itstajiri/main/README.md

# main
any stuff mostly from university

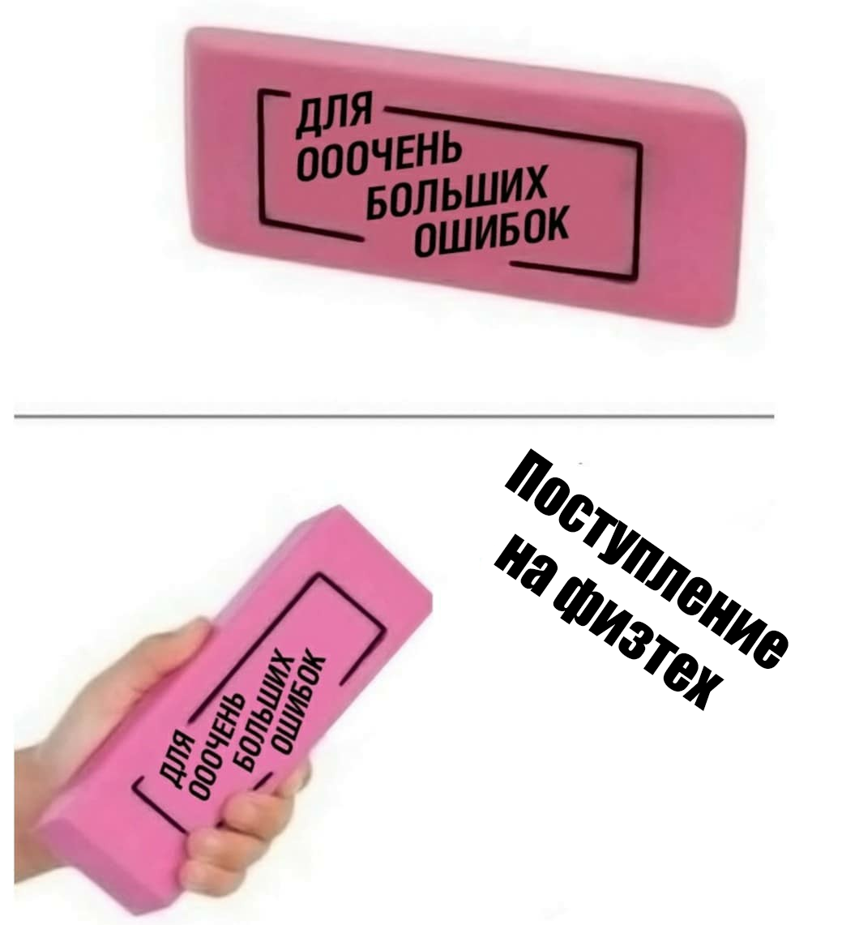
[picture p1: main.png]
