itstajiri/main/3kurs/Nasosi/Задание 3. Рязанов А.В. С17-АЭ. ЦНН-1. Расчет направляющего аппарата — исправление 4.docx

Рязанов Алексей, С17-АЭ


Средняя скорость в горловом сечении:

C_3 =K_3 ∙√(2g∙H)=0,38∙√(2∙9,81∙92)=16,145м/с

где К3 – опытный коэффициент, изменяющийся в зависимости от nS (согласно рис. 5.3 методички).

Из графика К3 = 0,38.

Диаметр начальной окружности:

D3=(1,03…1,05)∙D2=1,038∙289≈300 мм

Принимаем ширину аппарата:

b_3 =1,1∙2∙(20,1+2∙5)=66,2 мм

Площадь горлового сечения на входе определяется следующим образом:

Согласно рекомендациям по соотношению числа лопастей рабочего колеса и НА принимаем Zна = 12.

F_г =Q/(C_3 ∙Z_(на))=(650/3600)/(16,145∙12)=0,000932 м^2

Где: Z_(на) – число лопаток НА.

Ширина горлового сечения составит:

a_г =(F_Г)/(b_3)=(0,000932∙10^6)/(66,2)≈14 мм

Меридианная скорость потока на входе в НА без учета cтеснения:

C_(m_3) =Q/(π∙D_3 ∙b_3)=2,9 м/с

Окружная скорость потока на входе в направляющий аппарат:

C_(u_3) =C_(u_2) ∙((D_2)/(D_3))=23,1∙(289/300)=22,253

Угол потока на входе в направляющий аппарат без учета стеснения

α_3 =180/π∙atan((C_(m_3))/(C_(u_3)))=180/(3,14)∙atan((1,45)/(22,253))=7,4°

Для диффузора с прямоугольным горловым сечением и двумя параллельными боковыми стенками около 10⁰ – 12⁰, принимаем 11⁰.

Длину диффузора между лопатками следует принимать

L = 4 ∙ a_г = 14 ∙ 4 = 28 мм

Рациональное увеличение проходного сечения в канале диффузора 1,6 – 2.

Принимаем a_в =(1,6-2)∙a_г =1,785∙14=25 мм


Рис 1. Эскиз направляющего аппарата

Диаметр наружной окружности НА принимаем D4 = 386 мм.

(D_4)/(D_2)=386/289=1,34

Площадь меридианного сечения кольцевого коллектора должна быть больше площади входа в каналы направляющего аппарата не менее чем в 1,7 раза.

Fколлект = 12 ∙ 2 ∙ F_г = 12 ∙ 2∙0,000932 = 0,022368 м²

Радиус меридионального сечения кольцевого коллектора:

R_(коллект) =√((F_(коллект))/π)=√((0,022368)/π)=0,085 м

За образец напорного коллектора взял как у насоса прототипа.

Наибольший диаметр кольцевого коллектора:

D_(наиб) =D_4 +2⋅R_(коллект) =386+2⋅85=556 мм

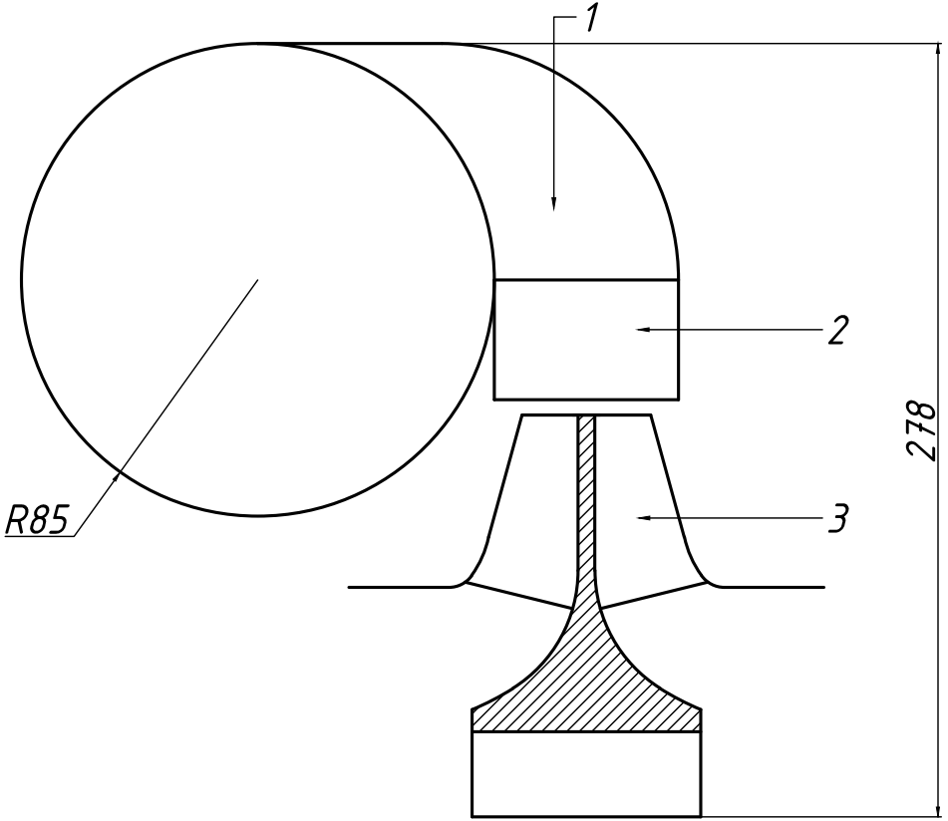
[picture p6: figure]

Рис. 2 Окончательный эскиз меридианного сечения проточной части насоса

1 – напорный коллектор, 2 – НА, 3 – РК
