itstajiri/main/3kurs/Nasosi/Параметр.docx

Наименование | Значение
Подача, м³/ч | Q=650
Напор, м | H=92
Манометрическое давление на всасе, Па | P=0,03∙10^6
Атмосферное давление, Па | P_(атм) =10^5
Давление насыщенных паров натрия, Па | P_(нп) =164,4
Температура натрия на всасе, ⁰С | T=450
Плотность натрия при данной температуре, кг/м³ | ρ=844
Ускорение свободного падения, м/с² | g=9,81

Из исходных данных, а именно – избыточное давление на всасе насоса – Р = 0,03 МПа, следовательно абсолютное давление составляет:

Pабс=P+Pатм=0,03+0,1=0,13 Мпа ,

определим располагаемый кавитационный запас системы:

∆hрас=(Pабс-Pнп)/(ρ*g)+(v^2)/(2*g) , где

Pабс – абсолютное статическое давление системы, Па

Pнп – давление насыщенных паров, Па

v – скорость среды на входе в насос, м/с

Т.к. на начальном этапе значение скоростей неизвестно, то опустим это слагаемое, в конечном итоге это допущение только лишь увеличит располагаемый кавитационный запас. Таким образом:

∆hрас=(0,13*10^6 -Pнп)/(844*9,81)=15,681 м .

Основные параметры, на которые будем смотреть при выборе схемы:

- n_s – коэффициент быстроходности

n_s =(3,65*n*√Q)/(H^0.75)

- Отношение величин (∆hрас)/(hкр)

hкр=10*((n*√Q)/(Скр))^(4/3)

- w_(10D1) - величина скорости на входе в рабочее колесо, м/с

- С_(кр) – кавитационный коэффициент быстроходности

С_(кр) =(5,62∙n∙√Q)/(((∆h_(рас))/(1,2))^(0,75))

- D_2 – диаметр рабочего колеса на выходе, м

Параметр | (n=3000 об)/(мин) | (n=1500 об)/(мин) | (n=1000 об)/(мин)
n_s | 107 | 54 | 36
(∆hрас)/(hкр) | 1,3 | 2,9 | 4,6
w_(10D1) , м/с | 23,29 | 14,7 | 11,25
С_(кр) | 772 | 686 | 657
D_2 , м | 0,270 | 0,502 | 0,732

n_s =(3,65*n*√Q)/(H^0.75)

n_s =(3,65*1500*√(0.181/2))/(92^0.75)=54 - рабочее колесо центробежное тихоходное.

Кавитационный коэффициент для проходного вала

С_(кр) =1,6*n_s +600=686

Давление рабочее на входе - Р = 0,03 МПа

hкр=10*((n*√Q)/(Скр))^(4/3)

hкр=10*((n*√Q)/(Скр))^(4/3) =5,48 м

hдоп=1,2*hкр=6,6

∆hрас=(Pабс-Pнп)/(ρ*g)=15,681 м

Кавитация отсутствует при условии Δhрас > Δhдоп. Это условие выполняется ( 15,681>6,6)

Приведённый диаметр

D_(1пр) =4.25*1000*(Q/n)^(1/3) =168.253

Объемный КПД насоса

η_(об) =1/(1+0,68*n_s^(-0.66))=0.954

Гидравлический КПД насоса

η_г =(0,42)/((1/(ln(10))*ln(D_(1пр) )-0,173)^2)=0,9

КПД дискового трения

η_(дт) =1/(1+820/(n_s ^2))=0,779

Расход через колесо насоса с учетом объемного КПД насоса

Q_т =Q/(η_(об))=(0,181/2)/(0,954)=0.095(м^3)/с

КПД проточной части

η=η_(об) *η_г *η_(дт) =0,669

Мощность насоса

N=(ρ*Q*H)/(102*η)=205.5 кВт

Мощность с учётом перегрузки

N_(max) =1.2*N=246.6 кВт

Момент на валу насоса

M=97500*(N_(max))/n=1.65*10^4 Н∙см

Диаметр вала

D_в =10*(М/(0,2*150))^(1/3) =82 мм

Диаметр втулки под рабочим колесом

D_(вт) =1,25*D_в =102.5 мм

Принимаем Kv_0 =0,06 – коэффициент входной скорости

Скорость на входе

v_0 =Kv_0 *(Q_т *n^2 )^(1/3) =3.51 м/с

Диаметр входа в рабочее колесо

D_0 =1000*√((4*(Q_т)/(π*v_0))+((D_(вт))/1000)^2)=211.7

Принимаем D_100 =0,95

Диаметр расположения входных кромок лопаток

D_1 =D_100 *D_0 =201,1 мм

Принимаем Kvm1=0,85

Меридианная скорость на входе

Vm1p=Kvm1∙v_0 =0,85∙4,7=2,98 м/с

Ширина лопасти на входе

b1=(1000*Q_т)/(πD1Vm1p*0.001)=50.2 мм

Принимаем β1=21º Z=7

S=((1.25-1)/1.25)*π*D_1 *(sin(π*(β1)/180))/Z=6.471 мм

Окружная скорость лопасти на входе

u1=0.001D1πn/60=0.001∙201.1∙3.141455/60=15.32(м/с)

Коэффициент затеснения

K1=1/(1-(Z∙S)/(πD1sin(πβ1)/180))=1/(1-(8∙7.9)/(3.14∙201.1sin(3.14∙21)/180))=1.25

Угол потока на входе

β10=180/πarctg(Vm1p∙K1)/(u1)= 180/3.14arctg(2.98∙1.25)/15.32=13.7°

Угол атаки

δ1=β1-180/πarctg(Vm1p∙K1)/(u1)=21-180/3.14arctg(2.98∙1.25)/15.32=7.32°

Меридианная скорость на входе с учетом затеснения

Vm1=K1∙Vm1p=1.25∙2.98=3.73 м/с

Относительная скорость на входе

W1=(Vm1)/(sin(πβ1)/180)=3.73/(sin(3.14∙21)/180)=10,41 м/с

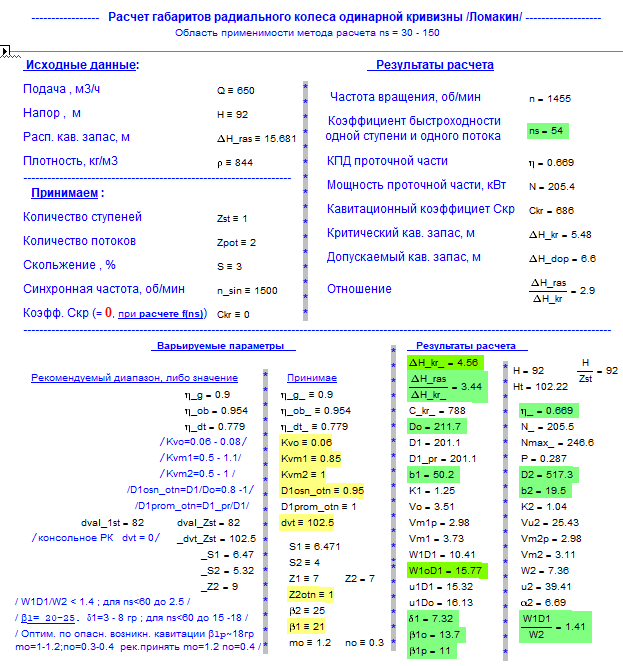
[picture p7: figure]
