itstajiri/main/3kurs/Nasosi/Помойка/Задание 1 + продолжение. Рязанов А.В. С17-АЭ. ЦНН-1. Расчет по курсовому проекту.docx

Рязанов Алексей, С17-АЭ

1. Исходные данные

Исходные данные приведены в таблице 1.

Таблица 1 - Исходные данные

Наименование параметра | Значение
Подача Q, м³/ч | 650
Напор H, м | 92
Давление на входе в насос P , МПа | 0,03
Температура натрия на входе в насос T , ⁰С | 450
Плотность натрия при данной температуре 450 оС ρ , кг/м³ | 844
Давление насыщенных паров натрия P_(нп) , Па | 164,4

2. Определим располагаемый кавитационный запас:

Располагаемый кавитационный запас определяется по формуле

∆hрас=(P_с)/(ρ∙g)+(v^2)/(2∙g)-(P_(нп))/(ρ∙g)

где: Рс = P + Ра – абсолютное статическое давление на входе в насос, Па

Pнп – давление насыщенных паров, Па

v – скорость среды на входе в насос, м/с

(P_с)/(ρ∙g)+(v^2)/(2∙g) - полная удельная энергия потока (Eвх) на входе в насос.

Т.к. на начальном этапе значение скоростей неизвестно, то опустим это слагаемое, в конечном итоге это допущение только лишь увеличит располагаемый кавитационный запас. Таким образом:

∆h_(рас) =(P_с -Pнп)/(ρ∙g)=(0,13∙10^6 -164,4)/(844∙9,81)=15,681 м

Тогда ∆h_(рас) =15,7 м. Расчет уточненного значения располагаемого кавитационного запаса будет проведен после расчета геометрии рабочего колеса насоса.

3. Выбор частоты вращения ротора

Расчет выполняется следующим образом.

3.1 Задаемся частотой вращения ротора.

n=n_(sin) ∙(1-3/100)=3000∙(1-3/100)=2910(об)/(мин), где s=3%-скольжение.

3.2 Определяем коэффициент быстроходности.

n_s =(3,65∙n∙√Q)/(H^(0,75))=(3,65∙2910∙√(0,181/2))/(92^(0,75))=107

Тип рабочего колеса - центробежное тихоходное.

3.3 Определяем кавитационный коэффициент быстроходности.

Кавитационный коэффициент быстроходности определяем по рис. 3.1 [1, стр.35].

С_(кр) =772

  3.4 Определяем критический кавитационный запас.

∆h_(кр) =10∙[(n∙√Q)/(Скр)]^(4/3) =10∙[(3000∙√(0,181/2))/772]^(4/3) =11,8 м

3.5 Определяем критический кавитационный запас.

∆h_(доп) =1,2∙hкр=14,2 м

Результаты расчетов приведены в таблице 2.

Таблица 2 - Результаты расчетов

Наименование параметра | Значение
Частота вращения ротора синхронная n_(sin) , об/мин | 3000 | 1500 | 1000
Частота вращения ротора n, об/мин | 2910 | 1455 | 970
Коэффициент быстроходности n_s | 107 | 54 | 36
Кавитационный коэффициент быстроходности Скр | 772 | 686 | 657
Располагаемый кавитационный запас ∆hрас , м | 15,7 | 15,7 | 15,7
Критический кавитационный запас ∆hкр , м | 11,8 | 5,5 | 3,4
Допускаемый кавитационный запас ∆hдоп =1,2 Δhкр, м | 14,2 | 6,6 | 4,1

Кавитация отсутствует при условии Δhрас > Δhдоп. Это условие выполняется при частоте вращения ротора 3000, 1500, 1000 об/мин. Для дальнейших расчетов принимаем частоту вращения n_(sin) =1500 об/мин.

4. Определение размеров рабочего колеса с помощью диаграмм

Для выбранного варианта определяются размеры рабочего колеса насоса с помощью диаграмм на рис. 3.3 [1, стр.37]. По диаграмме выбираем коэффициенты в зависимости от коэффициента быстроходности. Согласно данным диаграммы все определяемые параметры являются функцией быстроходности насоса и могут быть рассчитаны по формуле:

X=K_X ∙(√H)/n

где: Х – определяемый параметр;

K_X – соответствующий параметру коэффициент на диаграмме;

Н – напор насоса;

n – частота вращения ротора насоса.

Тогда

D_0 =K_(D_0) ∙(√H)/n=28∙(√92)/1500=184,6 мм;

D_1 =K_(D_1) ∙(√H)/n=26,3∙(√92)/1455=173,2 мм;

b_1 =K_(b_1) ∙(√H)/n=6,1∙(√92)/1455=40,2 мм;

D_2 =K_(D_2) ∙(√H)/n=84,7∙(√92)/1455=558,1 мм;

b_2 =K_(b_1) ∙(√H)/n=2,4∙(√92)/1455=15,8 мм;

Полученные результаты приведены в таблице 3

Таблица 3 - Результаты расчетов по диаграммам

Значение коэффициента | KD0 = 28 | KD1 = 26,3 | Kb1 = 6,1 | KD2 = 84,7 | Kb2 = 2,4
Размер колеса, мм | D0 = 184,6 | D1 = 173,2 | b1 = 40,2 | D2 = 558,1 | b2 = 15,8

5. Расчет мощности приточной части насоса

Мощность проточной части насоса определяется по формуле:

N=(ρ∙Q∙H)/(102∙η)=(844∙0,181/2∙92)/(102∙0,669)=205,5 кВт

где η ≈ 0,669 – КПД одноступенчатого насоса при n_s =54 и подаче Q = 181 л/с, значение определено по графику на рис. 3.2 [1, стр.36].

Снимок экрана из программы Mathcad – расчет габаритов колеса

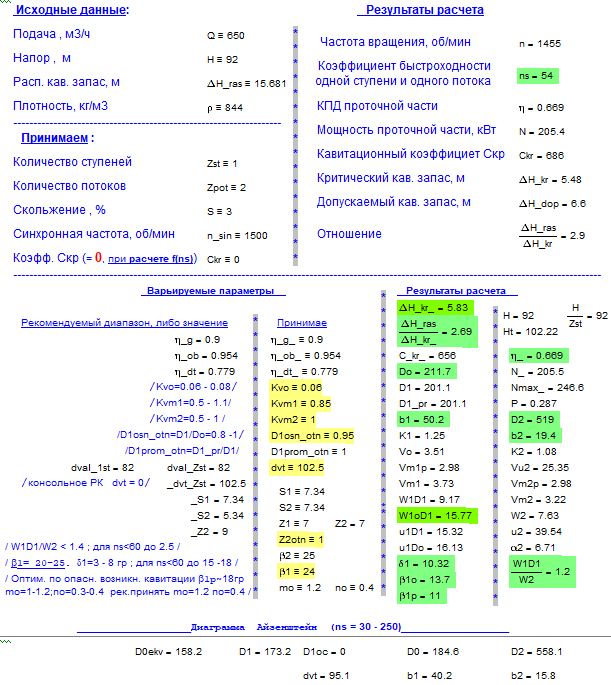
[picture p8: figure]

6. Расчет размеров рабочего колеса на входе

Приведённый диаметр

D_(1пр) =4,25∙1000∙(Q/n)^(1/3) =4,25∙1000∙((0,181/2)/1445)^(1/3) =168,253 мм

Диаметр вала

D_в =10∙(М/(0,2∙150))^(1/3) =10∙((1,65∙10^4)/(0,2∙150))^(1/3) =82 мм

Диаметр втулки под рабочим колесом

D_(вт) =1,25∙D_в =1,25∙82=102,5 мм

Критический кавитационный запас

hкр=10∙((n∙√Q)/(Скр))^(4/3) =10∙((1445∙√(0,181/2))/686)^(4/3) =5,48 м

Допускаемый кавитационный запас

hдоп=1,2∙hкр=1,2∙5,48=6,6 м

Принимаем Kv_0 =0,06 – коэффициент входной скорости

Скорость на входе

v_0 =Kv_0 ∙(Q_т ∙n^2 )^(1/3) =0,06∙(0,095∙1445^2 )^(1/3) =3,51 м/с

Диаметр входа в рабочее колесо

D_0 =1000∙√((4∙(Q_т)/(π∙v_0))+((D_(вт))/1000)^2)=1000∙√((4∙(0,095)/(3,14∙3,51))+((102,5)/1000)^2)=211,7 м

Принимаем D_(1осн) =0,95

Диаметр расположения входных кромок лопаток

D_1 =D_(1осн) ∙D_0 =0,95∙211,7=201,1 мм

Принимаем Kvm1=0,85

Меридианная скорость на входе

Vm1p=Kvm1∙v_0 =0,85∙4,7=2,98 м/с

Ширина лопасти на входе

b1=(1000∙Q_т)/(πD1Vm1p∙0.001)=(1000∙0,095)/(3,14∙201,7∙2,98∙0.001)=50,2 мм

Окружная скорость лопасти на входе

u1=0,001D1πn/60=0,001∙201,1∙3,141455/60=15,32(м/с)

Принимаем β1=24º Z=7

S=((1,25-1)/(1,25))∙π∙D_1 ∙(sin(π∙(β1)/180))/Z=((1,25-1)/(1,25))∙3,14∙201,09∙(sin(π∙24/180))/7=7,34 мм

Коэффициент затеснения

K1=1/(1-(Z∙S)/(πD1sin(πβ1)/180))=1/(1-(7∙7,34)/(3,14∙201,1sin(3,14∙24)/180))=1,25

Угол потока на входе

β10=180/πarctg(Vm1p∙K1)/(u1)= 180/3.14arctg(2,98∙1,25)/(15,32)=13,7°

Угол атаки

δ1=β1-180/πarctg(Vm1p∙K1)/(u1)=24-180/(3,14)arctg(2,98∙1,25)/(15,32)=10,32°

Меридианная скорость на входе с учетом затеснения

Vm1=K1∙Vm1p=1,25∙2,98=3,73 м/с

Подача на ступень с учетом объемных протечек

Q1=(Q_pot)/(n_ob_)=(0,181/2)/(0,954)=0,095 (м^3)/с

Относительная скорость на входе

W1=(Vm1)/(sin(πβ1)/180)=(3,73)/(sin(3,14∙24)/180)=9,17 м/с

∆H_(kr) =mo(v0^2)/(2g)+no(W1^2)/(2g)=5,83 м

C_(kr) =(n√(Q_pot))/((0,1∙∆H_(kr) )^(0,75))=(1445∙√(0,181/2))/((0,1∙5,83)^(0,75))=656

Принимаем Kvm2=1

Меридианная скорость на выходе

Vm2p=Kvm2∙Vm1p=1∙2,98=2,98 м/с

Теоретический напор

Hт=H/(η_г)=92/(0,9)=102,22 м

7. Расчет размеров рабочего колеса на выходе

Окружая скорость на выходном диаметре (начальное приближение)

u2=√(2∙g∙Hт)=√(2∙9,81∙102,22)=44,8 м/с

Диаметр рабочего колеса на выходе (начальное приближение)

D2=(1000∙2∙u2)/((πn)/30)=(1000∙2∙44,8)/((3,14∙1455)/30)=587,728 мм

Принимаем β2=25º

{P1=2/(Z1∙Z2otn)∙(0,6+0,6∙sin(πβ2)/180)/(1-((D1pr)/(D2))^2)K2=1/(1-(Z∙S)/(πD2sin(πβ2)/180))u2=(K2∙Vm2p)/(2tg(πβ2)/180)+√(((K2∙Vm2p)/(2tg(πβ2)/180))^2 +g(1+P1)Hт)D2=1000∙(60u2)/(πn)

Диаметр рабочего колеса на выходе

D2=519 мм

Окружная скорость на наружном диаметре

u2=39,41 м/с

Коэффициент затеснения

K2=1,04

Поправка на конечное число лопастей

P1=0,3

Окружная составляющая абсолютной скорости на выходе

Vu2=g∙(Hт)/(u2)=9,81∙(102,22)/(39,4)=25,43 м/с

Меридианная скорость на выходе с учетом затеснения

Vm2=K2∙Vm2p=1∙2,98=3,11 м/с

Относительная скорость на выходе

W2=(Vm2p)/(sin(πβ2)/180)=(3,11)/(sin(3,14∙25)/180)=7,36 м/с

Коэффициент торможения относительной скорости в колесе

Kw=(W1)/(W2)=(10,41)/(7,36)=1,41

Ширина колеса на выходе

b2=(Qт)/(π∙D2∙Vm2p)=(0,095)/(3,14∙517,3∙2,98)=19,5 мм.

Угол абсолютной скорости на выходе

α2=180/π∙arctg(Vm2p)/(Vu2)=6,7°

Абсолютная скорость на выходе из колеса

V2p=√(Vu2^2 +Vm2p^2)=√(25,4^2 +2,98^2)=25,4 м/с

8. Профилирование лопасти рабочего колеса

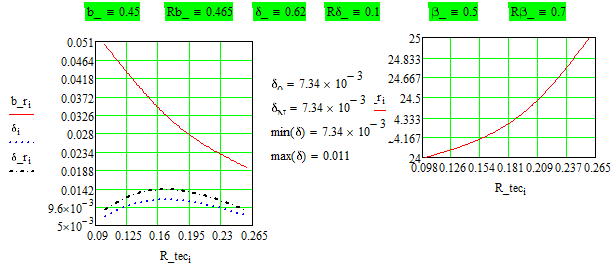
[picture p9: figure]
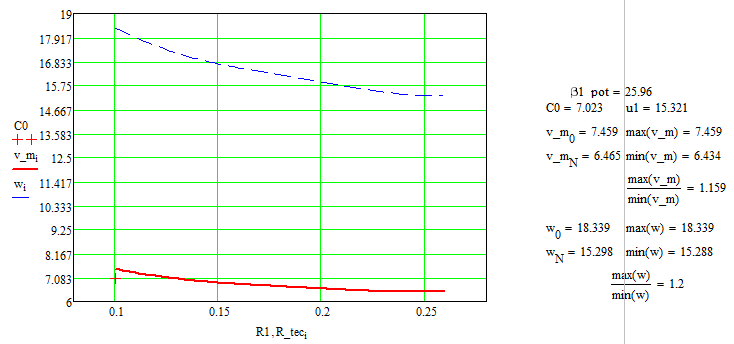
[picture p10: figure]
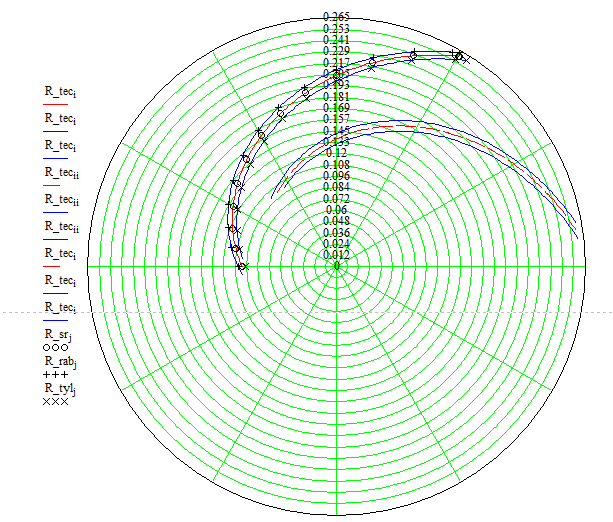
[picture p11: figure]
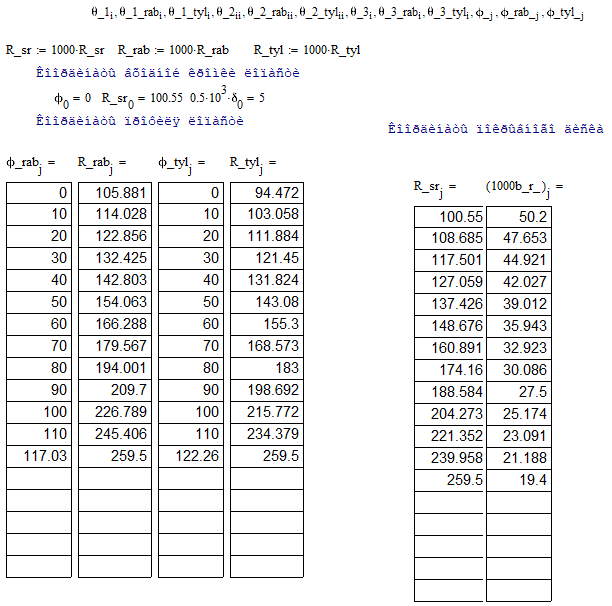
[picture p12: figure]
