itstajiri/main/3kurs/Nasosi/Помойка/Задание 3. Рязанов А.В. С17-АЭ. ЦНН-1. Расчет направляющего аппарата.docx

Рязанов Алексей, С17-АЭ


Средняя скорость в горловом сечении:

C_3 =K_3 ∙√(2g∙H)=0,38∙√(2∙9,81∙92)=16,145м/с

где К3 – опытный коэффициент, изменяющийся в зависимости от nS (согласно рис. 5.3 методички).

Из графика К3 = 0,38.

Диаметр начальной окружности:

D3=(1,03…1,05)∙D2=1,038∙289≈300 мм

Принимаем ширину аппарата:

b_3 =1,1∙(20,1+2∙5)=33 мм

Площадь горлового сечения на входе определяется следующим образом:

Согласно рекомендациям по соотношению числа лопастей рабочего колеса и НА принимаем Zна = 12.

F_г =Q/(C_3 ∙Z_(на))=(0,181)/(16,145∙12)=0,0009343 м^2

Где: Z_(на) – число лопаток НА.

Ширина горлового сечения составит:

a_г =(F_Г)/(b_3)=(0,0009343∙10^6)/33≈28 мм

Меридианная скорость потока на входе в НА без учета cтеснения:

C_(m_3) =Q/(π∙D_3 ∙b_3)=5,8 м/с

Окружная скорость потока на входе в направляющий аппарат:

C_(u_3) =C_(u_2) ∙((D_2)/(D_3))=23,1∙(289/300)=22,253

Угол потока на входе в направляющий аппарат без учета стеснения

α_3 =180/π∙atan((C_(m_3))/(C_(u_3)))=180/(3,14)∙atan((5,8)/(22,253))=14,609≈15°

Для диффузора с прямоугольным горловым сечением и двумя параллельными боковыми стенками около 10⁰ – 12⁰, принимаем 11⁰.

Длину диффузора между лопатками следует принимать

L = 4 ∙ a_г = 54 ∙ 4 = 112 мм

Рациональное увеличение проходного сечения в канале диффузора 1,6 – 2.

Принимаем a_в =(1,6-2)∙a_г =1,65∙28=46,2 мм

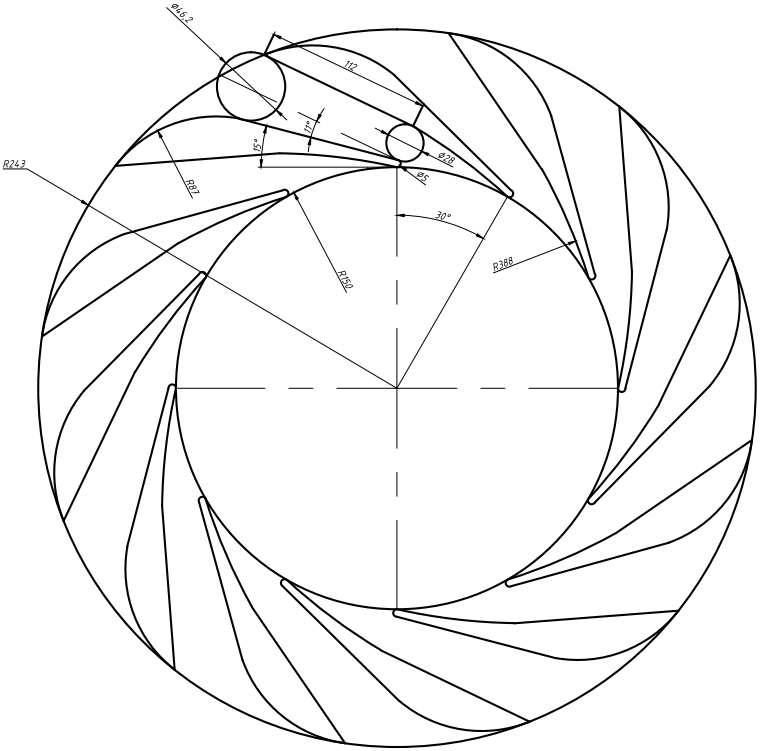
[picture p13: figure]

Диаметр наружной окружности НА принимаем D4 = 486 мм.

(D_4)/(D_2)=486/289=1,68

Площадь меридионального сечения кольцевого коллектора должна быть больше площади входа в каналы направляющего аппарата не менее чем в 1,7 раза:

Fколлект = 4 ∙ F_г = 4 ∙ 0,0009343 = 0,0037372 м²

Радиус меридионального сечения кольцевого коллектора:

R_(коллект) =√((F_(коллект))/π)=√((0,0037372)/π)=0,0345 м

Наибольший диаметр кольцевого коллектора:

D_(наиб) =D_4 +2⋅R_(коллект) =486+2⋅34,5=555 мм
