itstajiri/main/3kurs/Nasosi/Одобрено/Задание 1. Рязанов А.В. С17-АЭ. ЦНН-1. Расчет по курсовому проекту.docx

Рязанов Алексей, С17-АЭ

1. Исходные данные

Исходные данные приведены в таблице 1.

Таблица 1 - Исходные данные

Наименование параметра | Значение
Подача Q, | 650
Напор H, м | 92
Давление на входе в насос P , МПа | 0,03
Температура натрия на входе в насос T , ⁰С | 450
Плотность натрия при данной температуре 450 оС ρ , кг/м³ | 844
Давление насыщенных паров натрия P_(нп) , Па | 164,4

2. Определим располагаемый кавитационный запас:

Располагаемый кавитационный запас определяется по формуле

∆hрас=(P_с)/(ρ∙g)+(v^2)/(2∙g)-(P_(нп))/(ρ∙g)

где: Рс = P + Ра – абсолютное статическое давление на входе в насос, Па

Pнп – давление насыщенных паров, Па

v – скорость среды на входе в насос, м/с

(P_с)/(ρ∙g)+(v^2)/(2∙g) - полная удельная энергия потока (Eвх) на входе в насос.

Т.к. на начальном этапе значение скоростей неизвестно, то опустим это слагаемое, в конечном итоге это допущение только лишь увеличит располагаемый кавитационный запас. Таким образом:

∆h_(рас) =(P_с -Pнп)/(ρ∙g)=(0,13∙10^6 -164,4)/(844∙9,81)=15,7 м

Тогда ∆h_(рас) =15,7 м. Расчет уточненного значения располагаемого кавитационного запаса будет проведен после расчета геометрии рабочего колеса насоса.

3. Выбор частоты вращения ротора

Расчет выполняется следующим образом.

3.1 Задаемся частотой вращения ротора.

n=n_(sin) ∙(1-S/100)=3000∙(1-(3,33)/100)=2900(об)/(мин), где s=3,33%-скольжение.

3.2 Определяем коэффициент быстроходности.

Рассматриваем вариант двухпоточного рабочего колеса.

n_s =(3,65∙n∙√Q)/(H^(0,75))=(3,65∙2900∙√(650/(3600∙2)))/(92^(0,75))=107

Тип рабочего колеса - центробежное нормальное.

3.3 Определяем кавитационный коэффициент быстроходности.

Кавитационный коэффициент быстроходности определяем по рис. 3.1 [1, стр.35].

С_(кр) =771

  3.4 Определяем критический кавитационный запас.

∆h_(кр) =10∙[(n∙√Q)/(Скр)]^(4/3) =10∙[(3000∙√(650/(3600∙2)))/772]^(4/3) =11,77 м

3.5 Определяем критический кавитационный запас.

∆h_(доп) =1,2∙hкр=14,1 м

Результаты расчетов приведены в таблице 2.

Таблица 2 - Результаты расчетов

Наименование параметра | Значение
Частота вращения ротора синхронная n_(sin) , об/мин | 3000 | 1500 | 1000
Частота вращения ротора n, об/мин | 2900 | 1450 | 970
Коэффициент быстроходности n_s | 107 | 54 | 36
Кавитационный коэффициент быстроходности Скр | 772 | 686 | 657
Располагаемый кавитационный запас ∆hрас , м | 15,7 | 15,7 | 15,7
Критический кавитационный запас ∆hкр , м | 11,8 | 5,5 | 3,4
Допускаемый кавитационный запас ∆hдоп =1,2 Δhкр, м | 14,2 | 6,6 | 4,0

Кавитация отсутствует при условии Δhрас > Δhдоп. Для изготовления рабочего колеса с лопастями одинарной кривизны коэффициент быстроходности должен быть < 130. Это условие выполняется при частоте вращения ротора 3000, 1500, 1000 об/мин. Для дальнейшего проектирования принимаем вариант с наибольшей частотой вращения ротора. Этот вариант будет иметь наименьшие габариты.

4. Определение размеров рабочего колеса с помощью диаграмм

Для выбранного варианта определяются размеры рабочего колеса насоса с помощью диаграмм на рис. 3.3 [1, стр.37]. По диаграмме выбираем коэффициенты в зависимости от коэффициента быстроходности. Согласно данным диаграммы все определяемые параметры являются функцией быстроходности насоса и могут быть рассчитаны по формуле:

X=K_X ∙(√H)/n

где: Х – определяемый параметр;

K_X – соответствующий параметру коэффициент на диаграмме;

Н – напор насоса;

n – частота вращения ротора насоса.

Тогда

D_0 =K_(D_0) ∙(√H)/n=44,6∙(√92)/3000=147,7 мм;

b_1 =K_(b_1) ∙(√H)/n=13,8∙(√92)/3000=45,5 мм;

D_2 =K_(D_2) ∙(√H)/n=87,6∙(√92)/3000=289,7 мм;

b_2 =K_(b_1) ∙(√H)/n=6,1∙(√92)/3000=20,1 мм;

Полученные результаты приведены в таблице 3

Таблица 3 - Результаты расчетов по диаграммам

Значение коэффициента | KD0 = 44,6 | Kb1 = 13,8 | KD2 = 87,6 | Kb2 = 6,1
Размер колеса, мм | D0 = 147,7 | b1 = 45,5 | D2 = 289,7 | b2 = 20,1

5. Расчет мощности приточной части насоса

Мощность проточной части насоса определяется по формуле:

N=(ρ∙Q∙H)/(102∙η)=(844∙(650∙1000)/3600∙92)/(102∙0,805)=170,5 кВт

где η ≈ 0,85 – КПД одноступенчатого насоса при n_s =107 и подаче Q = 181 л/с, значение определено по графику на рис. 3.2 [1, стр.36].

Снимок экрана из программы Mathcad – расчет габаритов колеса

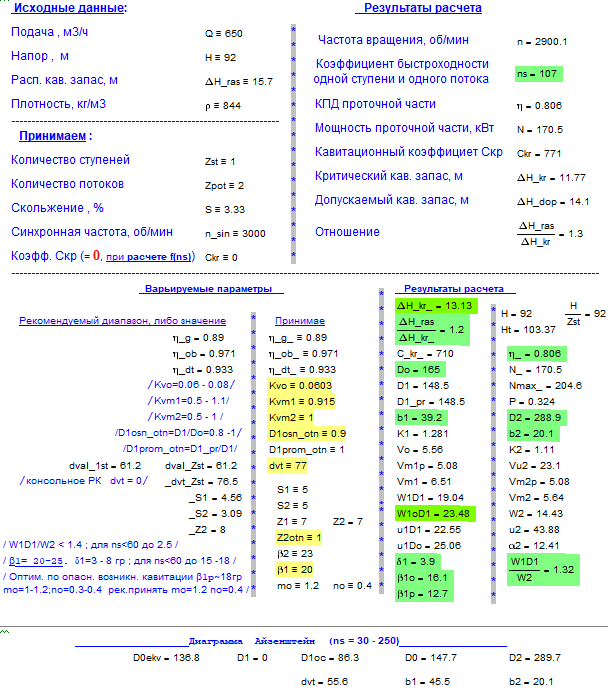
[picture p18: figure]
