itstajiri/main/3kurs/Nasosi/Доки/Основная часть — копия — копия — копия — копия — копия — копия — копия — копия.docx

1. Введение

Быстрый опытный реактор БОР-60 является уникальной многоцелевой установкой, на которой проводятся испытания конструкционных, топливных и поглощающих материалов, используемых и предполагаемых к использованию в различных типах ядерных реакторов, в том числе термоядерных реакторов. Для быстрых реакторов дополнительно проводятся испытания отдельных узлов оборудования первого и второго контуров.

Проводимые испытания реакторных материалов охватывают практически весь спектр существующих и разрабатываемых типов реакторов от быстрых (БН-800, БН-1800, «БРЕСТ», СВБР) и тепловых (АЭС-2006, ВВЭР-1500, ГТ-МГР, ВТГР) до термоядерных (ИТЭР) и реакторов специального назначения.

Основные технические характеристики реактора БОР-60 [14]:

Физические характеристики
Максимальная тепловая мощность | | 60 МВт
Электрическая мощность | | 12 МВт
Топливо: | | UO2 - PuO2
обогащение по 235U | | 45 ÷ 90 %
Теплоноситель: | | натрий
расход через реактор | | 1100 м3/час
давление | | 5,5 МПа
температура на входе в реактор | | до 330 °С
температура на выходе из реактора | | до 530 °С

На рисунке 1.1 представлена схема реакторной установки БОР-60.

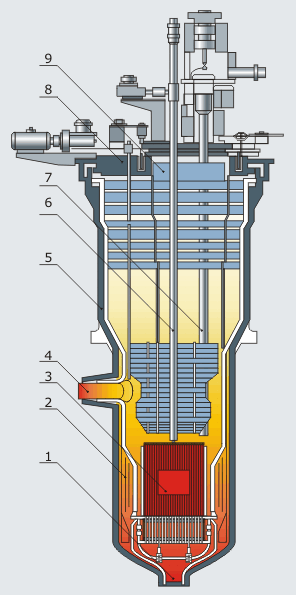
[picture p19: figure]

1– входной патрубок; 2 – тепловая и нейтронная защита корпуса реактора; 3 – активная зона; 4 - выходной патрубок; 5 – корпус; 6 – управляющий стержень; 7 – перегрузочный канал; 8, 9 – большая и малая защитные поворотные пробки.

Рис.1.1. Схема реактора БОР-60 [5]

На рисунке 1.2 представлена принципиальная технологическая схема реактора БОР-60.

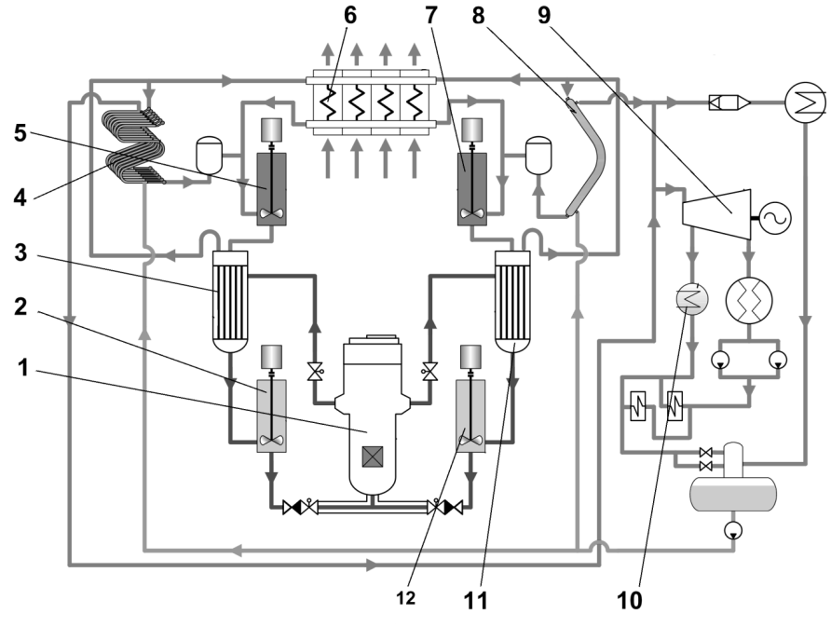
[picture p20: figure]

1– реактор; 2, 5, 7, 12– насосы первого и второго контура; 3, 11 – промежуточный теплообменник; 4,8 – парогенераторы; 6 – воздушный теплообменник; 9 – турбина;

10 – ТФУ.
Рис.1.2. Принципиальная технологическая схема реактора БОР-60.

Независимо от типа используемых реакторов и схемных особенностей ядерных установок одним из обязательных для ЯЭУ видов оборудования являются насосы.

При создании насосов для АЭС руководствуются общей теорией центробежных и осевых насосов, теорией подшипниковых опор, опытом создания и эксплуатации насосов различного типа и назначения.

При создании насосов для АЭС руководствуются общей теорией центробежных и осевых насосов, теорией подшипниковых опор, опытом создания и эксплуатации насосов различного типа и назначения.

Различие в конфигурации первого контура определяет основные конструкционные особенности реакторов на быстрых нейтронах. Для петлевого варианта характерны наличие собственных корпусов у каждого из трех элементов и связь между ними с помощью трубопроводов.

В настоящее время в построенных и проектируемых установках с быстрыми реакторами в основных контурах используются механические центробежные насосы.

Во вспомогательных контурах, а также в стендовых установках применяются также электромагнитные насосы. Они позволяют обеспечить герметизацию циркуляционного тракта без применения каких-либо вращающихся частей.

Механические насосы для перекачки натрия должны иметь надежно герметизированную от окружающей атмосферы внутреннюю полость. Устройства для герметизации должны надежно удерживать нейтральный газ под небольшим давлением.

Поскольку в качестве привода насоса наиболее целесообразно применять электродвигатели нормального исполнения, для герметизации рабочей полости насос должен иметь устройство, позволяющее без нарушения герметичности вывести вал насоса в окружающую атмосферу для соединения с валом привода. В качестве такого устройства применяется торцовое уплотнение. Можно выполнить насос без торцевого уплотнения по схеме с герметичным электродвигателем, но при этом возникают довольно сложные проблемы защиты двигателя от попадания паров натрия, усложняется конструкция электродвигателя, можно использовать только асинхронные двигатели (без коллекторов и щеток). Поэтому схема насоса с торцевым уплотнением является более рациональной.

Механические насосы с торцевым уплотнением вала могут быть выполнены погружными с одним или двумя гидростатическими подшипниками и с протечками через щелевое уплотнение вала.

В погружных насосах противокавитационный подпор на колесе создается за счет суммы гидростатического давления столба натрия над колесом и давления газа в полости насоса.

В насосах со щелевым уплотнением вала подпор на колесе равен перепаду давления на щелевом уплотнении. Рассмотрим в данной работе насос реактора БОР-60 ЦНН-1.

Основные характеристики натриевого насоса первого контура реактора БОР-60 [6]:

Таблица 1- Характеристики первого контура

Параметр | БОР-60 (СССР)
Тип насоса | Механический со свободной поверхностью натрия и подушкой инертного газа
Число агрегатов | 2
Подача, м3/ч | 830
Напор, м | 60
Температура перекачиваемой жидкости, ⁰С | 500
Частота вращения (номинальная), об/мин | 1500
Мощность приводного электродвигателя, КВт | 220
Регулирование частоты вращения | «Система Леонардо»
Диапазон регулирования частоты вращения, % | 20-100
КПД агрегата, % | 71
Давление газовой подушки, МПа | 0,05
Марка стали | 08Х18H9
Тип уплотнения | Механическое по валу
Масса агрегата, т | 31

Зарубежным аналогом насоса ЦНН-1 является насос реактора Rapsodie (Франция) [3, стр 225]. Насосы французского производства, для создания циркуляции в первом контуре, центробежные, одноступенчатые, заглубленного типа. Главное отличие – перевернутое рабочее колесо, которое позволяет всасывать натрий сверху.

Вал насоса 11 вращается в двух подшипниках: нижнем (узел II) — ГСП, верхнем (узел I) — двойном роликовом радиально-осевом. В качестве привода применен асинхронный электродвигатель 15 в герметичном исполнении. Пройдя рабочее колесо 2, натрий попадает в направляющий аппарат 3 и далее в напорный патрубок. В насос первого контура встроен обратный клапан, который представляет собой поплавок с запирающим диском.

В самом ГСП имеются дроссели диаметром 7 мм. Чтобы избежать засорения дросселей, в обтекатель встроен сетчатый фильтр. Поверхность подшипника наплавлена колмоноем. Уплотнение вала двойное торцовое, с масляным гидрозатвором. Охлаждается уплотнение маслом, циркулирующим в замкнутом объеме с помощью лабиринтного насоса, установленного на валу насоса. Масло охлаждается водой в холодильнике, вынесенном из корпуса насоса. Неподвижное кольцо пары трения стальное со стеллитовой наплавкой, подвижное кольцо графитовое. Ремонт верхних узлов осуществляется без разгерметизации контура. Для этой цели служит ремонтное уплотнение (узел I), состоящее из диска, герметично насаженного на вал, и запрессованного в него резинового кольца. Конструкция верхнего подшипникового узла позволяет при ремонте демонтировать подшипник и уплотнение единым блоком.

На рисунке 1.3 представлен зарубежный аналог насоса реактора БОР-60 - Насос реактора Rapsodie (Франция).

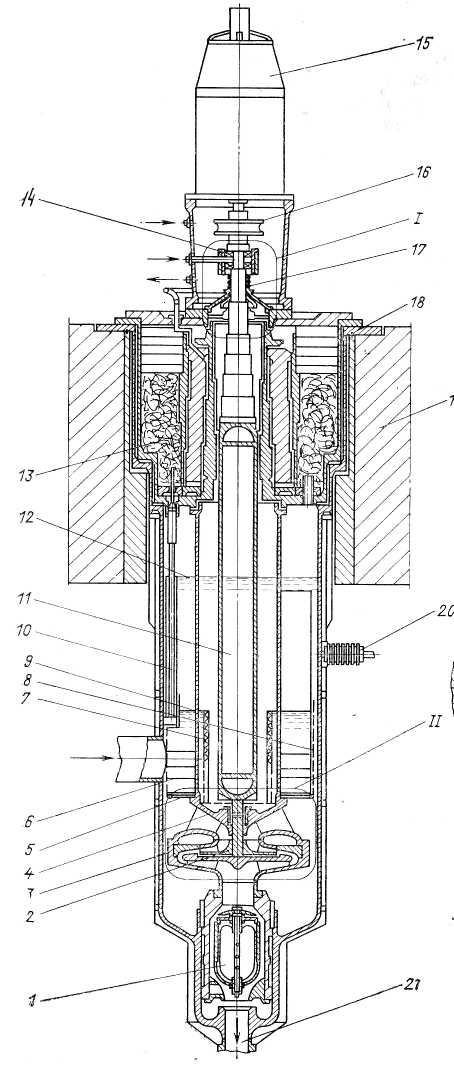
[picture p21: figure]

1-обратный клапан; 2-рабочее колесо; 3-направляющий аппарат; 4-улитка;

5-успокоительное кольцо; 6-горизонтальные успокоители; 7-внутренний антивихривой цилиндр; 8-вертикальный успокоительный цилиндр; 9,12-минимальный и максимальный уровни натрия соответственно; 10-уровнемер; 11-вал; 13,19-биологическая защита;

14-роликовый подшипник; 15-электродвигатель; 16-механическая муфта; 17-уплотнение вала; 18-уплотняющее кольцо; 20-подвод газа для разогрева насоса; 21-напорный патрубок

Рис. 1.3. Схема насоса реактора Rapsodie

2. Описание конструкции насоса

Насос реактора БОР-60 выполнен по схеме погружного заглубленного насоса колодцевого типа с нижним гидростатодинамическим подшипником, работающим на натрии от напора собственного рабочего колеса (рис. 2.1).

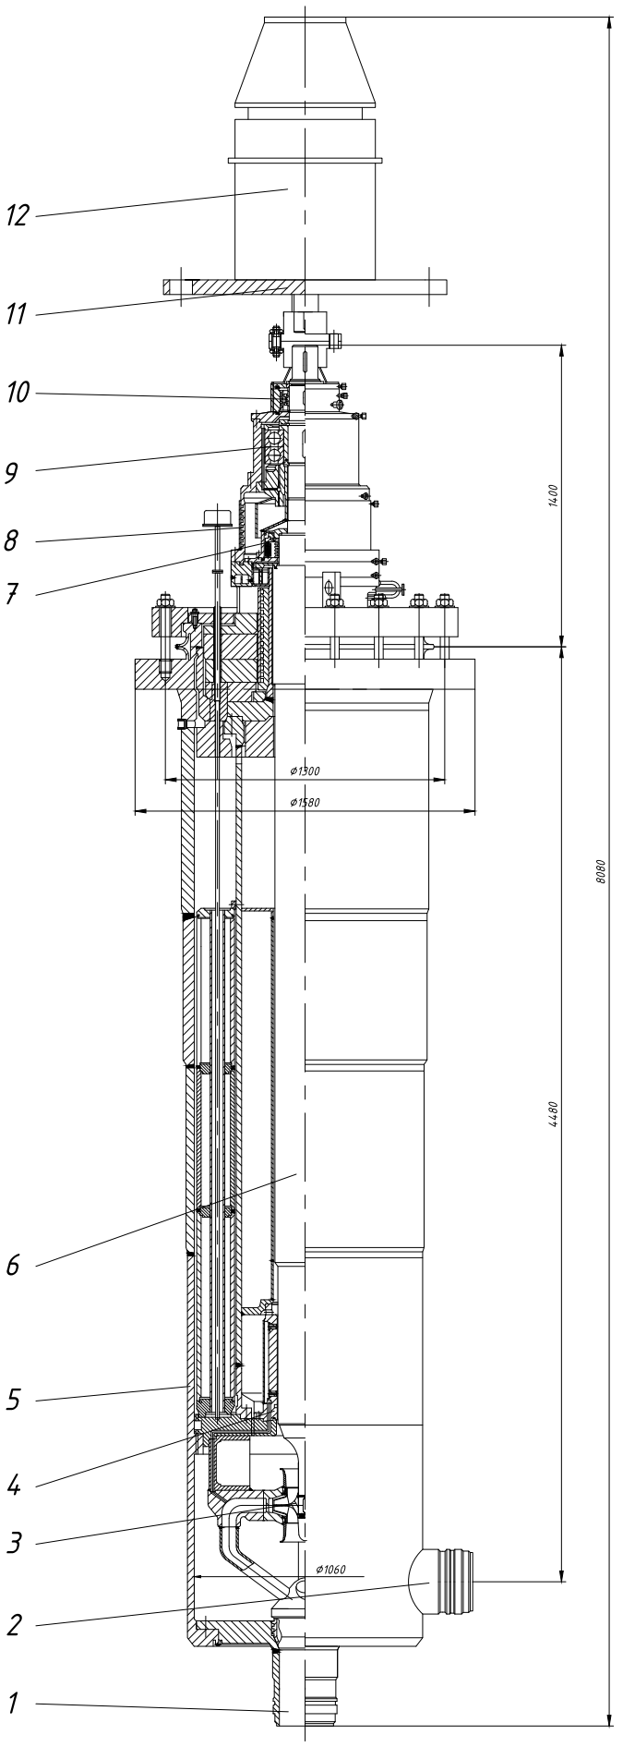
[picture p22: figure]

1 – выходной патрубок; 2 – всасывающий патрубок; 3 – рабочее колесо;

4 – гидростатодинамический подшипник; 5 - бак; 6 - вал; 7 – стояночное уплотнение;

8 – холодильник; 9 – верхний подшипниковый узел; 10 - уплотнение вала по газу;

11 – станина эл/двигателя; 12 – эл/двигатель

Рис. 2.1. Общий вид насосного агрегата

Верхний радиально-осевой подшипниковый узел расположен в газовой полости насоса. Насос состоит из бака, выемной части и приводного электродвигателя. Выемная часть демонтируется из бака без резки основных трубопроводов. Бак представляет собой цилиндрический сосуд с переменной толщиной стенки для обеспечения равномерной жесткости. В нижней части бака имеются два патрубка: радиальный (всасывающий) и осевой (нагнетательный), к которым привариваются соответствующие трубопроводы. Выемная часть устанавливается в бак и крепится к нему с помощью фланца. Герметичность разъема обеспечивается «усиковым» сварным швом.

Выемная часть (рис. 2.2) содержит проточную часть с рабочим колесом, канальным направляющим аппаратом открытого типа со сборно-кольцевым отводом и всасывающим колоколом. Натрий от сборного коллектора отводится четырьмя трубами диаметром 100 мм, объединяющимися в напорный патрубок по оси насоса.

Всасывание осуществляется непосредственно из бака, причем перед самым входом на рабочее колесо установлен профилированный коллектор, дающий равномерное распределение скоростей, несмотря на боковой вход потока в бак. Протечки из подшипника через переливные окна с малым сопротивлением сливаются на всасывание. Поскольку насос заглубленный, то во время работы уровень в нем снижается в соответствии с гидравлическим сопротивлением подводящей трассы.

Допустимое колебание уровня в насосе 2 м. В целях исключения захвата газа на всасывании к выемной части насоса по наружному диаметру сборного коллектора приварена юбка высотой 0,7 м, благодаря чему обеспечивается нормальная работа насоса в различных переходных режимах, когда увеличивается сопротивление всасывающего трубопровода и уровень в насосе падает ниже рабочего колеса. В выемной сборке установлены кольцевые вытеснители, предназначенные для уменьшения объема натрия в контуре. Бак насоса служит одновременно и компенсатором объема.

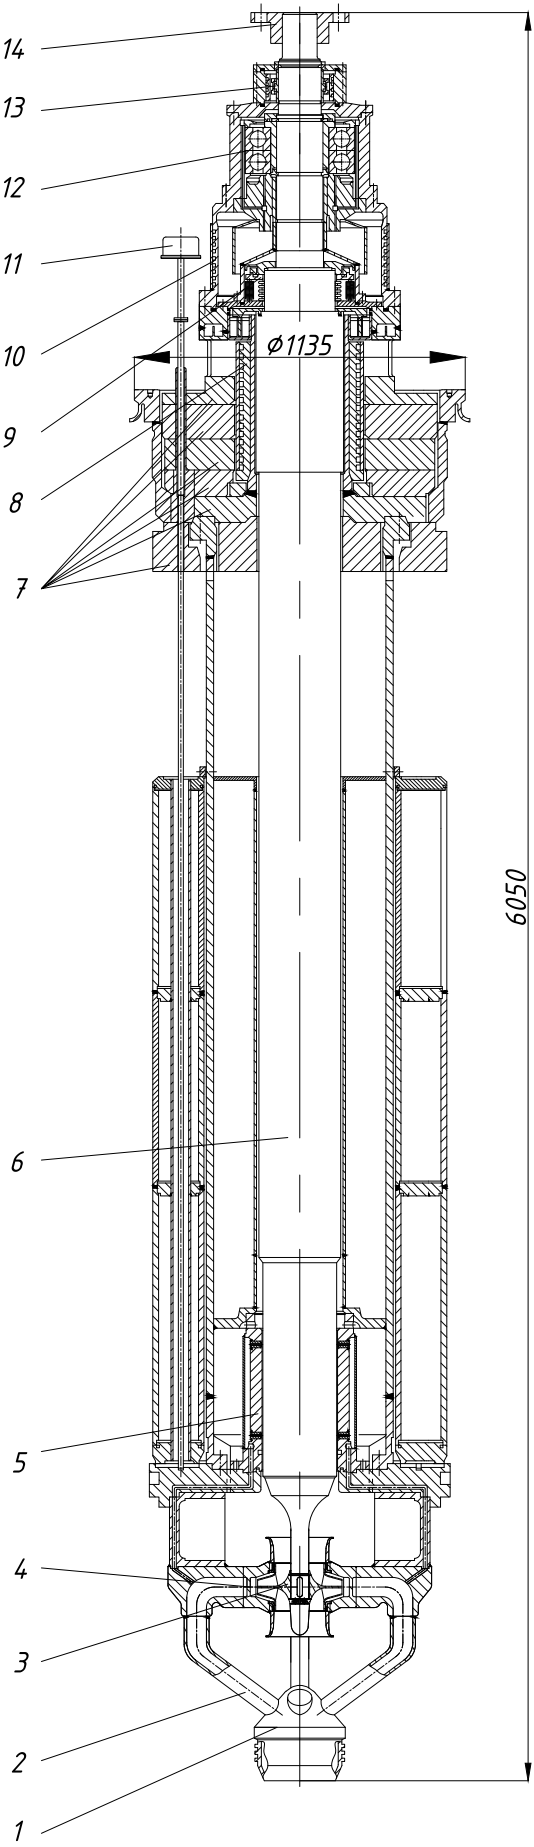
[picture p23: figure]

1 – напорный коллектор; 2 – напорный патрубок; 3 – рабочее колесо;

4 – направляющий аппарат; 5 – гидростатодинамический подшипник; 6 – вал;

7 – биологическая защита; 8 – холодильник вала; 9 – стояночное уплотнение вала;

10 – холодильник; 11 – уровнемер; 12 – верхний подшипниковый узел; 13 – уплотнение вала по газу; 14 - полумуфта

Рис. 2.2. Выемная часть насоса ЦНН-1М

Торцовое уплотнение вала по газу (рис. 2.3) обеспечивает герметичность насоса относительно внешней среды.

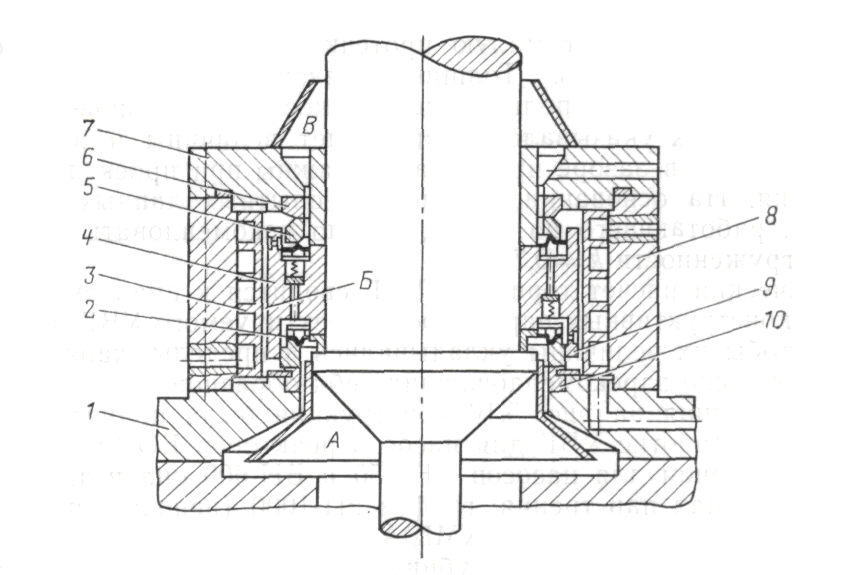
[picture p24: figure]

А - газовая полость; Б - масляная полость; В – атмосфера;

1, 7 - нижний и верхний несущие фланцы; 2 - диафрагма; 3 - холодильник;

4 - вращающийся опорный диск; 5, 9 - верхнее и нижнее подвижные кольца;

6, 10 - верхнее и нижнее неподвижные кольца; 8 - корпус

Рис. 2.3. Уплотнение вала по газу [2]

Поверхность графитовых колец, кроме плоскости контакта, омеднена с последующим лужением в целях исключения утечки масла через поры графита. Удельная нагрузка на пару трения составляет 0,25 МПа. Промежуточная камера между парами трения заполняется маслом, образующим масляный затвор, препятствующий выходу газа из корпуса насоса. Суммарные протечки масла через обе трущиеся поверхности не превышают 30 см3/ч.

Вал насоса — полый, сварен из двух частей: верхней из стали 10X13, нижней из стали Х18Н9. Стояночное уплотнение (рис. 2.4) расположено ниже верхнего подшипникового узла и в случае ремонта последнего, а также ремонта уплотнения герметизирует газовые полости насоса от окружающей среды. Эти уплотнения являются обязательными для жидкометаллических насосов и очень редко встречаются в конструкциях ГЦН для воды.

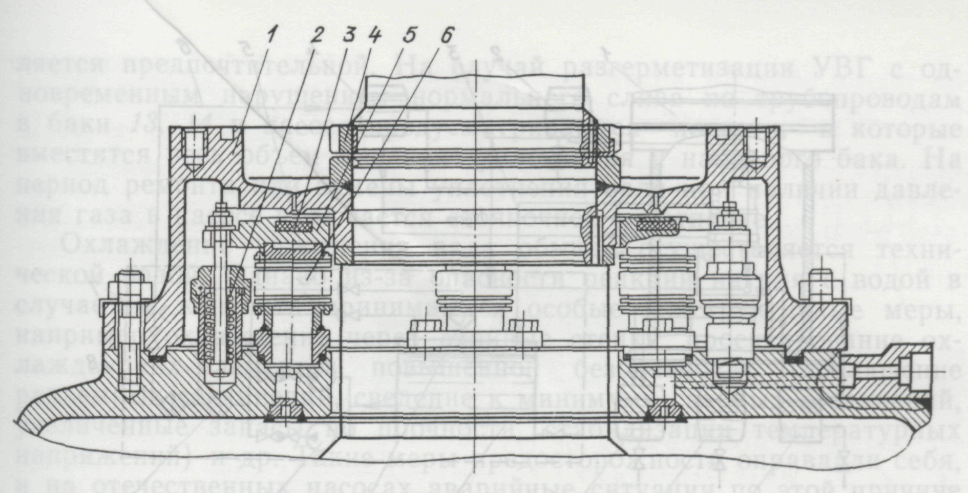
[picture p25: figure]

1 - корпус; 2 - пружина; 3 - фторопластовое кольцо; 4 - гайка; 5 - фланец; 6 - сильфон

Рис. 2.4. Схема стояночного уплотнения натриевого насоса [2,3]

Уплотняющим элементом стояночного уплотнения является фторопластовое кольцо, закрепленное на подвижном фланце, и конусная втулка, герметично посаженная на вал. Осевое перемещение фланца при включении стояночного уплотнения осуществляется подачей газа во внутреннюю полость сильфона давлением от 0,6 до 1 МПа.

Верхний подшипниковый узел состоит из несущего корпуса, системы смазки,
включающей в себя масляный насос и масляную ванну со встроенным в нее
холодильником, и радиально-осевого сдвоенного шарикоподшипника, изображенного на
рисунке 2.5. Система смазки подшипника замкнута внутри масляной ванны. Масло из
ванны подается винтовой втулкой, посаженной на вал

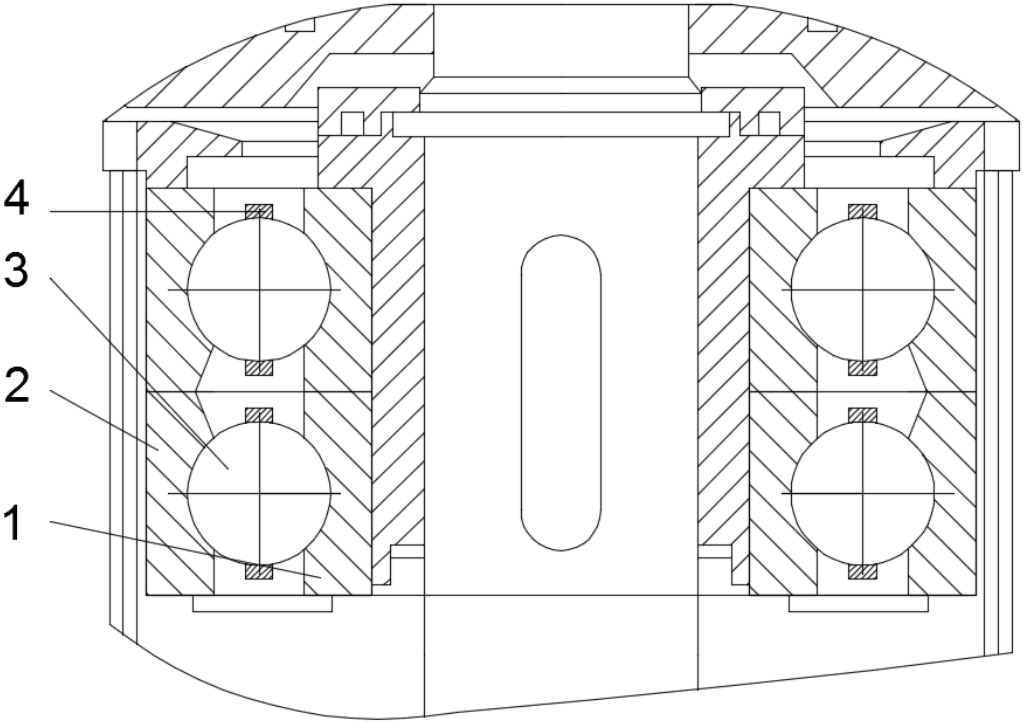
[picture p26: figure]

1 – внутреннее вращающееся кольцо; 2 – внешнее неподвижное кольцо; 3 – тело качения
(шарик); 4 - сепаратор

Рис. 2.5. Сдвоенный шарикоподшипник

Насосы первого контура центробежные, одноступенчатые, заглубленного типа, установлены на «холодной» ветке циркуляционного контура петлевой компоновки. Вал насоса вращается в двух подшипниках: нижнем-ГСП, верхнем - двойном роликовом радиально-осевом. В качестве привода применен асинхронный электродвигатель в герметичном исполнении. Всасывание натрия организовано сверху благодаря перевернутому рабочему колесу. Пройдя рабочее колесо, натрий попадает в направляющий аппарат и далее в напорный патрубок. В насос первого контура встроен обратный клапан, который представляет собой поплавок с запирающим диском. Уплотнение вала - двойное торцовое, с масляным гидрозатвором. Ремонт верхних узлов осуществляется без разгерметизации контура. Для этой цели служит стояночное уплотнение, состоящее из диска. герметично насаженного на вал и запрессованного в него резинового кольца.

Насос второго контура представляет собой аналогичную конструкцию, за исключением того, что по условиям работы в нем отсутствуют биологическая защита и обратный клапан.

По заданию на курсовой проект была поставлена задача произвести замену нижнего радиального гидростатодинамического подшипника вместо обратно-щелевого дросселирования.

Необходимо сделать заключение, что несмотря на то, что гидростатодинамический подшипник был спроектирован и рассчитан для насоса ЦНН-1М, устанавливать его в данный насосный агрегат не следует в следствии того, что перекачиваемой средой является среда жидкого натрия, которая в своем составе имеет взвеси и окислы. Из-за этого возникает вероятность забивания дросселей подшипника. Данная проблема решается путем применения гидростатического подшипника с обратно щелевым дросселированием, конструкция которого на входе обладает щелью. В виду геометрических характеристик дросселя и щели вероятность забивания взвесями первого выше. Взвеси и окислы попадая в щель перетираются в ней и не нарушают работу подшипника. Поэтому в среде жидкого натрия подшипник обратно щелевого дросселирования будет работать надежнее. [3, c.75 - c.79]

Рассмотрим гидростатодинамический подшипник насосов реактора БОР-60 (рис. 2.6)

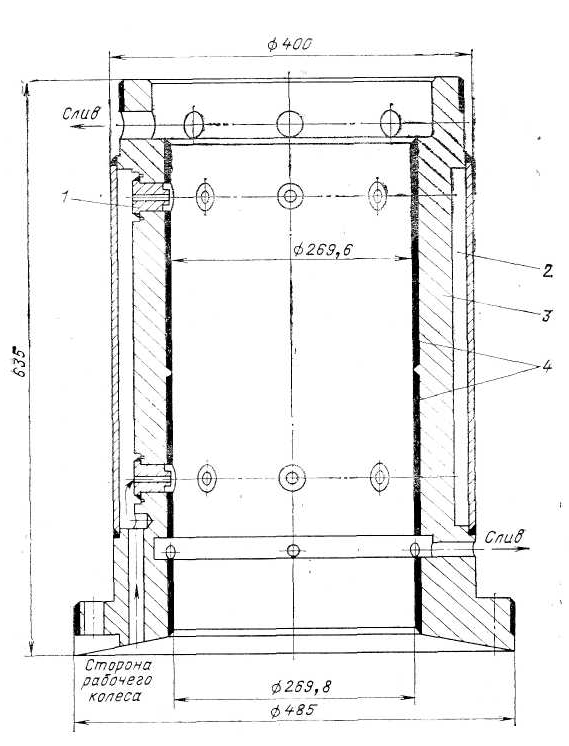
[picture p27: figure]

1 - дроссель; 2 - напорный коллектор; 3 - корпус подшипника; 4 - рабочая поверхность

Рис. 2.6. Гидростатодинамический подшипник насосов реактора БОР-60[2,3]

В этих подшипниках при увеличении частоты вращения вала грузоподъемность возрастает в гораздо большей степени, чем в камерных.

При диаметре отверстия в дросселе 7 мм и частоте вращения вала 1500 об/мин его грузоподъемность равнялась 19,6 кН. Подшипник работал без «сухого» трения и при 250 об/мин. Рабочие поверхности в корпусе были направлены электродом ЦН-6.

В таблице 2 приведены основные данные радиальных подшипников отечественного ГЦН с уплотнением вала.

Таблица 2 - Основные данные радиальных подшипников отечественного ГЦН с уплотнением вала.

Параметр | БОР-60
| Первый контур | Второй контур
Тип нижнего радиального подшипника | ГСП с взаимообратным щелевым дросселированием
Рабочая среда | Натрий
Температура рабочей среды, оС | 450 | 500
Диаметр втулки вала, мм | 270 | 270
Радиальный зазор, мм | 0,3 | 0,3
Число рабочих камер | 16 | 16
Диаметр отверстия в дросселе, мм | - | -
Расход рабочей среды на подшипник, м3/ч | 42 | 40
Перепад давления на подшипнике, МПа | 0,51 | 0,51
Нагрузка на подшипник, кН | 7,6 | 7,6
Рабочий относительный эксцентриситет | 0,8 | 0,8
Материал втулки вала | Сталь X18H9 с наплавкой ВЗК
Материал втулки в корпусе | Сталь X18H9 с наплавкой ВЗК и ЦН-6
Шероховатость рабочих поверхностей | 1.25-0,63

Подводящие устройства

Каналы, подводящие поток к лопастному колесу, оказывают значительное влияние на работу ГЦН. Основная задача при расчете подводов сводится к обеспечению минимальных потерь в проточной части патрубка и к снижению неблагоприятного влияния патрубка на работу колеса, т.е. к получению равномерного поля скоростей на входе в колесо.

Конструкция подвода должна обеспечить:

- минимальное гидравлическое сопротивление подвода;

- осесимметричный поток в выходном сечении подвода;

- минимальную закрутку потока;

-стабильность параметров потока на выходе из подвода.

Подвод для центробежного насоса с коэффициентом быстроходности ns=80 выполнен в виде бака, внутри которого установлены четыре напорных трубопровода (рис. 2.7).

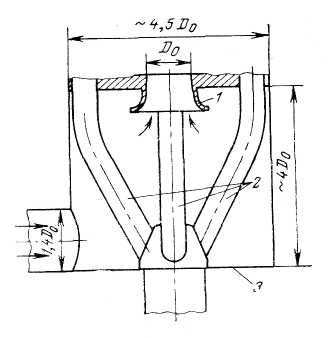
[picture p28: figure]

1-всасывающий патрубок; 2-напорные патрубки; 3-бак

Рис. 2.7. Подводящий патрубок ГЦН реактора БОР-60 (ns=80)

Насосы для перекачивания жидкого металла снабжены системой электроразогрева для обеспечения предварительного разогрева их корпусов перед заполнением, а также для поддержания необходимой температуры металла внутри насоса. Температура внутри бака натриевых насосов должна быть в пределах 150—200 °С. Полезно иметь нагреватели и на крышке насоса. Эти нагреватели позволяют перед пуском насоса расплавить натрий, застывший в щелях между холодильником и валом насоса при его стоянке.

В качестве привода ГЦН в подавляющем большинстве случаев используется электродвигатель. Насос второго контура в силу особенностей теплотехнической схемы установки должны иметь плавное или ступенчатое регулирование частоты вращения.

Известны следующие приводы ГЦН с регулируемой частотой вращения, применяемые в настоящее время в отечественной и зарубежной практике:

- асинхронный электродвигатель с изменением частоты вращения при помощи электромагнитных муфт, гидромуфт и зубчатых редукторов;

- двигатель постоянного тока с регулированием напряжения в цепи якоря;

- асинхронный двигатель с фазным ротором и жидкостным реостатом в цепи ротора;

- двухскоростной асинхронный электродвигатель;

- синхронный короткозамкнутый электродвигатель со статическим преобразователем частоты (вентильный привод);

- асинхронный электродвигатель с фазным ротором, работающим в системе асинхронно-вентильного каскада (АВК).

Наиболее перспективными из перечисленных способов считаются последние три, и именно они применяются в настоящее время на современных установках.

Для смазки шарикоподшипника и для подпитки уплотнения вращающегося вала по газу служит масляная система. Система смазки шарикоподшипника циркуляционная, замкнутая внутри масляной ванны. Масло из ванны подается на подшипник винтовой втулкой и стекает обратно в ванну, где охлаждается встроенным водяным холодильником.

Для подпитки масляного уплотнения вала по газу используется масло из напорного бака. Протечки масла из масляной ванны и уплотнения вала по газу сливаются в герметичный и негерметичный баки протечек.

Система охлаждения насоса водяная, служит для снятия тепла с вала, подшипника и уплотнения вала по газу. Охлаждающая вода из общей системы подается в холодильник вала, в холодильник масляной ванны, в холодильник уплотнения вала и возвращается обратно в систему.

Охлаждение электродвигателя воздушное, осуществляется электровентилятором ЭВР-4 мощностью 2,8 кВт. Вентилятор поставляется комплексно с электродвигателем.

Для создания на всасывании насоса противакавитационного подпора и для предотвращения окисления натрия полость насоса над свободным уровнем натрия в баке заполнена инертным газом-аргоном.

Схема насосного агрегата со вспомогательным оборудованием показана на рис. 2.8.

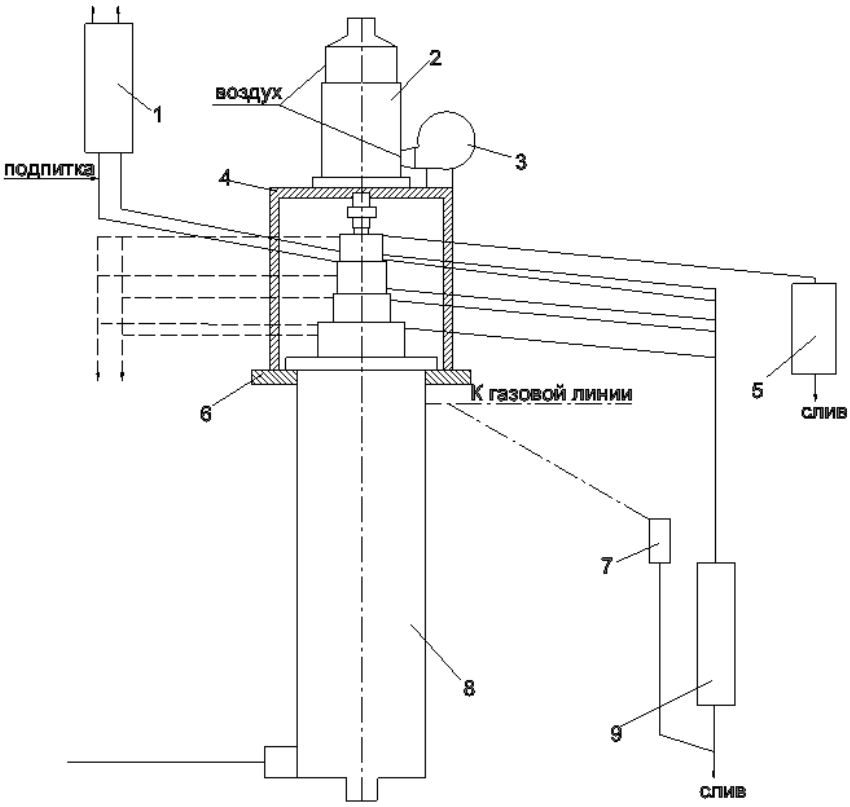
[picture p29: figure]

1 – бак напорный 50 л; 2 – электродвигатель; 3 – вентилятор электродвигателя; 4 – станина электродвигателя; 5 – бак протек 50 л (негерметичный); 6- плита опорная;

7 – маслоотделитель; 8 – насос; 9 – бак протечек 150 л (герметичный).

Рис. 2.8. Схема насосного агрегата со вспомогательным оборудованием

В таблице 3 представлены основные характеристики разработанного насоса, а в
таблице 3.1 материалы основных деталей.

Таблица 3 - Основные характеристики насоса (по расчёту)

Марка насоса | ЦНН-1М
Подача, м^3 /ч | 650
Напор, м | 92
Частота вращения (синхр), об/мин | 3000
Мощность насосного агрегата, кВт | 195
Температура теплоносителя, ˚С | 450
Давление на всасывании, МПа | 0,03
Коэффициент полезного действия, % | 80,6
Масса насосной установки, т | 31

Таблица 3.1 – Материалы основных деталей спроектированного насоса

Рабочее колесо | Вал насоса | Корпус насоса (бак) | Направляющий аппарат | Станина под электродвигатель
10Х18Н12М3Л | Х18Н9 | Х18Н9 | 1Х18Н12М3Л | Сталь 20

3. Расчет рабочего колеса с профилирование лопастей и меридианного сечения

3.1 Исходные данные для расчета

Во время выполнения курсового проекта я произвел замену однопоточного колеса оригинального насоса БОР-60, на двухпоточное.

Исходные данные приведены в таблице 4.

Таблица 4 - Исходные данные

Наименование параметра | Значение
Подача Q, | 650
Напор H, м | 92
Давление на входе в насос P , МПа | 0,03
Температура натрия на входе в насос T , ⁰С | 450
Плотность натрия при данной температуре 450 оС ρ , кг/м³ | 844
Давление насыщенных паров натрия P_(нп) , Па | 164,4

3.2. Определение располагаемого кавитационного запаса

Располагаемый кавитационный запас определяется по формуле

∆hрас=(P_с)/(ρ∙g)+(v^2)/(2∙g)-(P_(нп))/(ρ∙g)

где: Рс = P + Ра – абсолютное статическое давление на входе в насос, Па

Pнп – давление насыщенных паров, Па

v – скорость среды на входе в насос, м/с

(P_с)/(ρ∙g)+(v^2)/(2∙g) - полная удельная энергия потока (Eвх) на входе в насос.

Т.к. на начальном этапе значение скоростей неизвестно, то опустим это слагаемое. Таким образом:

∆h_(рас) =(P_с -Pнп)/(ρ∙g)=(0,13∙10^6 -164,4)/(844∙9,81)=15,7 м

Тогда ∆h_(рас) =15,7 м. Расчет уточненного значения располагаемого кавитационного запаса будет проведен после расчета геометрии рабочего колеса насоса. В конечном итоге уточнение значения располагаемого кавитационного запаса только лишь увеличит располагаемый кавитационный запас.

3.3 Выбор частоты вращения ротора

Расчет выполняется следующим образом.

3.3.1 Задаемся частотой вращения ротора.

n=n_(sin) ∙(1-S/100)=3000∙(1-(3,33)/100)=2900(об)/(мин),

где s=3,33%-скольжение.

3.3.2 Определяем коэффициент быстроходности.

Рассматриваем вариант двухпоточного рабочего колеса.

n_s =(3,65∙n∙√Q)/(H^(0,75))=(3,65∙2900∙√(650/(3600∙2)))/(92^(0,75))=107

Тип рабочего колеса - центробежное нормальное.

3.3.3 Определяем кавитационный коэффициент быстроходности.

Кавитационный коэффициент быстроходности определяем по рис. 3.1 [5, стр. 35].

С_(кр) =771

3.3.4 Определяем критический кавитационный запас.

∆h_(кр) =10∙[(n∙√Q)/(Скр)]^(4/3) =10∙[(3000∙√(650/(3600∙2)))/771]^(4/3) =11,77 м

3.3.5 Определяем допускаемый кавитационный запас.

∆h_(доп) =1,2∙hкр=14,1 м

Результаты расчетов приведены в таблице 5.

Таблица 5 - Результаты расчетов

Наименование параметра | Значение
Частота вращения ротора синхронная n_(sin) , об/мин | 3000 | 1500 | 1000
Частота вращения ротора n, об/мин | 2900 | 1450 | 970
Коэффициент быстроходности n_s | 107 | 54 | 36
Кавитационный коэффициент быстроходности Скр | 772 | 686 | 657
Располагаемый кавитационный запас ∆hрас , м | 15,7 | 15,7 | 15,7
Критический кавитационный запас ∆hкр , м | 11,8 | 5,5 | 3,4
Допускаемый кавитационный запас ∆hдоп =1,2 Δhкр, м | 14,2 | 6,6 | 4,0

Кавитация отсутствует при условии Δhрас > Δhдоп. Для изготовления рабочего колеса с лопастями одинарной кривизны коэффициент быстроходности должен быть <130. Это условие выполняется при частоте вращения ротора 3000, 1500, 1000 об/мин. Для дальнейшего проектирования принимаем вариант с наибольшей частотой вращения ротора. Этот вариант будет иметь наименьшие габариты и высокий КПД насоса - η≈ 81%;

3.4 Определение размеров рабочего колеса с помощью диаграмм

Для выбранного варианта определяются размеры рабочего колеса насоса с помощью диаграмм на рис. 3.3 [5, стр.37]. По диаграмме выбираем коэффициенты в зависимости от коэффициента быстроходности. Согласно данным диаграммы все определяемые параметры являются функцией быстроходности насоса и могут быть рассчитаны по формуле:

X=K_X ∙(√H)/n

где: Х – определяемый параметр;

K_X – соответствующий параметру коэффициент на диаграмме;

Н – напор насоса;

n – частота вращения ротора насоса.

Тогда:

D_0 =K_(D_0) ∙(√H)/n=44,6∙(√92)/3000=147,7 мм;

b_1 =K_(b_1) ∙(√H)/n=13,8∙(√92)/3000=45,5 мм;

D_2 =K_(D_2) ∙(√H)/n=87,6∙(√92)/3000=289,7 мм;

b_2 =K_(b_1) ∙(√H)/n=6,1∙(√92)/3000=20,1 мм;

Полученные результаты приведены в таблице 6

Таблица 6 - Результаты расчетов по диаграммам

Значение коэффициента | KD0 = 44,6 | Kb1 = 13,8 | KD2 = 87,6 | Kb2 = 6,1
Размер колеса, мм | D0 = 147,7 | b1 = 45,5 | D2 = 289,7 | b2 = 20,1

3.5 Расчет геометрии рабочего колеса и параметров потока по программе MathCad

Расчет геометрии рабочего колеса и параметров потока выполнен по программе MathCad. Скриншот экрана с результатами расчета по программе MathCad приведен в приложении А. Результаты расчета геометрии рабочего колеса и параметров потока приведены в таблице 7.

Таблица 7 – Расчет рабочего колеса

Наименование | Формула | Значение
Частота вращения ротора, об/мин | | 2900
Подача ступени, м3/с. | | 0,09
Напор ступени, м | | 92
Коэффициент быстроходности ступени | | 107
Приведенный диаметр, мм | | 133,7
Гидравлический кпд ступени | | 0,89
Объемный КПД ступени | | 0,971
Механический КПД ступени | | 0,933
КПД ступени | | 0,806
Мощность проточной части, кВт | | 170,5
Максимальная мощность проточной части, кВт | | 204,6
Диаметр вала из условия прочности, мм; Ϭкр = 15 ∙ 10⁶ Па | | 61,2
Диаметр втулки, мм | | 76,5
Принимаем диаметр втулки, мм | - | 76
Кавитационный коэффициент быстроходности: Для консольного расположения рабочего колеса, либо для проходного вала | - | 771
Критический кавитационный запас, м | | 11,77
Допускаемый кавитационный запас, м | | 14,1
Скорость на входе в ступень, м/с (Кvо – коэффициент входной скорости) /Kvo = 0,06 – 0,08/ Принимаем Kvo = 0,0603 | | 5,56
Диаметр колеса на входе, мм | | 165
Диаметр лопасти на входе /D1osn_otn = D1/D0 = 0,8 – 1/ Принимаем D1osn_otn = 0,9 | | 148,5
Меридианная скорость на входе, м/с /Kvm1 = 0,5 – 1,1/ Принимаем Kvm1 = 0,915 | | 5,08
Ширина лопасти на входе, мм | | 39,2
Окружная скорость лопасти на входе, м/с | | 22,55
Коэффициент стеснения К1 Принимаем количество лопастей на входе Z1=7, толщину лопасти на входе S1=5мм. Угол установки лопасти на входе β1=20. | | 1,281
Угол потока на входе, град | | 16,1
Угол атаки, град | | 3,9
Меридианная скорость на входе с учетом стеснения, м/с | | 6,51
Подача на ступень с учетом объемных протечек, м3/с | | 0,093
Относительная скорость на входе, м/с | | 19,04
Критический кавитационный запас, м m0 = 1,2 n0 = 0,4 | | 13,13
Кавитационный коэффициент быстроходности | | 710
Меридианная скорость на выходе, м/с /Kvm2 = 0,5 – 1/ Принимаем Kvm2 = 1 | | 5,08
Теоретический напор, м | | 103,37
Окружная скорость на выходном диаметре (начальное приближение), м/с | | 45
Диаметр рабочего колеса на выходе (начальное приближение), мм | | 296,5
Принимаем количество лопастей на выходе, Z1 ∙ Z2otn=7. Толщину лопасти на выходе, S2=5мм. Угол установки лопасти на выходе β2=23. Решение системы 4-х уравнений определяет: - Диаметр рабочего колеса на выходе D2, мм; - Окружная скорость на наружном диаметре u2, м/с; - Коэффициент затеснения К2; - Поправку на конечное число лопастей P. (Формулы системы записаны по правилам программы MathCad). | | P = 0,324 K2 = 1,11 u2= 43,88 D2 = 288,9
Окружная составляющая абсолютной скорости на выходе, м/с | | 23,1
Меридианная скорость на выходе с учетом стеснения, м/с | | 5,64
Относительная скорость на выходе, м/с | | 14,43
Коэффициент торможения относительной скорости в колесе | | 1,32
Ширина колеса на выходе, мм | | 20,1
Угол абсолютной скорости на выходе, град | | 12,41
Абсолютная скорость на выходе из колеса, м/с | | 23,7

∆hрас=(P_с)/(ρ∙g)+(v^2)/(2∙g)-(P_(нп))/(ρ∙g)=(0,13∙10^6)/(844∙9,81)+(5,56^2)/(2∙9,81)-(164,4)/(844∙9,81)=17,26 м

Скорректированное значение располагаемого кавитационного запаса ожидаемо
увеличилось, так как в первом приближении скорость среды на входе в насос V
принималась равной 0. Приращение произошло за счет слагаемого V²/2g, входящего в
состав полной удельной энергии потока на входе в насос.

Треугольник скоростей на входе в колесо показан на рисунке 3.1

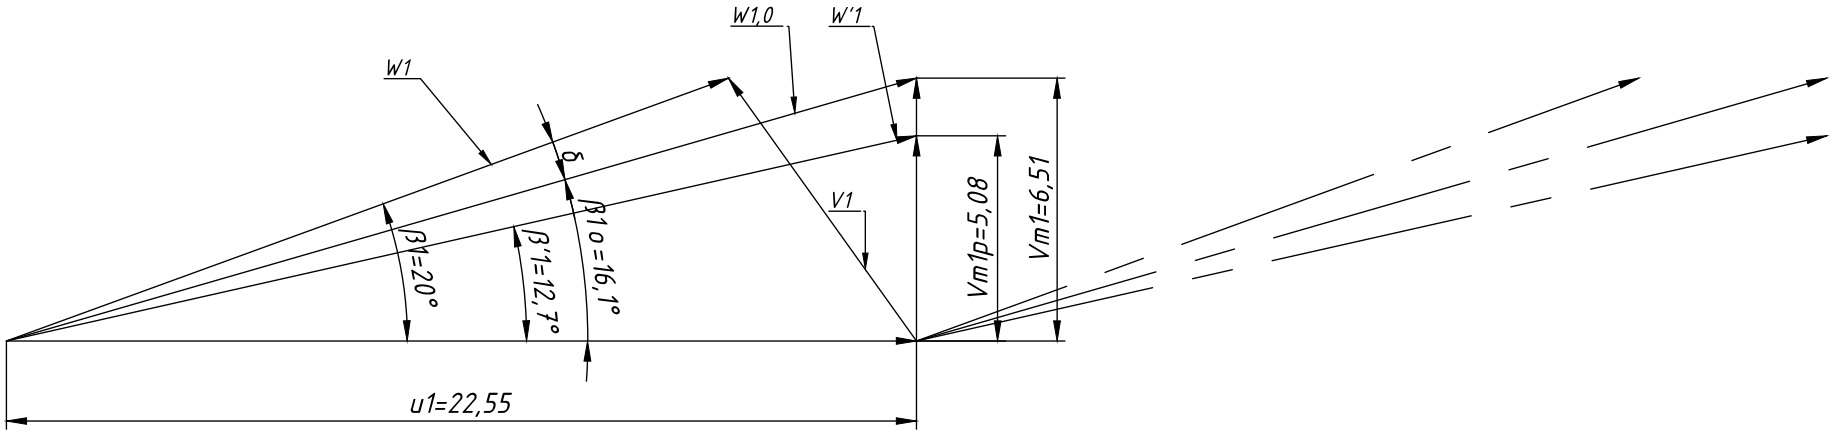
[picture p30: figure]

β1 – угол лопатки на входе; β1о – угол потока на входе; β’1 – угол потока до поступления на лопасти колеса; δ – угол атаки; W1 – относительная скорость на входе; W1,0 – относительная скорость потока без учета стеснениями лопастями; W’1 – относительная скорость потока до поступления на лопасти колеса; u1 – окружная скорость лопасти на входе; Vm1p – меридианная скорость на входе; Vm1 – меридианная скорость на входе с учетом стеснения

Рис. 3.1. Треугольник скоростей на входе в колесо

Треугольники скоростей на выходе из рабочего колеса показан на рисунке 3.2.

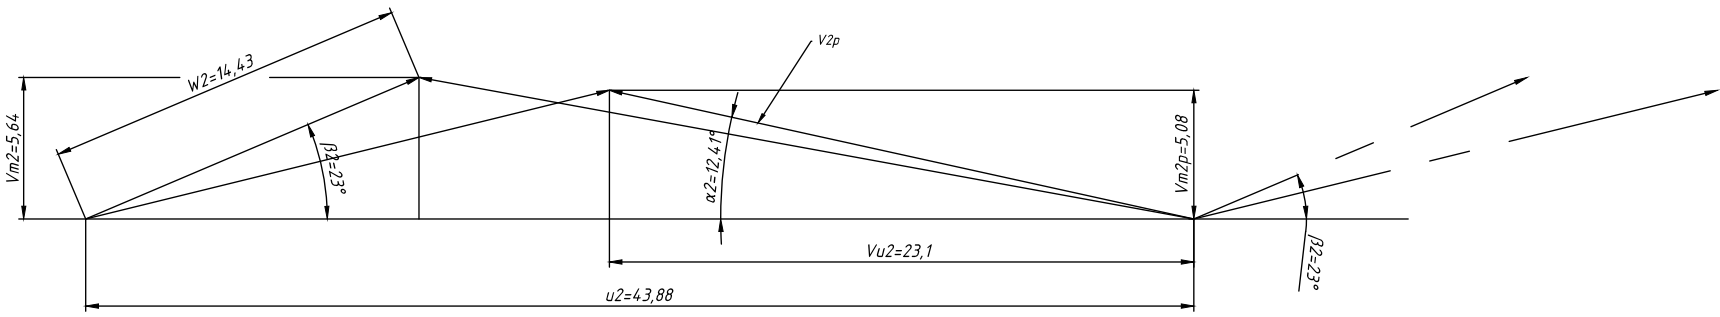
[picture p31: figure]

β2 – угол лопатки на выходе; α2 – угол абсолютной скорости на выходе; W2 – относительная скорость на выходе; u2 – окружная скорость лопасти на выходе; Vu2 – окружная составляющая абсолютной скорости на выходе; V2p – абсолютная скорость на выходе из колеса; Vm2p – меридианная скорость на выходе; Vm2 – меридианная скорость на выходе с учетом стеснения

Рисунок 3.2. Треугольник скоростей на выходе из колеса

3.6 Профилирование меридианного сечения рабочего колеса

Профилирование должно быть осуществлено так, чтобы создать благоприятные условия для безотрывного обтекания контура лопасти потоком, что обеспечивает минимум гидравлических потерь.

Параметры рабочего колеса сведем в таблицу 8.

Таблица 8 – Параметры рабочего колеса

Вход в рабочее колесо D0, мм | 165
Диаметр расположения водных кромок лопаток D1, мм | 148,5
Выход из рабочего колеса D2, мм | 289
Ширина колеса на входе b1, мм | 39,2
Ширина колеса на выходе b2, мм | 20,1
Число лопаток Z | 7
Толщина лопатки на входе S1, мм | 5
Толщина лопатки на выходе S2, мм | 5
Угол лопатки на входе β1, град | 20
Угол лопатки на выходе β2, град | 23

Координаты поверхности покрывного диска определены при профилировании канала в пакете Mathcad 2015 и приведен в приложении Б. На рис. 3.3 показано построение меридианного сечения рабочего колеса, на рис. 3.4 приведен эскиз меридианного сечения рабочего колеса (одной половины).

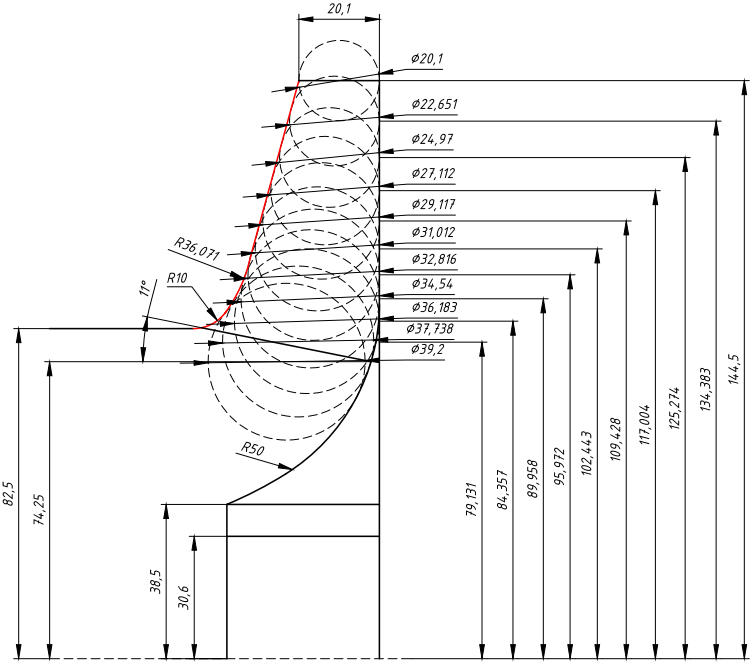
[picture p32: figure]

Рис. 3.3. Построение эскиза меридианного сечения колеса.

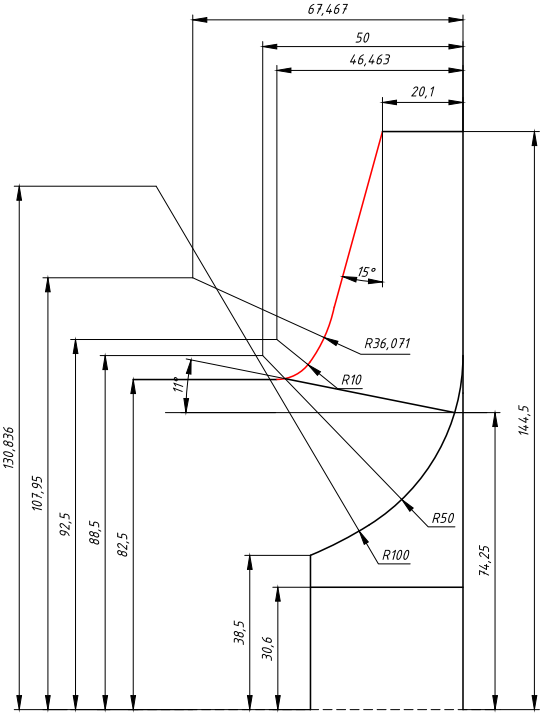
[picture p33: figure]

Рис. 3.4. Эскиз меридианного сечения колеса.

3.7 Профилирование лопастей рабочего колеса по программе в Mathcad

Профилирование рабочих лопаток проведем и использованием пакета Mathcad 2015 по методике изложенной в [5]. В приложении Б представлен полный расчет. На рисунке 3.5 представлен вид рабочих лопаток, полученный в результате расчета.

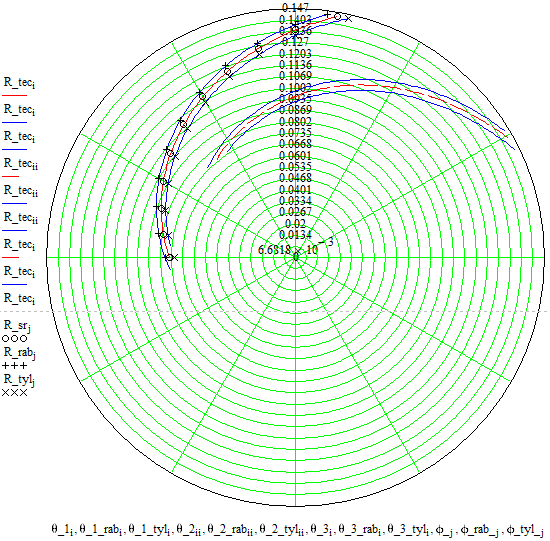
[picture p34: figure]

Рис. 3.5. Профили лопаток рабочего колеса

Дополнительно была разработана 3D модель рабочего колеса в программе Компас-3D.

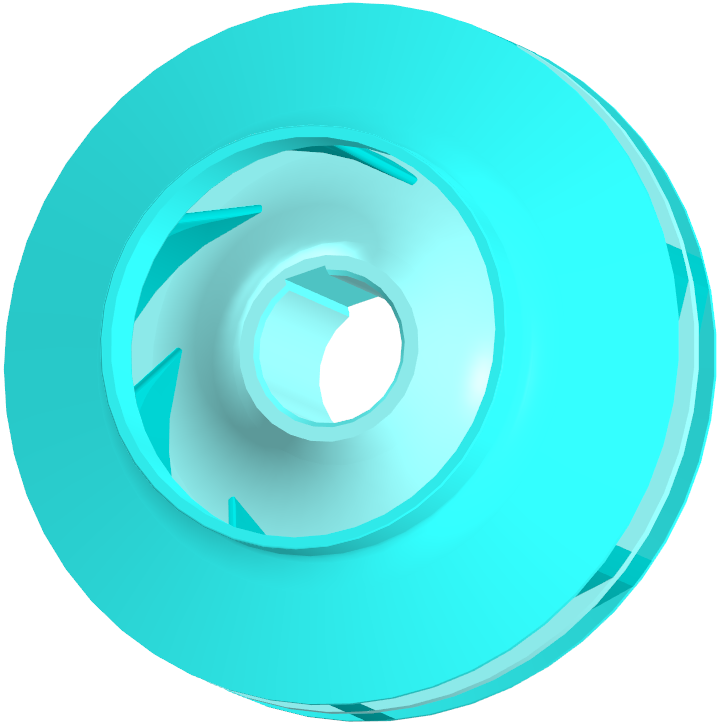
[picture p35: figure]

Рис. 3.6. 3D модель рабочего колеса

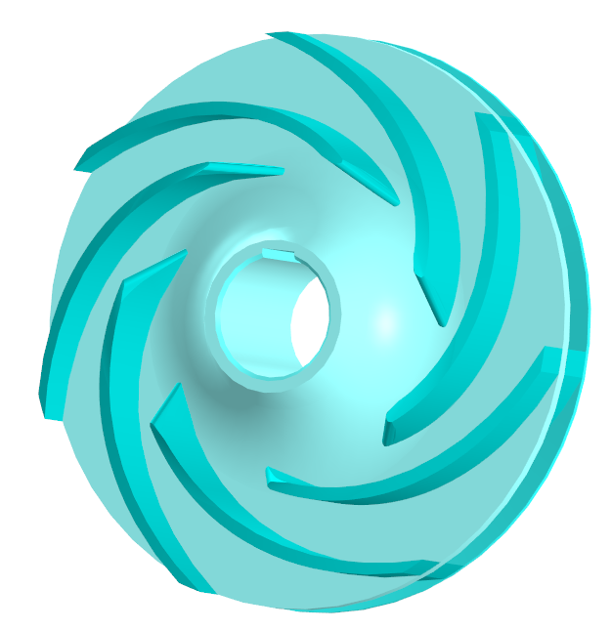
[picture p36: figure]

Рис. 3.7. 3D модель рабочего колеса без покрывного диска

4. Расчёт направляющего аппарата

Вид направляющего аппарата выбираем аналогично прототипу, то есть канальный.

Отличительной чертой лопаточного отвода является наличие нескольких каналов. Каждый канал состоит из спиральной части и диффузора. Спиральная часть канала обычно выполняется постоянной ширины. Для обеспечения оптимальных условий течения в каналах направляющего аппарата должны быть соблюдены следующие условия:

1) при данной площади канала его гидравлический радиус должен быть максимальным. Этому условию лучше всего удовлетворяет квадратное сечение на входе в направляющий аппарат;

2) канал диффузора целесообразно выполнять с прямолинейными стенками;

3) число лопаток следует принимать минимальным;

4) угол раскрытия канала диффузора следует принимать равным углу раскрытия для прямолинейных диффузоров или меньшим;

5) угол лопатки имеет второстепенное значение по сравнению с оптимальным соотношением размеров колеса.

Контур лопатки должен следовать линиям тока потока.

4.1 Расчет геометрии и параметров потока

Средняя скорость в горловом сечении:

C_3 =K_3 ∙√(2g∙H)=0,38∙√(2∙9,81∙92)=16,145м/с

где К3 – опытный коэффициент, изменяющийся в зависимости от nS (согласно рис. 5.3 методички).

Из графика К3 = 0,38.

Диаметр начальной окружности:

D3=(1,03…1,05)∙D2=1,038∙289≈300 мм

Принимаем ширину аппарата:

b_3 =1,1∙2∙(20,1+2∙5)=66,2 мм

Площадь горлового сечения на входе определяется следующим образом:

Согласно рекомендациям по соотношению числа лопастей рабочего колеса и НА принимаем Zна = 12.

F_г =Q/(C_3 ∙Z_(на))=(650/3600)/(16,145∙12)=0,000932 м^2

Где: Z_(на) – число лопаток НА.

Ширина горлового сечения составит:

a_г =(F_Г)/(b_3)=(0,000932∙10^6)/(66,2)≈14 мм

Меридианная скорость потока на входе в НА без учета cтеснения:

C_(m_3) =Q/(π∙D_3 ∙b_3)=2,9 м/с

Окружная скорость потока на входе в направляющий аппарат:

C_(u_3) =C_(u_2) ∙((D_2)/(D_3))=23,1∙(289/300)=22,253

Угол потока на входе в направляющий аппарат без учета стеснения

α_3 =180/π∙atan((C_(m_3))/(C_(u_3)))=180/(3,14)∙atan((1,45)/(22,253))=7,4°

Для диффузора с прямоугольным горловым сечением и двумя параллельными боковыми стенками около 10⁰ – 12⁰, принимаем 11⁰.

Длину диффузора между лопатками следует принимать

L = 4 ∙ a_г = 14 ∙ 4 = 28 мм

Рациональное увеличение проходного сечения в канале диффузора 1,6 – 2.

Принимаем a_в =(1,6-2)∙a_г =1,785∙14=25 мм

Диаметр наружной окружности НА принимаем D4 = 386 мм.

(D_4)/(D_2)=386/289=1,34

4.2 Профилирование лопаток направляющего аппарата


Рис 4.1. Эскиз направляющего аппарата

5. Эскиз проточной части насоса и чертеж рабочего колеса насоса

Эскиз проточной части насоса, был построен, ориентируясь на насос прототип, рисунок 5.1, чертеж рабочего колеса представлен на рисунке 5.2, а также в приложении 2.

5.1 Расчет размеров сборной камеры

Площадь меридианного сечения кольцевого коллектора должна быть больше площади входа в каналы направляющего аппарата не менее чем в 1,7 раза.

Fколлект = 12 ∙ 2 ∙ F_г = 12 ∙ 2∙0,000932 = 0,022368 м²

Радиус меридионального сечения кольцевого коллектора:

R_(коллект) =√((F_(коллект))/π)=√((0,022368)/π)=0,085 м

Наибольший диаметр кольцевого коллектора:

D_(наиб) =D_4 +2⋅R_(коллект) =386+2⋅85=556 мм


Рис. 5.1. Эскиз проточной части насоса. 1 – напорный коллектор, 2 – НА, 3 – РК

На основании проведенных расчетов разработан чертеж рабочего колеса насоса. Чертеж приведен в приложении 1.

6. Расчёт мощности проточной части насоса

При расчете мощности проточной части насоса надо учитывать, что насос работает не на номинальной подаче, а в рабочем диапазоне подач и мощность при увеличении подачи увеличивается примерно в 1,2 раза от номинальной мощности. Так же необходимо учесть то, что главные циркуляционные насосы, устанавливаемы на АЭС должны работать в широком температурном диапазоне при «холодном» и «горячем» теплоносителе. ГЦН работает на «холодном» теплоносителе, при первом пуске РУ.

Электродвигатель подбирается по максимальной мощности проточной части насоса с учетом механических потерь в насосе, причем мощность электродвигателя должна быть больше нее на 5-10%.

Далее значения сведем в таблицу 9. Значения КПД было взято из пункта 3.5.

Таблица 9 – Значения мощностей насосного агрегата

Значение | Величина
Полезная мощность, NП кВт | 137,5
Гидравлический КПД, η_g | 0,89
Механический КПД, η_dt | 0,933
Объемный КПД, η_ob | 0,971
КПД проточной части, η | 0,806
Мощность проточной части, NПЧ кВт - при номинальной плотности (450°С, ρ=844 (кг)/(м^3) ) - при максимальной плотности (100°С, ρ=902 (кг)/(м^3) ) - при максимальной подаче | 170,5 182,2 204,6
Мощность на валу максимальная, NВАЛmax кВт | 195
Мощность электродвигателя, NДВ кВт | 210

7. Расчет осевой силы, действующей на осевой подшипник

Разрабатываемый насос вертикальный. Сила, воспринимаемая осевым подшипником, складывается из веса роторной сборки и гидравлических сил, действующих на элементы роторной сборки.

В данном случае в связи с тем, что в насосе применено рабочее колесо с двухсторонним всасом, будут отсутствовать осевые силы гидродинамического и статического происхождения, действующие на поверхности рабочего колеса, т.к. они будут взаимно уравновешиваться вследствие симметрии. Таким образом осевая сила на рабочем колесе будет определяться силой тяжести вала и рабочего колеса, разностью давления действующих на торцы вала - с одной стороны атмосферой, а с другой стороны давлением всаса, а также силой Архимеда.

Расчет будем вести, принимая что все элементы имеют одну плотность ( ρ=7900 (кг)/(м^3) ) и цилиндрическую форму.

Таким образом масса каждой ступени будет определяться как:

M=(π∙D^2)/4∙H∙ρ

Для полого участка вала:

M=(π∙(D_(внеш)^2 -D_(внутр)^2 ))/4∙H∙ρ

Объем вала: V_(вал) =0,114 м^3

Объем погруженной части вала: V_(пог.вал) =0,05 м^3

Масса вала: M_(вал) =906,93кг

Масса лопасти:

V_(ЛОП) =(b_1 +b_2)/2∙l∙S=(0,0392+0,0201)/2∙0,192∙0,005= 2,156∙10^(-5) м^3

S – средняя толщина лопасти, l – длина лопасти, b1 – высота лопатки на входе, b2 – высота лопатки на выходе.

M_(ЛОП) =ρ∙V_(ЛОП) =7900∙2,156∙10^(-5) =0,170 кг

Масса покрывного диска (рассчитываем приближенно, опираясь на упрощенные фигуры цилиндров и усеченных конусов):

V_(ПД) =π/4(0,289^2 -0,165^2 )∙0,003+π/4(0,171^2 -0,165^2 )·0,012π/4(0,175^2 -0,165^2 )

·0,02=2,001∙10^(-4) м^3

M_(ПД) =2∙ρ∙V_(ПД) =2∙7900 ∙2,001∙10^(-4) =3,16 кг

Масса ведущего диска (рассчитываем приближенно, опираясь на упрощенные фигуры цилиндров и усеченных конусов):

V_(ВД) =π/4(0,289^2 -0,0612^2 )∙0,003+π/12((0,177^2 +0,177∙0,077+0,077^2 )-

-0,0612^2 )·0,038=5,354∙10^(-4) м^3

M_(ВД) =2∙ρ∙V_(ВД) =2∙7900 ∙6,569∙10^(-4) =8,46 кг

Итоговая масса рабочего колеса:

M_(РК) =2∙7∙M_(ЛОП) +M_(ВД) +M_(ПД) =14 кг

При использовании программы Компас-3D для построения 3D геометрии рабочего колеса, получили массу М=13,57 кг.

В итоге получим результат что масса роторной сборки M=920 кг.

Сила тяжести (направлена вниз):

F_(тяж) =g∙M≅9025 H

Сила Архимеда, действующая на часть ротора в натриевом теплоносителе:

F_(арх) =ρ∙g∙V_(ПОГ) ≅844∙9,81∙0,052=433 H=44 кг

Вес ротора в натриевом теплоносителе:

P_(рот) =920-44=876 кг

Выталкивающая сила на роторе:

F_(выт) =(P_(абс) -P_(атм) )((π∙D_(ср)^2)/4)=627 Н

D_(ср) – средний диаметр уплотнительного стыка

Таким образом осевая сила, действующая на осевой подшипник, определяется по формуле:

F_(ОС) =-F_(тяж) +F_(арх) +F_(выт) =-9025+433+627=-7965 Н≅-8000 H

На рисунке 7.1 приведена схема вала для расчета осевой силы.

Рис. 7.1. Упрощенная схема вала

8. Расчет радиальной силы, действующей на радиальные подшипники

Радиальные гидравлические силы на рабочем колесе возникают при нарушении круговой симметрии параметров потока вокруг рабочего колеса. В разрабатываемой конструкции насоса применен лопаточный направляющий аппарат, который не нарушает круговую симметрию потока. Неравномерность потока в сборной камеры возникает из-за применения напорного патрубка. Однако принятые размеры сборной камеры исключают возникновение при этом существенных нарушений потока вокруг рабочего колеса. Поэтому в разрабатываемой проточной части радиальными гидравлическими силами на рабочем колесе пренебрегаем.

Остаточный небаланс роторной сборки принимаем равным 3% веса роторной сборки. (FR=40 кг)

9. Расчет подшипниковых опор

Требования к подшипниковым опорам:

- высокая надежность на всех режимах работы, включая пуски н остановки, а также ресурс не менее 50 тыс. ч;

- работоспособность в среде с высокой температурой, давлением и возможным наличном мелких твердых частиц;

- отсутствие склонности материалов, применяемых для трущихся пар подшипников, к «самосвариванию» и «схватыванию» при аварийном отсутствии питающей жидкости;

- к деформациям и фазовым превращениям при температуре до 400"С, к изменению размеров при проведении дезактивации контура моющими растворами;

- используемые материалы должны быть в максимальной степени технологичными, дешевыми и взаимно совместимыми;

- нежелательно присутствие в материале подшипника элементов, которые под
облучением в реакторе приобретают долгоживущую наведенную радиоактивность;

- недопустимо выделение из материалов подшипника коррозионно-опасных
веществ (например, фтора);

- хорошая ремонтопригодность;

- относительно малая чувствительность к изменению нагрузки, к нарушению
заданной соосности опор в процессе работы, достаточная вибростойкость;

- используемые для подшипников смазочно-охлаждающие жидкости должны быть
огнестойкими и нетоксичными.

9.1 Расчет сдвоенного радиально-упорного подшипника [7]

n=2900 мин^(-1)

d=160 мм

Примем ресурс подшипников [L_(10h) ]=10 лет=87600 ч

Силы на опорах.

Примем радиально-упорный сдвоенный шарикоподшипник, поэтому будем считать, что каждая из его частей принимает половину осевой и радиальной силы.

F_(РАД) =196 Н

F_C =4000 H

Условия эксплуатации подшипника - нормальные. Рабочая температура 50⁰.

Предварительно принимаем подшипник 1046932 ГОСТ 831-75 (серия диаметров 9, серия ширин 1):

d×D×B=160×220×28

Базовая грузоподъемность:

F_r =173000 H

Угол контакта:

α=36^o

По таблице [2, c. 114] определяем коэффициент осевой нагрузки e=0,95

Коэффициент вращения:

V=1

(F_C)/(V⋅F_(РАД))=4000/(1⋅196)=20,4>e

тогда принимаем коэффициенты радиальной и осевой нагрузок:

X=0,6

Y=1,07

Расстояние от нагрузки до точки пересечения нормали к середине площадки контакта ПК и вала:

a=0,5⋅[B+0,5⋅(d+D)⋅tgα]=0,5⋅[28+0,5⋅(160+220)⋅tg36]=60 мм

Коэффициент безопасности:

K_Б =1,4

Температурный коэффициент:

К_Т =1

Эквивалентная радиальная динамическая нагрузка:

R_Е =(X⋅V⋅F_(РАД) +Y⋅F_C )⋅K_Б ⋅К_Т =(0,6⋅1⋅196+1,07⋅4000)⋅1,4⋅1=

=6157 H

Обобщенный коэффициент, учитывающий совместное влияние особых свойств маталла и условий эксплуатации ПК:

а_23 =1

Показатель степени кривой усталости:

р=3

Расчетный скорректированный ресурс ПК 336328Л1

L_(10ah) =(10^6 ⋅a_23 ⋅((Cr)/(R_E))^p)/(60⋅n)=(10^6 ⋅1⋅(173000/6157)^3)/(60⋅2900)=127500 ч

[L_(10h) ]=87600<L_(10ah) =127500 ч

Полученный ресурс меньше , поэтому данный подшипник нельзя применить в насосе.

9.2 Расчет гидростатодинамического подшипника

Диаметр вала d=252 мм

Ширина буртика l=477 мм

Длинна дросселя l_1 =39 мм

Зазор радиальный δ_1 =1 мм

Радиальная нагрузка P_1 =400 Н = 40 кгс

Подшипник питается натрием под давлением, создаваемым рабочим колесом насоса. Напор на выходе из рабочего колеса насоса равен 90 м. ст. Na. Температура натрия при номинальном режиме равна 300 ⁰С, при этом натрий имеет следующие физические свойства [9]:

ρ=845 (кгс)/(м^3)

λ=59,1 (ккал)/(м⋅час⋅°С)

C_p =0,304 (ккал)/(кгс⋅°С)

v=30,68⋅10^(-8) (м^2)/с

Удельная нагрузка:

p_m =(F_R)/(l∙d)=40/(47,7∙25,2)=0,03 (кгс)/(см^2)

Определение потерь напора по трассе питания подшипника от рабочего колеса до дросселя:

1.Вход в канал и выход из канала до дросселя:

ξ_1 =0,5+0,6=1,1

2. 2 плавный поворота на 90⁰ с соотношением d/r≈0,7 [10]:

ξ_2 =0,5

3.Трение:

Длина канала до дросселя:

l=740 мм

Диаметр сверления:

d=30 мм

Коэффициент трения:

λ=0,03

ξ_3 =λ⋅l/d=0,03⋅740/30=1,179

Суммарный коэффициент сопротивления:

ξ=1,1+0,5+1,179=2,679

Принимаем расход натрия на питание подшипника:

Q=42(м^3)/ч=0,012 (м^3)/с

Площадь сверления:

f=0,785⋅d^2 =0,785⋅(30/1000)^2 =0,000706 м^2

Скорость потока в сверлении:

V=Q/f=(0,012)/(0,000706)=16,51 м/с

Потери напора:

ΔH=ξ⋅(V^2)/(2⋅g)=2,679⋅(16,51^2)/(19,6)=31,04 м

Принимаем ΔH = 31 м. Тогда в камере перед дросселем будет напор равный 59 м.

Коэффициент динамической вязкости смазки:

μ_(cp) =0,912⋅10^(-4) Па⋅с

Число камер:

П=12

Для П = 12 по графикам значений [8, с.275] находим, что:

Коэффициент грузоподъемности в направлении на перемычку:

θ_1 =0,15

В направлении на рабочую поверхность:

θ_2 =0,21

Коэффициент, характеризующий отношение сопротивления щели к сопротивлению дросселя:

t_(опт) =0,028

Оптимальный диаметр дросселя определяем из уравнения:

t_(опт) =(1,5+λ⋅l/(2⋅δ_1))/(1,5+(l_1)/(d_1))⋅((π⋅(d_1^2)/4)/((4⋅π⋅ν⋅δ_1)/(n⋅D)))^2 =(1,5+0,03⋅740/(2⋅1))/(1,5+39/(d_1))⋅9⋅10^(-6) ⋅d_1^4 =

=(7,789⋅10^(-5))/(1,5+39/(d_1))⋅d_1^4

Решая его получаем, что d_1 =7 мм

Определяем расход натрия через подшипник:

Q_1 =2⋅π⋅d⋅δ_1 ⋅√((2⋅g⋅H)/((1,5+0,03l/(δ_1))⋅(1+1/(t_(опт)))))=

=2⋅π⋅0,30⋅0,001⋅√((19,6⋅59)/((1,5+0,03⋅(0,740)/(0,001))⋅(1+1/(0,028))))=0,001 м/с^3

Максимальная грузоподъемность подшипника при направлении силы «на перемычку»

G_1 =θ_1 ⋅ρ⋅H⋅d⋅l=0,15⋅844⋅59⋅0,007⋅0,477=898 кг

Рабочий эксцентриситет

При рабочей нагрузке P_1 =400 Н=40 кгс требуемый коэффициент грузоподъемности

θ=(P_1)/(ρ⋅H⋅d⋅l)=40/(881⋅44⋅0,45⋅0,477)=0,15

Таким коэффициентам грузоподъемности при действии силы «на перемычку» соответствуют относительные эксцентриситеты:

χ=0,7

Зазор между валом и втулкой:

h=(1-χ_1 )⋅δ_1 =(1-0,7)⋅1=0,3 мм

Тепловыделение от трения:

Q_f =9,86∙d^3 ∙l∙(μ_(cp))/(2δ)∙(2∙π∙n)/60∙[1+λ_К ∙v_к ((4δ)/(h_к)-1)]≈1,1 кВт

10. Расчет выбранной прокладки главного разъема [8]

Главный разъем уплотняется усиковым швом, который в случае демонтажа срезается.

Предварительный расчёт числа шпилек

Определение усилий, действующих на шпильки

Давление среды в корпусе насоса, кгс/см2:

p=2

Диаметр по сварке, см:

D_с =120

Усилие от давления среды по диаметру сварки в рабочих условиях, кгс:

P_(дс) =p⋅(πD_с^2)/4=22620

Усилие начальной затяжки шпилек, кгс:

P_0 =1,2P_(дс) =27140

Давление, создаваемое действием среды по диаметру сварки при гидроиспытаниях, кгс/см2:

p_(гид) =1,25p=2,5

Усилие от давления среды по диаметру сварки при гидроиспытаниях, кгс:

P_(гид) =p_(гид) ⋅(πD_с^2)/4=27145

Определение усилий, действующих на шпильки. Принимаем тепловое усилие:

P_t =0 .

Коэффициент внешней нагрузки:

x=0,15

Усилие, действующее на шпильки при начальной затяжке, кгс:

P_Б =P_0 =27140

Усилие, действующее на шпильки в рабочих условиях, кгс:

P_Б =P_0 +xP_(дс) =27148

Усилие, действующее на шпильки при гидроиспытаниях, кгс:

P_Б =P_0 +xP_(гид) =31214

Предел текучести материала шпильки (Ст. 20 ГОСТ 1050-88 М42), кгс/см2:

[σ]=2500

Максимальное усилие, действующее на шпильку, кгс:

P_Б^(max) =max(P_Б , P_0 )=31214

Наименьший диаметр шпильки, см:

d=4

Количество шпилек:

z=(4P_Б^(max))/(σπd^2)=9,94

Принимаем z=10 .

Определение температурного усилия P_t , кгс.

Определение податливости соединения.

Податливость шпильки, см/кгс:

λ_δ =4/(πE_ф Z)(((h_1)/3+h_2 +h_3 +(h_5)/3)/(d_(ср1)^2 -d_(ср0)^2)+(h_4)/(d_(ср2)^2 -d_(ср0)^2))=

=4/(π⋅1,82⋅10⋅10^6)(((2,9)/3+0,7+4,3+(10,9)/3)/(4,2^2 -1^2)+(23,9)/(4^2 -1^2))=1,166⋅10^(-7)

Податливость свободного фланца на изгиб, см/кгс:

λ_ф^(из) =0,48((D_б -D_(бн) +(D_(бн) -D_(бв))/3)^2)/(E_ф h^3 ln((D_(нф))/(D_(вф))))=0,48((130-116+(116-109)/3)^2)/(1,98⋅10^6 13,5^3 ln((141,6)/109))=

=6,691⋅10^(-9)

Податливость гайки, см/кгс:

λ_г =(4l_г)/(πE_г Z)(1/((d_3^2 -d_2^2 )))=(4⋅2,9)/(π⋅1,82⋅10⋅10^6)(1/((7,7^2 -4,2^2 )))=4,871⋅10^(-9)

Податливость всех элементов соединения, см/кгс:

λ=1/(1-x)(λ_δ +λ_ф^(из) )=1,963⋅10^(-7)

Принимаем, что ни у одной детали соединения во время работы усилие не уменьшается. Разность температур между рабочей и монтажной для всех элементов, °С:

t_(фi) =50

Коэффициент температурного расширения, 1/К:

α=11,5⋅10^(-6)

P_t =(∑_(i=1)^n ∝_(фi) t_(фi) l_(фi) -∑_(i=1)^n ∝_(bi) t_(bi) l_(bi))/(∑_(i=1)^m λ_t)=11,5⋅10^(-6) ⋅50((13,5+15,68)/(1,18⋅10^(-6)))=85470

Окончательный расчёт числа шпилек

Начальная затяжка, кгс:

P_Б =P_0 =27140

Усилие, действующее на шпильки в рабочих условиях, кгс:

P_Б =P_0 +xP_(дс) +P_t =116025

Усилие, действующее на шпильки при гидроиспытаниях, кгс:

P_Б =P_0 +xP_(гид) =31214

Определение усилий, действующих на уплотнительные поверхности.

Усилие, действующее на шпильки при начальной затяжке, кгс:

P_(пр) =P_0 =27140

Усилие, действующее на уплотнительные поверхности в рабочих условиях, кгс:

P_(пр) =P_0 -(1-x)P_(дс) +P_t =93380

Усилие, действующее на уплотнительные поверхности при гидроиспытаниях, кгс:

P_(пр) =P_0 -(1-x)P_(гид) =7917

Определение числа шпилек.

Максимальное усилие, действующее на шпильку, кгс:

P_(пр)^(max) =max(P_Б , P_0 )=116025

z=(4P_(пр)^(max))/(σπd^2)=13,26

Окончательно принимаем:

z=14

Эскиз разъемного соединения с размерами показан на рисунке 10.1.

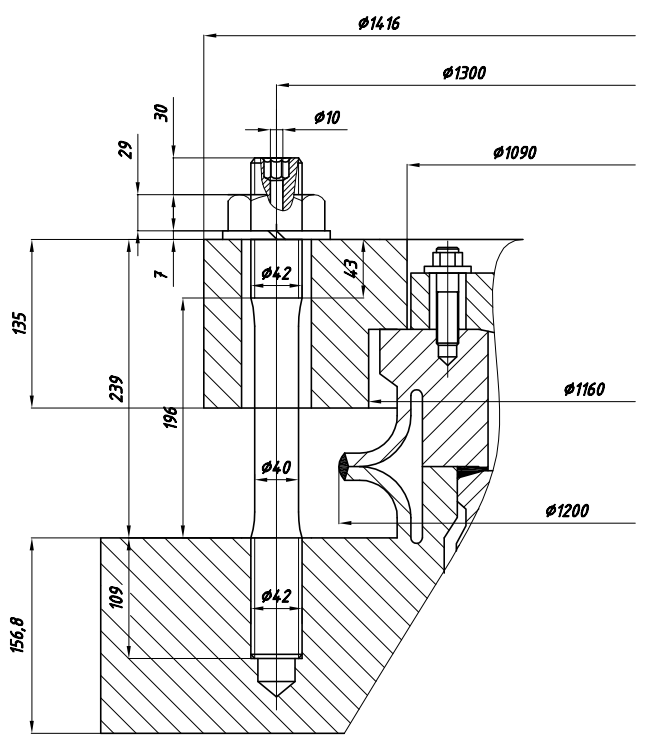
[picture p37: figure]

Рисунок 10.1. Эскиз главного разъёма

11. Расчет шпонки под рабочим колесом

По расчётному диаметру вала D=61,2 мм под втулкой рабочего колеса выбираем шпонку призматическую 45x25x340 ГОСТ 23360-78.

Шпонка под рабочим колесом показана на рисунке 11.1

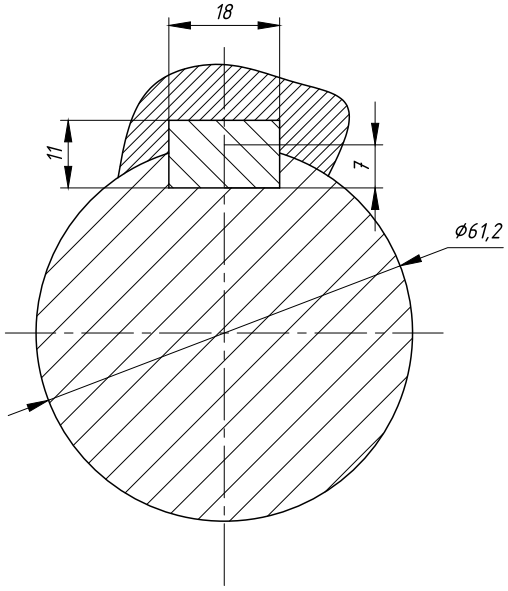
[picture p38: figure]

Рис. 11.1 Шпонки под рабочим колесом

Ширина шпонки b=18 мм

Высота шпонки h=11 мм

Длина шпонки l=68 мм

Глубина паза на валу t_1 =7мм

Глубина паза втулки t_2 =4,4 мм

M_(кр) =680 Н∙м

Рабочая длина шпонки:

l_(раб) =l-b=68-18=50

Площадь смятия:

F_(см) =(h-t_1 )∙l=(11-7)∙68=272 мм^2 =0,272∙10^(-3) м^2

Напряжения смятия:

σ_(см) =(2∙M_(кр))/(D∙F_(см))=(2∙680)/(0,0612∙0,272∙10^(-3))=81,7 МПа

Проверка условия прочности

При втулке, выполненной из стали 45 [σ]_(см) =130÷150 Примем [σ_(см) ]=140 МПа

σ_(см) =81,7 МПа<[σ_(см) ]=140 МПа

Условие прочности выполнено.

12. Список использованной литературы

1. Маргулова Т.Х. «Атомные электрические станции», М.: Высшая школа, 1978г
2. Будов В.М. «Насосы АЭС», Москва, Энергоатомиздат, 1986г
3. Митенков Ф.М., Новинский Э.Г., Будов В.М. «Главные циркуляционные насосы АЭС», Москва, Энергоатомиздат, 1990г
4. Новинский Э. Г. «Насосы и газодувные машины. Курс лекций», НГТУ, 2010г.
5. Алымов А.Г., Новинский Э.Г. «Гидравлический расчёт проточной части центробежных насосов для АЭУ», Нижний Новгород, 2015г
6. Лапшин Р.М. Расчёт проточной части центробежного насоса: Методические указания к курсовому и дипломному проектированию по дисциплине «Насосы и компрессоры ЯЭУ". Г.: ГПИ, 1988г
7. Воскресенский В.А., Дьяков В.И. «Расчёт и проектирование опор скольжения», Москва, Машиностроение, 1980г
8. Справочник по расчёту на прочность элементов конструкций энергетического оборудования. Под научной редакцией д.т.н. Митенкова Ф.М., Горький, 1975г
9. Андреев В.В., Ульянов А.А. «Детали машин и основы конструирования» Курсовое проектирование, Нижний Новгород, 2013г
10. Кириллов П.Л., Юрьев Ю.С., Бобков В.П. «Справочник по теплогидравлическим расчетам», Энергоатомиздат, 1990г.
11. Ломакин А. А. «Центробежные и осевые насосы» М.-Л.: Машиностроение, 1966г
12. Дмитриев С.М., Хробостов А.Е. «Краткий курс теплообмена», НГТУ, Нижний Новгород, 2008г.
13. Андреев, Ульянов «Детали машин и основы конструирования» Курсовое проектирование, Н. Новгород, НГТУ, 2010г.
14. Волошилин С.А. «Реактор на быстрых нейтронах БОР – 60», Государственный научный центр – Научно-исследовательский институт атомных реакторов, Димитровград, http://www.niiar.ru/?q=node/101

Приложение А. Результаты программы MathCad «Расчет геометрии рабочего колеса»

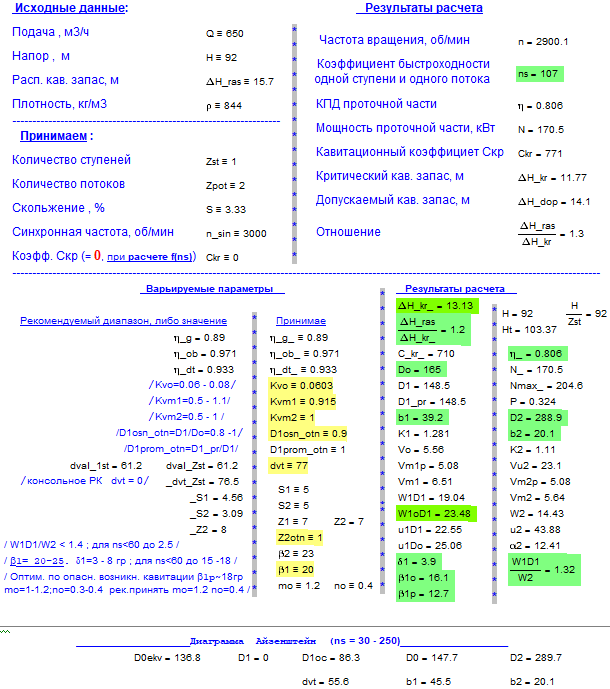
[picture p39: figure]

Приложение Б. Результаты программы MathCad «Профилирование лопастей рабочего колеса»

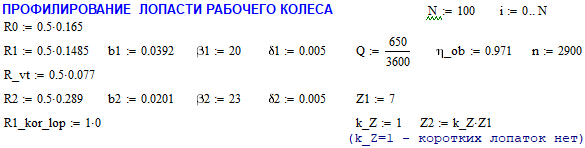
[picture p40: figure]
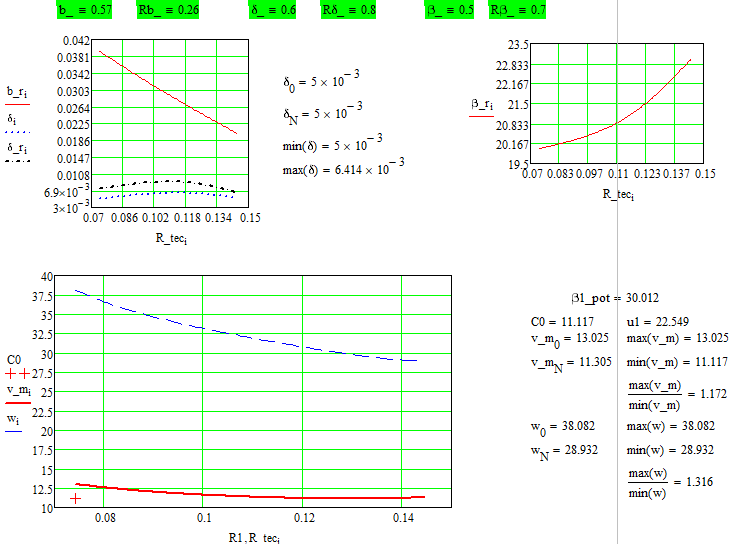
[picture p41: figure]
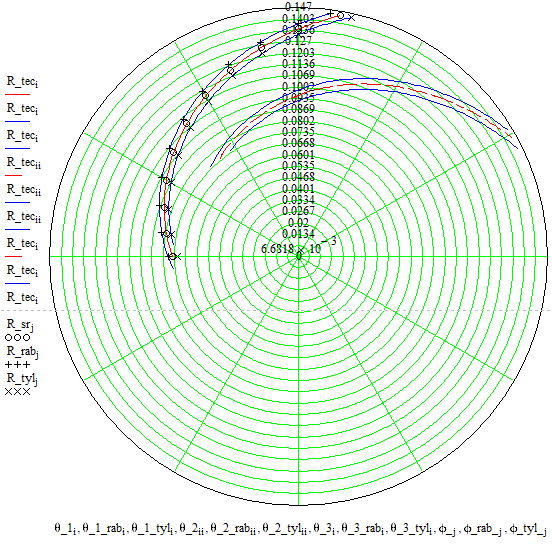
[picture p42: figure]
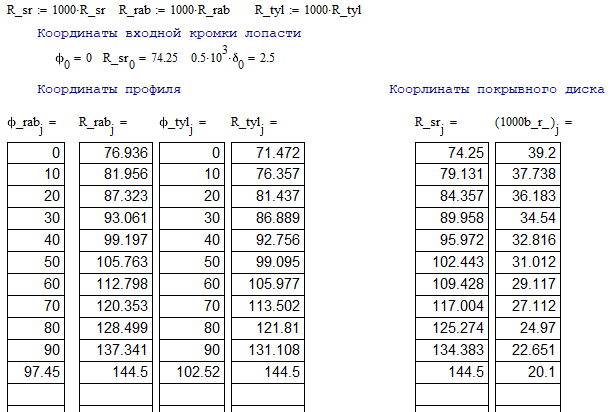
[picture p43: figure]

Изм. Лист № докум. Подпись Дата Лист 24 КП–ИЯЭиТФ–14.05.02-(С17-АЭ)–17–2020-ПЗ
