itstajiri/main/3kurs/Nasosi/Доки/Содержание 2.docx

Чертёжная документация:

1. Чертеж рабочего колеса
2. Спецификация
3. Сборочный чертёж насосного агрегата ЦНН-1

Изм. Лист № докум. Подпись Дата Лист 4 КП-ИЯЭиТФ-С17-АЭ-19-20-ПЗ
