itstajiri/main/3kurs/Nasosi/Доки/Титульник.docx

НИЖЕГОРОДСКИЙ ГОСУДАРСТВЕННЫЙ ТЕХНИЧЕСКИЙ УНИВЕРСИТЕТ им. Р.Е.АЛЕКСЕЕВА

ИНСТИТУТ ЯДЕРНОЙ ЭНЕРГЕТИКИ И ТЕХНИЧЕСКОЙ ФИЗИКИ ИМ.АКАД. Ф.М.МИТЕНКОВА

ПОЯСНИТЕЛЬНАЯ ЗАПИСКА

к курсовому проекту

Рязанова Алексея Владимировича

(фамилия, имя, отчество)

Факультет ИЯЭиТФ

Кафедра АТС

Группа С17-АЭ

Дата защиты "____"______________________2020 г.
| Индекс

Изм. Лист № докум. Подпись Дата Лист КР–АЭС–НГТУ–15АЭ-000-17
