itstajiri/main/3kurs/Nasosi/Одобрено/Задание 2. Рязанов А.В. С17-АЭ. ЦНН-1. Профилирование лопасти рабочего колеса.docx

Рязанов Алексей, С17-АЭ

Снимок экрана из программы Mathcad – профилирование лопасти рабочего колеса

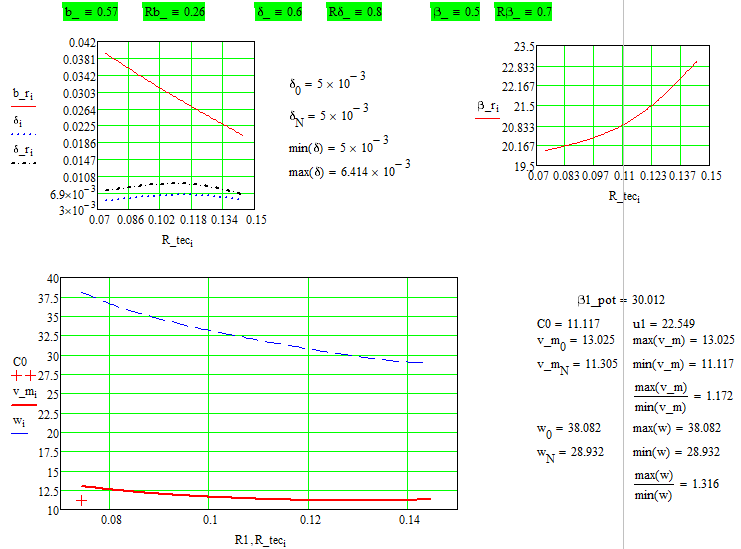
[picture p54: figure]
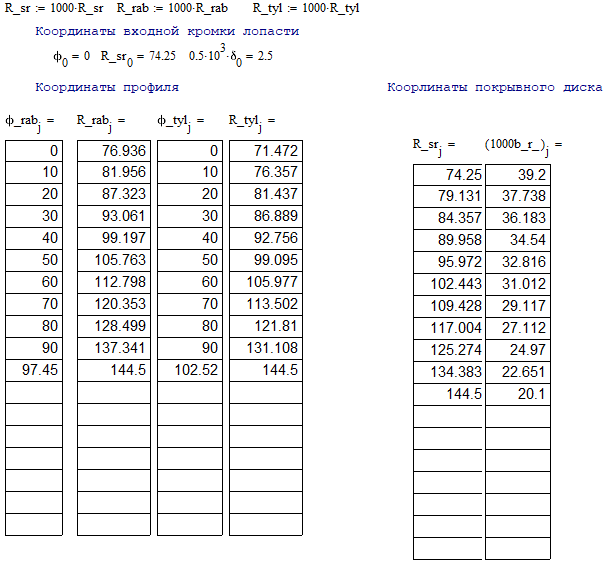
[picture p55: figure]
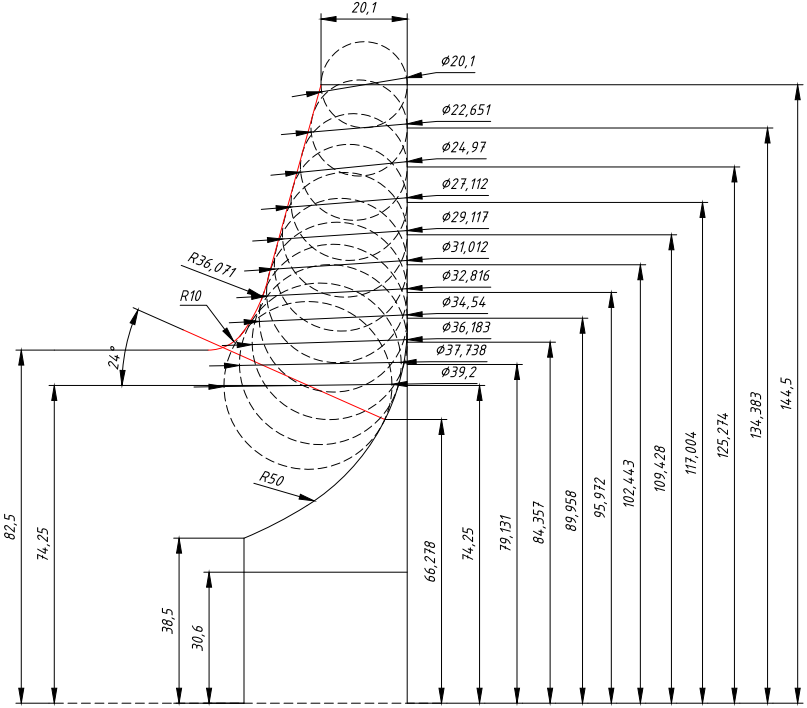
[picture p56: figure]
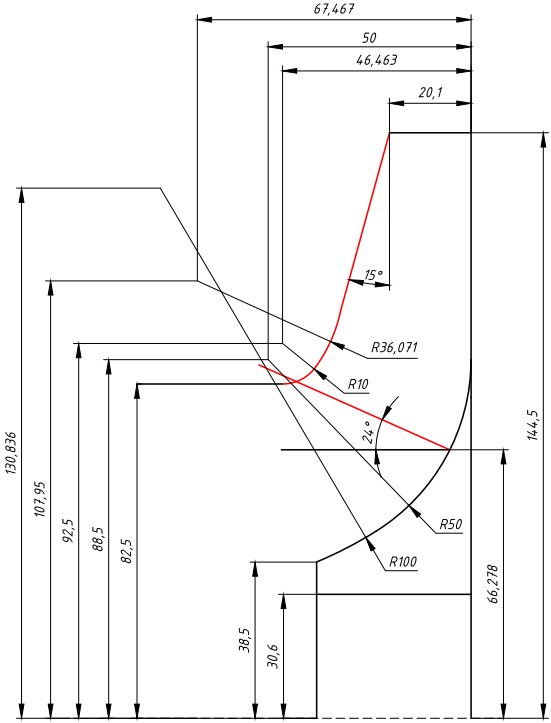
[picture p57: figure]
