itstajiri/main/3kurs/Nasosi/Замечания/Задание 2/Замечание2 Рязанов.docx

Замечание2 Рязанов

1. Осталось одно. Простановка размеров центров окружностей.
- R50 д.б. два размера. Размер 74.25 – Вы ошиблись. Прошу разобраться. Эта линия выполнена одним радиусом?
- Для R10 и R36.071 указать размер для центров окружности.
