itstajiri/main/3kurs/Nasosi/Замечания/Задание 3/Замечания Рязанов.docx

Замечания Рязанов.

Для более точного наведения на резкость приведу несколько Ваших.

- D3 –ошибка.
- Zна – ошибка.
- Нет эскизов отвода.
- Ошибки в построении входной кромки на чертеже.
- Ошибки при назначении шероховатости поверхностей.

Переговорите со старостой. Пусть поможет выбрать варианты без ошибок.

По чертежу смотрите замечания Романюка, Ефремова.
