itstajiri/main/3kurs/Nasosi/Помойка/Задание 1. Рязанов А.В. С17-АЭ. ЦНН-1. Расчет по курсовому проекту.pdf

Рязанов Алексей, С17-АЭ
1. Исходные данные
Исходные данные приведены в таблице 1.

Таблица 1 - Исходные данные
Наименование параметра | Значение
Подача Q, | 650
Напор H, м | 92
Давление на входе в насос P, МПа | 0,03
Температура натрия на входе в насос T, 0С | 450
Плотность натрия при данной температуре 450 оС ρ, кг/м³ | 844
Давление насыщенных паров натрия Pнп, Па | 164,4
2. Определим располагаемый кавитационный запас:
Располагаемый кавитационный запас определяется по формуле

∆ hрас=

Pс
ρ ∙g

+

v

2
2∙ g

−

Pнп
ρ ∙g
где: Рс = P + Ра – абсолютное статическое давление на входе в насос, Па Pнп – давление насыщенных паров, Па
v – скорость среды на входе в насос, м/с
Pс
ρ∙ g

+

v

2
2 ∙ g
- полная удельная энергия потока (Eвх) на входе в насос.

Т.к. на начальном этапе значение скоростей неизвестно, то опустим это слагаемое, в конечном итоге это допущение только лишь увеличит располагаемый кавитационный запас. Таким образом:

∆ hрас=

Pс−Pнп
ρ ∙ g

=

0,13∙ 10⁶−164,4
844 ∙9,81

=15,7 м

Тогда ∆ hрас=15,7 м. Расчет уточненного значения располагаемого кавитационного запаса будет проведен после расчета геометрии рабочего колеса насоса.

3. Выбор частоты вращения ротора
Расчет выполняется следующим образом.
3.1 Задаемся частотой вращения ротора. n=nsin ∙(
1−

S

100 )=3000 ∙(
1−

3,33

100 )=2900 об
мин

,где s=3,33%−скольжение.

3.2 Определяем коэффициент быстроходности.
Прошу обратить Ваше внимание на следующее: 0,181 это величина подачи Q переведенная из м

3

/ч в м³
/с, что требуется для расчета. Деление на 2 в следствии того, что я использую духпоточное рабочее колесо для уменьшения габаритов рабочего колеса и уменьшения ns .

ns=

3,65∙n∙√Q
H

0,75 =

3,65 ∙2900 ∙√
0,181
2
92⁰,75 =107

Тип рабочего колеса - центробежное нормальное.
3.3 Определяем кавитационный коэффициент быстроходности.
Кавитационный коэффициент быстроходности определяем по рис. 3.1 [1, стр.35]. Скр=771
3.4 Определяем критический кавитационный запас.

∆ hкр=10∙[
n∙√Q

Скр ]

4

3=10 ∙[
3000 ∙√
0,181
2

772 ]

4
3
=11,77 м

3.5 Определяем критический кавитационный запас. ∆ hдоп=1,2∙hкр=14,1 м
Результаты расчетов приведены в таблице 2.

Таблица 2 - Результаты расчетов
Наименование параметра | Значение
Частота вращения ротора синхронная nsin, об/мин | 3000 | 1500 | 1000
Частота вращения ротора n, об/мин | 2900 | 1450 | 970
Коэффициент быстроходности ns | 107 | 54 | 36
Кавитационный коэффициент быстроходности Скр | 772 | 686 | 657
Располагаемый кавитационный запас∆ hрас, м | 15,7 | 15,7 | 15,7
Критический кавитационный запас ∆ hкр, м | 11,8 | 5,5 | 3,4
Допускаемый кавитационный запас ∆ hдоп =1,2 Δhкр, м | 14,2 | 6,6 | 4,0

Кавитация отсутствует при условии Δhрас > Δhдоп. Это условие выполняется при частоте вращения ротора 3000, 1500, 1000 об/мин. Для дальнейших расчетов принимаем частоту вращения ns
= 3000 об/мин.
Данный вариант удовлетворяет большинству рекомендаций, соблюдаемых при проектировании насосов: ns=107 гарантирует, что насос будет компактный, что видно по значению размеров колеса на входе и выходе (D2 и D0) (см. снимок экрана из программы Mathcad); высокий КПД насоса - η≈ 81%; хорошие кавитационные свойства. Так же лопатки колеса имеют простую форму и не имеют пространственную кривизну, что удобно отобразить на 2D чертеже.
4. Определение размеров рабочего колеса с помощью диаграмм
Для выбранного варианта определяются размеры рабочего колеса насоса с помощью диаграмм на рис. 3.3 [1, стр.37]. По диаграмме выбираем коэффициенты в зависимости от коэффициента быстроходности. Согласно данным диаграммы все определяемые параметры являются функцией быстроходности насоса и могут быть рассчитаны по формуле:

X=KX

∙

√ H
n
где: Х – определяемый параметр;
KX – соответствующий параметру коэффициент на диаграмме; Н – напор насоса;
n – частота вращения ротора насоса.
Тогда

D0=K D0

∙

√ H
n

=44,6 ∙

√92
3000

=147,4 мм;

b1=Kb1

∙

√H
n

=13,8 ∙

√92
3000

=45,5 мм;

D2=K D2

∙

√ H
n

=87,6 ∙

√92
3000

=289,7 мм ;

b2=Kb1

∙

√H
n

=6,1∙

√92
3000

=20,1 мм ;

Полученные результаты приведены в таблице 3
Таблица 3 - Результаты расчетов по диаграммам
Значение коэффициента | KD0 = 44,6 | Kb1 = 13,8 | KD2 = 87,6 | Kb2 = 6,1
Размер колеса, мм | D0 = 147,4 | b1 = 45,5 | D2 = 289,7 | b2 = 20,1
5. Расчет мощности приточной части насоса
Мощность проточной части насоса определяется по формуле:

N=

ρ ∙Q ∙ H
102 ∙ η

=

844∙0,181 ∙ 92
102 ∙ 0,85

=162,1 кВт

где η ≈ 0,85 – КПД одноступенчатого насоса при ns=107 и подаче Q = 181 л/с, значение определено по графику на рис. 3.2 [1, стр.36].

Прошу обратить Ваше внимание на следующее, что дальнейшее уменьшение b2, через изменение Kvo, Kvm1, Kvm2 приводит к уменьшению b1. Но при данных значения были получены значения b1 и b2 близкие к значениям по диаграмме.
В случае со значением Dvt. Получил данное значение по формуле: Dvt=1,25 ∙ Dv
, где
Dv
– диаметр вала.
Снимок экрана из программы Mathcad – расчет габаритов колеса

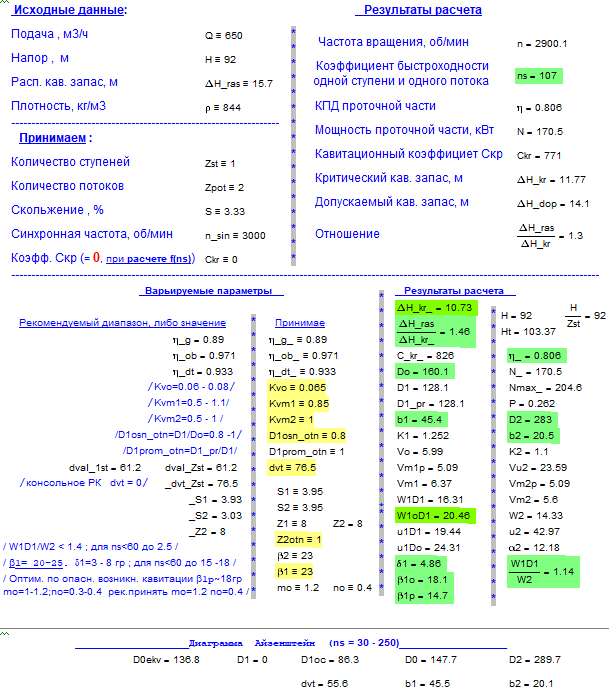
[picture p63: figure]
