itstajiri/main/3kurs/Nasosi/Доки/Пояснительная записка 1.pdf

НИЖЕГОРОДСКИЙ ГОСУДАРСТВЕННЫЙ ТЕХНИЧЕСКИЙ УНИВЕРСИТЕТ
им. Р.Е.АЛЕКСЕЕВА
ПОЯСНИТЕЛЬНАЯ ЗАПИСКА
к курсовому проекту
Рязанов Алексей Владимирович

(фамилия, имя, отчество)

Факультет ИЯЭиТФ
Кафедра | АТС
Группа | С17-АЭ
Дата защиты "____"______________________2020 г.

Индекс

2

МИНОБРНАУКИ РОССИИ
Федеральное государственное бюджетное образовательное учреждение высшего профессионального образования НИЖЕГОРОДСКИЙ ГОСУДАРСТВЕННЫЙ ТЕХНИЧЕСКИЙ УНИВЕРСИТЕТ им. Р.Е.АЛЕКСЕЕВА

Образовательно-научный институт ядерной энергетики и технической физики им. академика Ф.М. Митенкова

Кафедра АТС

## Спроектировать насос по заданию

( наименование проекта )

ПОЯСНИТЕЛЬНАЯ ЗАПИСКА
к курсовому проекту
КОНСУЛЬТАНТЫ: | РУКОВОДИТЕЛЬ
1. По проточной части | Новинский Э.Г.
(подпись) | (фамилия, и., о.)
_____________ | Алымов А.Г | _____________
(подпись) | (фамилия, и., о.) | (дата)
____________
(дата)

СТУДЕНТ

2. По расчёту основных узлов | ________________ | Рязанов А.В.
(подпись) | (фамилия, и., о.)
______________ | _____________
(подпись) | (фамилия, и., о.) | (дата)
_____________
(дата) | Группа С17-АЭ
3. По ____________________________
________________ ____________ | Работа защищена ______________
(подпись) | (фамилия, и., о.) | (дата)
______________
(дата) | Протокол № ________________
РЕЦЕНЗЕНТ | С оценкой | ________
__________________ | ______________
(подпись) | (фамилия, и., о.
______________
(дата)
2020 г.

Подпись и дата Инв.№ дубл. Подпись и дата Взам.инв.№ Инв.№ подл.

Содержание

3. Расчет рабочего колеса с профилирование лопастей и меридианного сечения.. 20

3.5 Расчет геометрии рабочего колеса и параметров потока по программе

MathCad |

22

Чертёжная документация:

1. Сборочный чертёж насосного агрегата ЦНН-1
2. Чертеж рабочего колеса

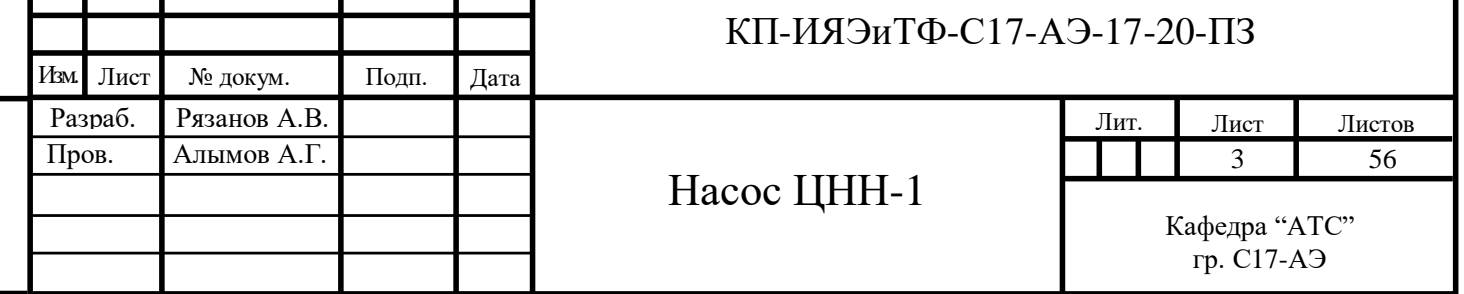
[picture p89: figure]
Изм.; Лист; № докум.; Подп.; Дата; КП-ИЯЭиТФ-С17-АЭ-17-20-ПЗ; Разраб.; Рязанов А.В.; Лит.; Листов; Насос ЦНН-1; Кафедра “АТС” гр. С17-АЭ; Пров.; Алымов А.Г.

Изм. | Лист | № докум. | Подпись | Дата

Лист
4

КП–ИЯЭиТФ–С17-АЭ–17–20

### 1. Введение

Быстрый опытный реактор БОР-60 является уникальной многоцелевой установкой,

на которой проводятся испытания конструкционных, топливных и поглощающих

материалов, используемых и предполагаемых к использованию в различных типах

ядерных реакторов, в том числе термоядерных реакторов. Для быстрых реакторов

дополнительно проводятся испытания отдельных узлов оборудования первого и второго

контуров.

Проведение реакторных испытаний обеспечивается размещением в активной зоне

до 12 облучательных устройств с конструкционными материалами. Количество

размещаемых экспериментальных ТВС с перспективными топливными композициями в

активной зоне и облучательных устройств с конструкционными материалами в боковом

экране практически не регламентируется.

Проводимые испытания реакторных материалов охватывают практически весь

спектр существующих и разрабатываемых типов реакторов от быстрых (БН-800, БН-1800,

«БРЕСТ», СВБР) и тепловых (АЭС-2006, ВВЭР-1500, ГТ-МГР, ВТГР) до термоядерных

(ИТЭР) и реакторов специального назначения.

Основные технические характеристики реактора БОР-60 [14]

Физические характеристики

Максимальная тепловая мощность | 60 МВт
Электрическая мощность | 12 МВт

Активная зона:

высота | 450 мм

Конструкция топливного стержня:

диаметр оболочки | 6х0.3 мм
длина | 1100 мм

высота:

верхнего отражателя | 100 мм

5

КП–ИЯЭиТФ–С17-АЭ–17–20

активной зоны | 450 мм
нижнего отражателя | 150 мм
нижнего газового объема | 300 мм
Топливо: | UO2 - PuO2
обогащение по 235U | 45 ÷ 90 %

Нейтронные характеристики

Максимальная плотность потока быстрых нейтронов | 3,7·1019 м-2с-1
Средняя энергия нейтронов | 380 кэВ
Годовой флюенс нейтронов | до 5·1022 см-2
Скорость накопления повреждающей дозы | до 25 сна /год
Максимальная скорость выгорания топлива | до 6% /год
Мощностной коэффициент реактивности | -(6,4 ± 0,9)·10-5

Температурные характеристики

Максимальная плотность теплового потока | 1,1 МВт/л
Осевая неравномерность тепловыделения | 1,15
Теплоноситель: | натрий
расход через реактор | 1100 м3/час
давление | 5,5 МПа
температура на входе в реактор | до 330 оС
температура на выходе из реактора | до 530 оС

Режим работы реактора

Продолжительность микрокампании | 90 ÷ 120 суток
Время между микрокампаниями | 45 суток

6


КП–ИЯЭиТФ–С17-АЭ–17–20

На рисунке 1 представлена схема реакторной установки БОР-60

1– входной патрубок; 2 – тепловая и нейтронная защита корпуса реактора; 3 –

активная зона; 4 - выходной патрубок; 5 – корпус; 6 – управляющий стержень; 7 –

перегрузочный канал; 8, 9 – большая и малая защитные поворотные пробки.

Рис.1 – Схема реактора БОР-60 [5]

Независимо от типа используемых реакторов и схемных особенностей ядерных

установок одним из обязательных для ЯЭУ видов оборудования являются насосы.

Насосы обеспечивают циркуляцию теплоносителя в реакторе (первый контур),

парогенераторах (второй контур) и вспомогательных контурах. Надежность эксплуатации

реактора, его работоспособность в нормальных, переходных и аварийных режимах,

работоспособность вспомогательного охлаждаемого оборудования непосредственно

зависят от наличия циркуляции теплоносителя и других охлаждающих сред, т.е. от

работоспособности насосов и соответствующих контуров.

При создании насосов для АЭС руководствуются общей теорией центробежных и

осевых насосов, теорией подшипниковых опор, опытом создания и эксплуатации насосов

различного типа и назначения.

7

КП–ИЯЭиТФ–С17-АЭ–17–20

При создании насосов для АЭС руководствуются общей теорией центробежных и

осевых насосов, теорией подшипниковых опор, опытом создания и эксплуатации насосов

различного типа и назначения.

Различие в конфигурации первого контура определяет основные конструкционные

особенности реакторов на быстрых нейтронах. Для петлевого варианта характерны

наличие собственных корпусов у каждого из трех элементов и связь между ними с

помощью трубопроводов.

В настоящее время в построенных и проектируемых установках с быстрыми

реакторами в основных контурах используются механические центробежные насосы.

Во вспомогательных контурах, а также в стендовых установках применяются также

электромагнитные насосы. Они позволяют обеспечить герметизацию циркуляционного

тракта без применения каких-либо вращающихся частей.

Механические | насосы | для | перекачки | натрия | должны | иметь | надежно

герметизированную от окружающей атмосферы внутреннюю полость. Устройства для

герметизации должны надежно удерживать нейтральный газ под небольшим давлением.

Поскольку | в | качестве | привода | насоса | наиболее | целесообразно | применять

электродвигатели нормального исполнения, для герметизации рабочей полости насос

должен иметь устройство, позволяющее без нарушения герметичности вывести вал насоса

в окружающую атмосферу для соединения с валом привода. В качестве такого устройства

применяется торцевое уплотнение. Можно выполнить насос без торцевого уплотнения по

схеме с герметичным электродвигателем, но при этом возникают довольно сложные

проблемы защиты двигателя от попадания паров натрия, усложняется конструкция

электродвигателя, можно использовать только асинхронные двигатели (без коллекторов и

щеток). Поэтому схема насоса с торцевым уплотнением является более рациональной.

Механические насосы с торцевым уплотнением вала могут быть выполнены

погружными с одним или двумя гидростатическими подшипниками и с протечками через

щелевое уплотнение вала.

В погружных насосах противокавитационный подпор на колесе создается за счет

суммы гидростатического давления столба натрия над колесом и давления газа в полости

насоса.

В насосах со щелевым уплотнением вала подпор на колесе равен перепаду

давления на щелевом уплотнении. Рассмотрим в данной работе насос реактора БОР-60

ЦНН-1.

Основные характеристики натриевого насоса первого и второго контуров реактора

БОР-60 [6]:

8

КП–ИЯЭиТФ–С17-АЭ–17–20

Таблица 1- Характеристики первого контура

Параметр | БОР-60 (СССР)
Тип насоса | Механический со свободной поверхностью натрия и подушкой инертного газа
Число агрегатов | 2
Подача, м3/ч | 830
Напор, м | 60
Температура перекачиваемой жидкости, ⁰С | 500
Частота вращения (номинальная), об/мин | 1500
Мощность приводного электродвигателя, КВт | 220
Регулирование частоты вращения | «Система Леонардо»
Диапазон регулирования частоты вращения, % | 20-100
КПД агрегата, % | 71
Давление газовой подушки, МПа | 0,05
Марка стали | 08Х18H9
Тип уплотнения | Механическое по валу
Масса агрегата, т | 31

Таблица 2- Характеристики второго контура

Параметр | БОР-60 (СССР)
Тип насоса | Механический со свободной поверхностью натрия и подушкой инертного газа
Число агрегатов | 2
Подача, м3/ч | 600
Напор, м | 85
Температура перекачиваемой жидкости, 0С | 500
Частота вращения (номинальная), об/мин | 1500
Мощность приводного электродвигателя, КВт | 250
Регулирование | «Система Леонардо»
Диапазон регулирования частоты вращения, % | 20-100

9

КП–ИЯЭиТФ–С17-АЭ–17–20

Параметр | БОР-60 (СССР)
КПД агрегата, % | 71
Давление газовой подушки, МПа | 0,01-0,05
Марка стали | 08Х18H9
Тип уплотнения | Механическое по валу
Масса агрегата, т | 69,5

Таблица 2.2 – Материалы основных деталей спроектированного насоса

Рабочее колесо | Вал насоса | Корпус насоса (бак) | Направляющий аппарат | Рама опорная под корпус и проставка под электродвигателем (при наличии)
10Х18Н 12М3Л | Х18Н9 | Х18Н9 | 1Х18Н12М3Л | 20Х13

10 КП–ИЯЭиТФ–С17-АЭ–17–20

### 2. Описание конструкции насоса

Насос реактора БОР-60 выполнен по схеме погружного заглубленного насоса

колодцевого типа с нижним гидростатическим подшипником, работающим на натрии от

напора собственного рабочего колеса (рис. 2.1).

Верхний радиально-осевой подшипниковый узел расположен в газовой полости

насоса. Насос состоит из бака, выемной части и приводного электродвигателя. Выемная

часть демонтируется из бака без резки основных трубопроводов. Бак представляет собой

цилиндрический сосуд с переменной толщиной стенки для обеспечения равномерной

жесткости. В нижней части бака имеются два патрубка: радиальный (всасывающий) и

осевой (нагнетательный), к которым привариваются соответствующие трубопроводы.

Выемная часть устанавливается в бак и крепится к нему с помощью фланца.

Герметичность разъема обеспечивается «усиковым» сварным швом.

Выемная (рис. 2.2) часть содержит проточную часть с рабочим колесом, канальным

направляющим аппаратом открытого типа со сборно-кольцевым отводом и всасывающим

колоколом. Натрий от сборного коллектора отводится четырьмя трубами диаметром 100

мм, объединяющимися в напорный патрубок по оси насоса.

Всасывание осуществляется | непосредственно | из | бака, причем перед самым
входом на рабочее колесо установлен профилированный | коллектор, дающий
равномерное | распределение скоростей, несмотря | на | боковой | вход потока | в бак.

Протечки из подшипника через переливные окна с малым сопротивлением сливаются на

всасывание. Поскольку насос заглубленный, то во время работы уровень в нем снижается

в соответствии с гидравлическим сопротивлением подводящей трассы.

Допустимое колебание уровня в насосе 2 м. В целях исключения захвата газа на

всасывании к выемной части насоса по наружному диаметру сборного коллектора

приварена юбка высотой 0,7 м, благодаря чему | обеспечивается | нормальная | работа
насоса | в | различных переходных режимах, когда | увеличивается сопротивление вса-

сывающего трубопровода и уровень в насосе падает ниже рабочего колеса. В выемной

сборке установлены кольцевые вытеснители, предназначенные для уменьшения объема

натрия в контуре. Бак насоса служит одновременно и компенсатором объема. Торцевое

уплотнение вала по газу (рис. 2.3) обеспечивает герметичность насоса относительно

внешней среды.

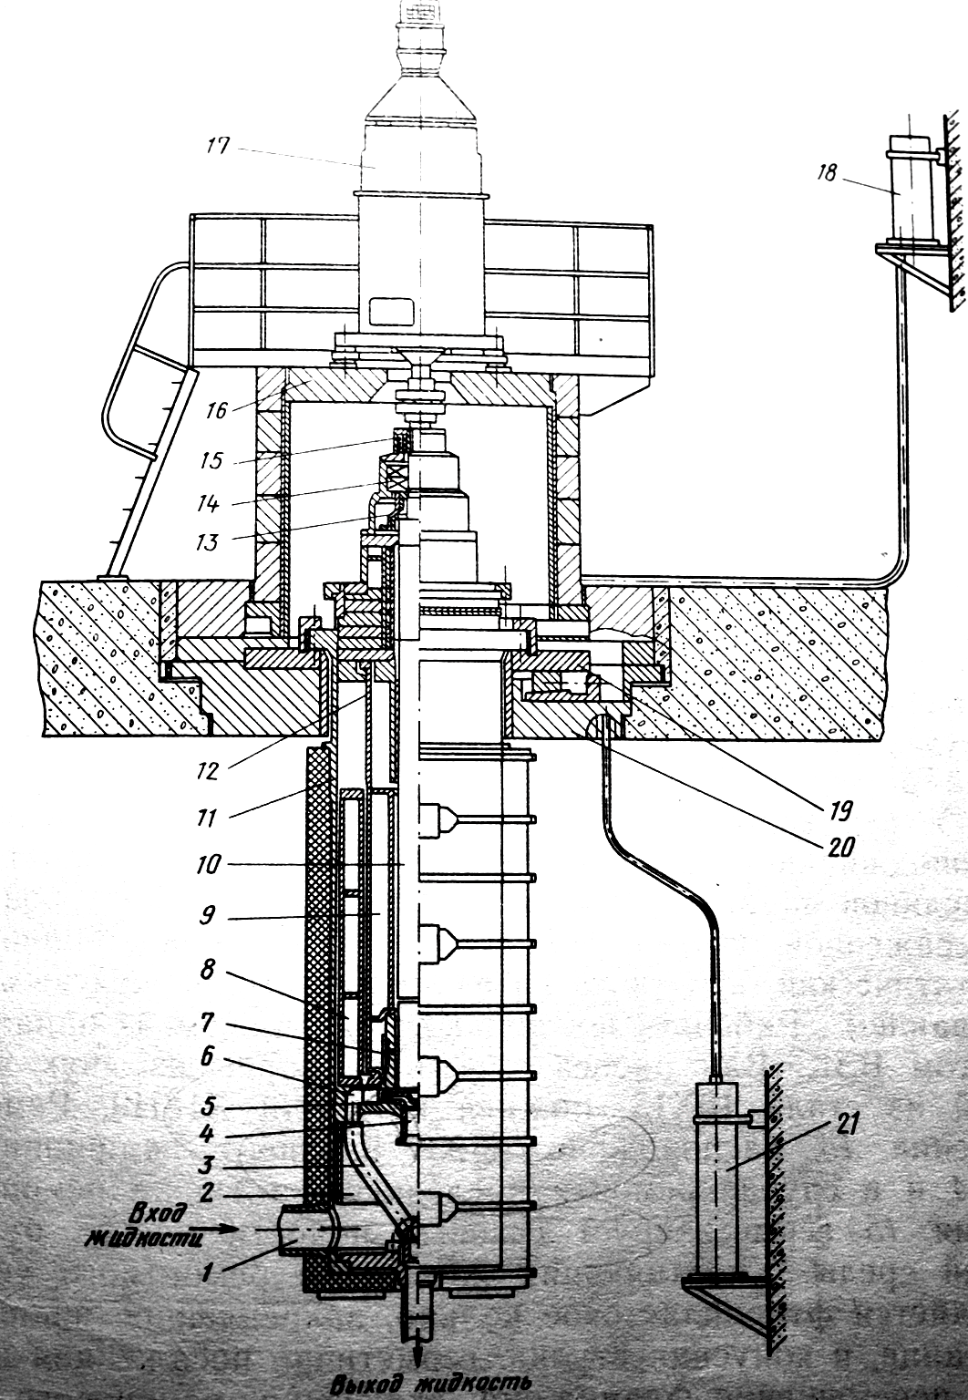
[picture p90: figure]

1-всасывающий патрубок; 2-юбка; 3-отводная труба; 4-всасывающий колокол;

5-рабочее колесо; 6-направляющий аппарат; 7-гидростатический подшипник;

8,9-вытеснители; 10-вал; 11-бак; 12-выемная часть; 13-стояночное уплотнение; 14-

верхний подшипниковый узел; 15-уплотнение вала; 16-плита; 17-электродвигатель; 18-

напорный маслобак; 19-плита; 20-перекрытие; 21-бак слива протечек; 22-

нагнетательный патрубок

Рис. 2.1. - Схема насоса реактора БОР-60

Верхний подшипниковый узел состоит из несущего корпуса, системы смазки,

включающей в себя масляный насос и масляную ванну со встроенным в нее

холодильником, и радиально-осевого сдвоенного шарикоподшипника.

Рис. 2.2. - Выемная часть насоса


А- газовая полость; Б- масляная полость; В –атмосфера;

1,7-нижний и верхний несущие фланцы; 2-диафрагма; 3-холодильник;

4-вращающийся опорный диск; 5,9-верхнее и нижнее подвижные кольца;

6,10-верхнее и нижнее неподвижные кольца; 8-корпус

Рис. 2.3. Уплотнение вала по газу [2]

Система смазки подшипника замкнута внутри масляной ванны. Масло из ванны

подается винтовой втулкой, посаженной на вал. Нижний радиальный подшипник —

гидростатический, камерный с взаимообратным щелевым дросселированием. Рабочие

поверхности подшипника наплавлены стеллитом ВЗК. Материал пар трения: графит

2П-1000 (неподвижное кольцо)— азотированная сталь 38ХМЮА (кольцо, вращающееся с

валом). Сталь азотирована на глубину от 0.4 до 0.6 мм с твердостью верхнего слоя HRC =

56.

Поверхность графитовых колец, кроме плоскости контакта, омеднена с

последующим лужением в целях исключения утечки масла через поры графита. Удельная

нагрузка на пару трения составляет 0,25 МПа. Промежуточная камера между парами

трения заполняется маслом, образующим масляный затвор, препятствующий выходу газа

из корпуса насоса. Суммарные протечки масла через обе трущиеся поверхности не

превышают 30 см3/ч.

Вал насоса — полый, сварен из двух частей: верхней из стали 10X13, нижней

из | стали | Х18Н9. | Стояночное уплотнение (рис. 2.4) расположено | ниже | верхнего

подшипникового узла и в случае ремонта последнего, а также ремонта уплотнения

герметизирует | газовые | полости | насоса | от | окружающей среды. Эти уплотнения

являются обязательными для жидкометаллических насосов и очень редко встречаются в

конструкциях ГЦН для воды.

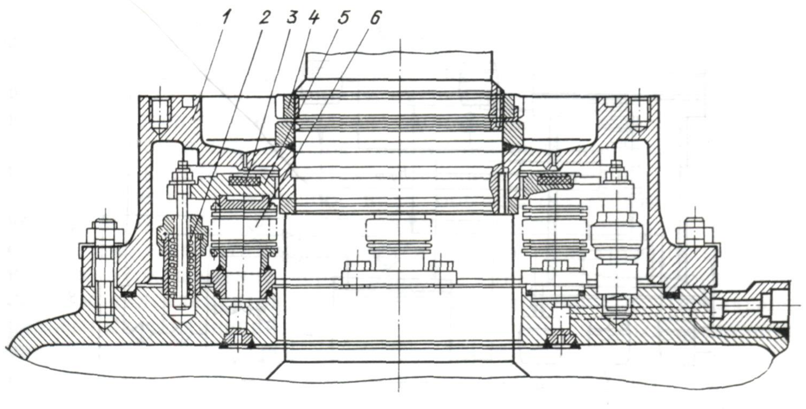
[picture p91: figure]

1-корпус; 2-пружина; 3-фторопластовое кольцо; 4-гайка; 5-фланец; 6-сильфон

Рис. 2.4. Схема стояночного уплотнения натриевого насоса [2,3]

Уплотняющим элементом стояночного уплотнения является фторопластовое

кольцо, закрепленное на подвижном фланце, и конусная втулка, герметично посаженная

на вал. Осевое перемещение фланца при включении стояночного уплотнения

осуществляется подачей газа во внутреннюю полость сильфона давлением от 0,6 до 1

МПа.

Верхний подшипниковый узел состоит из осевого и радиального подшипников.

Осевой подшипник типа Митчела с оптимальным расположением ребра качения,

нереверсивный, | состоит | из | подпятника | и | пяты. | Подпятник | имеет | семь

самоустанавливающихся сегментов, поверхность трения которых залита баббитом, а

опорой служит ребро качения. Нагрузка на подпятник передается через пяту, жестко

сидящую на валу насоса. Поверхность трения направляющего подшипника также залита

баббитом. Система смазки подшипников, циркуляционная с охлаждением и фильтрацией

масла, выполнена в виде маслоблока на общей фундаментной плите с расположенными на

ней циркуляционным баком с фильтром тонкой очистки, маслонасосами, холодильником,

фильтром грубой очистки, арматурой и трубопроводам.

На рисунке 2.5 представлен зарубежный аналог насоса реактора БОР-60-Насос

реактора Rapsodie (Франция).

Насосы первого контура центробежные, одноступенчатые, заглубленного типа,

установлены на «холодной» ветке циркуляционного контура петлевой компоновки. Вал

насоса вращается в двух подшипниках: нижнем-ГСП, верхнем - двойном роликовом

радиально-осевом. В качестве привода применен асинхронный электродвигатель в

герметичном | исполнении. | Всасывание | натрия | организовано | сверху | благодаря

перевернутому рабочему колесу. Пройдя рабочее колесо, натрий попадает в

направляющий аппарат и далее в напорный патрубок. В насос первого контура встроен

обратный клапан, который представляет собой поплавок с запирающим диском.

Уплотнение вала - двойное торцевое, с масляным гидрозатвором. Ремонт верхних узлов

осуществляется без разгерметизации контура. Для этой цели служит стояночное

уплотнение, состоящее из диска. герметично насаженного на вал и запрессованного в него

резинового кольца.

Насос второго контура представляет собой аналогичную конструкцию, за

исключением того, что по условиям работы в нем отсутствуют биологическая защита и

обратный клапан.

Рассмотрим гидростатический подшипник насосов реактора БОР-60 (рис. 2.6)

В этих подшипниках при увеличении частоты вращения вала грузоподъемность

возрастает в гораздо большей степени, чем в камерных.

При диаметре отверстия в дросселе 7 мм и частоте вращения вала 1500 об/мин его

грузоподъемность равнялась 19,6 кН. Подшипник работал без «сухого» трения и при 250

об/мин. Рабочие поверхности в корпусе были направлены электродом ЦН-6.

В | таблице | 3 | приведены | основные | данные | радиальных | подшипников

отечественного ГЦН с уплотнением вала.


1-обратный клапан; 2-рабочее колесо; 3-направляющий аппарат; 4-улитка; 5-

успокоительное кольцо; 6-горизонтальные успокоители; 7-внутренний антивихривой

цилиндр; 8-вертикальный успокоительный цилиндр; 9,12-минимальный и максимальный

уровни натрия соответственно; 10-уровнемер; 11-вал; 13,19-биологическая защита;14-

роликовый подшипник; 15-электродвигатель; 16-механическая муфта; 17-уплотнение

вала; 18-уплотняющее кольцо; 20-подвод газа для разогрева насоса; 21-напорный

патрубок

Рис. 2.5. Схема насоса реактора Rapsodie


1-дроссель; 2-напорный коллектор; 3-корпус подшипника; 4-рабочая поверхность

Рис. 2.6. Гидростатический подшипник насосов реактора БОР-60[2,3]

Таблица 3

Параметр | БОР-60
Первый контур | Второй контур
Тип нижнего радиального подшипника | ГСП с взаимообратным щелевым дросселированием
Рабочая среда | Натрий
Температура рабочей среды, оС | 450 | 500
Диаметр втулки вала, мм | 270 | 270
Радиальный зазор, мм | 0,3 | 0,3
Число рабочих камер | 16 | 16
Диаметр отверстия в дросселе, мм | - | -
Расход рабочей среды на подшипник, м3/ч | 42 | 40
Перепад давления на подшипнике, МПа | 0,51 | 0,51
Нагрузка на подшипник, кН | 7,6 | 7,6
Рабочий относительный эксцентриситет | 0,8 | 0,8

Параметр | БОР-60
Тип нижнего радиального подшипника | Первый контур | Второй контур
ГСП | с | взаимообратным | щелевым

дросселированием

Материал втулки вала | Сталь X18H9 с наплавкой ВЗК
Материал втулки в корпусе | Сталь X18H9 с наплавкой ВЗК и ЦН-6
Шероховатость рабочих поверхностей | 1.25-0,63

Подводящие устройства

Каналы, подводящие поток к лопастному колесу, оказывают значительное влияние

на работу ГЦН. Основная задача при расчете подводов сводится к обеспечению

минимальных потерь в проточной части патрубка и к снижению неблагоприятного

влияния патрубка на работу колеса, т.е. к получению равномерного поля скоростей на

входе в колесо.

Конструкция подвода должна обеспечить:

- минимальное гидравлическое сопротивление подвода;
- осесимметричный поток в выходном сечении подвода;
- минимальную закрутку потока;

-стабильность параметров потока на выходе из подвода.


1-всасывающий патрубок; 2-напорные патрубки; 3-бак

Рис. 2.7. Подводящий патрубок ГЦН реактора БОР-60 (ns =80)

Подвод для центробежного насоса с коэффициентом быстроходности ns=80

выполнен в виде бака, внутри которого установлены четыре напорных трубопровода (рис.

2.7).

Насосы для перекачивания жидкого металла снабжены системой электроразогрева

для обеспечения предварительного разогрева их корпусов перед заполнением, а также для

поддержания необходимой температуры металла внутри насоса. Температура внутри бака натриевых насосов должна быть в пределах 150—200 °С. Полезно иметь нагреватели и на

крышке насоса. Эти нагреватели позволяют перед пуском насоса расплавить натрий,

застывший в щелях между холодильником и валом насоса при его стоянке.

В качестве привода ГЦН в подавляющем большинстве случаев используется

электродвигатель. Насос второго контура в силу особенностей теплотехнической схемы

установки должны иметь плавное или ступенчатое регулирование частоты вращения.

Известны следующие приводы ГЦН с регулируемой частотой вращения,

применяемые в настоящее время в отечественной и зарубежной практике:

- асинхронный электродвигатель с изменением частоты вращения при помощи

электромагнитных муфт, гидромуфт и зубчатых редукторов;

- двигатель постоянного тока с регулированием напряжения в цепи якоря;
- асинхронный двигатель с фазным ротором и жидкостным реостатом в цепи

ротора;

- двухскоростной асинхронный электродвигатель;
- | синхронный | короткозамкнутый | электродвигатель | со | статическим

преобразователем частоты (вентильный привод);

- асинхронный электродвигатель с фазным ротором, работающим в системе

асинхронно-вентильного каскада (АВК).

Наиболее перспективными из перечисленных способов считаются последние три, и

именно они применяются в настоящее время на современных установках.

Насосы первого и второго контуров унифицированы по основным узлам и

различаются только размерами рабочего колеса и направляющего аппарата. Кроме того, в

насосе второго контура по условиям работы отсутствует биологическая защита.

### 3. Расчет рабочего колеса с профилирование лопастей и меридианного сечения

### 3.1 Исходные данные для расчета

Во время выполнения курсового проекта я произвел замену однопоточного колеса

оригинального насоса БОР-60, на двухпоточное.

Исходные данные приведены в таблице 4.

Таблица 4 - Исходные данные

Наименование параметра | Значение
Подача Q, | 650
Напор H, м | 92
Давление на входе в насос P, МПа | 0,03
Температура натрия на входе в насос T, 0С | 450
Плотность натрия при данной температуре 450 оС ρ, кг/м³ | 844
Давление насыщенных паров натрия Pнп, Па | 164,4

### 3.2. Определение располагаемого кавитационного запаса

Располагаемый кавитационный запас определяется по формуле

∆ℎрас =

Pс
ρ ∙ g

+

v

2
2 ∙ g

−

Pнп
ρ ∙ g

где: Рс = P + Ра – абсолютное статическое давление на входе в насос, Па

Pнп – давление насыщенных паров, Па

v – скорость среды на входе в насос, м/с

Pс
ρ∙g

+

v

2

2∙g

- полная удельная энергия потока (Eвх) на входе в насос.

Т.к. на начальном этапе значение скоростей неизвестно, то опустим это слагаемое,

в конечном итоге это допущение только лишь увеличит располагаемый кавитационный

запас. Таким образом:

∆ℎрас =

Pс − Pнп
ρ ∙ g

=

0,13 ∙ 10⁶ − 164,4
844 ∙ 9,81 | = 15,7 м
Тогда | ∆ℎрас = 15,7 м. Расчет уточненного значения располагаемого

кавитационного запаса будет проведен после расчета геометрии рабочего колеса насоса.

### 3.3 Выбор частоты вращения ротора

Расчет выполняется следующим образом.

3.3.1 Задаемся частотой вращения ротора.

n = nsin ∙ (1 −

S
100) = 3000 ∙ (1 −

3,33
100) = 2900

об
мин

,

где s = 3,33% − скольжение.

3.3.2 Определяем коэффициент быстроходности.

Рассматриваем вариант двухпоточного рабочего колеса.

ns =

3,65 ∙ n ∙ √Q
H⁰,75 =

3,65 ∙ 2900 ∙ √
650
3600 ∙ 2
92⁰,75 | = 107

Тип рабочего колеса - центробежное нормальное.

3.3.3 Определяем кавитационный коэффициент быстроходности.

Кавитационный коэффициент быстроходности определяем по рис. 3.1 [5, стр. 35]. Скр = 771

3.3.4 Определяем критический кавитационный запас.

∆ℎкр = 10 ∙ [

n ∙ √Q
Скр ]

4
3
= 10 ∙
[

3000 ∙ √
650
3600 ∙ 2
771
]

4
3

= 11,77 м

3.3.5 Определяем допускаемый кавитационный запас. ∆ℎдоп = 1,2 ∙ ℎкр = 14,1 м

Результаты расчетов приведены в таблице 5.

Таблица 5 - Результаты расчетов

Наименование параметра | Значение
Частота вращения ротора синхронная nsin, об/мин | 3000 | 1500 | 1000
Частота вращения ротора n, об/мин | 2900 | 1450 | 970
Коэффициент быстроходности ns | 107 | 54 | 36
Кавитационный коэффициент быстроходности Скр | 772 | 686 | 657
Располагаемый кавитационный запас∆ℎрас, м | 15,7 | 15,7 | 15,7
Критический кавитационный запас ∆ℎкр, м | 11,8 | 5,5 | 3,4
Допускаемый кавитационный запас ∆ℎдоп =1,2 Δhкр, м | 14,2 | 6,6 | 4,0

Кавитация отсутствует при условии Δhрас > Δhдоп. Для изготовления рабочего

колеса с лопастями одинарной кривизны коэффициент быстроходности должен быть

<130. Это условие выполняется при частоте вращения ротора 3000, 1500, 1000 об/мин. Для

дальнейшего проектирования принимаем вариант с наибольшей частотой вращения

ротора. Этот вариант будет иметь наименьшие габариты и высокий КПД насоса - η≈ 81%;

### 3.4 Определение размеров рабочего колеса с помощью диаграмм

Для выбранного варианта определяются размеры рабочего колеса насоса с

помощью диаграмм на рис. 3.3 [5, стр.37]. По диаграмме выбираем коэффициенты в

зависимости от коэффициента быстроходности. Согласно данным диаграммы все определяемые параметры являются функцией быстроходности насоса и могут быть

рассчитаны по формуле:

X = KX ∙

√H
n
где: Х – определяемый параметр;

KX – соответствующий параметру коэффициент на диаграмме;

Н – напор насоса;

n – частота вращения ротора насоса.

Тогда:

D0 = KD0

∙

√H
n

= 44,6 ∙

√92
3000 = 147,7 мм;

b1 = Kb1

∙

√H
n

= 13,8 ∙

√92
3000 = 45,5 мм;

D2 = KD2

∙

√H
n

= 87,6 ∙

√92
3000 = 289,7 мм;

b2 = Kb1

∙

√H
n

= 6,1 ∙

√92
3000 = 20,1 мм;

Полученные результаты приведены в таблице 6

Таблица 6 - Результаты расчетов по диаграммам

Значение коэффициента | KD0 = 44,6 | Kb1 = 13,8 | KD2 = 87,6 | Kb2 = 6,1
Размер колеса, мм | D0 = 147,7 | b1 = 45,5 | D2 = 289,7 | b2 = 20,1

### 3.5 Расчет геометрии рабочего колеса и параметров потока по программе

MathCad

Частота вращения вала:

n = nсин (1 −

S
100) = 3000 ∙ (1 −

3,33
100) = 2900

Подача ступени:

Qпот =

Q
3600 ∙ Zpot

=

650
3600 ∙ 2

= 0,09

Напор ступени:

Hст =

H
Zст

=

92
1

= 92

Коэффициент быстроходности ступени:

ns =

3,65n√Qпот
Hст

0,75 =

3,65 ∙ 2900 ∙ √0,09
92⁰,75 | = 107

Приведенный диаметр:

D1пр = 4,25 ∙ 10³

- (

Qпот
n

)

1
3
= 4,25 ∙ 10³
- (

0,09
2900)

1
3
= 133,7 мм

Гидравлический КПД ступени:

ηg = 1 −

0,42
(

ln(D1пр)
ln(10)

− 0,173)

2 = 1 −

0,42
(

ln(133,7)
ln(10)

− 0,173)

2 = 0,89

Объемный КПД ступени:

ηоб =

1

1 + 0,68 ∙ ns

−2
3

=

1

1 + 0,68 ∙ 107

−2
3

= 0,971

Механический КПД ступени:

ηдт =

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
107²

= 0,933

Полный КПД ступени:
η = ηобηgηдт = 0,971 ∙ 0,89 ∙ 0,933 = 0,806

Мощность проточной части:

N =

ρQH
102 ∙ 3600 ∙ η

=

844 ∙ 650 ∙ 92
102 ∙ 3600 ∙ 0,806 = 170,5 кВт

Максимальная мощность проточной части:
Nmax = 1,2 ∙ N = 1,2 ∙ 170,5 = 204,6 кВт

Из условия прочности (σкр = 15 ∙ 10⁶ Па) найдем диаметр вала:

Определим максимальный вращающий момент на валу:

M = 97500 ∙

Nmax
n

= 97500 ∙

204,6
2900 = 6878 кН ∙ м

dвал = 10 ∙ (

M
0,2 ∙ 150 ∙ Zст

)

1
3
= 10 ∙ (

6878
0,2 ∙ 150 ∙ 1

)

1
3
= 61,2 мм

Из условий прочности определим диаметр втулки колеса: dвт = 1,25 ∙ dвал = 1,25 ∙ 61,2 = 76,5 мм

Принимаем диаметр втулки: dвт = 77 мм

Кавитационный коэффициент быстроходности: Cкр = 771

Критический кавитационный запас:

∆Hкр = 10 ∙ (

n ∙ √Qпот
Cкр )

4
3
= 10 ∙ (

2900 ∙ √0,09
771 )

4
3
= 11,77 м

Допускаемый кавитационный запас:
∆Hдоп = 1,2 ∙ ∆Hкр = 1,2 ∙ 11,77 = 14,1 м

Принимаем коэффициент входной скорости из рекомендованных значений KV0 =

= 0,06 − 0,08 = 0,0603, тогда скорость на входе в ступень:

V0 = KV0 ∙ (Q1 ∙ n

2)

1
3 = 0,0603 ∙ (0,09 ∙ 2900²)

1
3 = 5,56

м
с
Диаметр колеса на входе:
D0 = 1000 ∙ √(4 ∙
Q1
π ∙ V0

) + (

dвт
1000)

2

= 1000 ∙ √(4 ∙
0,09
π ∙ 5,56) + (

77
1000)

2
= 165 мм

Примем отношение диаметров лопасти на входе (высотной середины лопасти на

входе) к диаметру колеса на входе D1отн = 0,8 − 1 = 0,9, тогда диаметр лопасти на входе:

D1 = D1отн ∙ D0 = 0,9 ∙ 165 = 148,5 мм

Определим меридианную скорость на входе, предварительно приняв коэффициент

меридианной скорости KVm1 = 0,5 − 1,1 = 0,915

Vm1p = KVm1 ∙ V0 = 0,915 ∙ 5,56 = 5,08

м
с
Тогда ширина лопатки на входе определится, как:

b1 = 1000 ∙

Q1
π ∙ 0,01 ∙ D1 ∙ Vm1p

= 1000 ∙

0,09
π ∙ 0,01 ∙ 148,5 ∙ 5,08 = 39,2

Окружная скорость на входе в колесо:

U1D0 = 0,001 ∙ D0 ∙ π ∙

n
60 = 0,001 ∙ 165 ∙ π ∙

2900
60 = 25,06

м
с
Окружная скорость на входе во входную кромку лопатки:

U1D1 = 0,001 ∙ D1 ∙ π ∙

n
60 = 0,001 ∙ 148,5 ∙ π ∙

2900
60 = 22,55

м
с
Принимаем количество лопастей на входе Z1=7 и их толщину S1=5 мм. Угол

установки лопасти на входе принимаем β1 = 20°

Коэффициент cтеснения потока:

K1 =

1
(1 − (
Z1 ∙ S1
π ∙ D1 ∙ sin(

π ∙ β1
180 )

))

=

1
(1 − (
7 ∙ 5
π ∙ 148,5 ∙ sin(

π ∙ 20
180 )

))

= 1,281

Угол потока на входе:

β1o = (

180
π

) ∙ arctg (

K1 ∙ Vm1p
U1D1

) = (

180
π

) ∙ arctg (

1,281 ∙ 5,08
22,55 ) = 16,1°

Угол атаки должен входить в рекомендованные δ1 = 3° − 9° при ns = 60 − 120,

таким образом:
δ1 = β1 − β1o = 20 − 16,1 = 3,9°

Мередианная скорость потока на входе с учетом стеснения:

Vm1 = K1 ∙ Vm1p = 1,281 ∙ 5,08 = 6,51

м
с
Подача на ступень с учетом объемных протечек:

Q1 =

Qпот

ηоб

=

0,09
0,971 = 0,093

м

3
с

Реальная относительная скорость на входе:

W1D1 =

Vm1

sin(

π ∙ β1
180 )

=

6,51

sin(

π ∙ 20
180 )

= 19,04

м
с

Относительная скорость при плавном (безударном) входе:

W10D1 =

Vm1

sin(

π ∙ β10
180 )

=

6,51

sin(

π ∙ 16,1
180 )

= 23,48

м
с

Таким образом окончательно критический кавитационный запас определится, как

сумма энергий среды ее относительного и переносного движения при входе в колесо

помноженные на коэффициенты m0 и n0, рекомендованные принять равными m0=1.2,

n0=0.3-0.4.

∆Hкр = m0 ∙

V0

2
2g

+ n0 ∙

W1

2
2g

= 1,2 ∙

5,56²
2 ∙ 9,8

+ 0,4 ∙

19,04²
2 ∙ 9,8

= 13,13 м

Окончательный кавитационный коэффициент быстроходности:

Скр =

n ∙ Qпот

(0,1 ∙ ∆Hкр)

3
4

=

2900 ∙ 0,09

(0,1 ∙ 13,13)

3
4

= 710

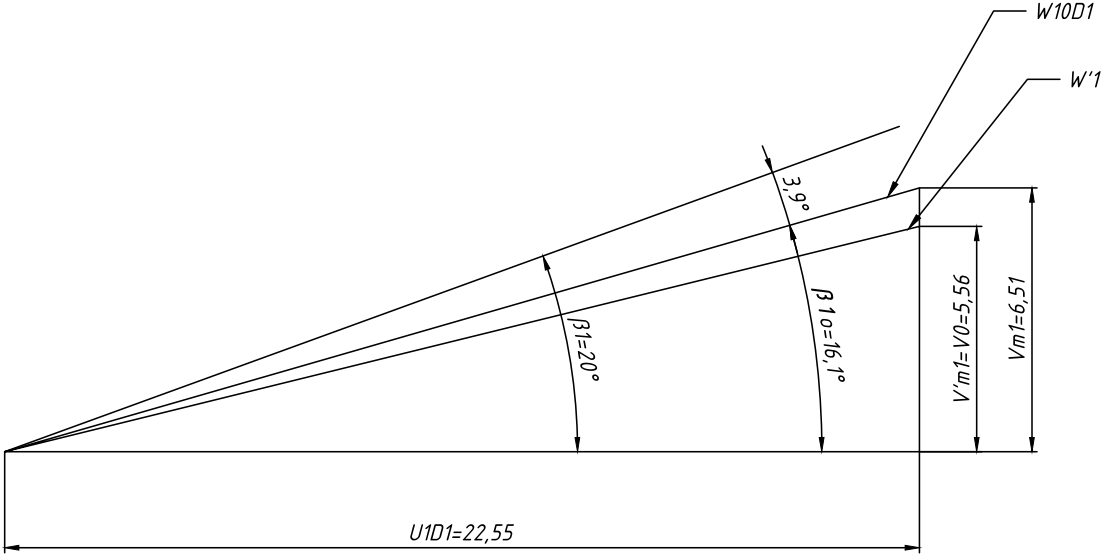
[picture p92: figure]

Рис.3.1 - Треугольник скоростей на входе в колесо, (величины с ' показывают скорости

без учета затеснения меж лопаток)

Принимаем коэффициент меридианной скорости KVm2 = 0,5 − 1 = 1, тогда

меридианная скорость на выходе:

Vm2p = KVm2 ∙ Vm1p = 1 ∙ 5,08 = 5,08

м
с
Теоретический напор ступени:

Ht =

Hст

ηg

=

92
0,89 = 103,37 м

Окружная скорость на выходном диаметре в начальном приближении:

U2 = √2 ∙ g ∙ Ht = √2 ∙ 9,8 ∙ 103,37 = 45

м
с
Диаметр рабочего колеса на выходе в начальном приближении:

D2 =

1000 ∙ 2 ∙ U2
π ∙

n
30

=

1000 ∙ 2 ∙ 44,5

π ∙

2900
30

= 296,5 мм

Для дальнейшего уточнения диаметра D2, окружной скорости U2, коэффициента

стеснения на выходе K2 необходимо совместно, то есть в системе, решить следующие

уравнения. Предварительно принимаем количество лопастей на выходе Z2отн =

1, следовательно Z1 ∙ Z2отн = 7, толщину лопасти на выходе S2=5мм, угол установки

лопасти на выходе β2=23°

{

Pпр =

2
Z1 ∙ Z2отн

∙

(0,6 + 0,6 ∙ sin (

π ∙ β2
180 ))

1 − (

D1
D2

)

2

P =

Pпр + (Z2отн − 1) ∙ Pпр
Z2отн

K2 =

1

1 −

Z1 ∙ Z2отн ∙ S2
π ∙ D2 ∙ sin (

π ∙ β2
180 )

U2 = (

K2 ∙ Vm2p
a

) − √(
K2 ∙ Vm2p
a

)

2
+ g ∙ (1 + P) ∙ Ht

D2 = 1000 ∙

60 ∙ U2
π ∙ n
P - коэффициент, учитывающий конечное число лопастей.

Решение системы:
K2=1,11, U2=43,88 м
с

, D2=288,9 мм.

Таким образом окружная составляющая абсолютной скорости на выходе:

VU2 = g ∙

Ht
U2

= 9,8 ∙

103,37
43,88 = 23,1

м
с

Меридианная скорость на выходе с учетом стеснения:

Vm2 = K2 ∙ Vm2p = 1,1 ∙ 5,08 = 5,64

м
с
Относительная скорость на выходе:

W2 =

Vm2
sin (

π ∙ β2
180 )

=

5,64
sin (

π ∙ 23
180 )

= 14,43

м
с

Коэффициент торможения относительной скорости в колесе:

Kw =

W1D1
W2

=

19,04
14,43 = 1,32

Ширина колеса на выходе:

b2 = 1000 ∙

Q1
π ∙ 0,01 ∙ D2 ∙ Vm2p

= 1000 ∙

0,093
π ∙ 0,01 ∙ 288,9 ∙ 5,08 = 20,1 мм

Угол абсолютной скорости на выходе:

α2 = (

180
π

) ∙ arctg (

Vm2p

VU2

) = (

180
π

) ∙ arctg (

5,08
23,1

) = 12,41°

Абсолютная скорость на выходе из колеса: V2p = √VU2
2 + Vm2p
2 = √23,1
2 + 5,08² = 23,7

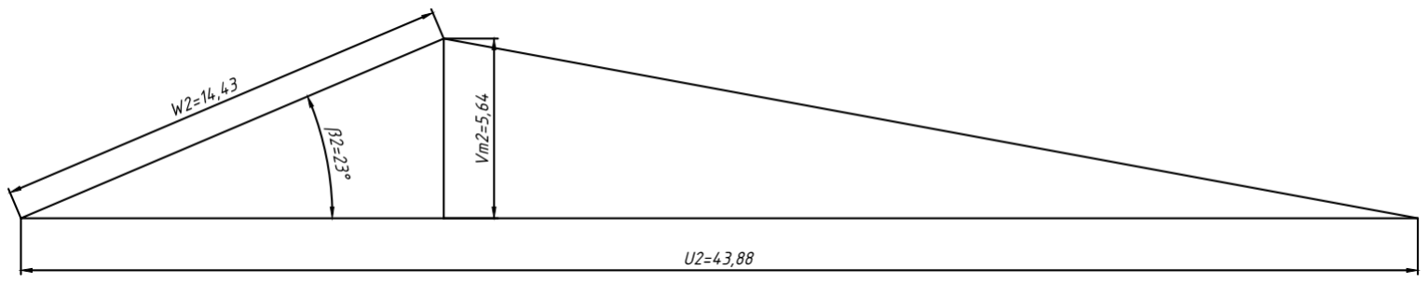
[picture p93: figure]

Рисунок 3.2 - Треугольник скоростей на выходе из колеса

### 3.6 Профилирование меридианного сечения рабочего колеса

Профилирование должно быть осуществлено так, чтобы создать благоприятные

условия для безотрывного обтекания контура лопасти потоком, что обеспечивает

минимум гидравлических потерь. При профилировании меридианного сечения колеса и

лопасти задаются шириной колеса b, толщиной лопасти δ и углом наклона лопасти β в

функции средней линии (S) и определяют W и Vm от S.

В колесах с почти радиальным (в пределах расположения лопасти от r1 до r2)

направлением средней линии меридианного сечения канала пренебрегают отличием

длины элемента средней линии ds от приращения радиуса dr. В этом случае лопасть может

быть запроектирована с цилиндрической поверхностью, образующая которой

параллельна оси РК.

Параметры рабочего колеса сведем в таблицу 7.

Таблица 7 – Параметры рабочего колеса

Вход в рабочее колесо D0, мм | 165
Диаметр расположения водных кромок лопаток D1, мм | 148,5
Выход из рабочего колеса D2, мм | 289
Ширина колеса на входе b1, мм | 39,2
Ширина колеса на выходе b2, мм | 20,1
Число лопаток Z | 7
Толщина лопатки на входе S1, мм | 5
Толщина лопатки на выходе S2, мм | 5
Угол лопатки на входе β1, град | 20
Угол лопатки на выходе β2, град | 23

Расчет по данной методике выполнен в пакете Mathcad 2015 и приведен в

приложении В. Ниже приведен эскиз меридианного сечения.


Рис. 3.3 - Профиль меридионального сечения колеса.

### 3.7 Профилирование лопастей рабочего колеса по программе в Mathcad

Профилирование рабочих лопаток проведем и использованием пакета Mathcad

2015 по методике изложенной в [5]. В приложении В представлен полный расчет. На

рисунке 4.3 представлен вид рабочих лопаток, полученный в результате расчета.


Рис. 3.4 - Профили лопаток рабочего колеса

### 4. Расчёт направляющего аппарата

Вид направляющего аппарата выбираем аналогично прототипу, то есть канальный.

Отличительной чертой лопаточного отвода является наличие нескольких каналов.

Каждый канал состоит из спиральной части и диффузора. Спиральная часть канала

обычно выполняется постоянной ширины. Для обеспечения оптимальных условий

течения в каналах направляющего аппарата должны быть соблюдены следующие условия:

1) при данной площади канала его гидравлический радиус должен быть

максимальным. Этому условию лучше всего удовлетворяет квадратное сечение на входе в

направляющий аппарат;

2) канал диффузора целесообразно выполнять с прямолинейными стенками;
3) число лопаток следует принимать минимальным;
4) угол раскрытия канала диффузора следует принимать равным углу раскрытия

для прямолинейных диффузоров или меньшим;

5) угол лопатки имеет второстепенное значение по сравнению с оптимальным

соотношением размеров колеса.

Контур лопатки должен следовать линиям тока потока.

Принципиальная схема лопаточного отвода показана на рисунке 4.1

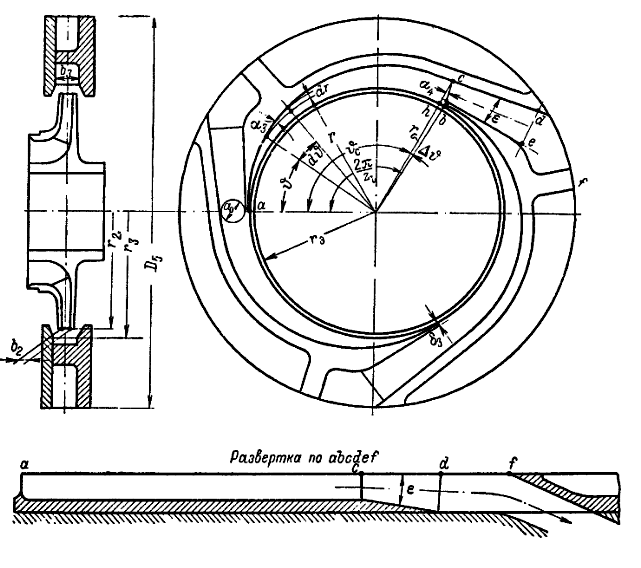
[picture p94: figure]

Рисунок 4.1 - Схема лопаточного отвода [11, c.124]

### 4.1 Расчет геометрии и параметров потока

Средняя скорость в горловом сечении:

C3 = K3 ∙ √2g ∙ H = 0,38 ∙ √2 ∙ 9,81 ∙ 92 = 16,145

м
с
где К3 – опытный коэффициент, изменяющийся в зависимости от nS (согласно рис.

5.3 методички).

Из графика К3 = 0,38.

Диаметр начальной окружности:
D3 = (1,03 …1,05) ∙ D2 = 1,038 ∙ 289 ≈ 300 мм

Принимаем ширину аппарата:
b3 = 1,1 ∙ 2 ∙ (20,1 + 2 ∙ 5) = 66,2 мм

Площадь горлового сечения на входе определяется следующим образом:

Согласно рекомендациям по соотношению числа лопастей рабочего колеса и НА

принимаем Zна = 12.

Fг =

Q
C3 ∙ Zна

=

650
3600
16,145 ∙ 12 = 0,000932 м

2

Где: Zна – число лопаток НА.

Ширина горлового сечения составит:

aг =

FГ
b3

=

0,000932 ∙ 10⁶
66,2

≈ 14 мм

Меридианная скорость потока на входе в НА без учета cтеснения:

Cm3 =

Q
π ∙ D3 ∙ b3

= 2,9 м/с

Окружная скорость потока на входе в направляющий аппарат:

Cu3 = Cu2

- (

D2
D3

) = 23,1 ∙ (

289
300) = 22,253

Угол потока на входе в направляющий аппарат без учета стеснения

α3 =

180
π
- atan (
Cm3
Cu3

) =
180
3,14 ∙ atan (

1,45
22,253) = 7,4°

Для диффузора с прямоугольным горловым сечением и двумя параллельными боковыми стенками около 10⁰

– 12⁰
, принимаем 11

0

Длину диффузора между лопатками следует принимать

L = 4 ∙ aг = 14 ∙ 4 = 28 мм

Рациональное увеличение проходного сечения в канале диффузора 1,6 – 2. Принимаем aв = (1,6 − 2) ∙ aг = 1,785 ∙ 14 = 25 мм

Диаметр наружной окружности НА принимаем D4 = 386 мм.

D4
D2

=

386
289 = 1,34

Площадь меридианного сечения кольцевого коллектора должна быть больше

площади входа в каналы направляющего аппарата не менее чем в 1,7 раза.

Fколлект = 12 ∙ 2 ∙ Fг = 12 ∙ 2 ∙ 0,000932 = 0,022368 м

2

Радиус меридионального сечения кольцевого коллектора:

Rколлект = √
Fколлект
π

= √
0,022368
π

= 0,085 м

Наибольший диаметр кольцевого коллектора:
Dнаиб = D4 + 2 ⋅ Rколлект = 386 + 2 ⋅ 85 = 556 мм

### 4.2 Профилирование лопаток направляющего аппарата


Рис 4.2 - Эскиз направляющего аппарата


Рис. 4.3 - Окончательный эскиз меридианного сечения проточной части насоса 1 – напорный коллектор, 2 – НА, 3 – РК

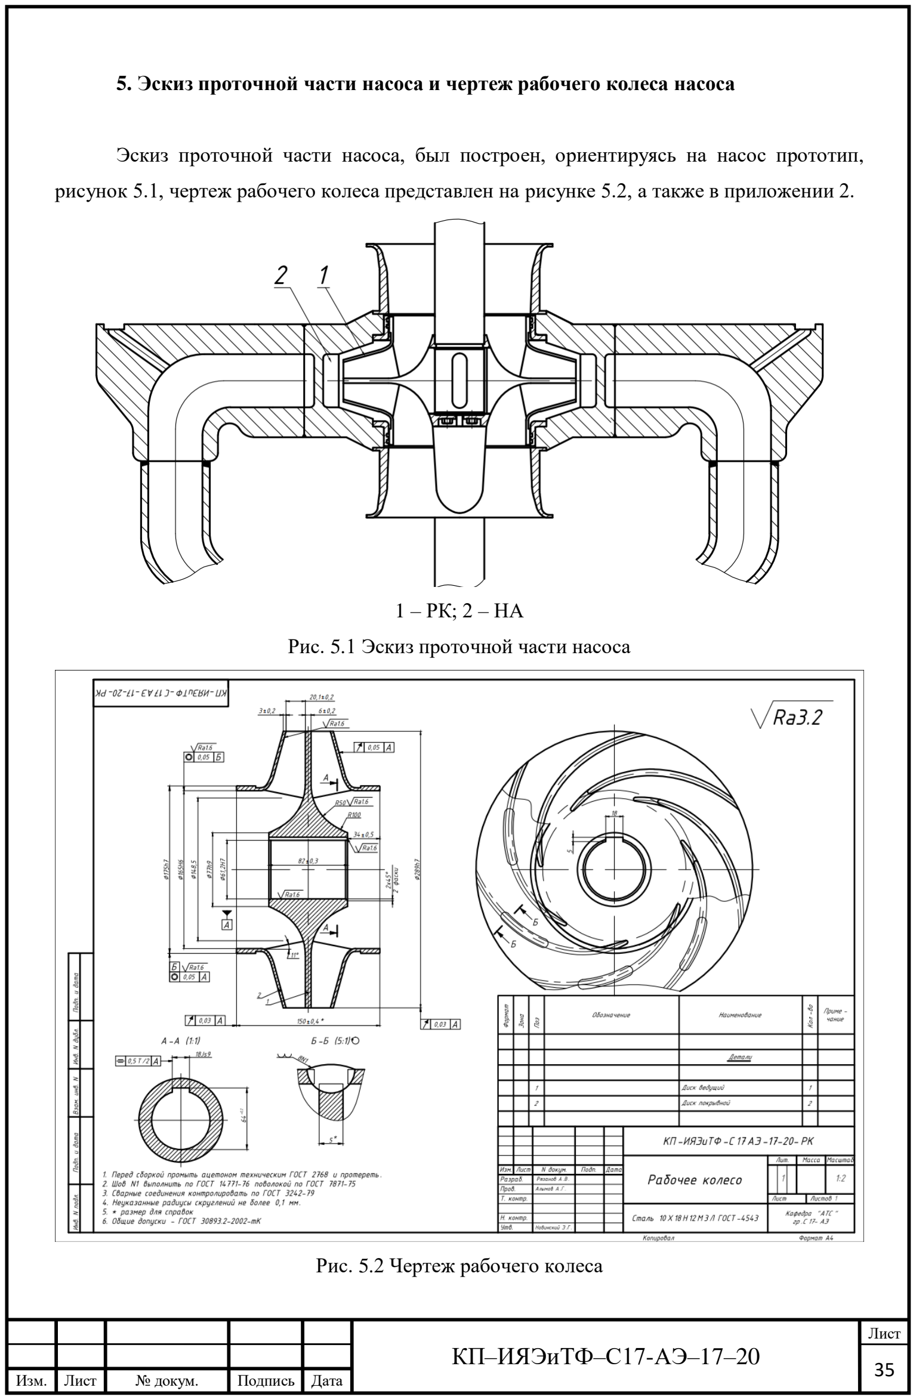
[picture p95: page 35]

### 5. Эскиз проточной части насоса и чертеж рабочего колеса насоса

Эскиз проточной части насоса, был построен, ориентируясь на насос прототип,

рисунок 5.1, чертеж рабочего колеса представлен на рисунке 5.2, а также в приложении 2.

1 – РК; 2 – НА

Рис. 5.1 Эскиз проточной части насоса

Рис. 5.2 Чертеж рабочего колеса

### 6. Расчёт мощности проточной части насоса

При расчете мощности проточной части насоса надо учитывать, что главные

циркуляционные насосы, устанавливаемы на АЭС должны работать в широком

температурном диапазоне при «холодном» и «горячем» теплоносителе. ГЦН работает на

«холодном» теплоносителе, к примеру, при гидроиспытаниях, которые проводятся при

первом пуске РУ, после проверки работоспособности всех систем и устройств,

обеспечивающих надежную и безопасную работу энергоблока. Сначала ГИ проводятся в

холодном состоянии, затем оборудование первого контура разогревается со скоростью не

более 30 °С/ч и проводятся гидроиспытания в горячем состоянии.

Мощность проточной части насоса определяется по формуле:

N =

ρ ∙ Q ∙ H
102 ∙ η

=

844 ∙

650 ∙ 1000
3600 | ∙ 92
102 ∙ 0,806 | = 170,5 кВт

где η ≈ 0,85 – КПД одноступенчатого насоса при ns = 107 и подаче Q = 181 л/с,

значение определено по графику на рис. 3.2 [5, стр.36].

Однако двигатель подбирается по максимальной мощности, которая учитывает

потери (механические, электрические на электродвигателе и потери в насосе). В моем

случае максимальная мощность Nmax=204,6 кВт

### 7. Расчет осевой силы, действующей на осевой подшипник

В работающем насосе лопастные колеса подвержены действию различных сил,

достигающих иногда значительной величины. Кроме того, ротор насоса находится в

состоянии | установившегося | вращательного | движения. | Тогда, | согласно | началу

Д’Аламбера, все силы, действующие на него, должны быть уравновешены, что требует

специальных мероприятий, существенно влияющих на конструкцию насоса. В данном

случае в связи с тем, что в насосе применено рабочее колесо с двухсторонним всасом,

будут отсутствовать осевые силы гидродинамического и статического происхождения,

действующие на поверхности рабочего колеса, т.к. они будут взаимно уравновешиваться

вследствие симметрии. Таким образом осевая сила на рабочем колесе будет определяться

силой тяжести вала и рабочего колеса и разностью давления действующих на торцы вала -

с одной стороны атмосферой, а с другой стороны давлением всаса.

F = Fтяж + Fатм − Fвсас где, Fтяж - сила тяжести элементов вала, вала и рабочего

колеса. Расчет будем вести, принимая что все элементы имеют одну плотность (ρ = 7900 кг
м³

) и цилиндрическую форму.

Таким образом масса каждой ступени будет определяться как:
M = | π ∙ D
| 2
| 4 ∙ H ∙ ρ

Для полого участка вала:
M = | π ∙ (Dвнеш
2 | − Dвнутр
| 2
)
| 4 | ∙ H ∙ ρ

В итоге получим результат что масса всех элементов M=1302 кг, следовательно: Fтяж = g ∗ M = 9,81 ∙ 1302 = 12772 H.

Сила же разности давлений приблизительно определиться, как:

Fатм − Fвсас =

π ∙ Dв.тор

2
4
- Pатм −

π ∙ Dн.тор

2
4
- Pвсас = 1618 Н

Тогда суммарная осевая сила направленная вниз будет равна: F = Fтяж + Fатм − Fвсас = 14397 Н ≅ 15000 H

На рисунке 7.1 приведена схема вала для расчета осевой силы.

Рисунок 7.1 - Упрощенная схема вала

### 8. Расчет радиальной силы, действующей на радиальные подшипники

Одной из основных проблем, возникающих при создании ГЦН, является

необходимость достаточно точно определять радиальную силу. Без достоверного знания

этой силы невозможно правильно выбрать радиальные подшипники и обеспечить их

нормальную работу. Как показывает практика эксплуатации ГЦН, в ряде случаев несущая

способность радиальных подшипников является недостаточной для восприятия

значительных радиальных сил, возникающих в ГЦН. Это приводит к усиленному износу

опорных элементов, сокращению срока службы ГЦН. В других случаях радиальные

подшипники могут иметь необоснованно большие запасы несущей способности,

следствием чего являются значительное утяжеление, усложнение и удорожание

конструкции в целом. [3, стр.240]

Основная причина возникновения радиальных сил – асимметрия потока на выходе

из рабочего колес, обусловленная в основном влиянием отвода. При изменении скорости в

отводе (спиральный отвод) по закону сохранения энергии происходит соответственно

изменение давление по длине отвода. Эти изменяющиеся давления в сумме и дают

радиальную силу, действующую на ротор насоса.

Радиальные | силы | также | вызываются | статической | и | динамической

неуравновешенностью ротора вследствие неточности технологии и монтажа насоса.

Необходимо также учитывать радиальные силы, возникающие на лабиринтах,

однако они устраняются точностью изготовления

Насос работает в номинальном режиме, поэтому радиальные силы равны нулю.

Для устойчивой работы радиальных подшипников зададимся произвольной радиальной

силой.

F=18000 Н.

Тогда сила, приходящаяся на один радиальный подшипник:

Fр =

F
2

=

18000
2

= 9000 Н

### 9. Расчет подшипниковых опор

Требования к подшипниковым опорам:

- высокая надежность на всех режимах работы, включая пуски н остановки, а также

ресурс не менее 50 тыс. ч;

- работоспособность в среде с высокой температурой, давлением и возможным

наличном мелких твердых частиц;

- отсутствие склонности материалов, применяемых для трущихся пар подши

пников, к «самосвариванию» и «схватыванию» при аварийном отсутствии питающей

жидкости,

- к деформациям и фазовым превращениям при температуре до 400"С, к изменению

размеров при проведении дезактивации контура моющими растворами;

- используемые материалы должны быть в максимальной степени технологи

чными, дешевыми и взаимно совместимыми;

- нежелательно присутствие в материале подшипника элементов, которые под

облучением в реакторе приобретают долгоживущую наведенную радиоактивность;

- недопустимо выделение из материалов подшипника коррозионно-опасных

веществ (например, фтора);

- хорошая ремонтопригодность;
- относительно малая чувствительность к изменению нагрузки, к нарушению

заданной соосности опор в процессе работы, достаточная вибростойкость;

- используемые для подшипников смазочно-охлаждающие жидкости должны быть

огнестойкими и нетоксичными.

### 9.1 Расчет осевого подшипника

9.1.1 Обоснование замены сдвоенного шарикоподшипника

В связи с принятой частотой вращения и радиальными и осевыми нагрузками

сдвоенный упорно-радиальный шарикоподшипник не пригоден для работы в насосе на

срок до планового технического осмотра насоса длительностью 5 лет, что подтверждается

приведенным ниже расчетом, выполненным по методике изложенной [13].

Поэтому в данном проекте в качестве элемента, воспринимающего осевую

нагрузку выбран подшипник типа Митчеля, а в качестве верхнего радиального

подшипника - подшипник с цилиндрической расточкой.

9.1.2 Расчет сдвоенного радиально-упорного подшипника.
n = 2800мин

−1

d=160 мм

Примем ресурс подшипников [L10ℎ

] = 5лет = 43800 ч

Силы на опорах:

Примем радиально-упорный сдвоенный шарикоподшипник, поэтому будем

считать, что каждая из его частей принимает половину осевой и радиальной силы.
FРАД = 9000Н

FC = 15000H

Условия эксплуатации подшипника - нормальные. Рабочая температура 50⁰

Предварительно принимаем подшипник 1046932 ГОСТ 831-75(серия диаметров 9,

серия ширин 1):
d × D × B = 160 × 220 × 28

Базовая грузоподъемность
Fr = 95000H

Угол контакта
α = 36

o

По таблице [2, c. 114] определяем коэффициент осевой нагрузки e = 0,95

Коэффициент вращения
V = 1
FC
V ⋅ FРАД

=

15000
1 ⋅ 9000 = 1,66 > e,

тогда принимаем коэффициенты радиальной и осевой нагрузок: X = 0,6

Y = 1,07

Расстояние от нагрузки до точки пересечения нормали к середине площадки

контакта ПК и вала:
a = 0,5 ⋅ [B + 0,5 ⋅ (d + D) ⋅ tgα] = 0,5 ⋅ [28 + 0,5 ⋅ (160 + 220) ⋅ tg36] = 60мм

Коэффициент безопасности:
KБ = 1,4

Температурный коэффициент:
КТ = 1

Эквивалентная радиальная динамическая нагрузка
RЕ = (X ⋅ V ⋅ FРАД + Y ⋅ FC) ⋅ KБ ⋅ КТ = (0,6 ⋅ 1 ⋅ 9000 + 1,07 ⋅ 15000) ⋅ 1,4 ⋅ 1 = 30030H

Обобщенный коэффициент, учитывающий совместное влияние особых свойств

металла и условий эксплуатации ПК

а23 = 1

Показатель степени кривой усталости

р = 3

Расчетный скорректированный ресурс ПК 336328Л1

L10aℎ =

10

6

⋅ a23 ⋅ (

Cr
RE

)

p

60 ⋅ n

=

10

6

⋅ 1 ⋅ (

205000
30030 )

3

60 ⋅ 2900 = 1828ч

[L10ℎ

] = 43800 < L10aℎ = 1828

Полученный ресурс меньше [L10ℎ

], поэтому данный подшипник нельзя применить

в насосе.

9.1.3 Расчет осевого подшипника [7]

Осевой подшипник представляет собой пяту Митчеля с самоустанавливающимися

сегментами.

Осевая нагрузка.
P = 15000 Н (вниз)

Частота вращения

n = 2900

об
мин
Внутренний диаметр подшипника d1 = 280 мм

Наружный диаметр подшипника d2 = 400 мм

Число колодок
S = 8

Система смазки принудительная. Масло турбинное Т-22. Принимаем температуру

смазки на входе по все подшипники tвх = 50℃. При этом масло имеет следующие

физические характеристики:

λ = 0.1265 ⋅ 10⁻³

кДж
м ∙ с ∙ К

cp = 1,96

кДж
кг ∙ К

ρ = 876

кг
м³
μ = 1.87 ⋅ 10⁻² Па ∙ с

ν =

µ
ρ

=

1,87 ∙ 10⁻²
876 = 2 ∙ 10⁻³

м

2
c

Ширина колодки в радиальном направлении

B =

d2 − d1
2

=

40 − 28
2

= 6 cм

Фактическая длина колодки по окружности середины поверхности скольжения

L = ξ ⋅

π ⋅ dcp
8

= 0,91 ⋅

π ⋅ 34
8

= 12,15 см

где ξ = 0,91 - коэффициент использования упорной поверхности

Нагрузка на одну колодку

Ps =

P
S

=

15000
8

= 1875 H

Подъемная сила на единицу ширины сектора

P1 =

Ps
B

=

1875
6

= 312,5

Н
cм

Определяющий размер колодки L
B

=

12,15
6

= 2,025 ≅ 2

Диаметр приложения равнодействующей сил трения df = d1 + 0,7 ⋅ B = 0,28 + 0,7 ⋅ 0,06 = 0,284 м

Окружная скорость на диаметре df:

vm =

π ⋅ df ⋅ n
60 =

π ⋅ 0,284 ⋅ 2900
60 | = 42,8

м
с
По рекомендациям для определяющего размера колодки [7] определяем следующие

безразмерные параметры:

Коэффициент подъемной силы: D=0,005

Коэффициент касательной силы: H=4,1

Коэффициент расхода смазки: Vi = 0,155

Коэффициент трения

μf = H ⋅ (

μ ⋅ vm
100 ⋅ P1

)

1/2= 3 ⋅ (

1.87 ⋅ 10⁻²
⋅ 42,8 ⋅ 10
100 ⋅ 312,5

)

1
2
= 0,021

Сила трения на все колодки
T = μf ⋅ P = 0,021 ⋅ 15000 = 311,44 H

Мощность трения на всю пяту
N = T ⋅ vm = 311,44 ⋅ 42,8 = 13 кВт

Количество смазки, подсасываемое по входной кромке на все 8 колодок, без учета

центробежного эффекта
Q = 100 ⋅ S ⋅ v ⋅ L ⋅ B ⋅ Vi

⋅ μf = 100 ⋅ 8 ⋅ 42,8 ⋅ 10,3 ⋅ 12,15 ⋅ 40 ⋅ 0,155 ⋅ 10⁻⁶ =

= 0,0084

м

3
с

≅ 30,24

м

3
ч
С учетом дополнительных протечек берется полуторный запас:

Q = 45,46

м

3
ч
Минимальная толщина несущего смазочного слоя

ℎ1 = L ⋅ √6 ⋅ D ⋅ √
μ ⋅ v
P1

= 12,15 ⋅ √6 ⋅ 0,005 ⋅ √
1,87 ⋅ 10⁻² ⋅ 2 ∙ 10⁻³ ⋅ 10 312,5

= 0,01мм

### 9.2 Расчет радиального подшипника с цилиндрической расточкой

Радиальный подшипник представляет собой 2 втулки: закрепленную герметично на

валу и закрепленную соосно с ней на корпусе осевого подшипника ответную втулку.

Расчет данного подшипника будем вести по методике изложенной в [7, c.72 - c.83].

Поэтому по рекомендации выбираем следующие размеры.


Рисунок 9.1 - Рекомендации к выбору основных размеров подшипника

Исходные данные для расчёта:

Диаметр втулки вала d = 200 мм

Длина подшипника l = 128 мм

Частота вращения вала ω = 2900 об
мин

= 300 рад
с
P = 4000Н = 400 кгс

Угол охвата вкладыша αK = 360

0
;

Сорт смазки: масло турбинное Т -22;

Температура смазки tС = 40

0C;

Теплоёмкость смазки с = 1930 Дж
кг⋅

0С

;

Плотность смазки ρ = 880 кг
м3

;

Относительный зазор

ψ = 0,8 ⋅ 10⁻³

⋅ √8,35 ⁴ = 3 ⋅ 10⁻³

Радиальный зазор

∆= ψ

d
2

= 1,36 ⋅ 10⁻³
⋅

160
2 ⋅ 1000 = 2,4 ⋅ 10⁻⁴ м

Размеры питающего кармана
a = 28 мм

b = 56 мм

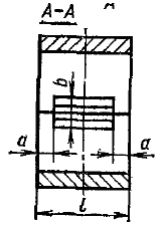
[picture p96: figure]

Рисунок 9.2 - Схема размеров питающего кармана

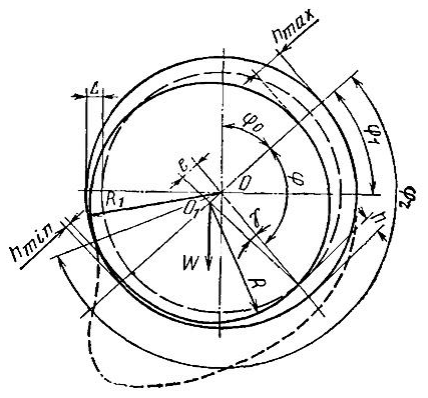
[picture p97: figure]

Рисунок 9.3 - Схема подшипника с цилиндрической расточкой

Дальнейшие расчёты приведены в таблице 8.

Таблица 8 - Расчёт радиального подшипника

Определяемый параметр | Расчётная зависимость | Результаты вычислений при различных значениях μср для итераций
1 | 2 | 3
Вязкость смазки при средней температуре в смазочном слое μср, Па с | Задаётся произвольно | 0.005 | 0.010 | 0.015
Коэффициент нагруженности ζ | Fрад ⋅ ψ 2 ζ = l ⋅ d ⋅ ω ⋅ μ | 2.109 | 1.055 | 0.703

Определяемый параметр | Расчётная зависимость | Результаты вычислений при различных значениях μср для итераций
1 | 2 | 3
Относительный эксцентриситет χ | [7, стр. 74] | 0.84 | 0.75 | 0.62
Коэффициент торцевого расхода смазки q1 | [7, стр. 79] | 0.317 | 0.302 | 0.242
Окружной расход смазки q0 | [7, стр. 83] | 0.045 | 0.068 | 0.09
Окружной расход, определяемый количеством налипшей смазки q0 | ⋅ √ 0.375 μ q0 = Δ ρ ⋅ ω | 0.172 | 0.243 | 0.298
Коэффициент сопротивления шипа вращению ξ | [7, стр. 85] | 6.3 | 5.02 | 4.07
Приращение температуры в смазочном слое, Δt, °С | ξ ⋅ ω ⋅ μ Δt = ρ ⋅ c ⋅ ψ² ⋅ q1 | 1.95 | 3.262 | 4.951
Температура смазки на входе в смазочный слой, t, °С | Δt ⋅ q0 tвх = t0 + q1 | 40.277 | 40.702 | 41.841
Средняя температура смазки в зазоре, tср, °С | Δt tср = t0 + 2 | 40.975 | 41.631 | 42.476
Максимальная температура, tmax, °С | t0max | 41.95 | 43.262 | 44.951
Минимальная толщина смазочного слоя, hmin, мкм | ℎ(1 − χ)min | 480 | 750 | 1140
Коэффициент β | [7, стр. 89] | 0.5 | 0.46 | 0.4
Коэффициент q2 | 2 β ⋅ ς ⋅ d q2 = l 2 | 2.575 | 1.184 | 0.687
Коэффициент v1 | [7, стр. 90] | 0.128 | 0.132 | 0.126
Коэффициент q3 | 2 d b q3 = v1 ⋅ ς ⋅ ( ) ⋅ l d l ⋅ ( − 1) a | 0.659 | 0.34 | 0.216
Расход смазки, необходимый для обеспечения работоспособности опоры, Q, 3 м /с | Q = 0.5 ⋅ ω ⋅ ψ ⋅ l ⋅ d ⋅ (q 1 + | + q 2 + q 3) | 0.0041 | 0.0021 | 0.0013
Потери мощности на трение в подшипнике, N, кВт | ξ ⋅ ω² 3 ⋅ d ⋅ l ⋅ μ N = 2 ⋅ ψ ⋅ 10 −3 | 0.484 | 0.771 | 0.938

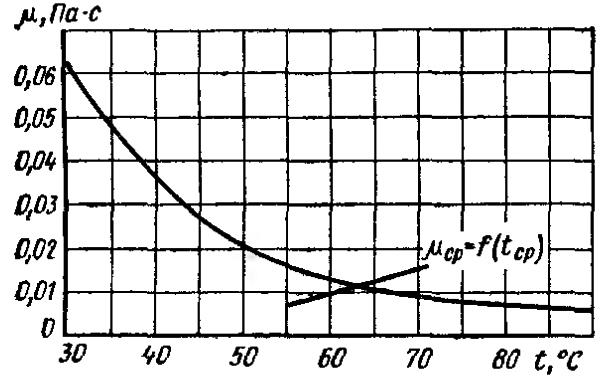
[picture p98: figure]

Рис. 9.4 - График определения средней динамической вязкости смазки

Проверим работоспособность подшипника, для этого вберем значения параметров,

вычисленных для μ = 0,005 Па ⋅ с.

Проверка толщины смазочного слоя

ℎKPmin - необходимое условие устойчивой работы подшипника;

ℎКР = 1,595 ⋅ d ⋅ ((
l
d

)

2
+ 1,81) ⋅ (
l
d

)

2
⋅ pm ⋅ 10

−3
, где pm =

Fрад
l⋅d

-удельная нагрузка на

опору, Па.
ℎкр = 1,595 ⋅ 0,16 ⋅ 2,45 ⋅ 0,8

2

⋅ 439556 ⋅ 10⁻³ = 175 мкм

Т.к. ℎmin = 480 ≥ ℎкр = 175 и tmax = 44.951℃ ≤ tдоп = 130℃ значит, что

подшипник будет работать нормально.

### 9.3 Расчет гидростатического подшипника

Диаметр вала d = 252мм

Ширина буртика l = 477мм

Длинна дросселя l1 = 39мм

Зазор радиальныйδ1 = 1мм

Радиальная нагрузкаP1 = 2500Н = 250 кгс

Подшипник питается натрием под давлением, создаваемым рабочим колесом

насоса. Напор на выходе из рабочего колеса насоса равен 90 м. ст. Na. Температура натрия

при номинальном режиме равна 300 0С, при этом натрий имеет следующие физические

свойства [9]:

ρ = 845

кгс
м³

λ = 59,1

ккал
м ⋅ час ⋅ °С

Cp = 0,304

ккал
кгс ⋅ °С

v = 30,68 ⋅ 10⁻⁸

м

2

с

Определение потерь напора по трассе питания подшипника от рабочего колеса до

дросселя:

1.Вход в канал и выход из канала до дросселя:
ξ1 = 0,5 + 0,6 = 1,1
2. 2 плавный поворота на 90⁰
с соотношением

d
r

≈ 0,7 [10]:

ξ2 = 0,5

3.Трение:

Длина канала до дросселя:
l = 740мм

Диаметр сверления:
d = 30мм

Коэффициент трения:
λ = 0,03

ξ3 = λ ⋅

l
d

= 0,03 ⋅

740
14 = 1,179

Суммарный коэффициент сопротивления: ξ = 1,1 + 0,5 + 1,179 = 2,679

Принимаем расход натрия на питание подшипника:

Q = 42

м

3

ч

= 0,012

м

3

с
Площадь сверления

f = 0,785 ⋅ d

2 = 0,785 ⋅ (

30
1000)

2
= 0,000706м

2

Скорость потока в сверлении

V =

Q
f

=

0,012
0,000706 = 16,51

м
с

Потери напора

ΔH = ξ ⋅

V

2
2 ⋅ g

= 2,679 ⋅

16,51

2
19,6

= 31,04м

Принимаем ΔH = 31 м. Тогда в камере перед дросселем будет напор равный 59 м.

Число камер:
П = 12

Для П = 16 по графикам значений [8, с.275] находим, что:

Коэффициент грузоподъемности в направлении на перемычку: θ1 = 0,15

В направлении на рабочую поверхность:
θ2 = 0,21

Коэффициент, характеризующий отношение сопротивления щели к сопротивлению

дросселя:
tопт = 0,028

Оптимальный диаметр дросселя определяем из уравнения:

tопт =

1,5 + λ ⋅

l
2 ⋅ δ1

1,5 +

l1
d1

⋅ (
π ⋅

d1

2
4
4 ⋅ π ⋅ ν ⋅ δ1
n ⋅ D

)

2

=

1,5 + 0,03 ⋅

740
2 ⋅ 1
1,5 +

39
d1

⋅ 9 ⋅ 10

−6
⋅ d1

4 =

=

7.789 ⋅ 10

−5

1,5 +

39
d1

⋅ d1

4

Решая его получаем, что d1 = 7мм

Определяем расход натрия через подшипник: Q1 = 2 ⋅ π ⋅ d ⋅ δ1 ⋅ √
2 ⋅ g ⋅ H
(1,5 + 0,03 l
δ1

) ⋅ (1 +

1
tопт

)

=

= 2 ⋅ π ⋅ 0,30 ⋅ 0,001 ⋅ √ 19,6 ⋅ 59
(1,5 + 0,03 ⋅

0,740
0,001) ⋅ (1 +

1
0,028)

= 0,001

м
с

3

Максимальная грузоподъемность подшипника при направлении силы «на

перемычку»
G1 = θ1 ⋅ ρ ⋅ H ⋅ d ⋅ l = 0.15 ⋅ 845 ⋅ 59 ⋅ 0.007 ⋅ 0.477 = 898кг

Рабочий эксцентриситет

При | рабочей | нагрузке | P1 = 9000Н = 900кгс | требуемый | коэффициент

грузоподъемности
θ = | P1 ρ ⋅ H ⋅ d ⋅ l = | 900
881 ⋅ 44 ⋅ 0,45 ⋅ 0,477 = 0,15

Таким коэффициентам грузоподъемности при действии силы «на перемычку»

соответствуют относительные эксцентриситеты:
χ = 0,7

Зазор между валом и втулкой:
ℎ = (1 − χ1) ⋅ δ1 = (1 − 0,7) ⋅ 1 = 0,3мм

### 10. Расчет выбранной прокладки главного разъема

Главный разъем уплотняется усиковым швом, который в случае демонтажа

срезается.

Предварительный расчёт числа шпилек

Определение усилий, действующих на шпильки

Давление среды в корпусе насоса, кгс/см2:
p = 2

Диаметр по сварке, см:
Dс = 120

Усилие от давления среды по диаметру сварки в рабочих условиях, кгс:

Pдс = p ⋅

πDс

2
4

= 22620

Усилие начальной затяжки шпилек, кгс:
P0 = 1,2Pдс = 27140

Давление, создаваемое действием среды по диаметру сварки при гидроиспытаниях,

кгс/см2:
pгид = 1,25p = 2,4

Усилие от давления среды по диаметру сварки при гидроиспытаниях, кгс:

Pгид = pгид ⋅

πDс

2
4

= 27145

Определение усилий, действующих на шпильки. Принимаем тепловое усилие: Pt = 0.

Коэффициент внешней нагрузки:
x = 0,15

Усилие, действующее на шпильки при начальной затяжке, кгс: PБ = P0 = 27140

Усилие, действующее на шпильки в рабочих условиях, кгс: PБ = P0 + xPдс = 27148

Усилие, действующее на шпильки при гидроиспытаниях, кгс:
PБ = P0 + xPгид = 31214

Предел текучести материала шпильки (Ст. 20 ГОСТ 1050-88 М42), кгс/см2: [σ] = 2500

Максимальное усилие, действующее на шпильку, кгс:
PБ

max = max(PБ, P0
) = 31214

Наименьший диаметр шпильки, см: d = 4

Количество шпилек:

z =

4PБ

max
σπd

2 = 9,94

Принимаем z = 10.

Определение температурного усилия Pt , кгс.

Определение податливости соединения.

Податливость шпильки, см/кгс:

λδ =

4
πEфZ

(

ℎ1
3

+ ℎ2 + ℎ3 +

ℎ5
3
dср1
2 | − dср0
2 | +

ℎ4

dср2

2 − dср0

2 ) =

=

4
π ⋅ 1,82 ⋅ 10 ⋅ 10⁶

(

2,9
3

+ 0,7 + 4,3 +

10,9
3
4,2

2 − 1

2 | +

23,9
4

2 − 1

2

) = 1,166 ⋅ 10⁻⁷

Податливость свободного фланца на изгиб, см/кгс:

λф

из = 0,48

(Dб − Dбн +

Dбн − Dбв
3

)

2

Eфℎ

3 ln (

Dнф
Dвф)

= 0,48

(130 − 116 +

116 − 109
3

)

2

1,98 ⋅ 10⁶13,5

3 ln (

141,6
109 )

=

= 6,691 ⋅ 10⁻⁹

Податливость гайки, см/кгс:

λг =

4lг
πEгZ

(
1
(d3

2 − d2

2
)

) =
4 ⋅ 2,9
π ⋅ 1,82 ⋅ 10 ⋅ 10⁶

(

1
(7,7

2 − 4,2

2)

) = 4,871 ⋅ 10⁻⁹

Податливость всех элементов соединения, см/кгс:

λ =

1
1 − x

(λδ + λф

из) = 1,963 ⋅ 10⁻⁷

Принимаем, что ни у одной детали соединения во время работы усилие не

уменьшается. Разность температур между рабочей и монтажной для всех элементов, °С: tфi = 50

Коэффициент температурного расширения, 1/К:
α = 11,5 ⋅ 10⁻⁶

Pt =

∑ ∝фi
tфi

lфi

n
i=1 | − ∑ | ∝bi
tbilbi

n
i=1
∑ λt

m
i=1

= 11,5 ⋅ 10⁻⁶

⋅ 50 (

13,5 + 15,68
1,18 ⋅ 10⁻⁶

) = 85470

Окончательный расчёт числа шпилек

Начальная затяжка, кгс:
PБ = P0 = 27140

Усилие, действующее на шпильки в рабочих условиях, кгс: PБ = P0 + xPдс + Pt = 116025

Усилие, действующее на шпильки при гидроиспытаниях, кгс:
PБ = P0 + xPгид = 31214

Определение усилий, действующих на уплотнительные поверхности.

Усилие, действующее на шпильки при начальной затяжке, кгс:
Pпр = P0 = 27140

Усилие, действующее на уплотнительные поверхности в рабочих условиях, кгс: Pпр = P0 − (1 − x)Pдс + Pt = 93380

Усилие, действующее на уплотнительные поверхности при гидроиспытаниях, кгс: Pпр = P0 − (1 − x)Pгид = 7917

Определение числа шпилек.

Максимальное усилие, действующее на шпильку, кгс: Pпр

max = max(PБ, P0
) = 116025

z =

4Pпр

max
σπd

2 = 13,26

Окончательно принимаем:
z = 14

Эскиз разъемного соединения с размерами показан на рисунке 10.1.


Рисунок 10.1 - Эскиз главного разъёма

### 11. Расчет шпонки под рабочим колесом

По расчётному диаметру вала D = 174 мм под втулкой рабочего колеса выбираем

шпонку призматическую 45x25x340 ГОСТ 23360-78.

Ширина шпонки b = 18 мм

Высота шпонки ℎ = 11 мм

Длина шпонки l = 68 мм

Глубина паза на валу t1 = 7мм

Глубина паза втулки t2 = 4.4 мм

Mкр = 6963 Н ∙ м

Рабочая длина шпонки:
lраб = l − b = 68 − 18 = 50

Площадь смятия:
Fсм = (ℎ − t1

) ∙ l = (11 − 7) ∙ 68 = 272 мм² = 0,272 ∙ 10⁻³ м

2

Напряжения смятия:

σсм =

2 ∙ Mкр
D ∙ Fсм

=

2 ∙ 6963
0,0614 ∙ 0,272 ∙ 10⁻³ = 83,3 МПа

Проверка условия прочности

При втулке, выполненной из стали 45 [σ]см = 130 ÷ 150 Примем [σсм] = 140 МПа

σсм = 83,3 МПа < [σсм] = 140 МПа

Условие прочности выполнено.

### 12. Список использованной литературы

1. Маргулова Т.Х. «Атомные электрические станции», М.: Высшая школа, 1978г
2. Будов В.М. «Насосы АЭС», Москва, Энергоатомиздат, 1986г
3. Митенков Ф.М., Новинский Э.Г., Будов В.М. «Главные циркуляционные насосы

АЭС», Москва, Энергоатомиздат, 1990г

4. Новинский Э. Г. «Насосы и газодувные машины. Курс лекций», НГТУ, 2010г.
5. Алымов А.Г., Новинский Э.Г. «Гидравлический расчёт проточной части

центробежных насосов для АЭУ», Нижний Новгород, 2015г

6. Лапшин Р.М. Расчёт проточной части центробежного насоса: Методические

указания к курсовому и дипломному проектированию по дисциплине

«Насосы и компрессоры ЯЭУ". Г.: ГПИ, 1988г

7. Воскресенский В.А., Дьяков В.И. «Расчёт и проектирование опор скольжения»,

Москва, Машиностроение, 1980г

8. Справочник по расчёту на прочность элементов конструкций энергетического

оборудования. Под научной редакцией д.т.н. Митенкова Ф.М., Горький,

1975г

9. Андреев В.В., Ульянов А.А. «Детали машин и основы конструирования»

Курсовое проектирование, Нижний Новгород, 2013г

10. Кириллов П.Л., Юрьев Ю.С., Бобков В.П. «Справочник по теплогидравлическим

расчетам», Энергоатомиздат, 1990г.

11. Ломакин А. А. «Центробежные и осевые насосы» М.-Л.: Машиностроение, 1966г
12. Дмитриев С.М., Хробостов А.Е. «Краткий курс теплообмена», НГТУ, Нижний

Новгород, 2008г.

13. Андреев, Ульянов «Детали машин и основы конструирования» Курсовое

проектирование, Н. Новгород, НГТУ, 2010г.

14. Волошилин С.А. «Реактор на быстрых нейтронах БОР – 60», Государственный

научный центр – Научно-исследовательский институт атомных реакторов,

Димитровград, http://www.niiar.ru/?q=node/101

Приложение А. Результаты программы MathCad «Расчет геометрии рабочего

колеса»

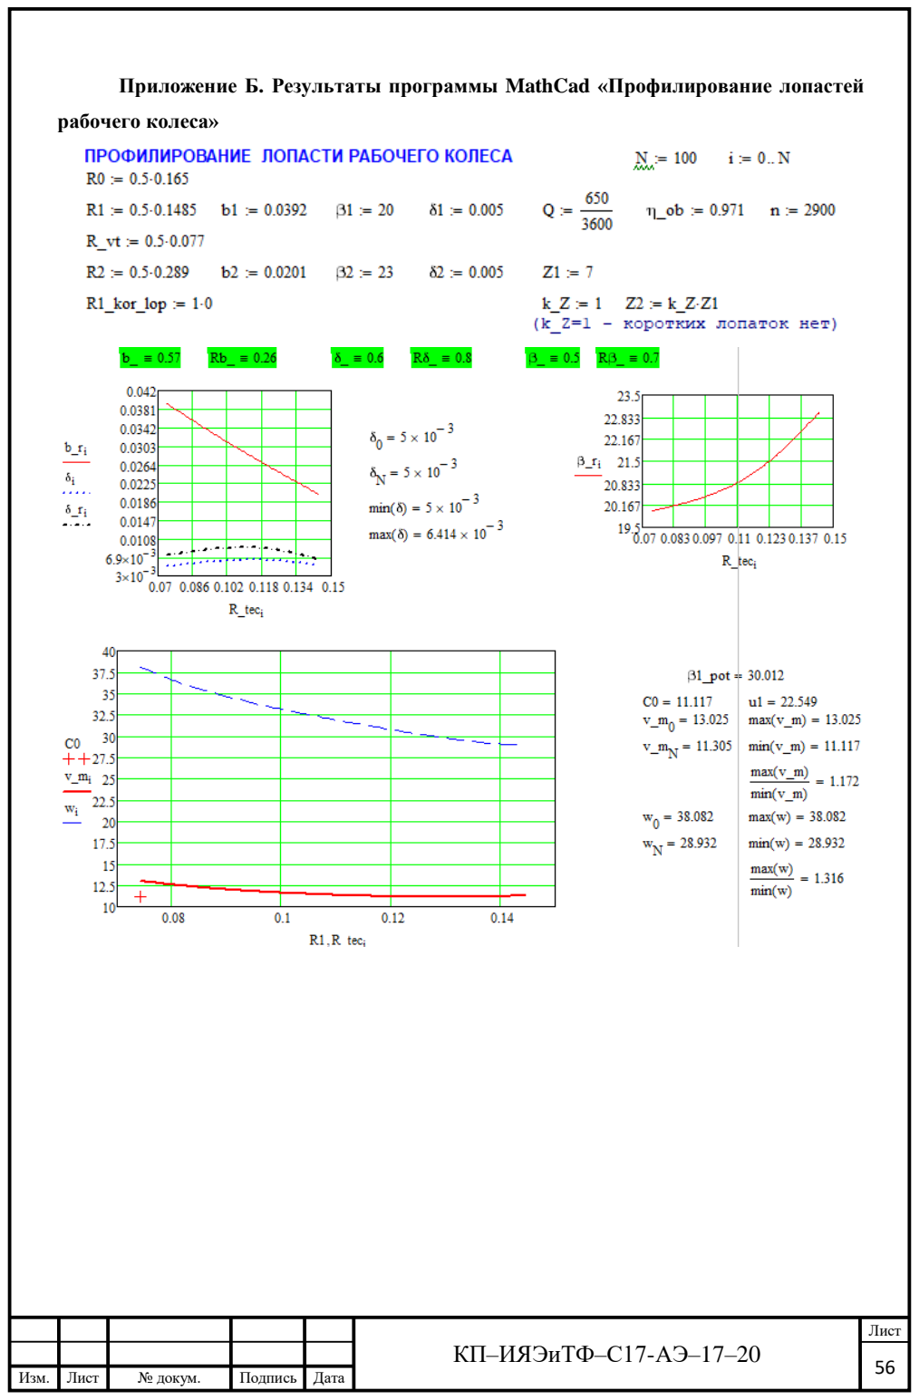
[picture p99: page 56]

Приложение Б. Результаты программы MathCad «Профилирование лопастей

рабочего колеса»
