itstajiri/main/3kurs/Nasosi/Доки/Untitled-1.png

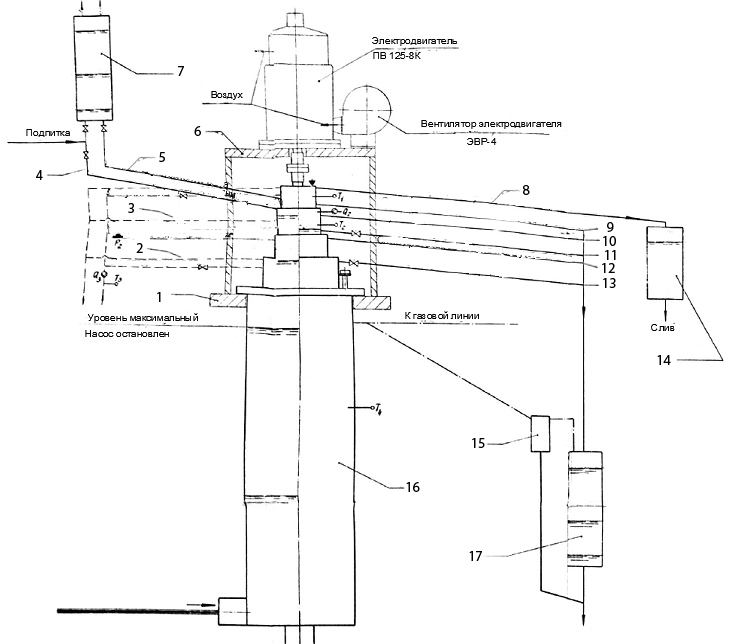
3kurs/Nasosi/Доки/Untitled-1.png
