itstajiri/main/3kurs/Nasosi/Помойка/Screenshot_1.png

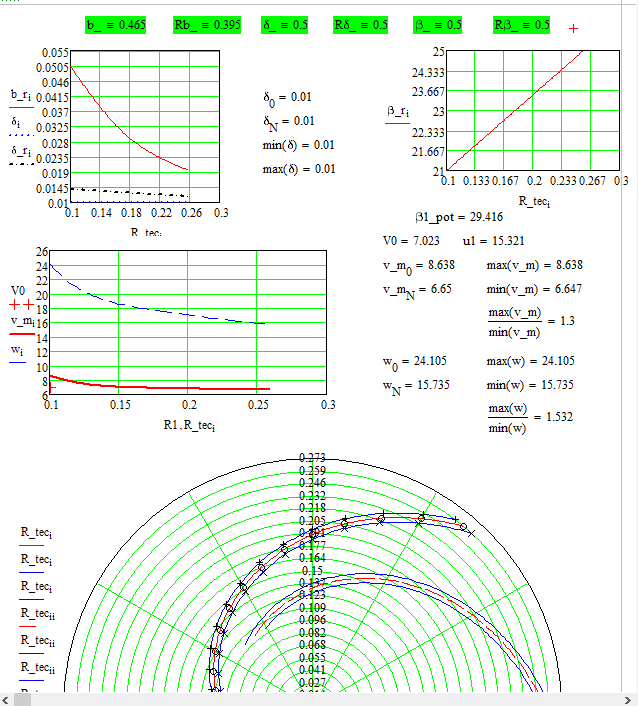
3kurs/Nasosi/Помойка/Screenshot_1.png
