itstajiri/main/3kurs/Nasosi/Помойка/Screenshot_2.png

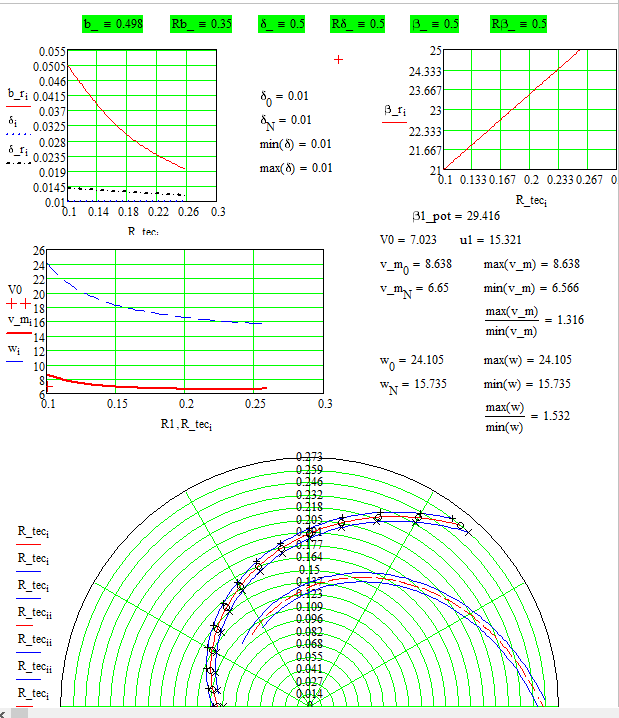
3kurs/Nasosi/Помойка/Screenshot_2.png
