itstajiri/main/3kurs/Nasosi/Помойка/Screenshot_4.png

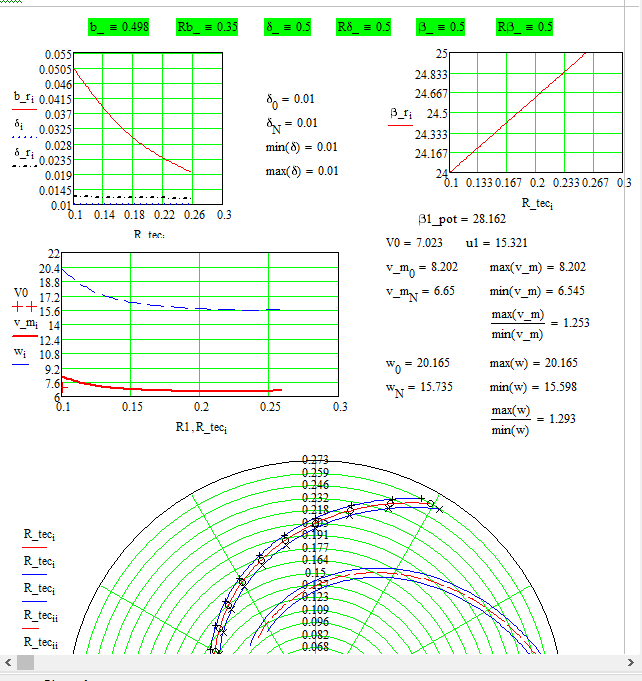
3kurs/Nasosi/Помойка/Screenshot_4.png
