itstajiri/main/(list of files, cad)

Other CAD files:
3kurs/Nasosi/NSS_FULL.dwg
3kurs/Nasosi/NSS_FULL — копия — копия.dwg
3kurs/Nasosi/NSS_FULL — копия.dwg
3kurs/Nasosi/NSS_specops.dwg
3kurs/Nasosi/Одобрено/Чертежи/Схема НА — копия — копия.dwg
3kurs/Nasosi/sborochnik.dwg
3kurs/Nasosi/Одобрено/Чертежи/MERID_F1_колесо.dwg
3kurs/Nasosi/NSS_VMN — копия — копия.dwg
3kurs/Nasosi/Одобрено/Чертежи/MERID_F_сечение.dwg
3kurs/Nasosi/NSS_VMN — копия.dwg
3kurs/Nasosi/Мередианное.dwg
3kurs/Nasosi/MERID_F1 — копия.dwg
3kurs/Nasosi/НА.dwg
3kurs/Nasosi/Шпонка.dwg
3kurs/Nasosi/Треугольники скоростей.dwg
3kurs/Nasosi/MERID1.dwg
3kurs/Nasosi/Проточная часть.dwg
3kurs/Nasosi/НА — копия.dwg
3kurs/Nasosi/MERID_F1.dwg
3kurs/Nasosi/MERID.dwg
3kurs/Nasosi/NSS_FULL — копия (2).dwg
3kurs/Nasosi/NSS_FULL — копия (3).dwg
