itstajiri/main/3kurs/Nasosi/Доки/Сборочный чертёж.pdf

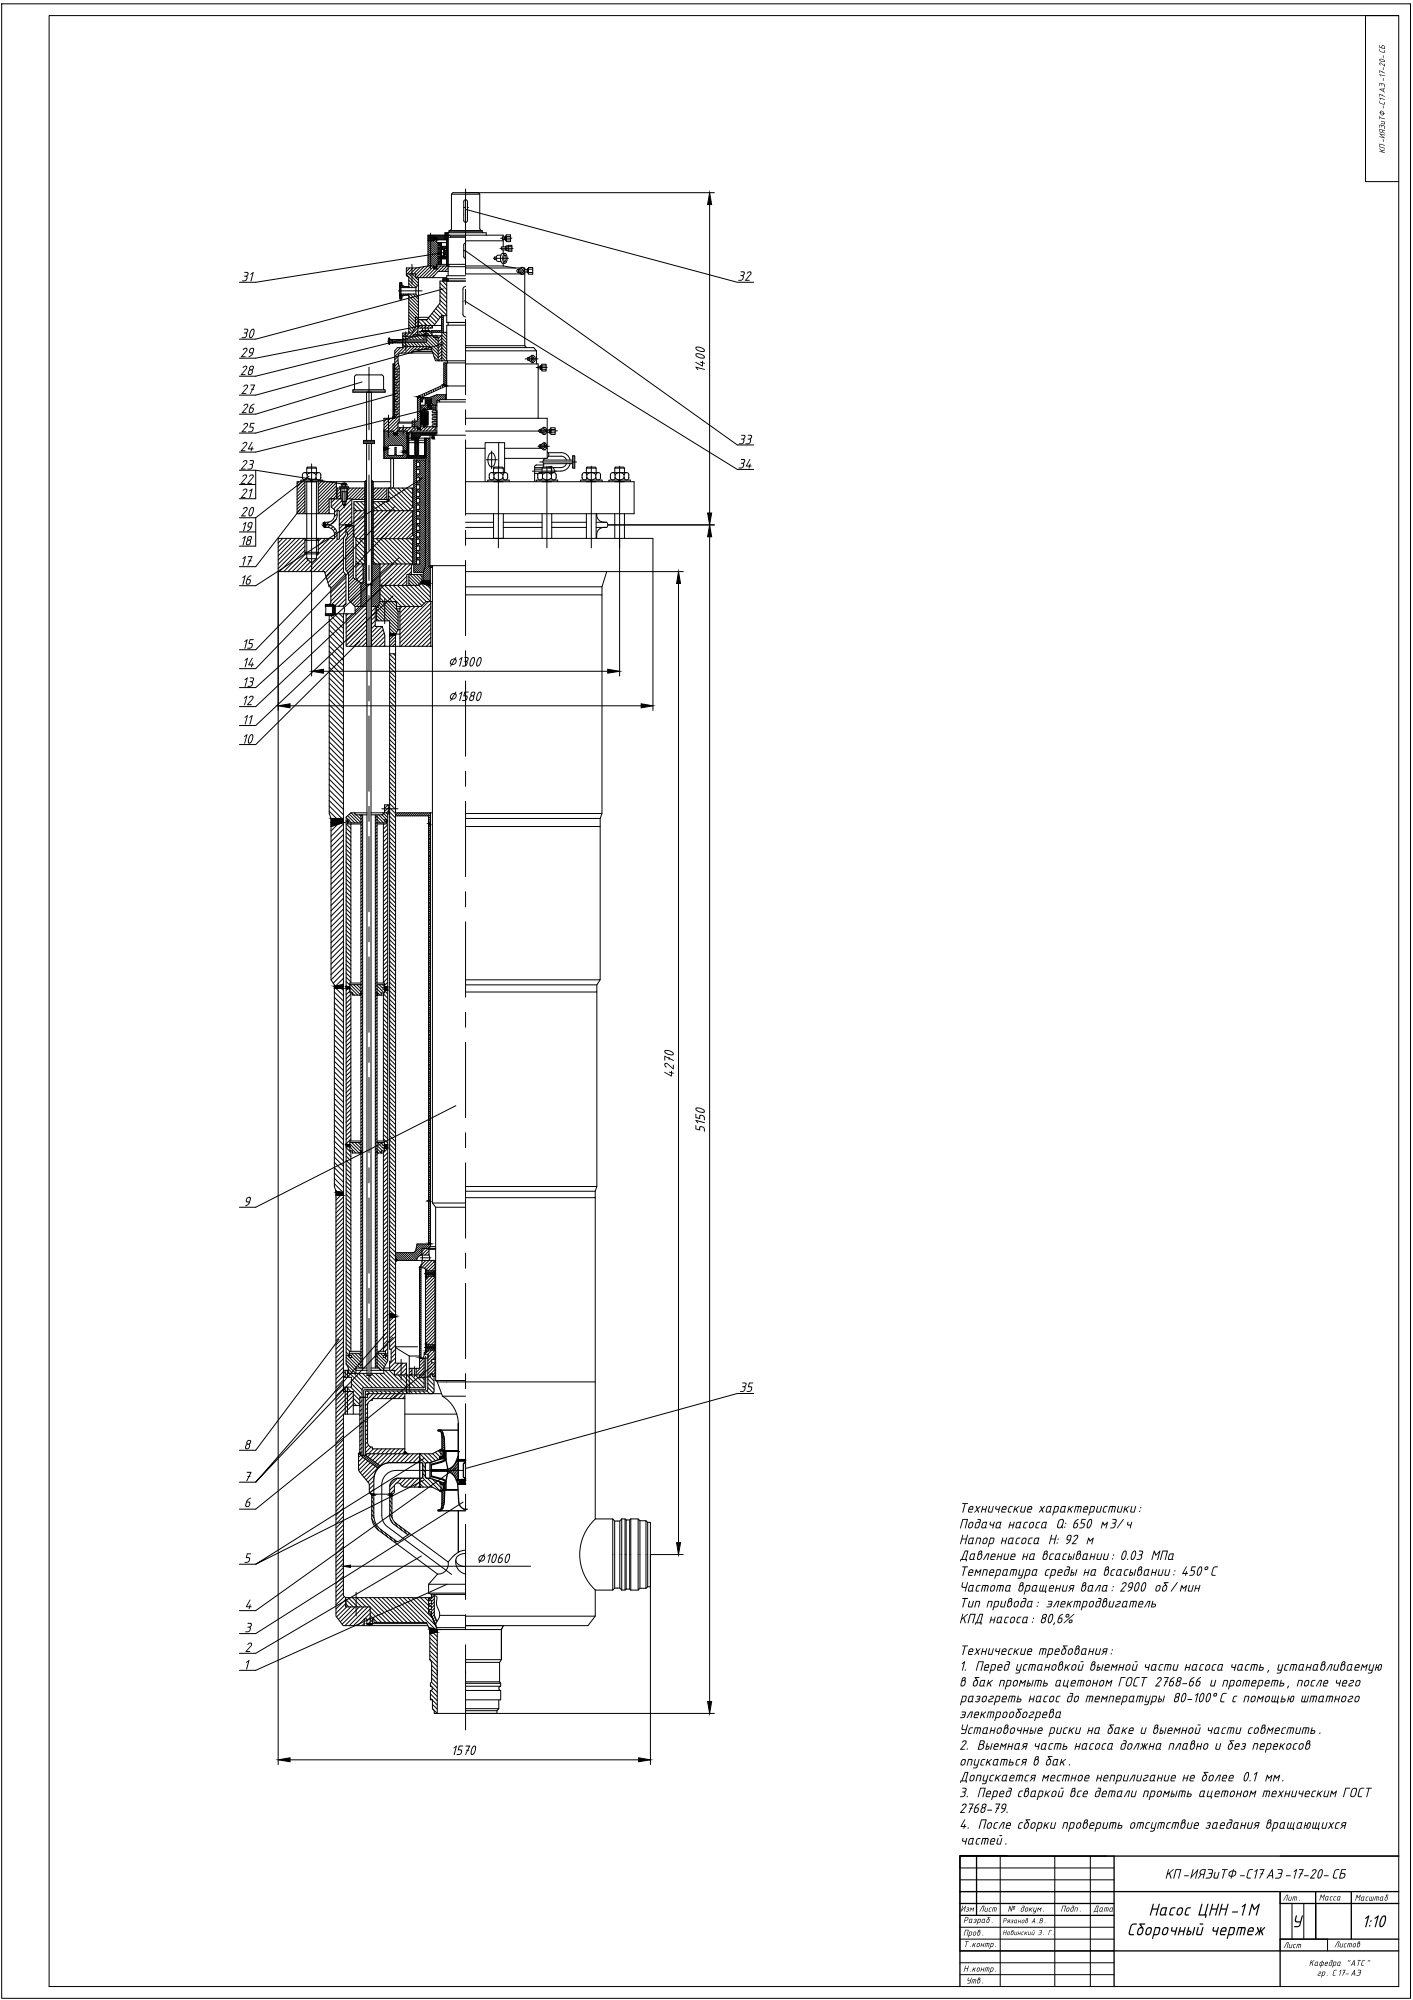
[picture p136: page 1]
