itstajiri/main/3kurs/Nasosi/Доки/Итог/Приложение 2. Общий вид насосного агрегата.pdf

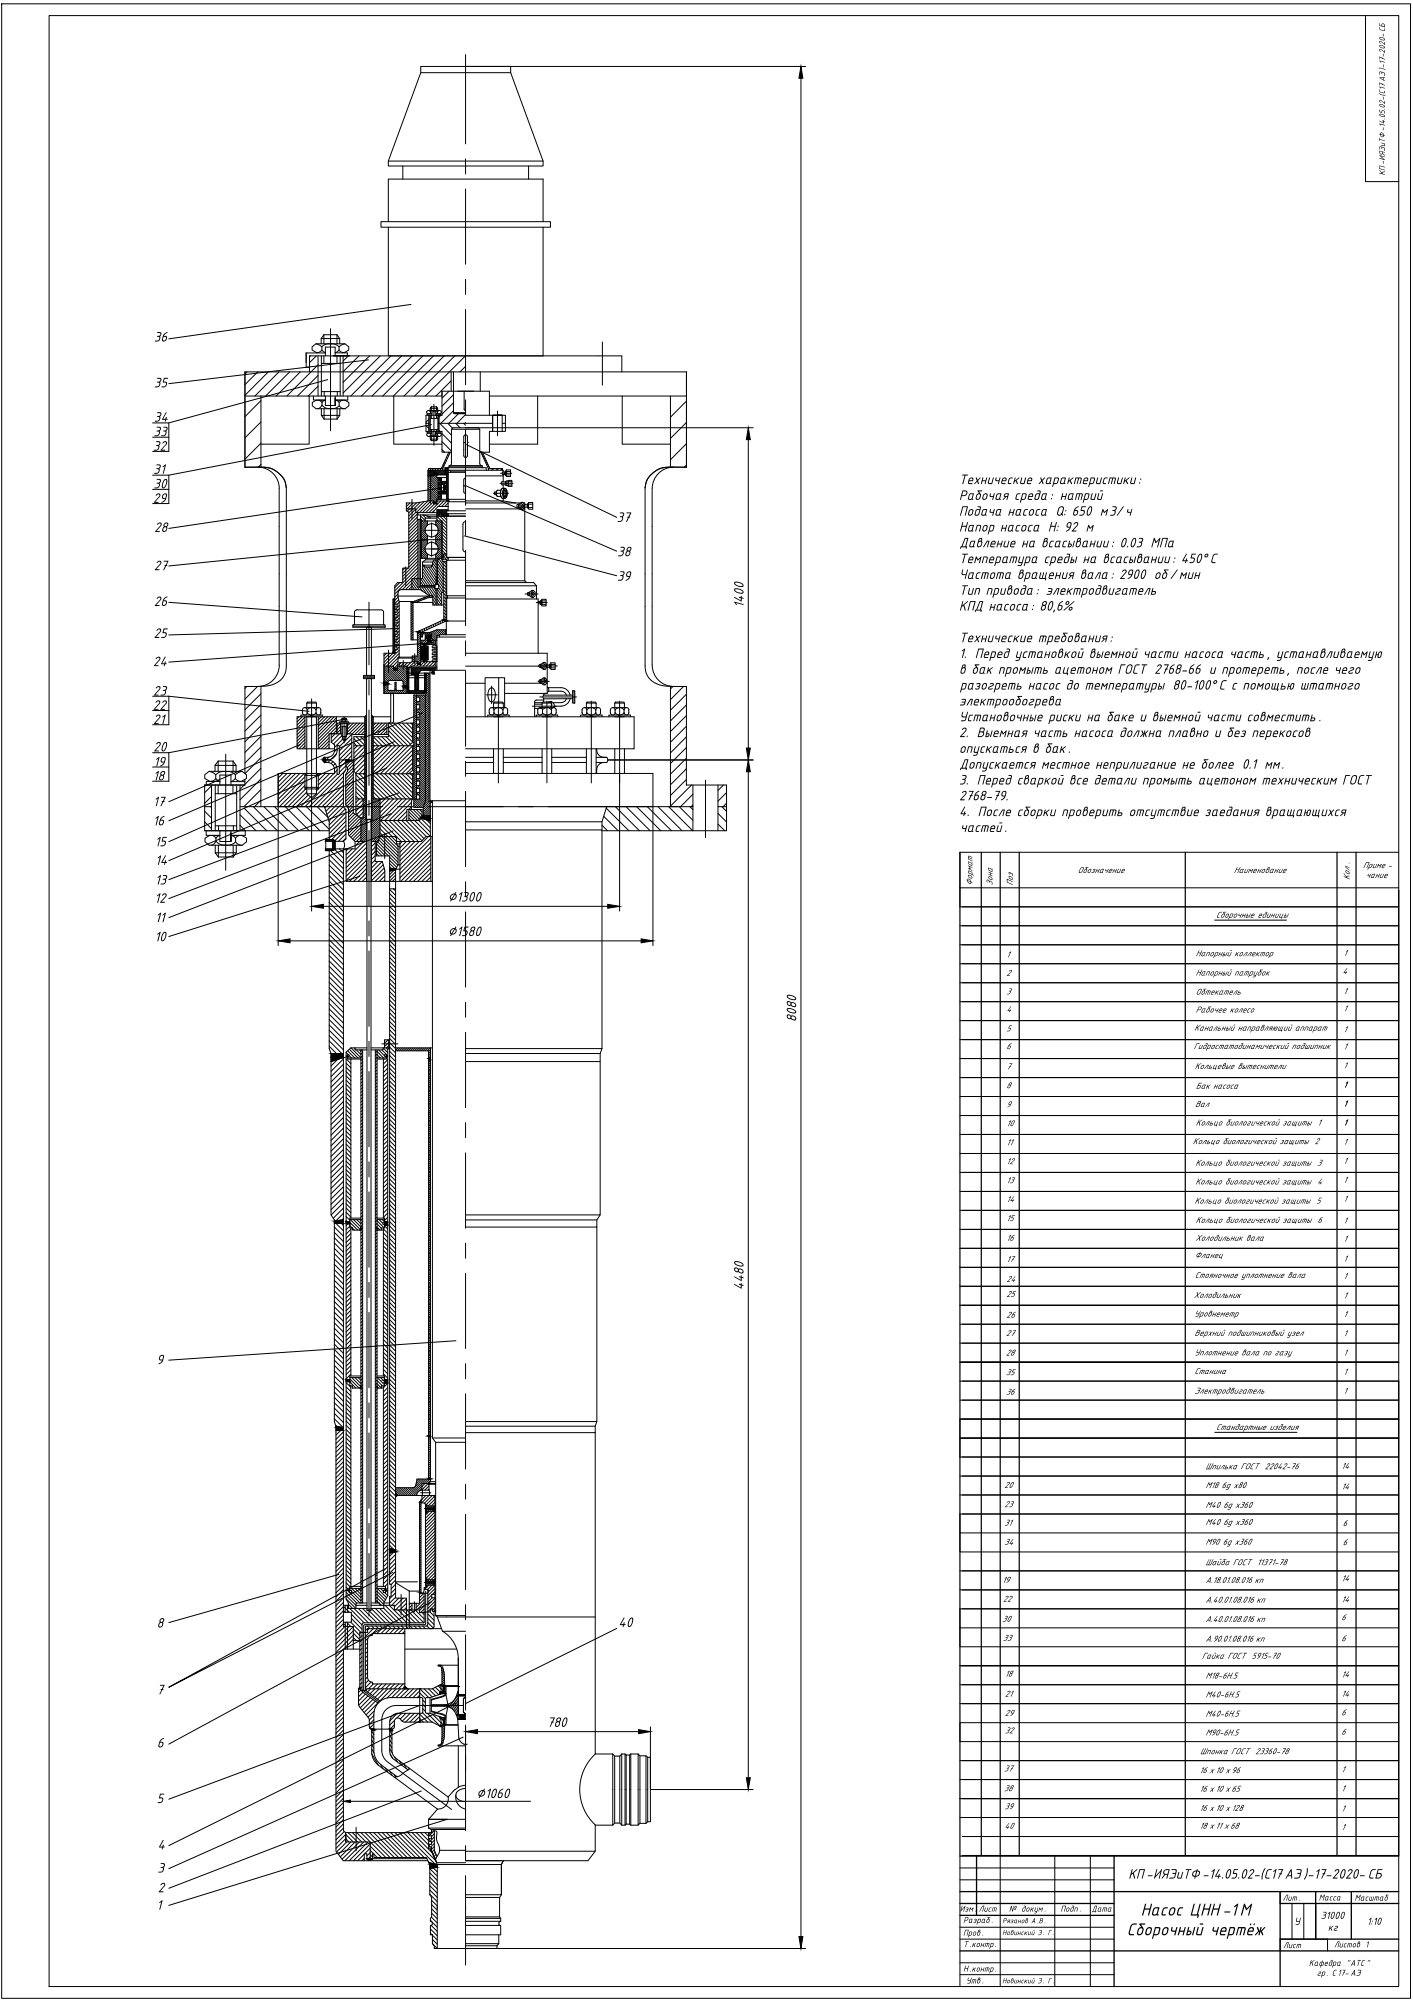
[picture p137: page 1]
