itstajiri/main/3kurs/Nasosi/Доки/NSS_specops.pdf

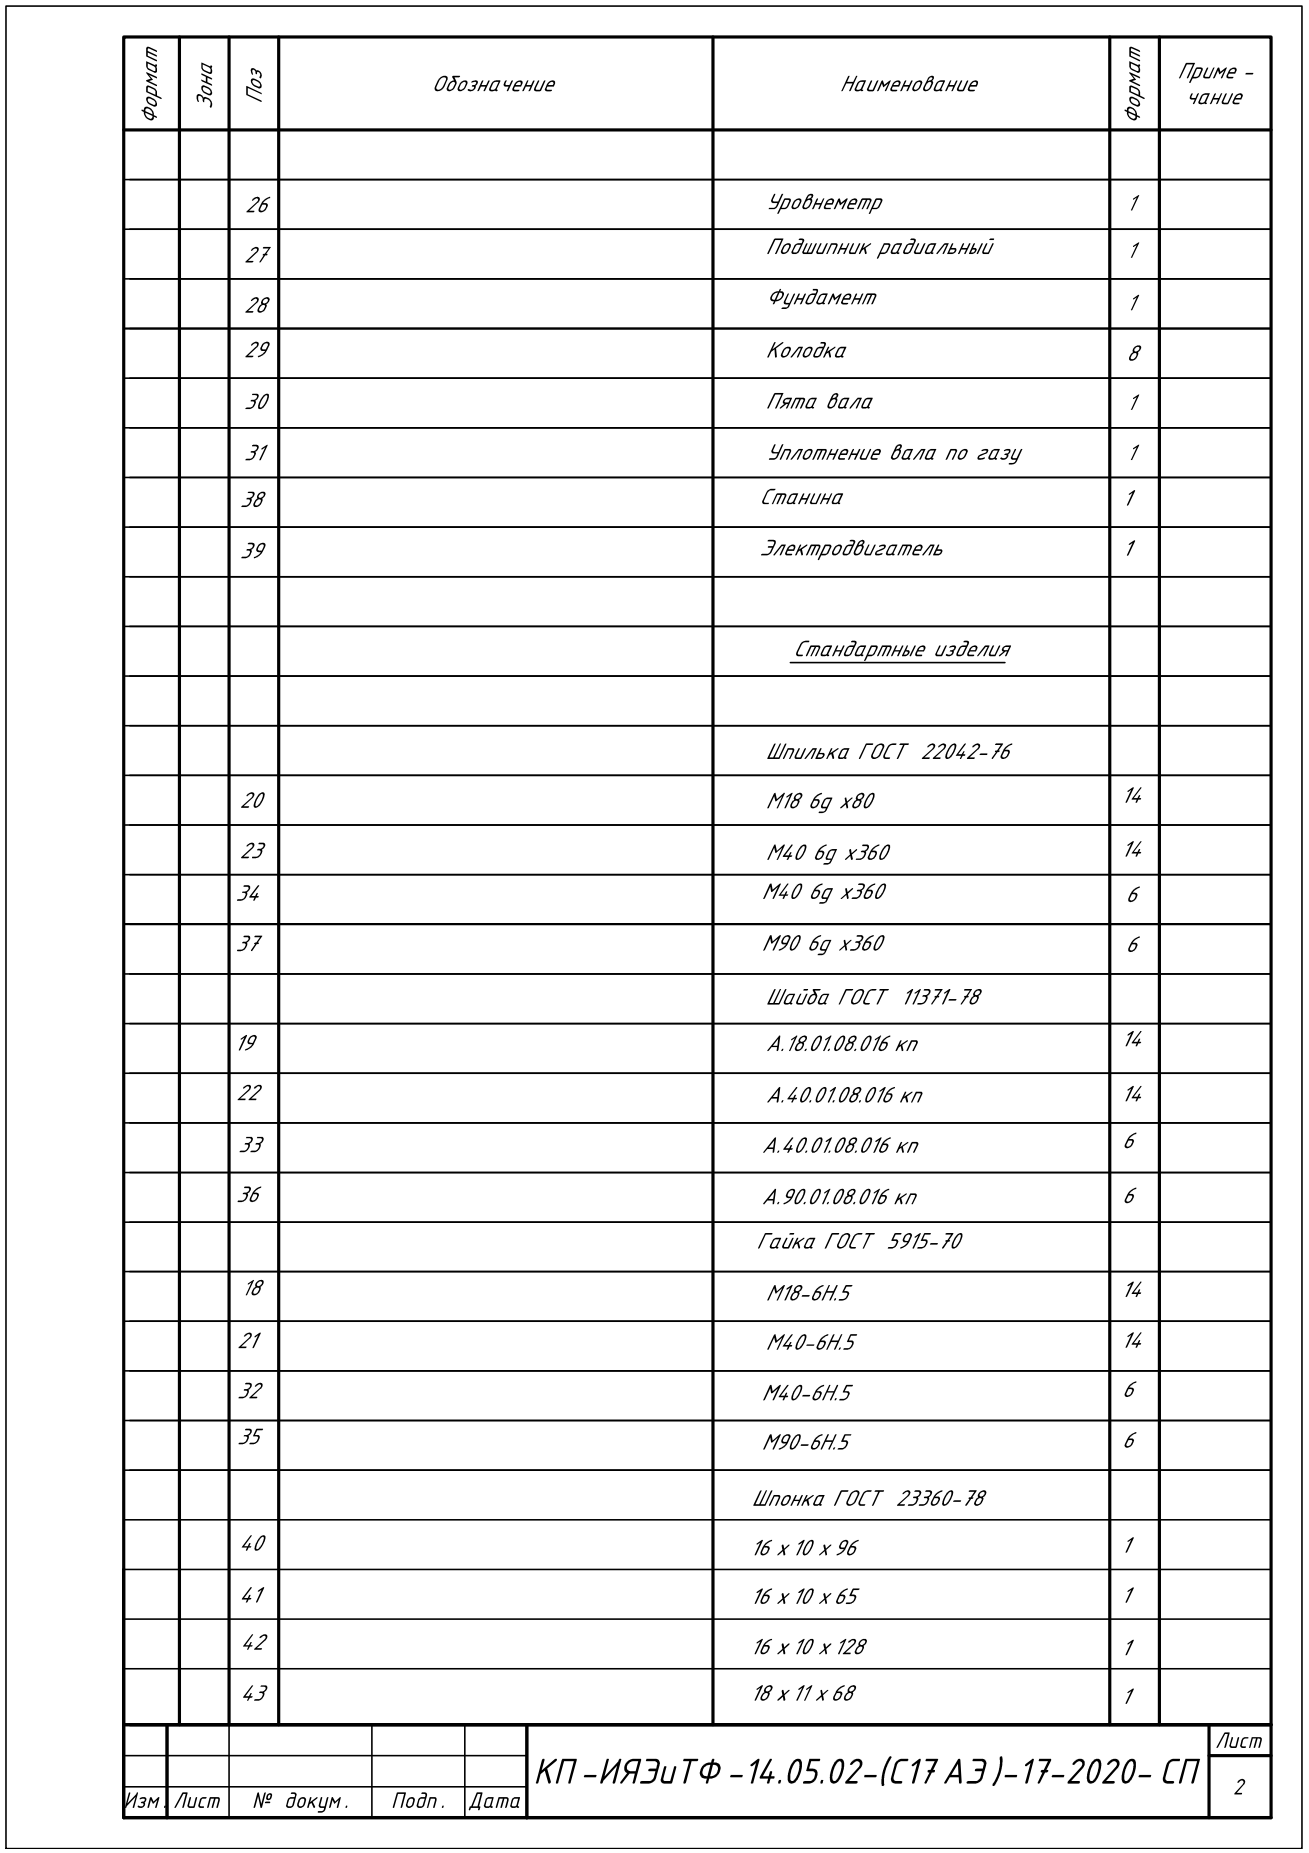
[picture p109: page 1]
