itstajiri/main/3kurs/Nasosi/MERID_F1 — копия.pdf

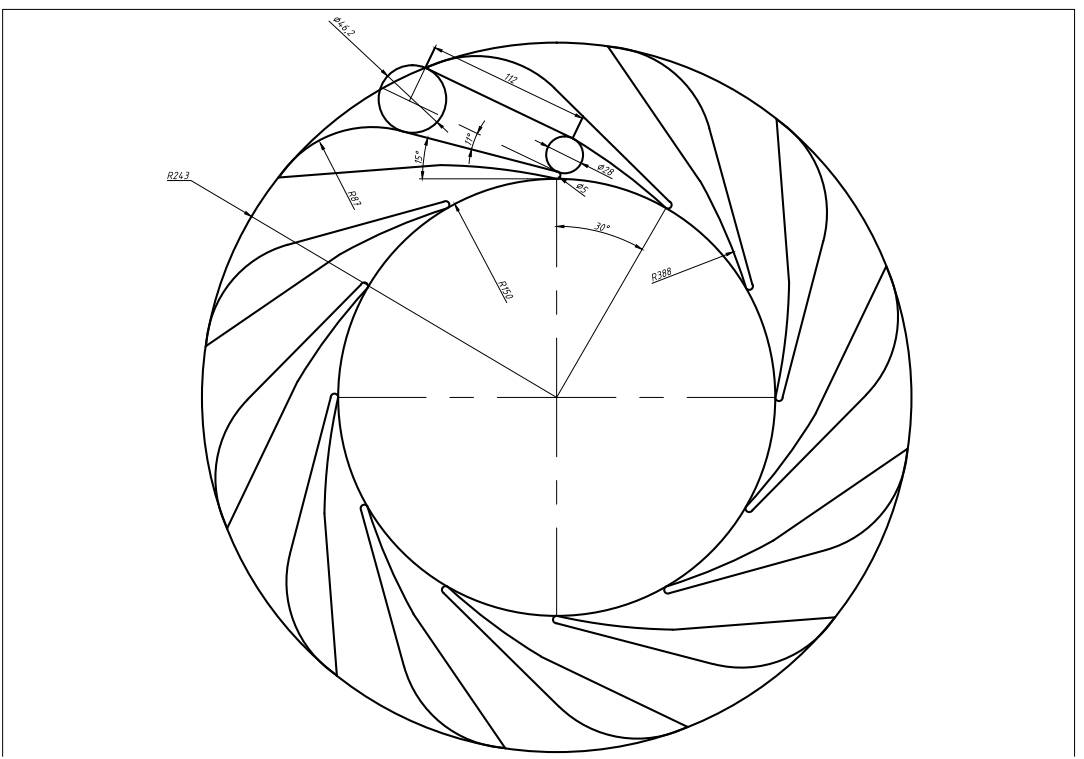
[picture p110: page 1]
