itstajiri/main/3kurs/Nasosi/NSS_FULL — копия.pdf

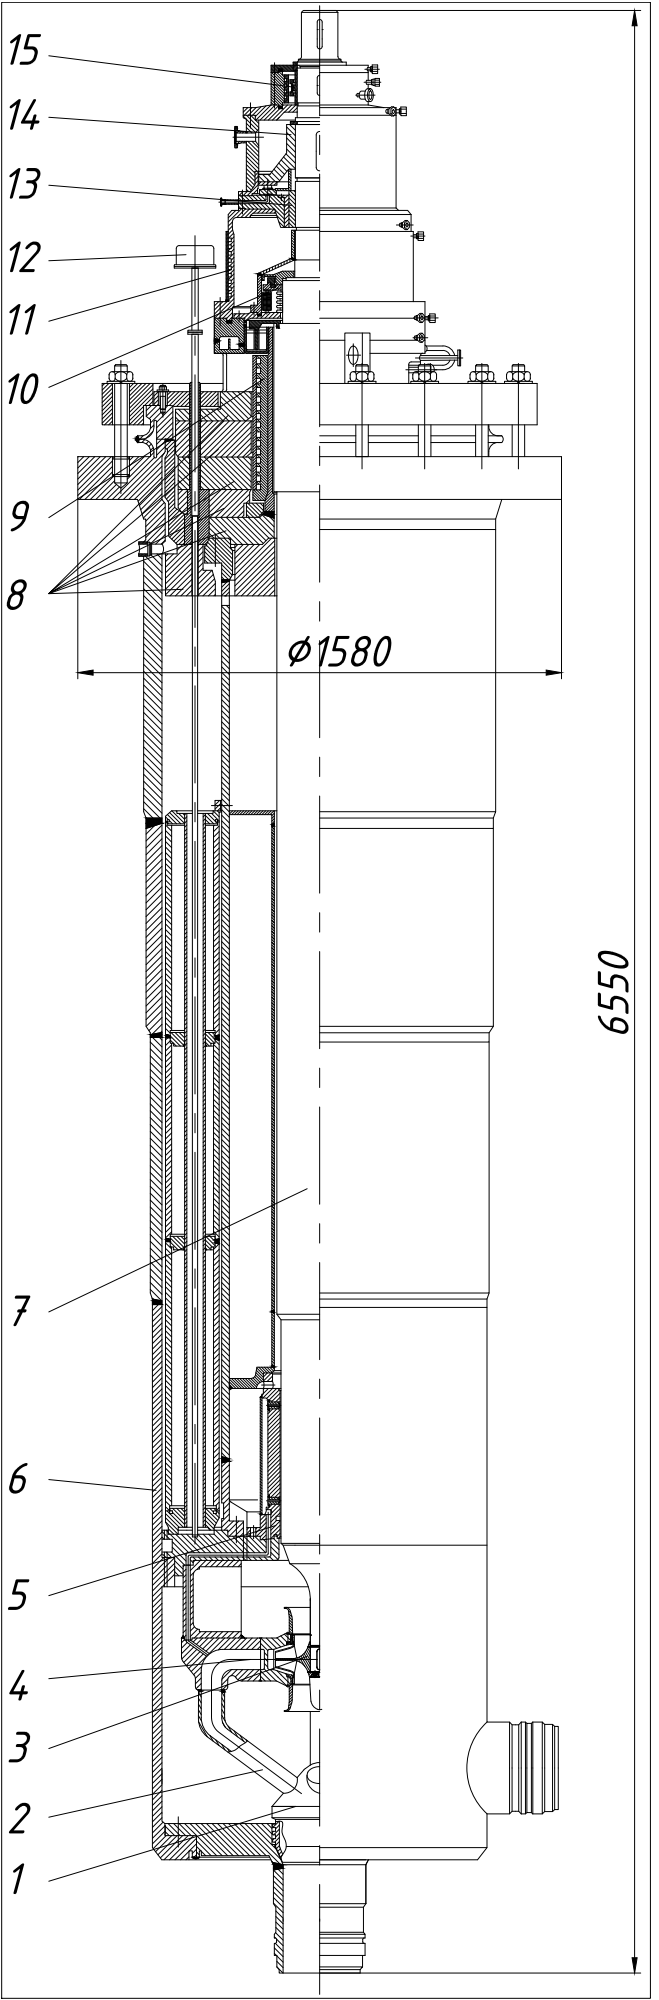
[picture p111: page 1]
