itstajiri/main/3kurs/Nasosi/Мередианное.pdf

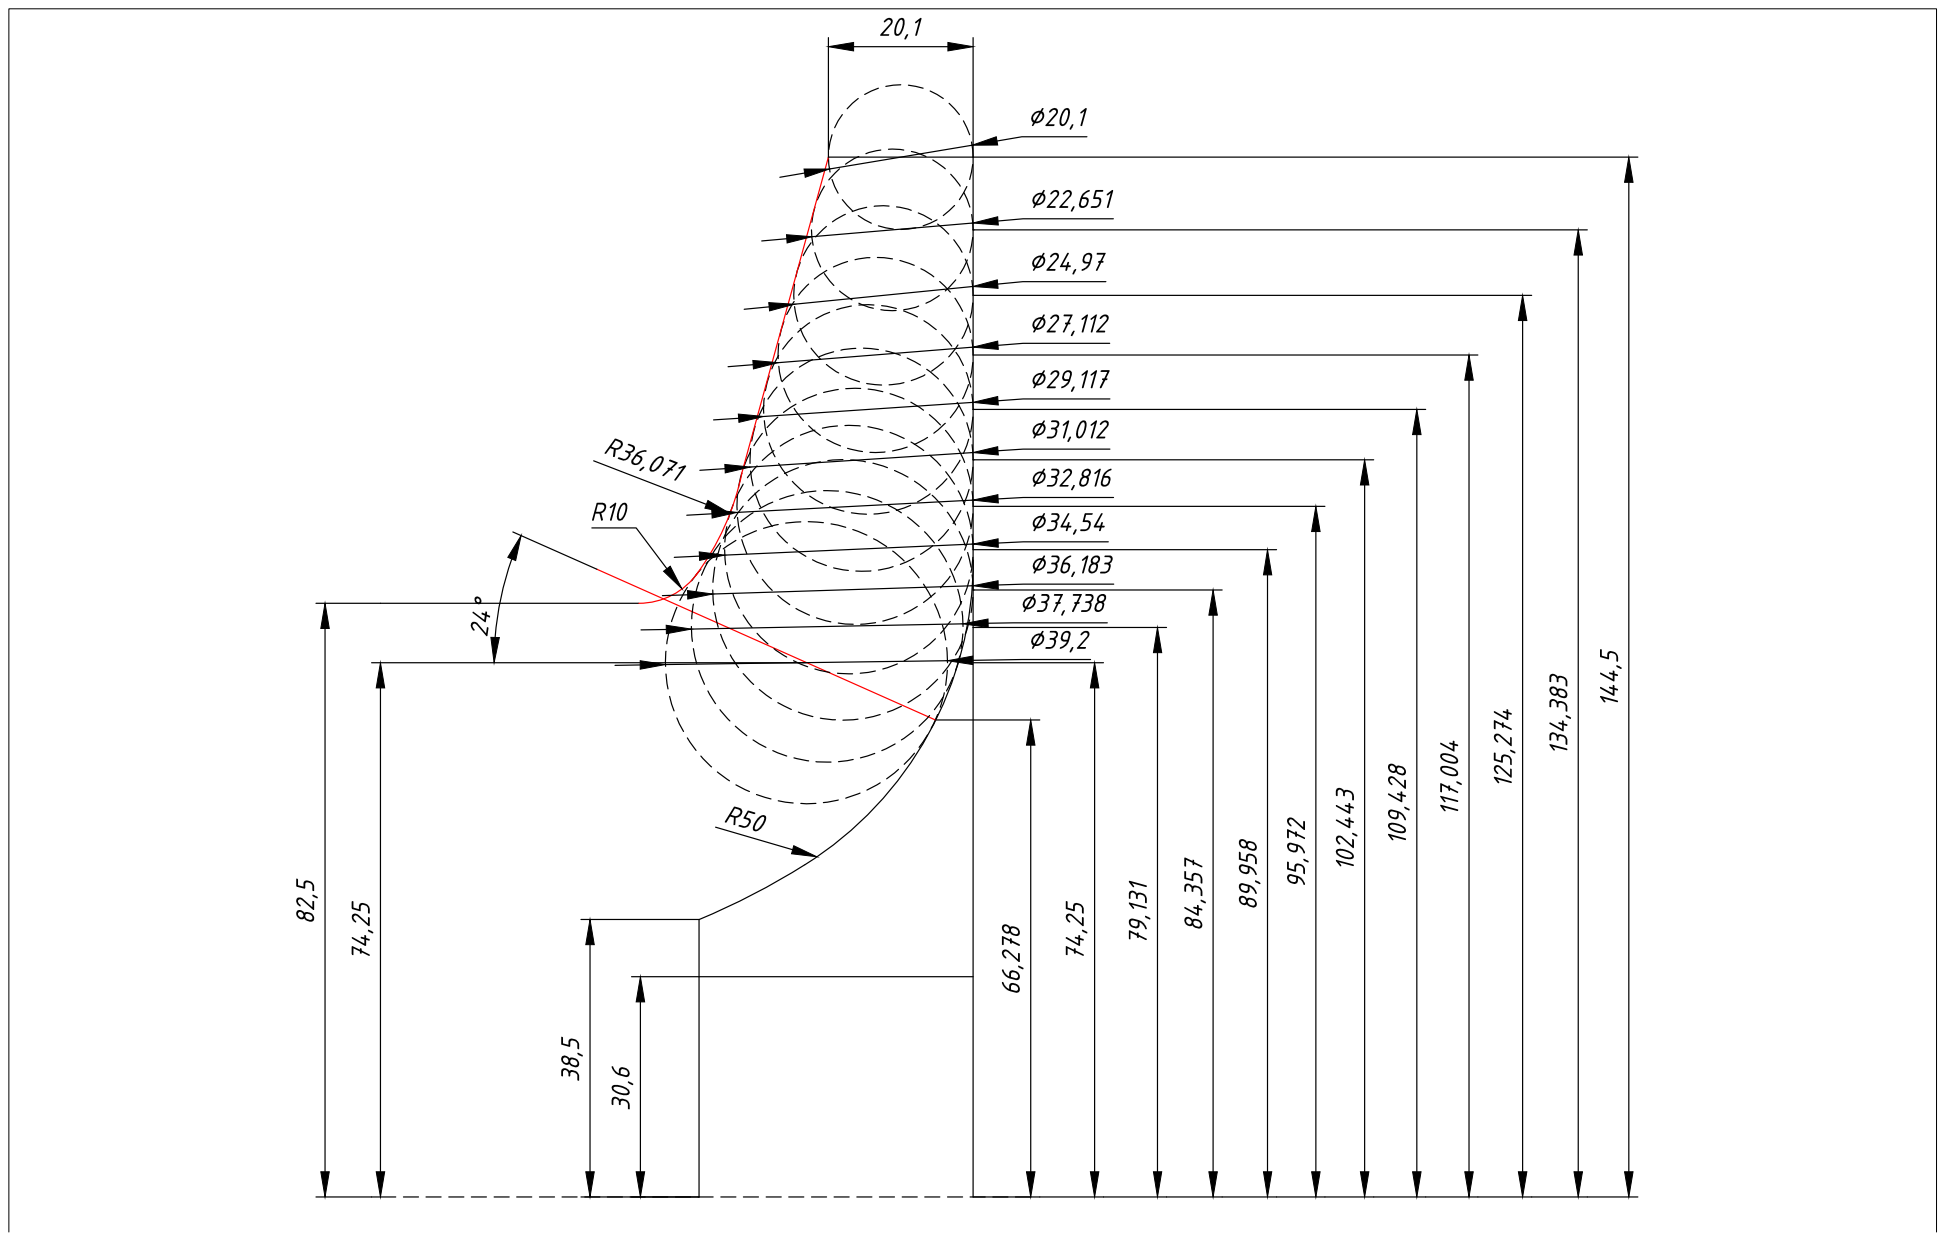
[picture p112: page 1]
