itstajiri/main/3kurs/Nasosi/Мередианное3.pdf

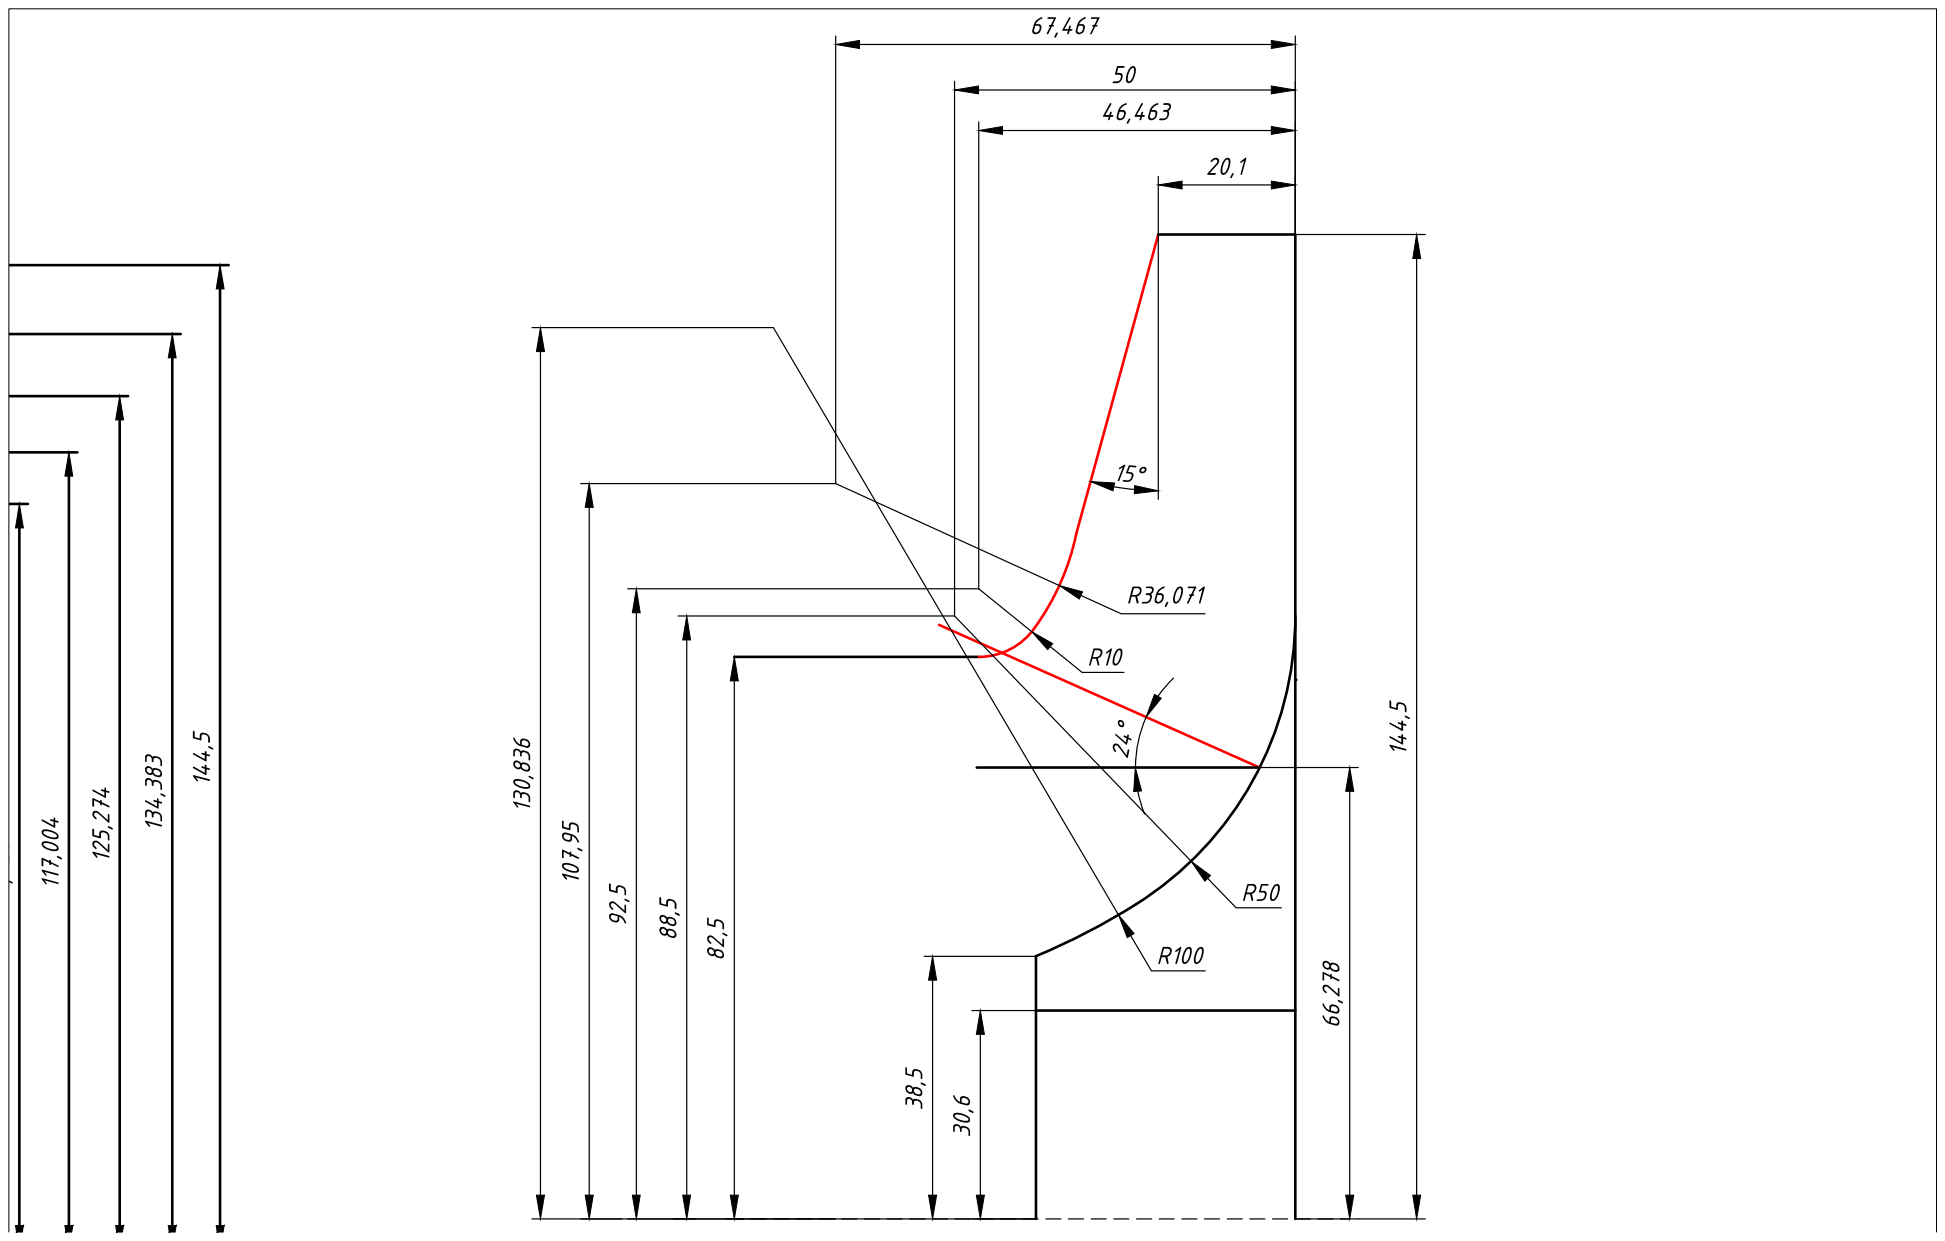
[picture p113: page 1]
