itstajiri/main/3kurs/Nasosi/Проточная часть.pdf

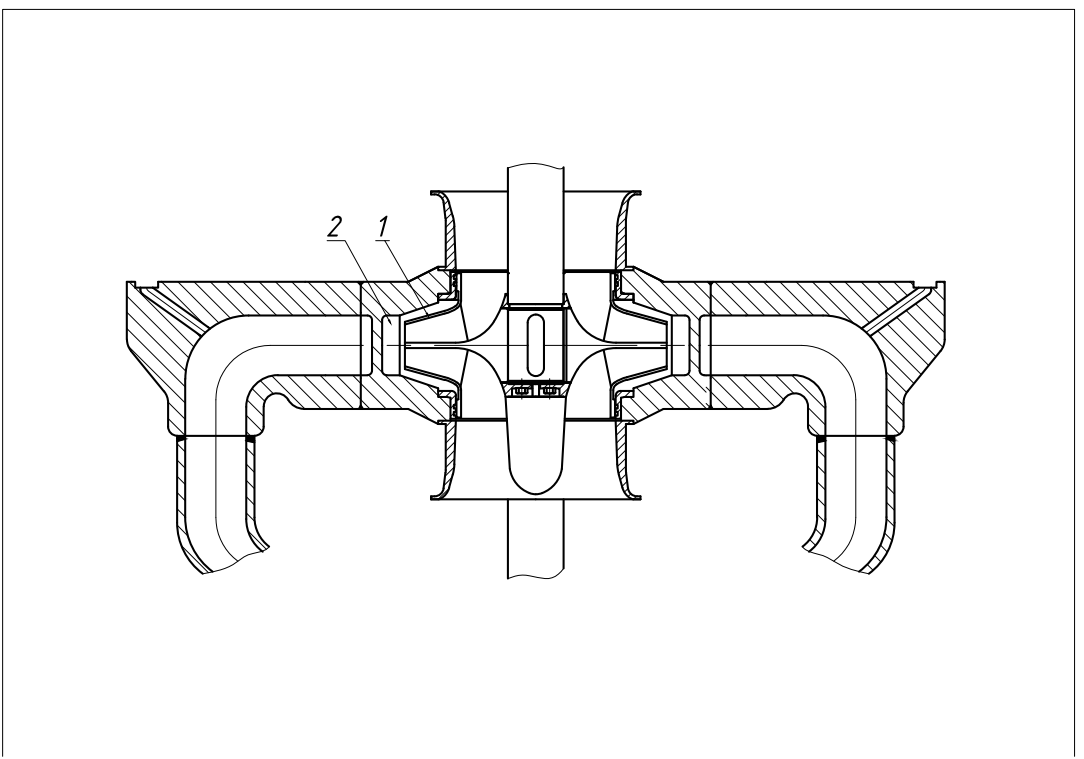
[picture p114: page 1]
