itstajiri/main/3kurs/Nasosi/Рабочее колесо.pdf

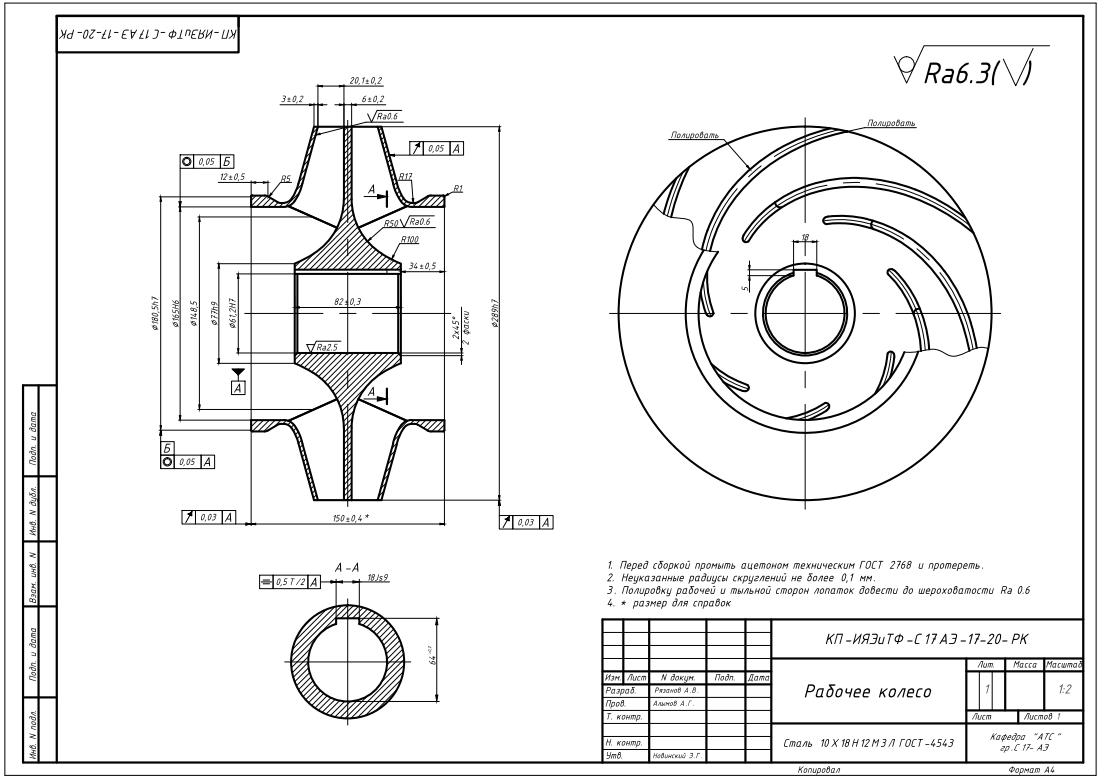
[picture p115: page 1]
