itstajiri/main/3kurs/Nasosi/Треугольник скоростей на входе.pdf

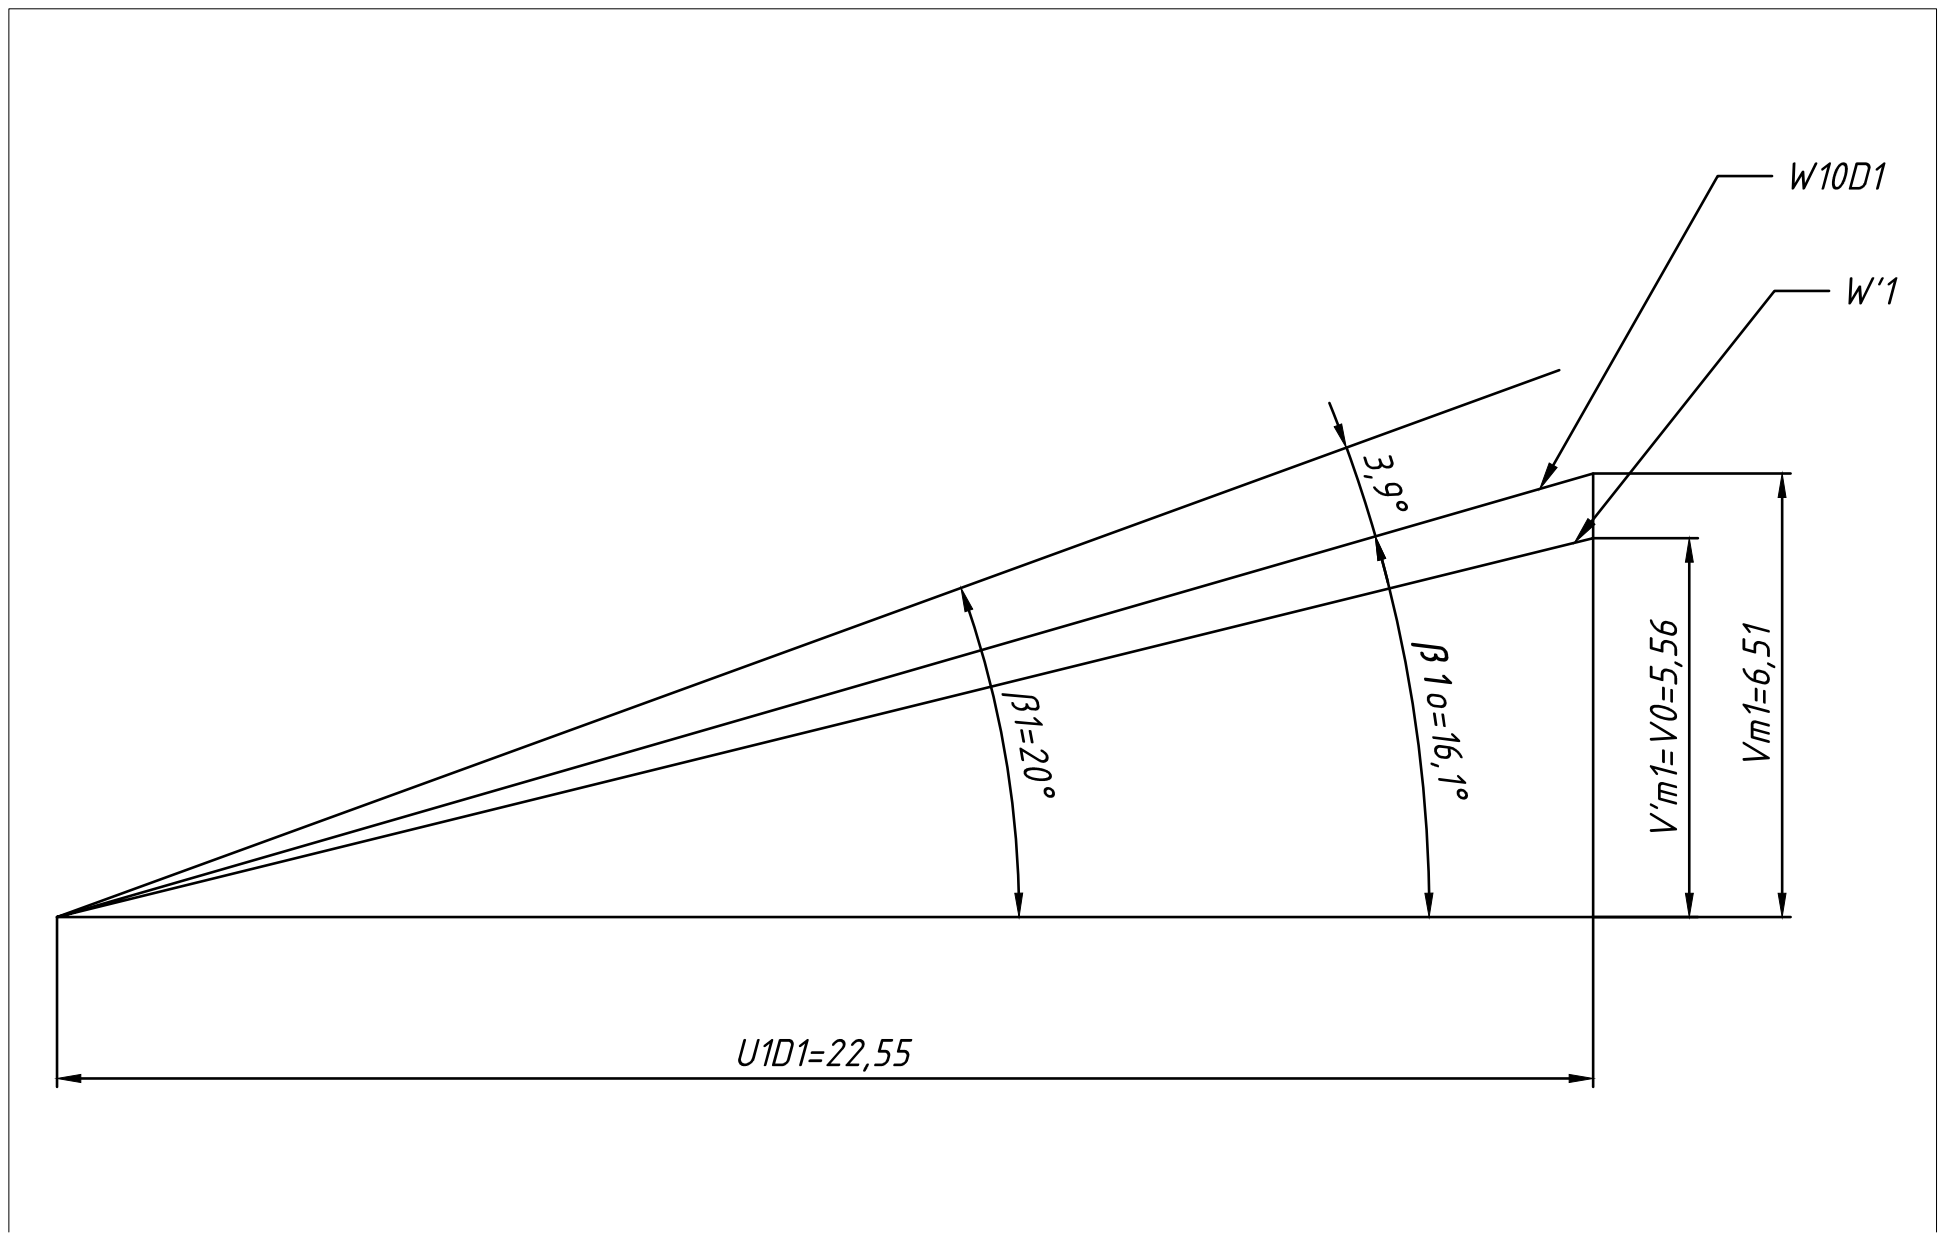
[picture p116: page 1]
