itstajiri/main/3kurs/Nasosi/Треугольник скоростей на выходе.pdf

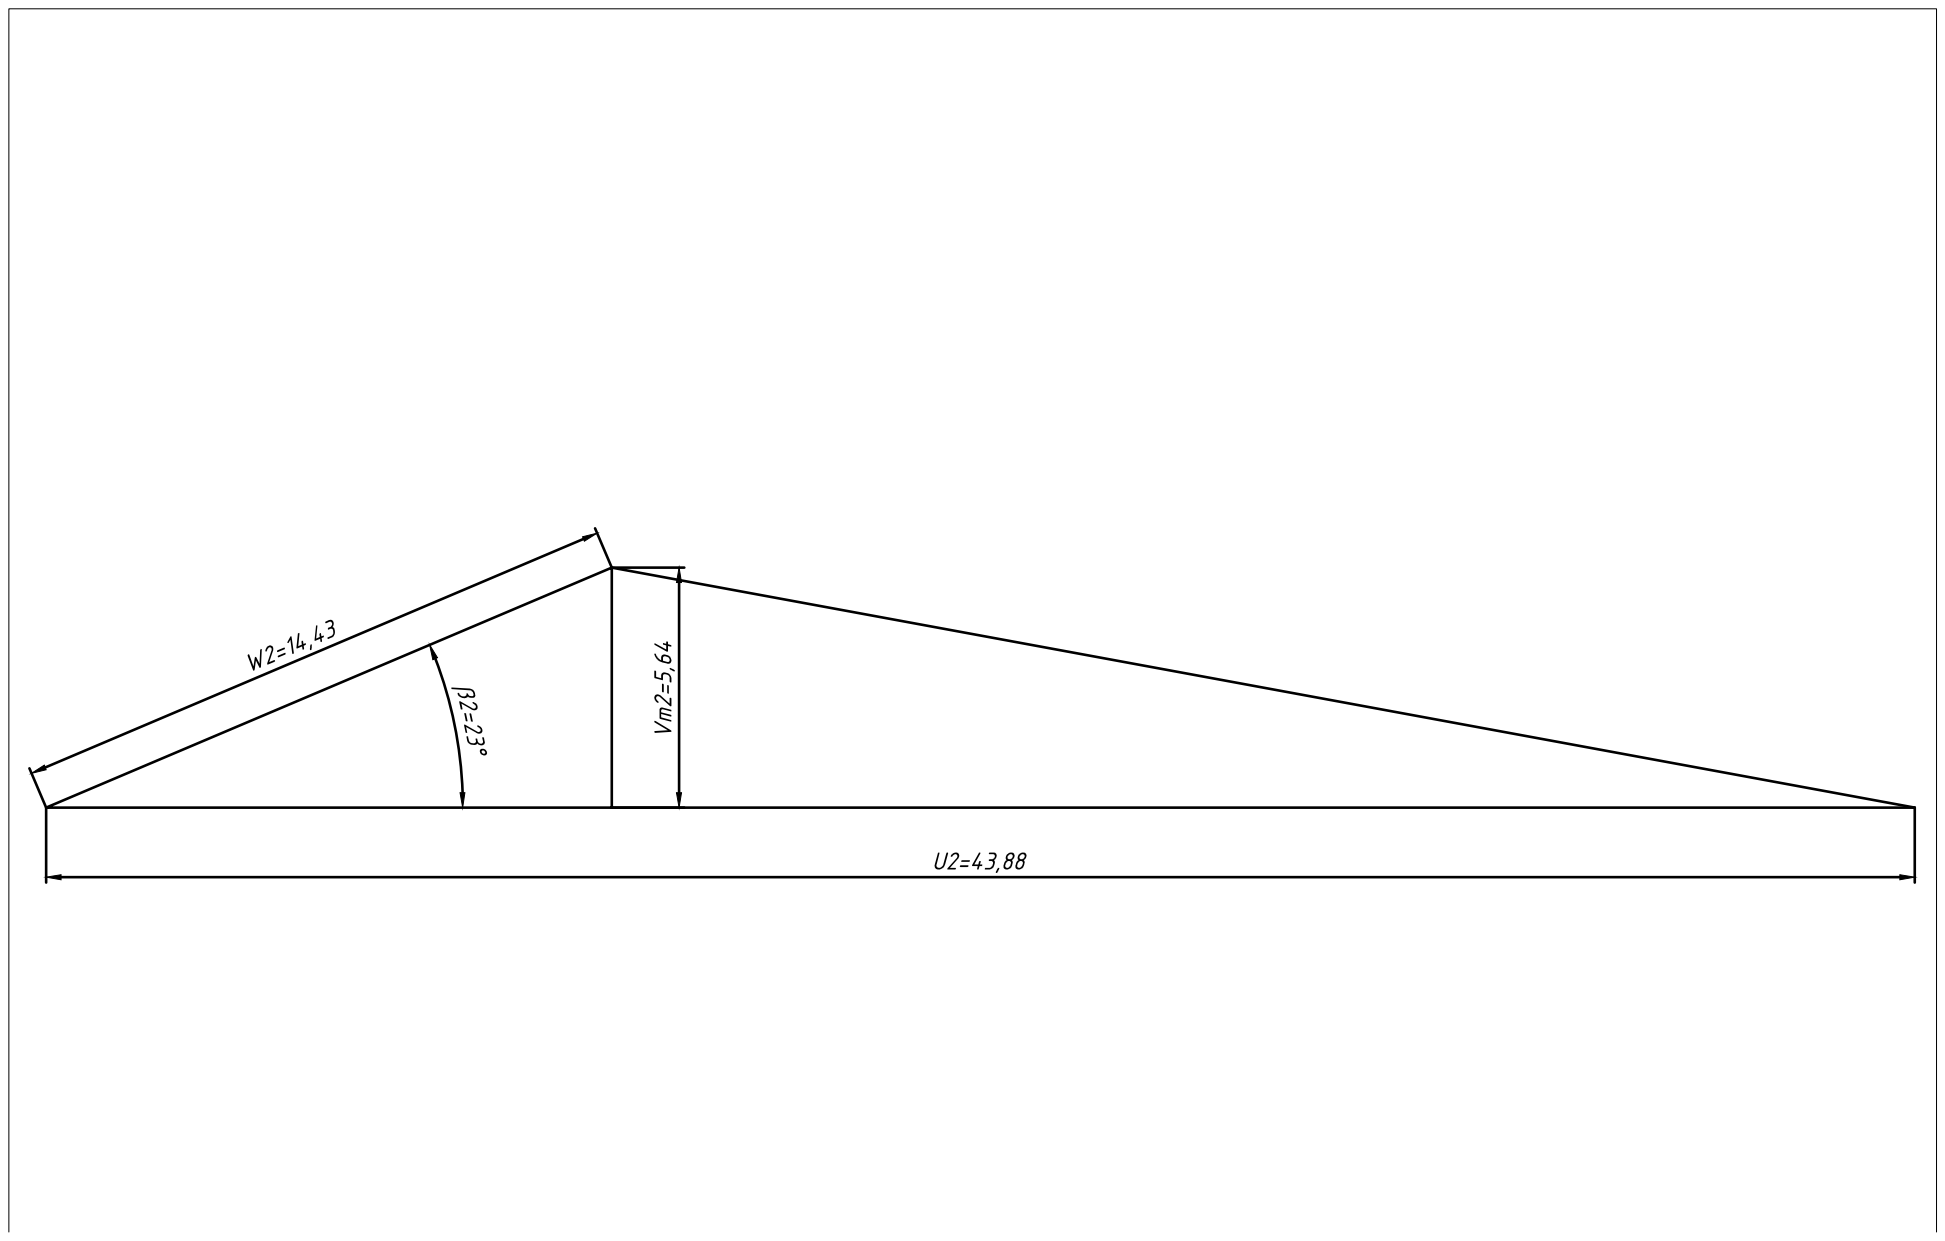
[picture p117: page 1]
