itstajiri/main/3kurs/Nasosi/Чертеж1.pdf

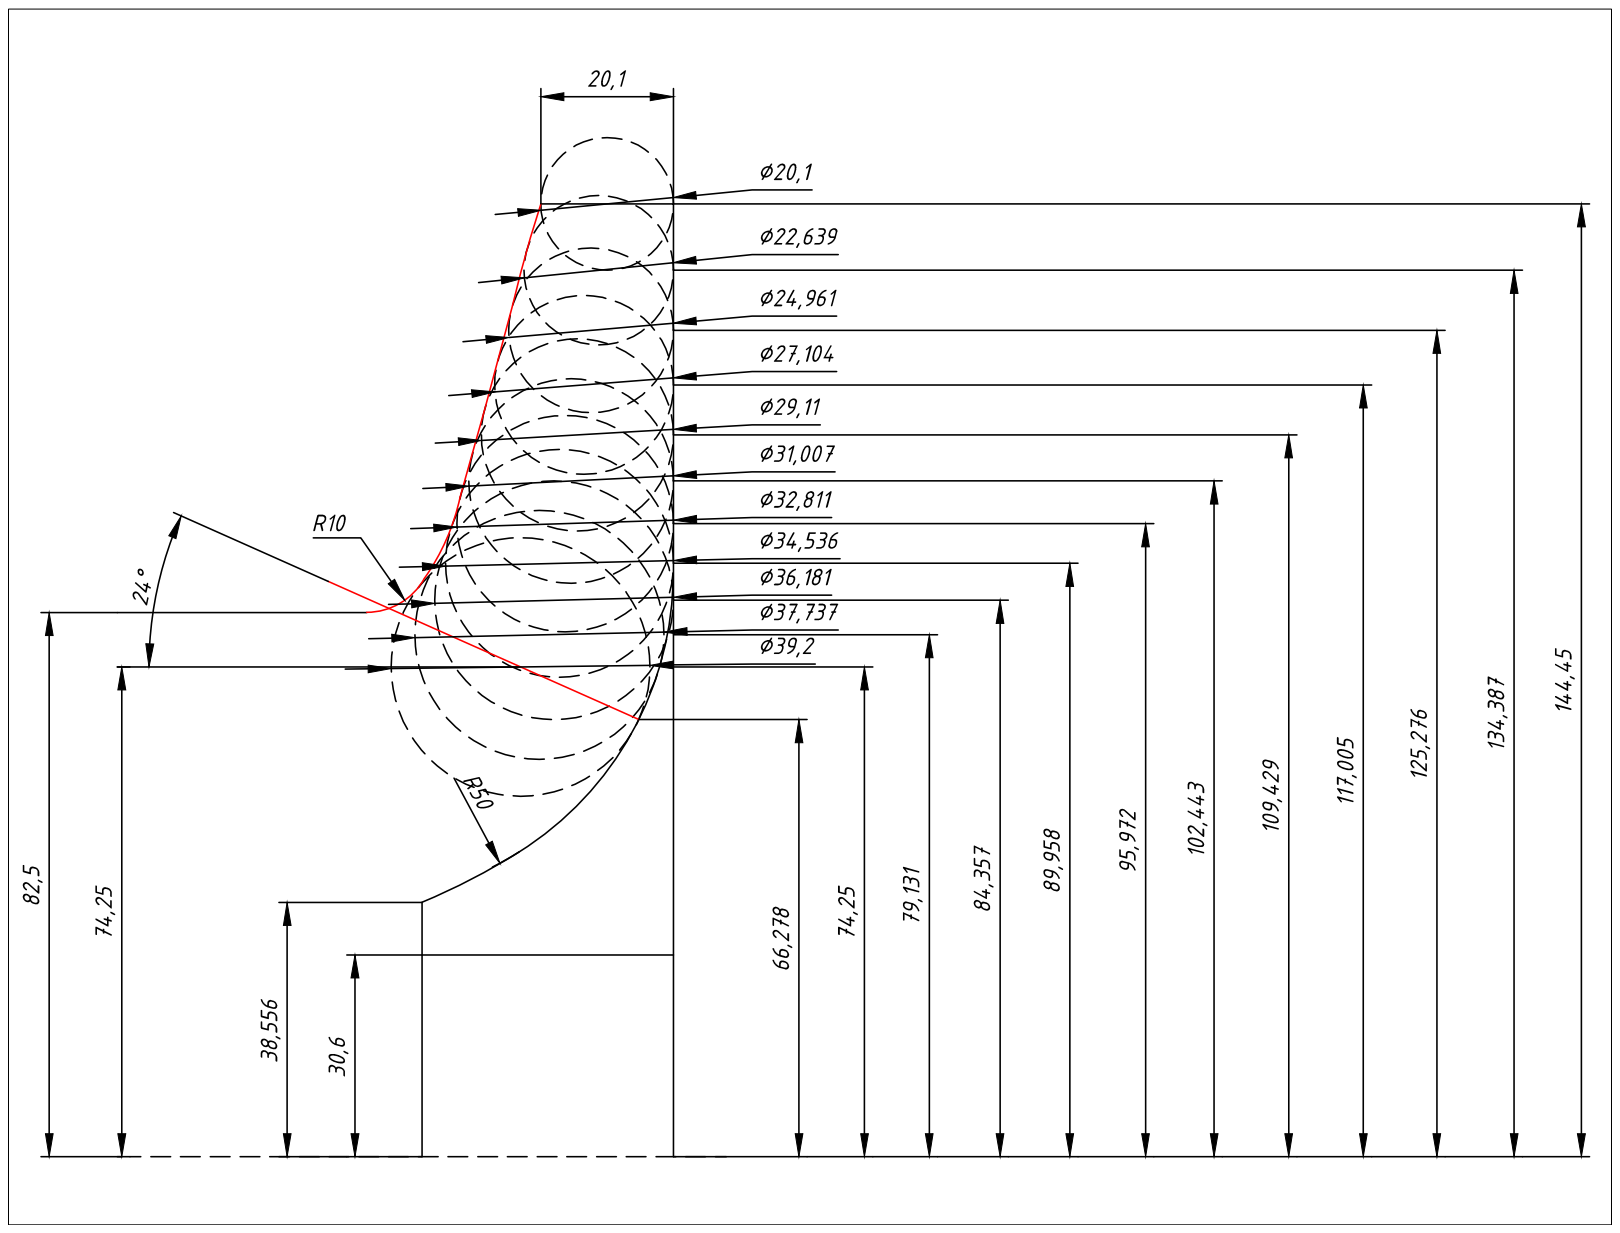
[picture p118: page 1]
