itstajiri/main/3kurs/Nasosi/Помойка/Приложение 2. Общий вид насосного агрегата.pdf

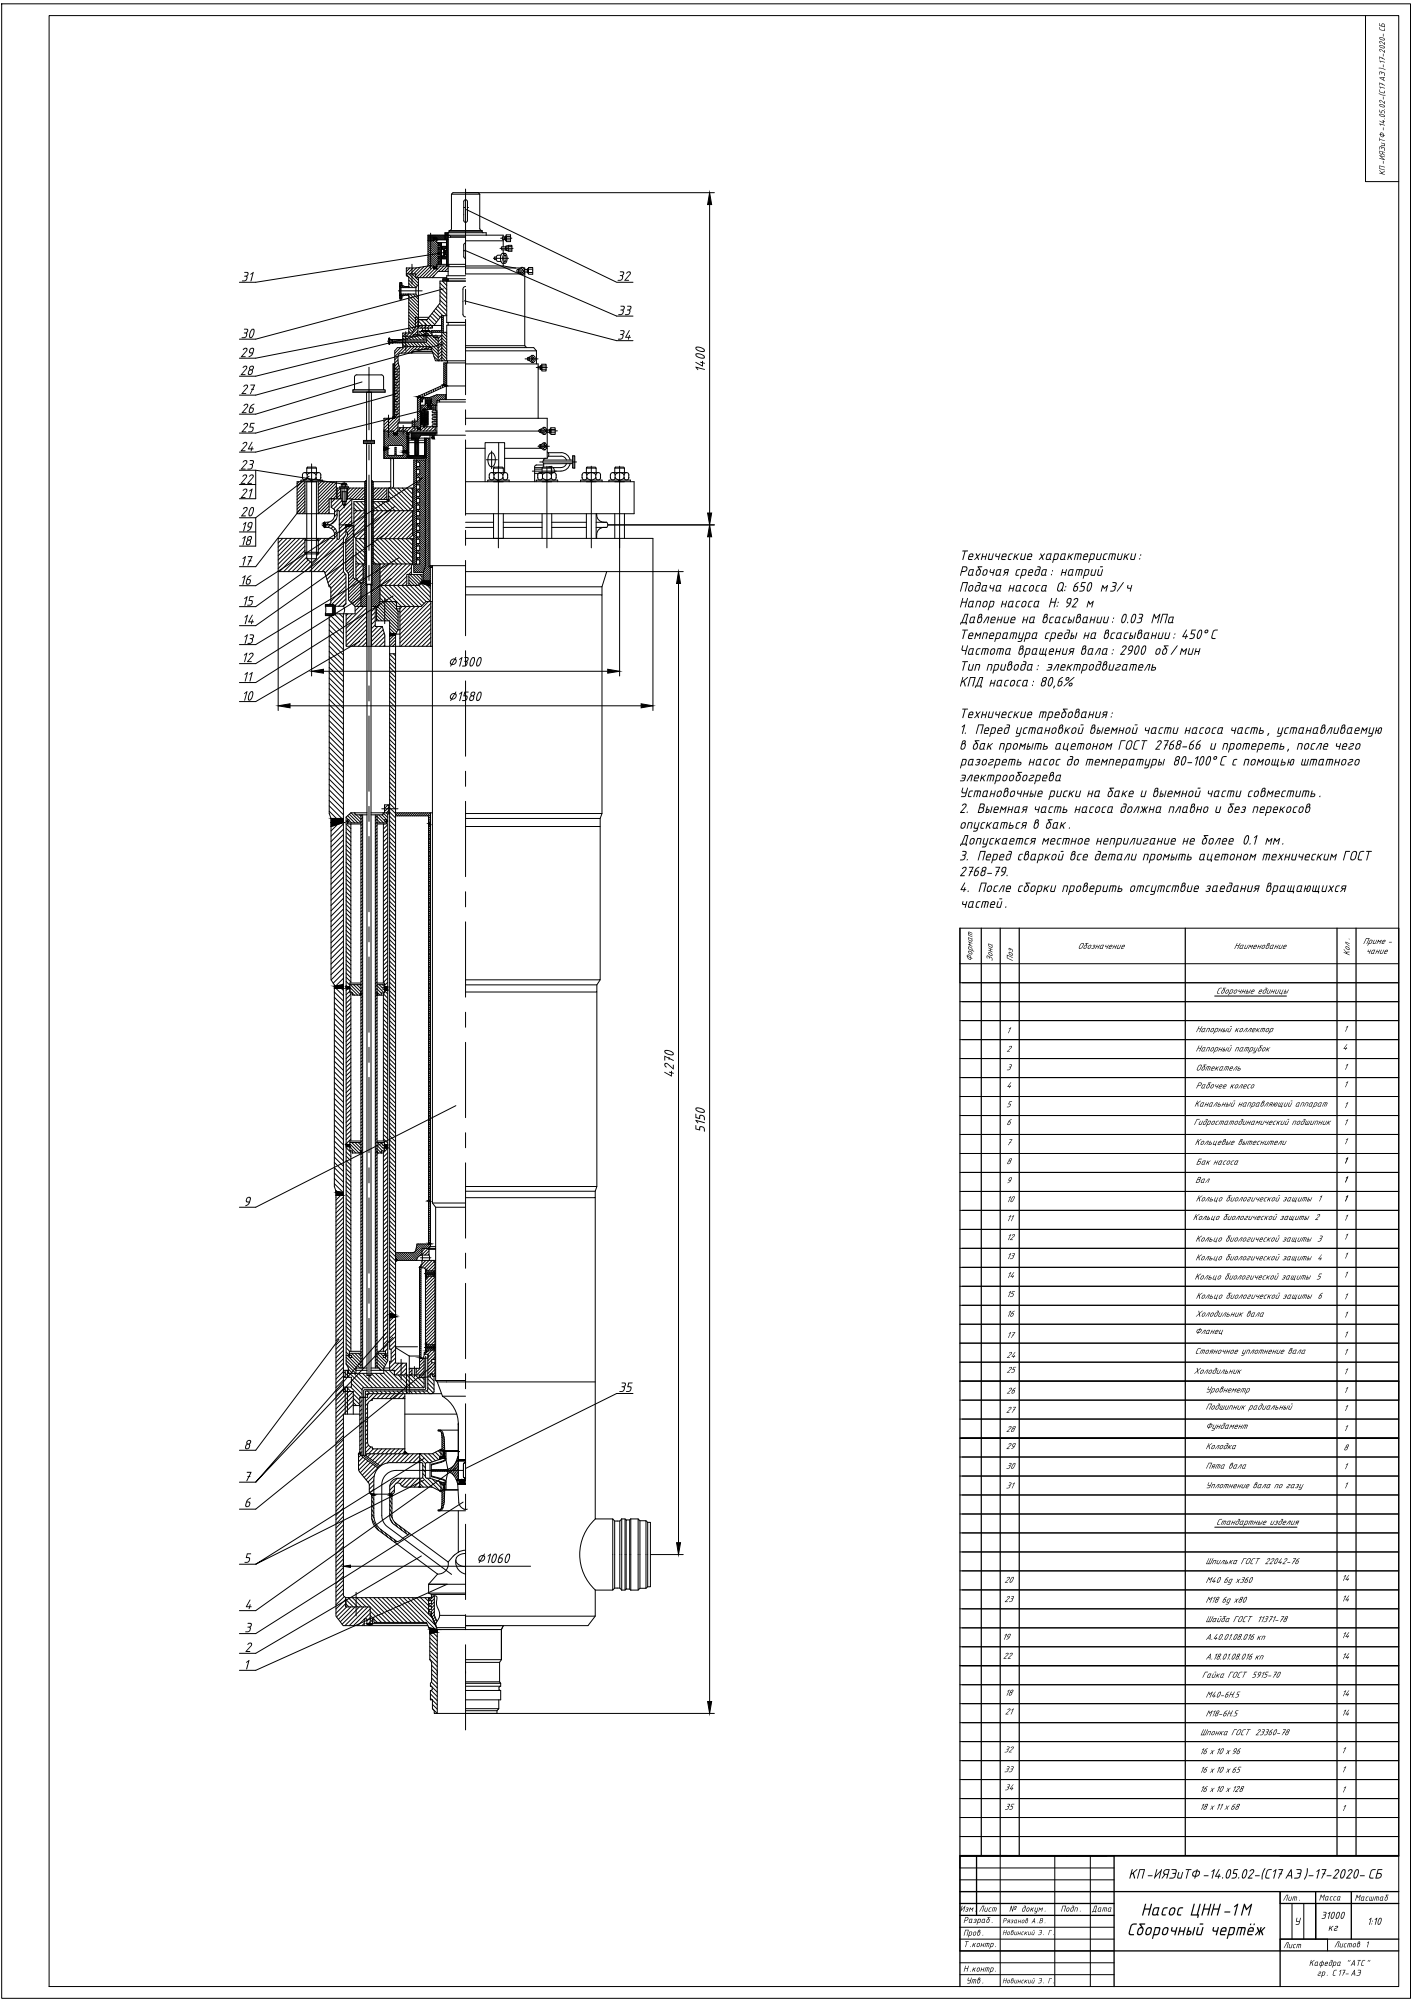
[picture p119: page 1]
