itstajiri/main/3kurs/Nasosi/Одобрено/НА.pdf

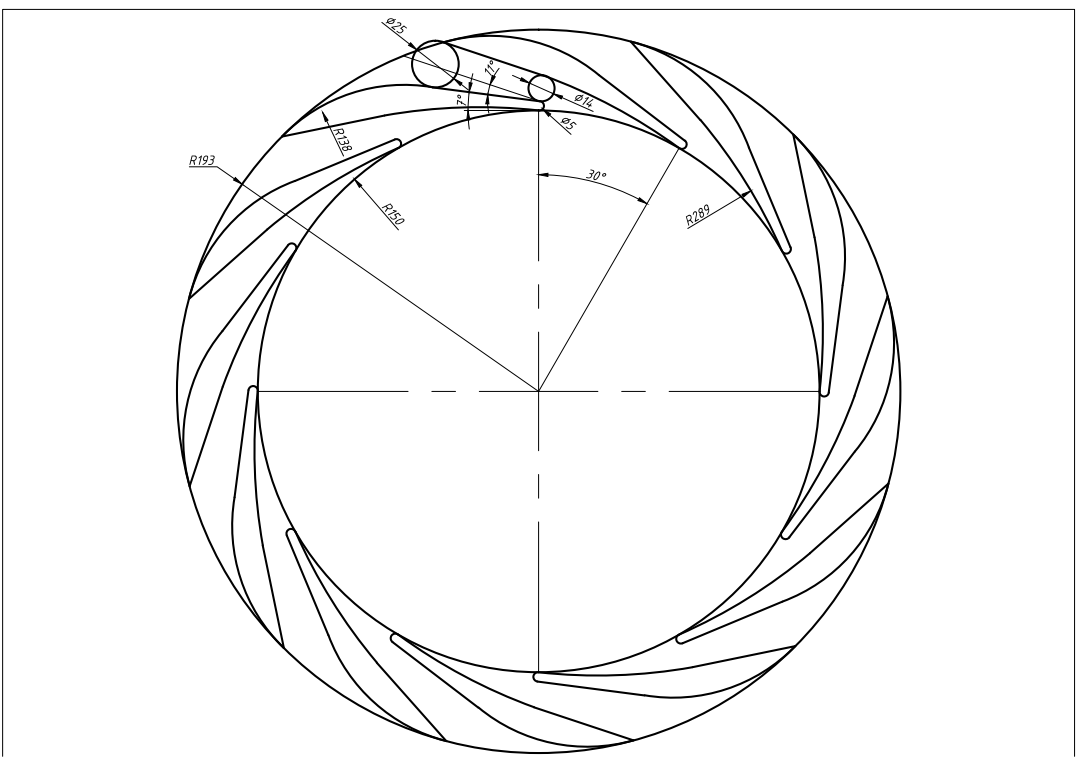
[picture p120: page 1]
