itstajiri/main/3kurs/Nasosi/Одобрено/Схема НА.pdf

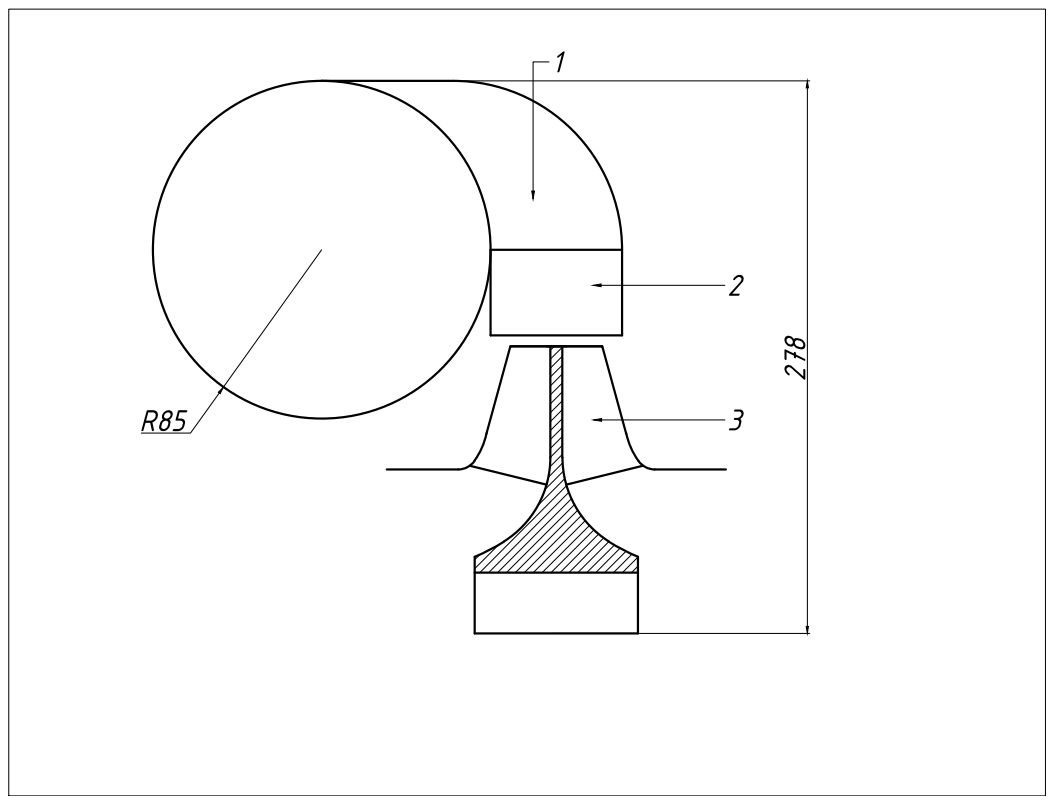
[picture p121: page 1]
