itstajiri/main/3kurs/Nasosi/Доки/NSS_FULL — копия (2).pdf

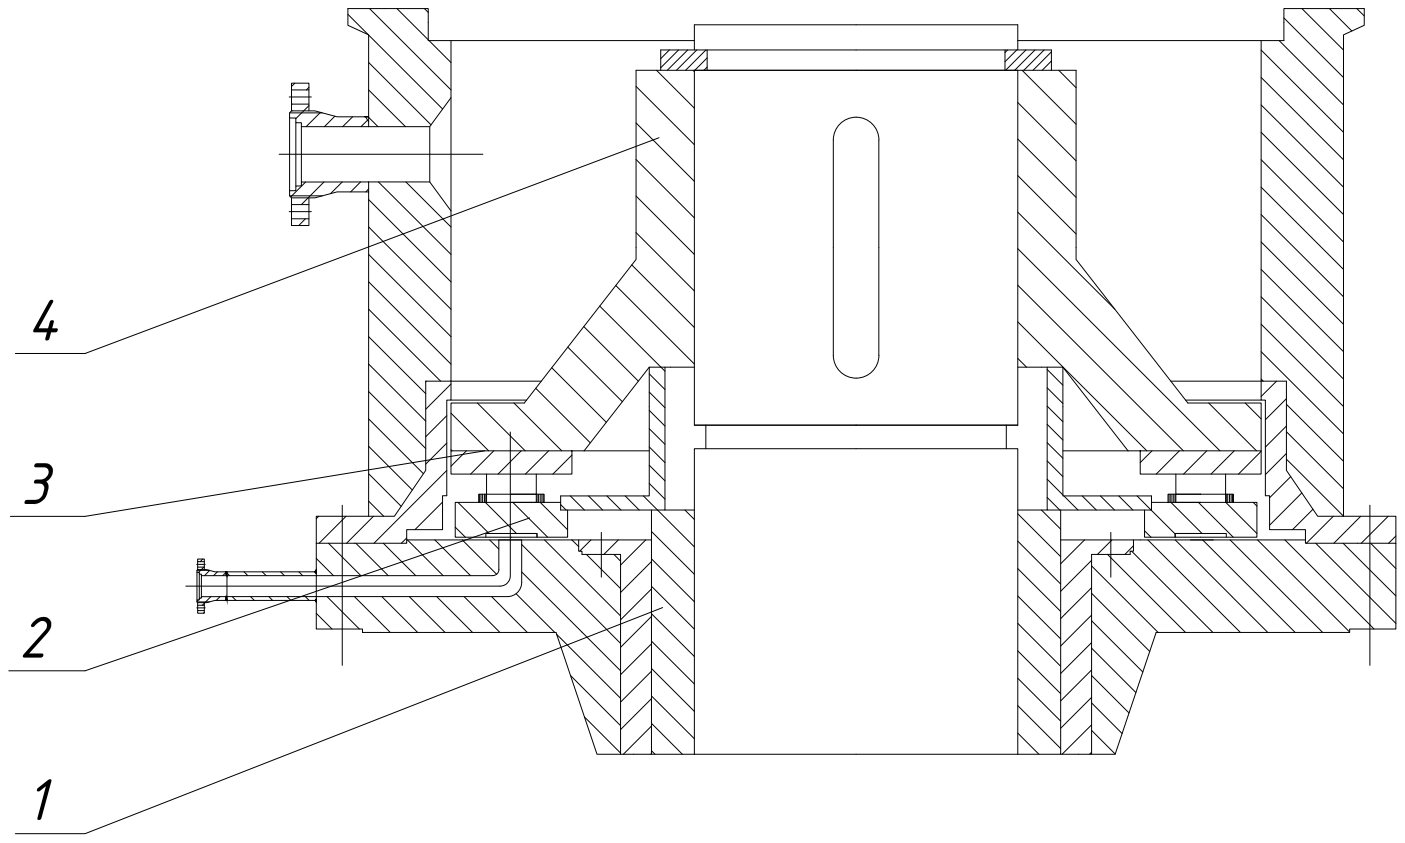
[picture p122: page 1]
