itstajiri/main/3kurs/Nasosi/Доки/NSS_FULL — копия (3).pdf

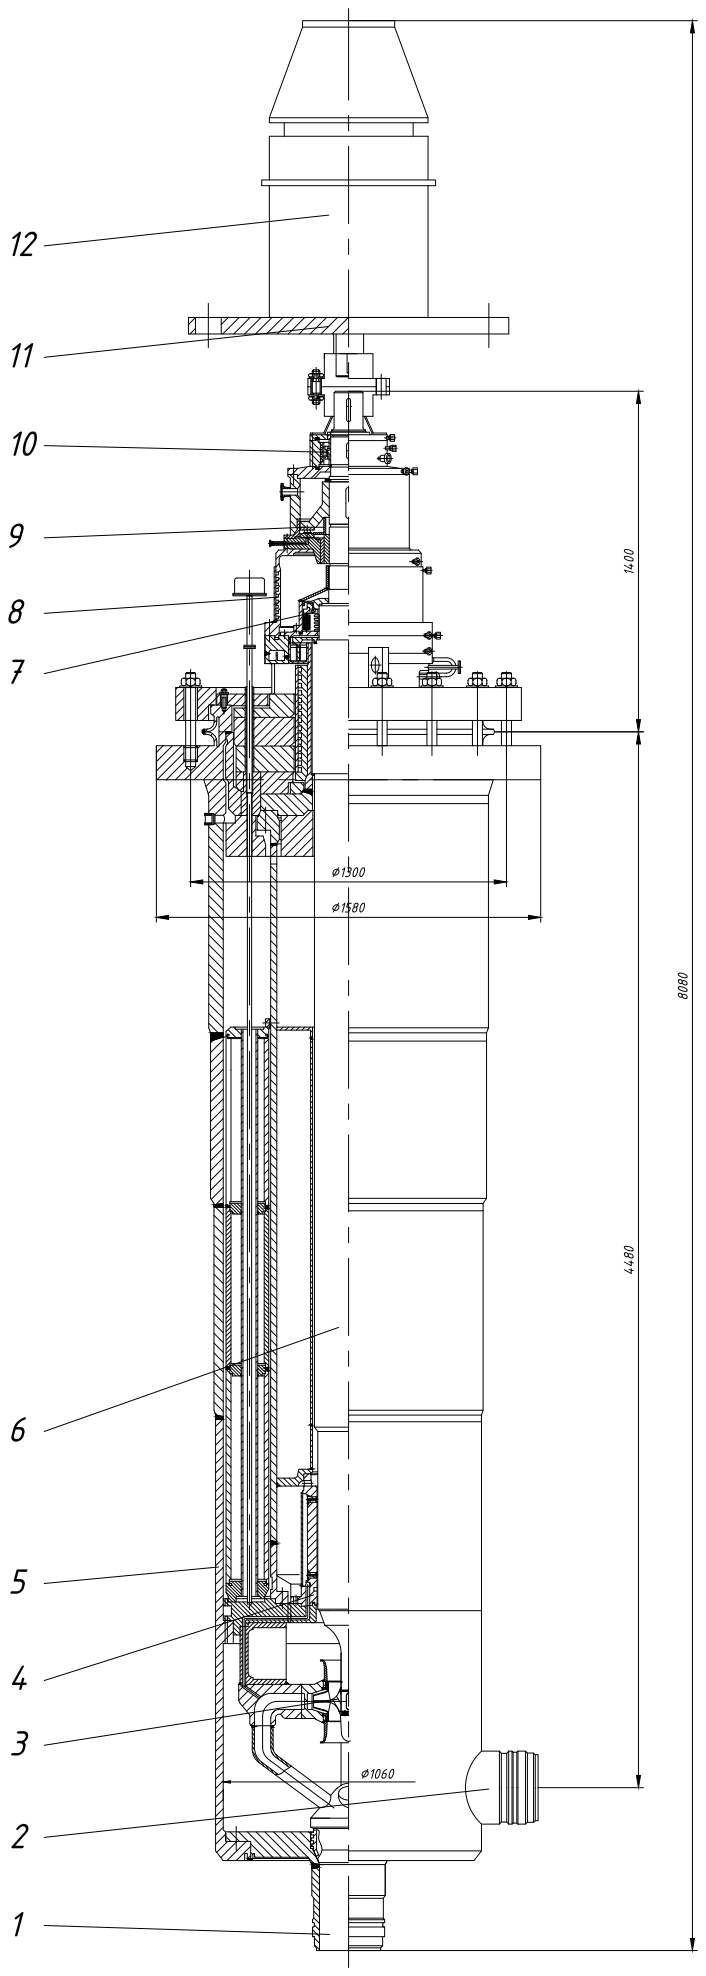
[picture p123: page 1]
