itstajiri/main/3kurs/Nasosi/Доки/NSS_FULL1.pdf

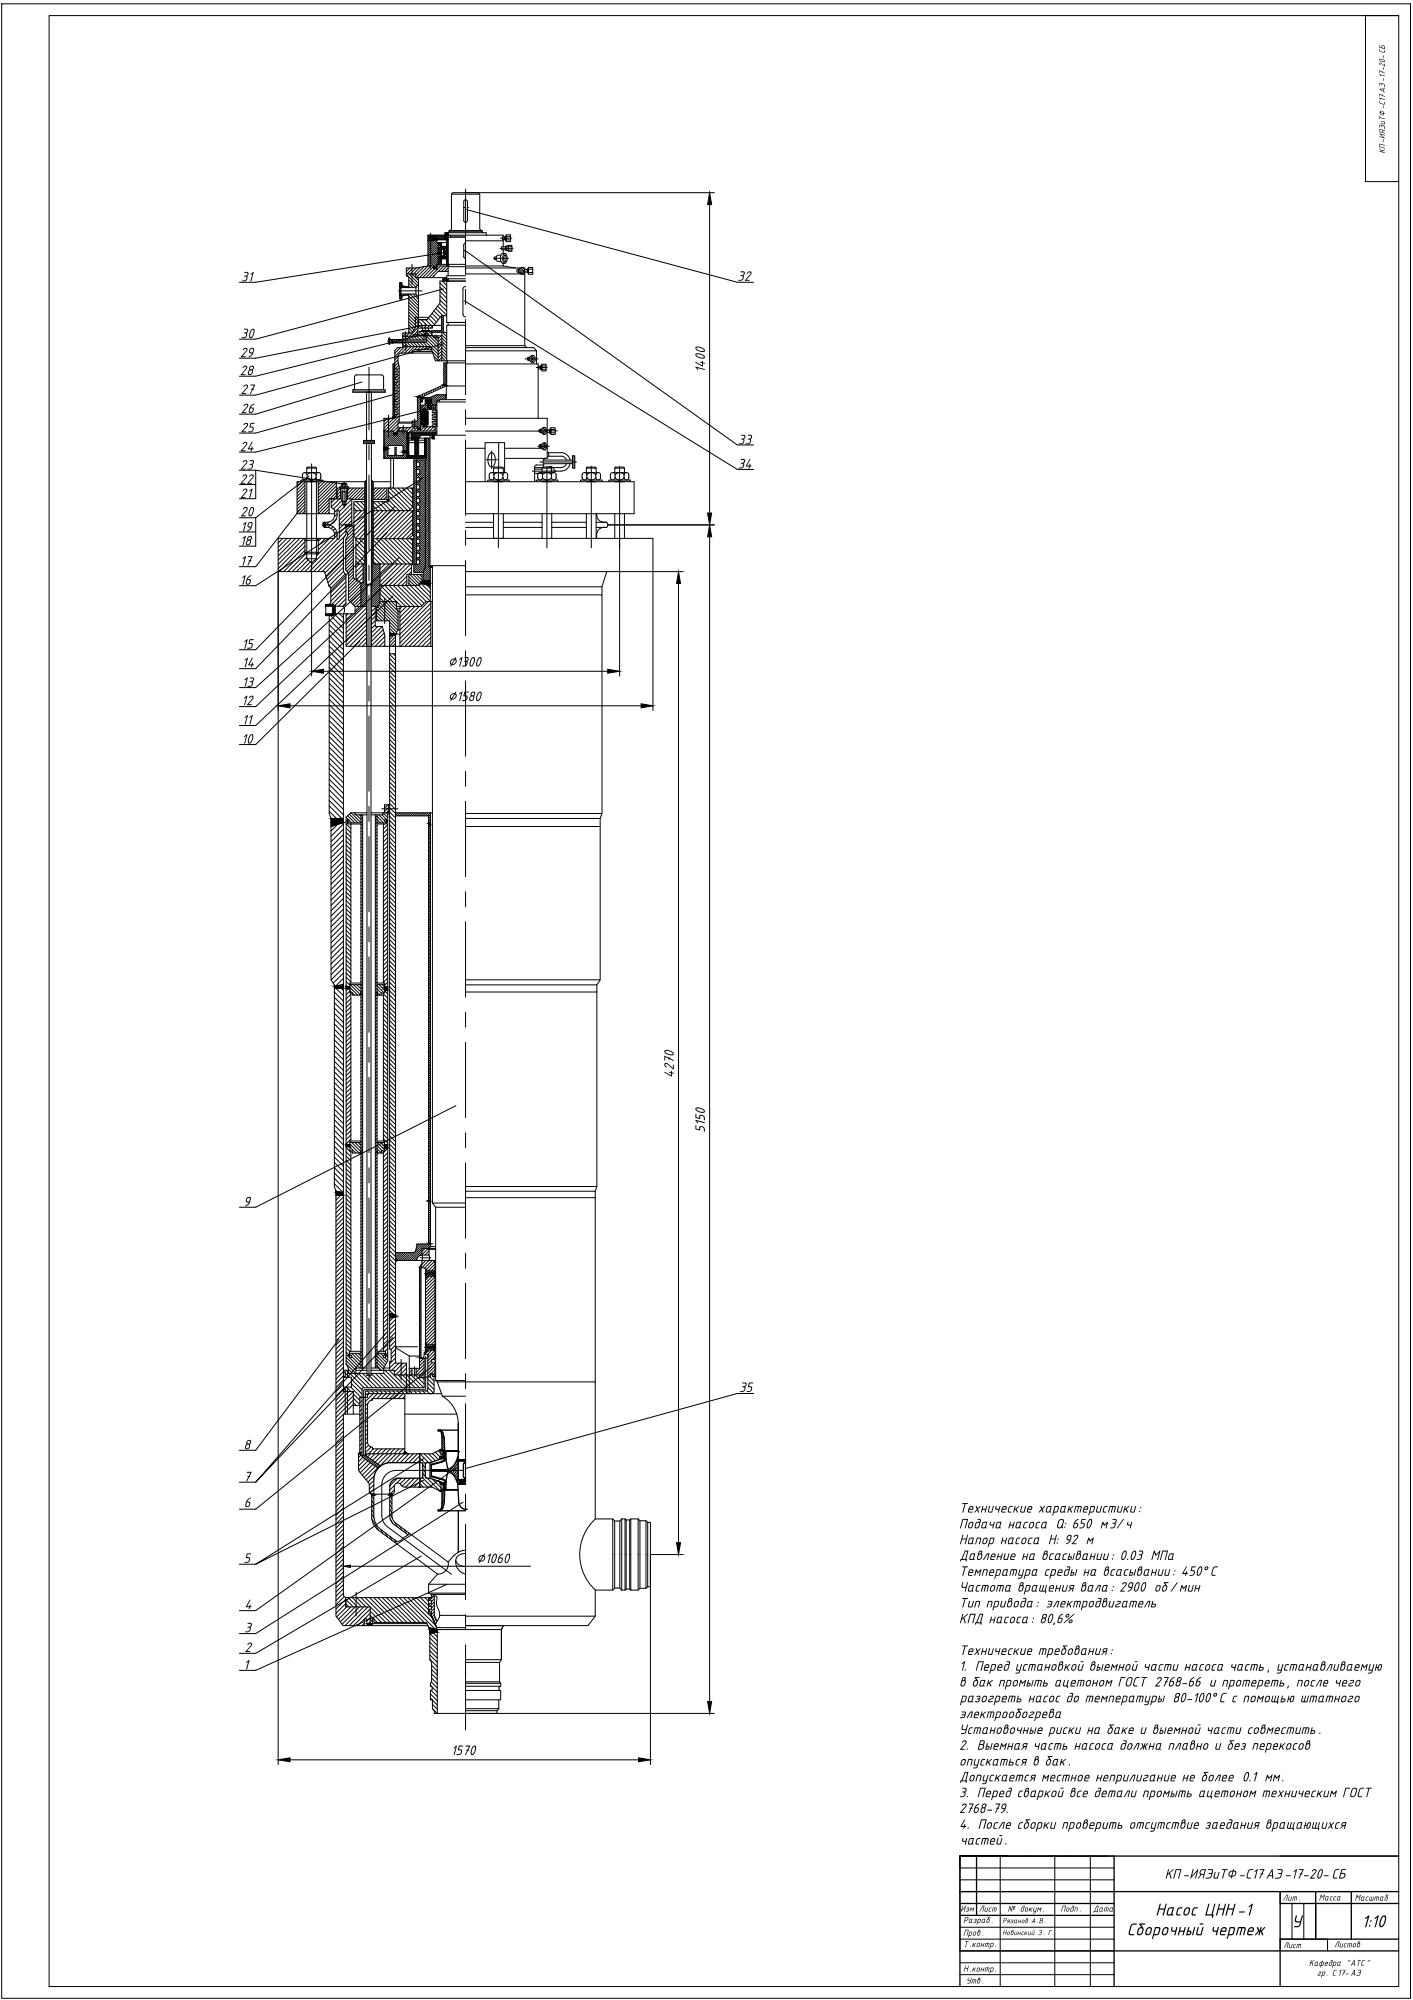
[picture p124: page 1]
