itstajiri/main/3kurs/Nasosi/Доки/NSS_VMN — копия.pdf

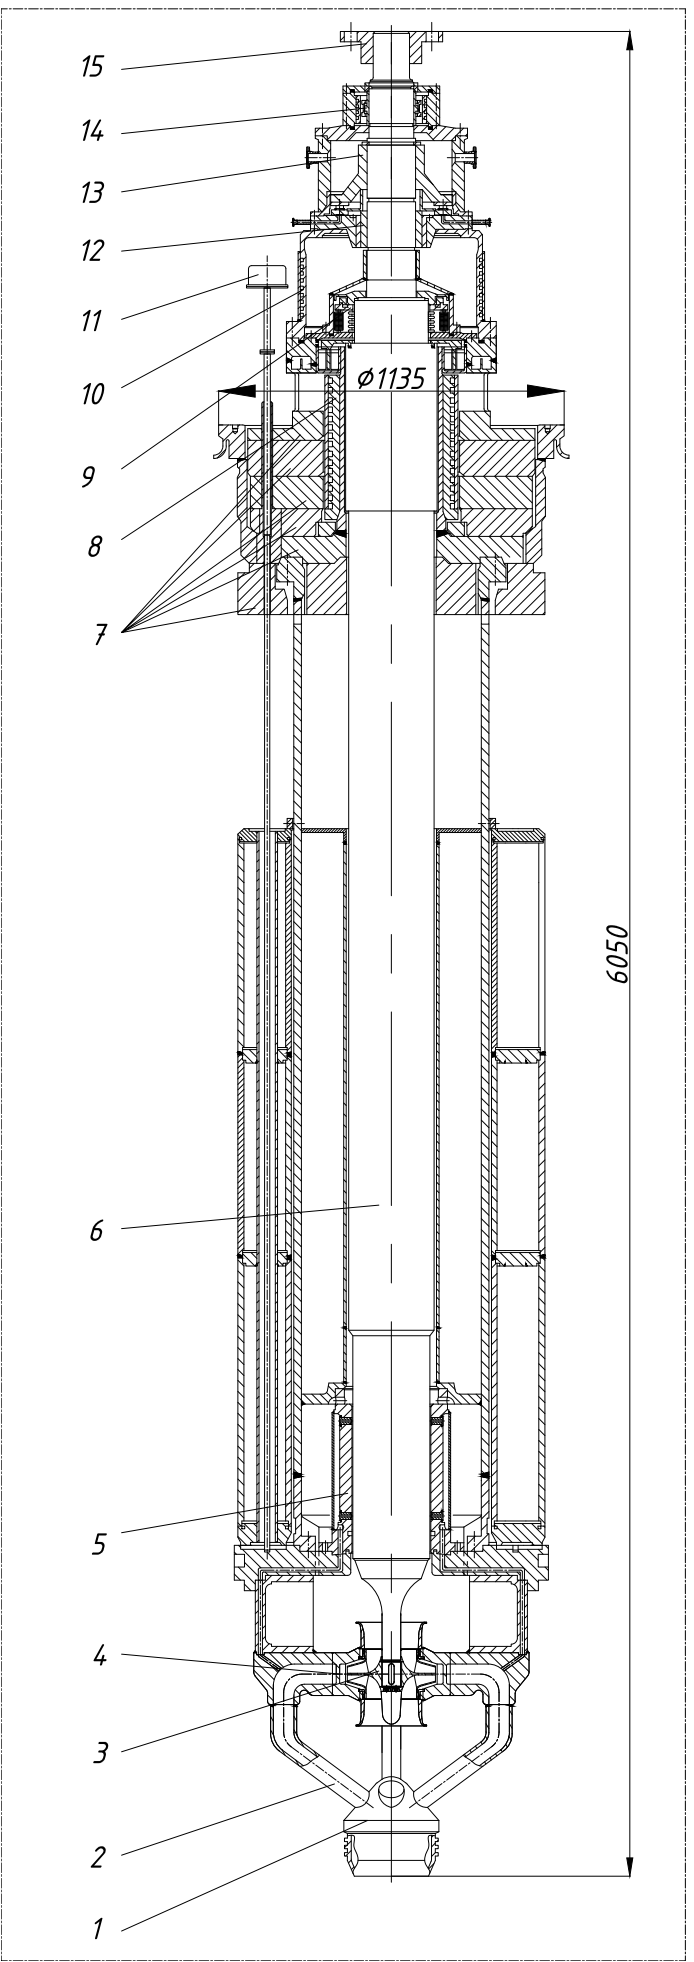
[picture p125: page 1]
