itstajiri/main/3kurs/Nasosi/Доки/Мередианное — копия — копия — копия — копия — копия — копия.pdf

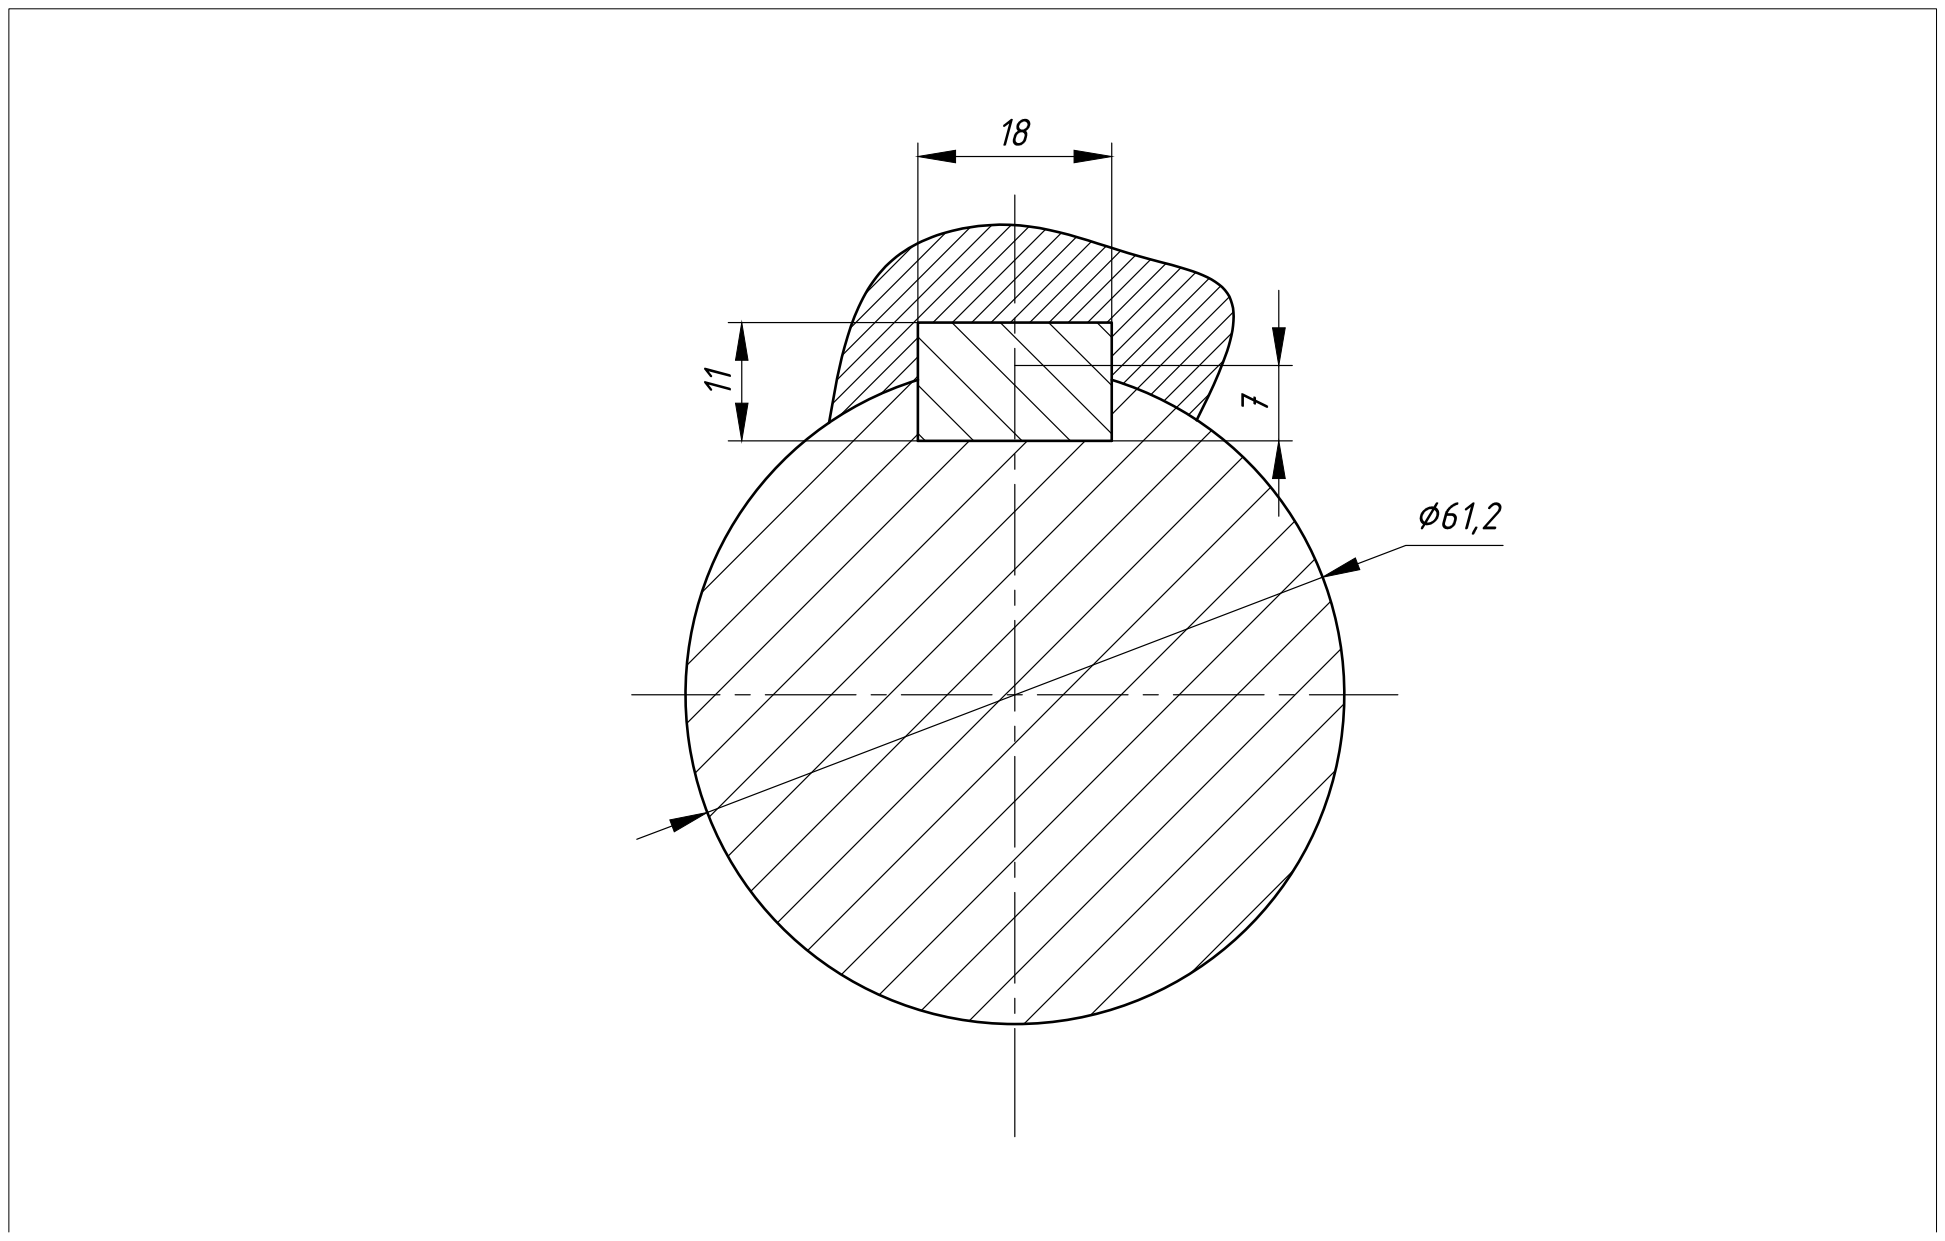
[picture p126: page 1]
