itstajiri/main/3kurs/Nasosi/Доки/Приложение 1. Чертёж рабочего колеса.pdf

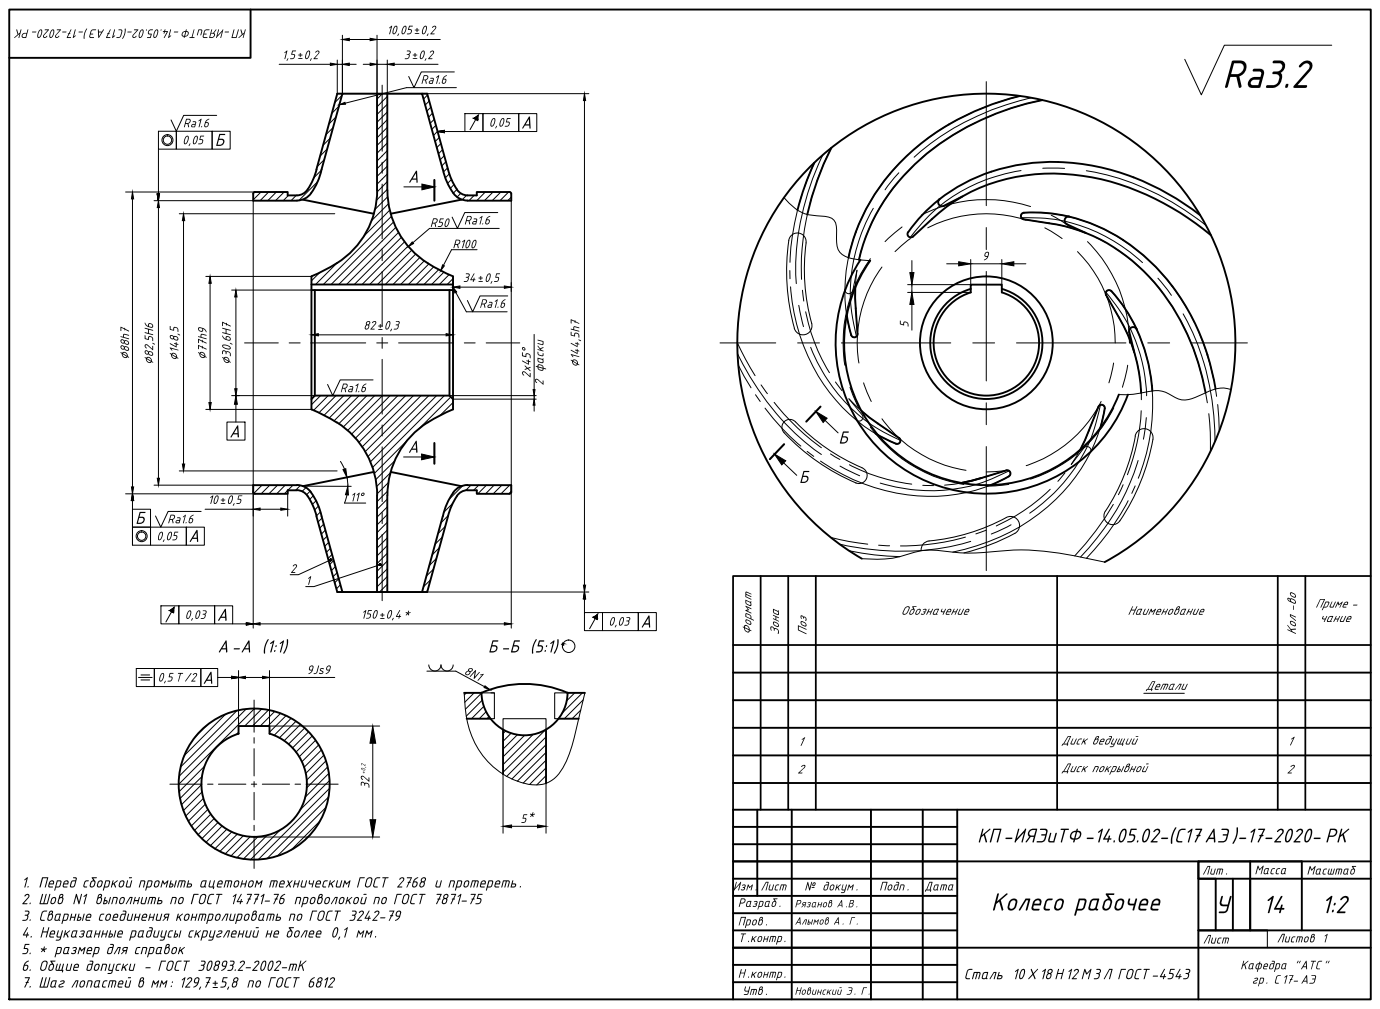
[picture p127: page 1]
