itstajiri/main/3kurs/Nasosi/Доки/Приложение 2. Общий вид насосного агрегата.pdf

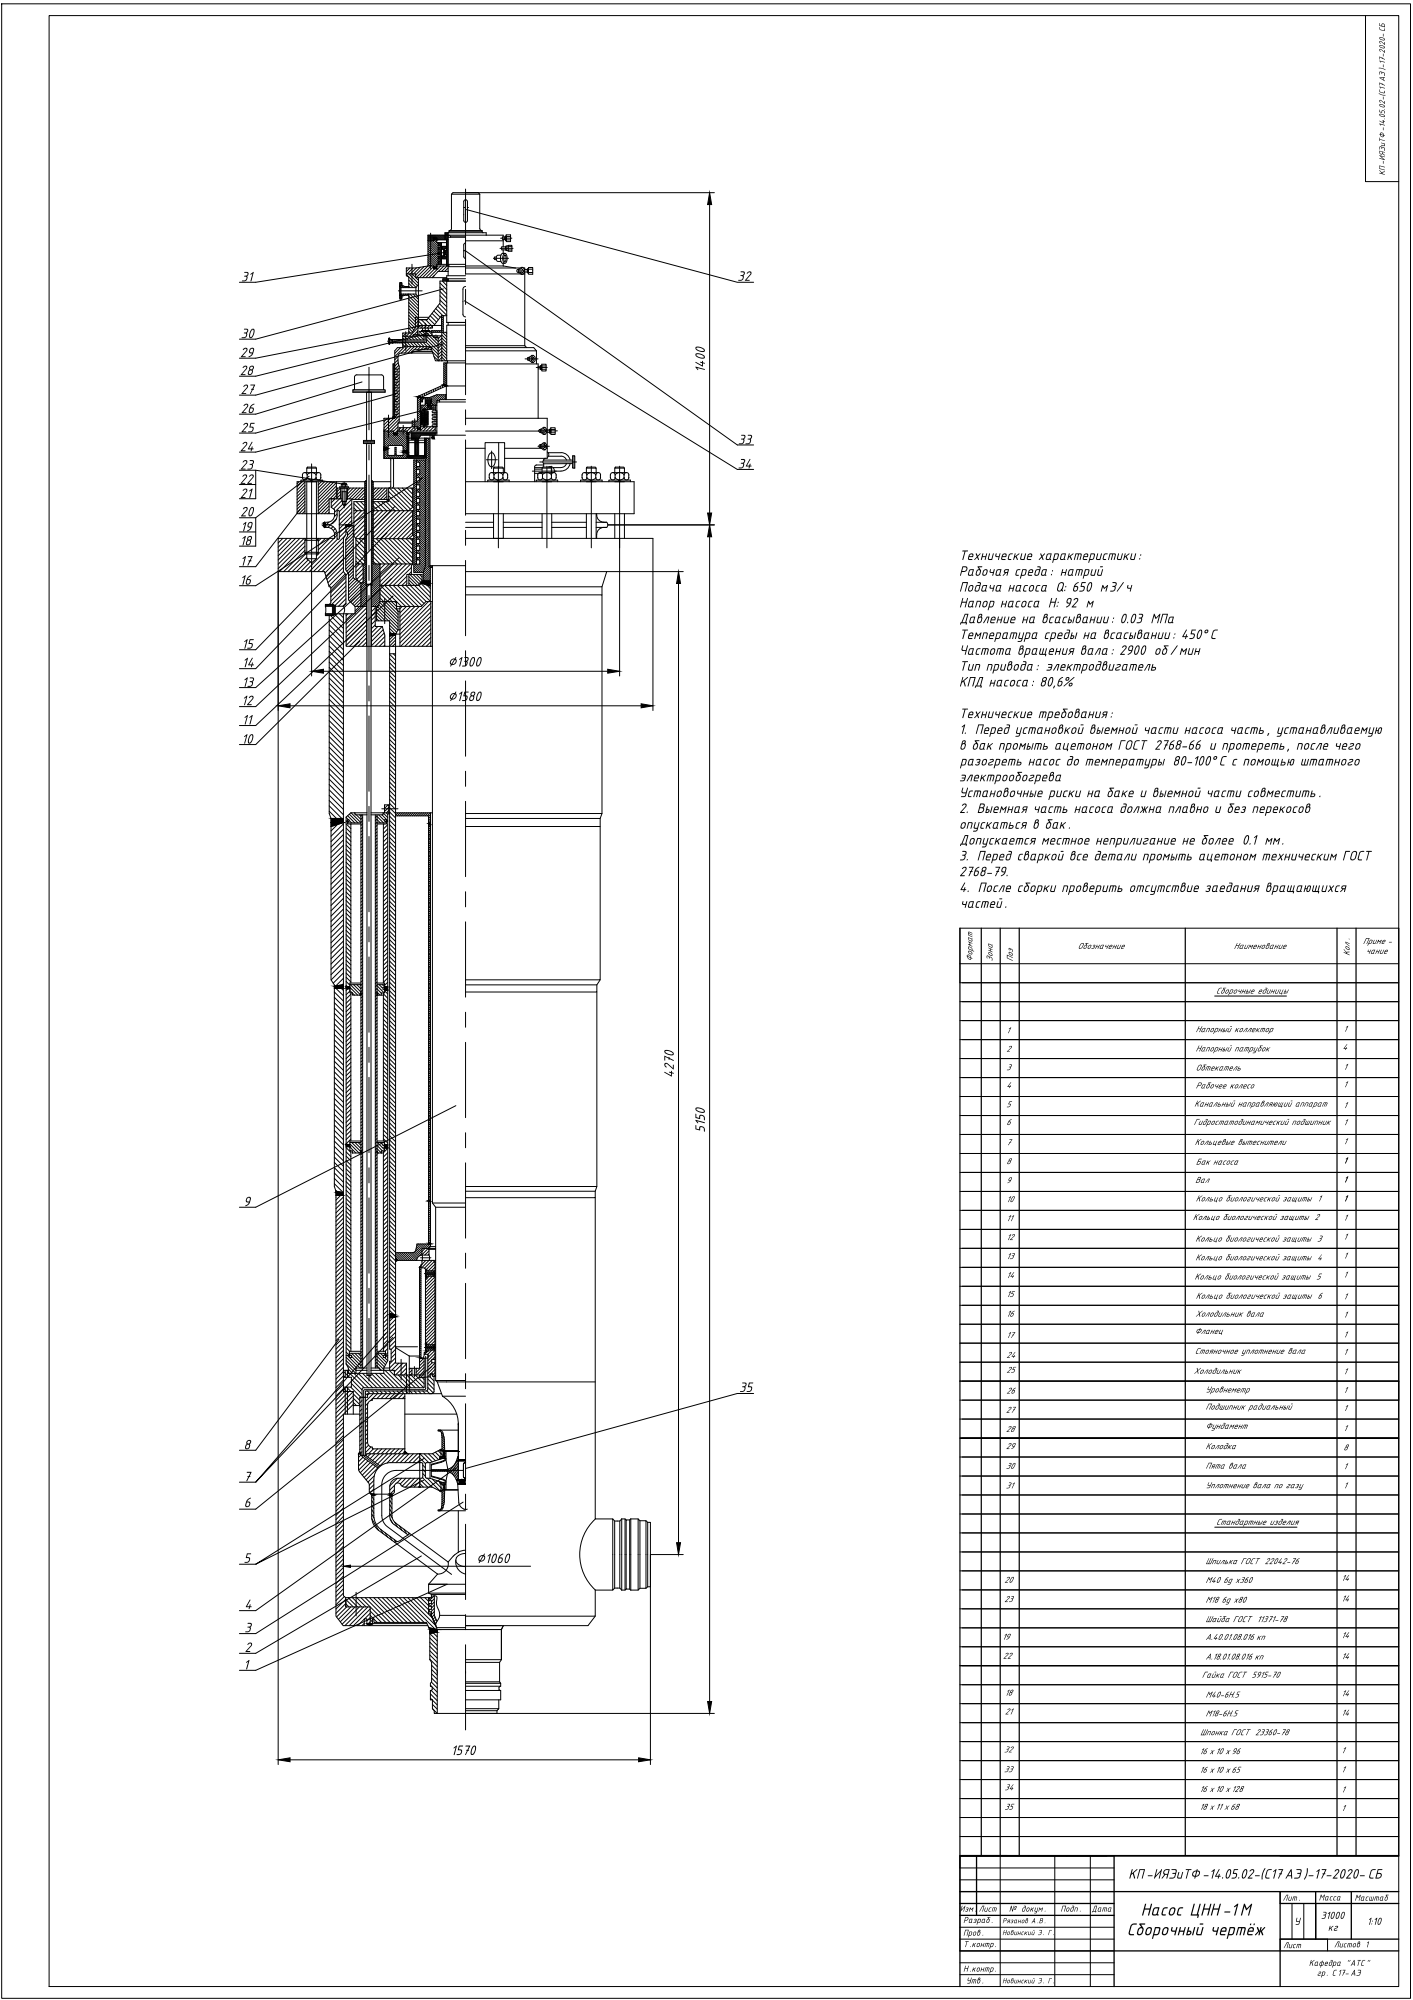
[picture p128: page 1]
