itstajiri/main/3kurs/Nasosi/Доки/Рабочее колесо 2.pdf

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

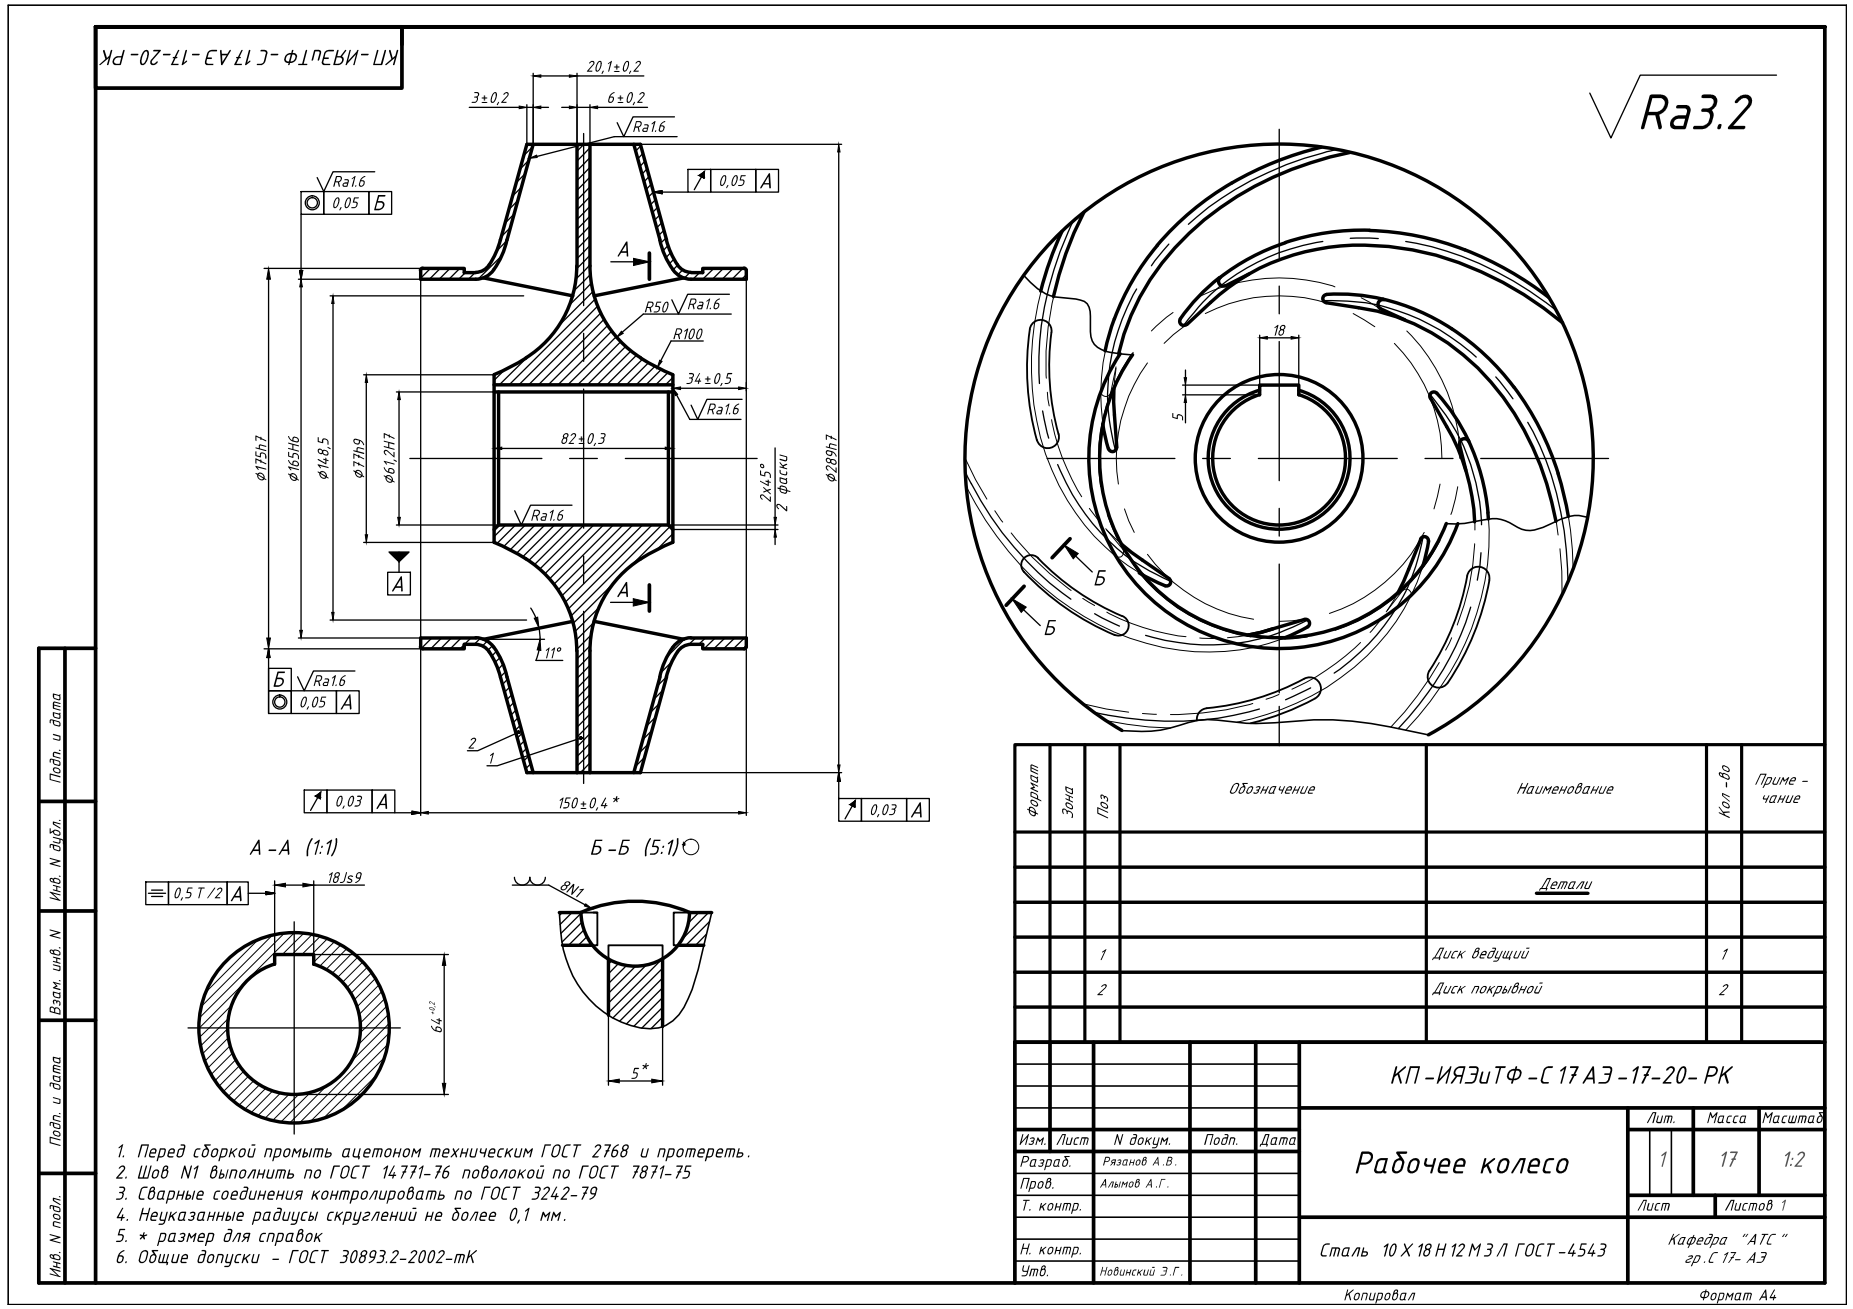
[picture p129: page 1]
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
