itstajiri/main/3kurs/Nasosi/Доки/Рабочее колесо 3.pdf

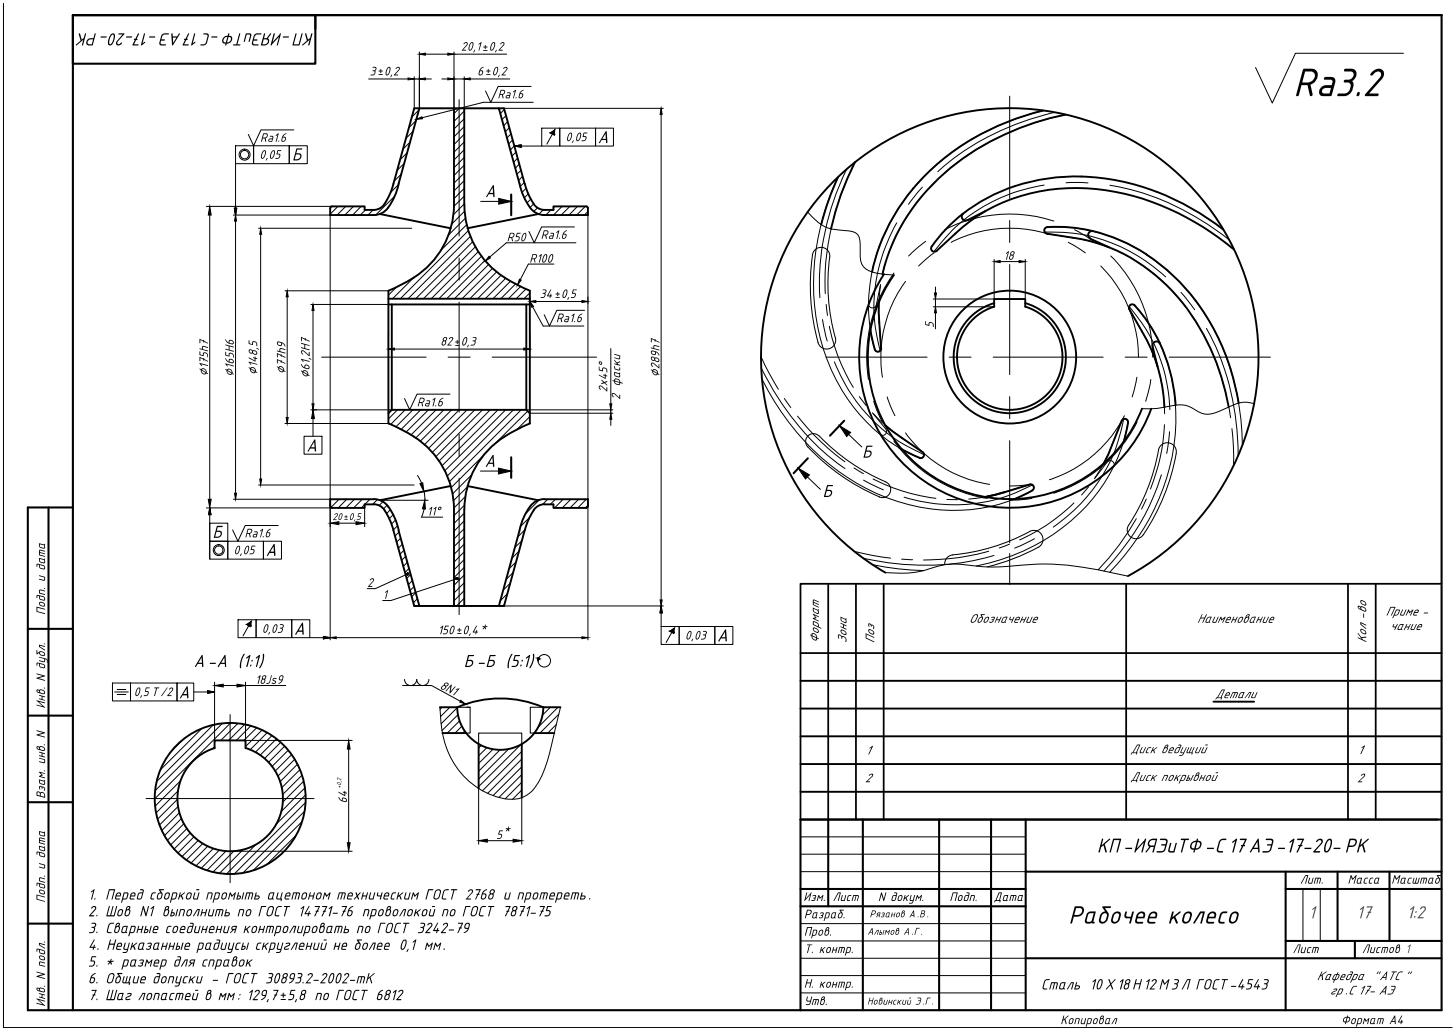
[picture p130: page 1]
