itstajiri/main/3kurs/Nasosi/Доки/Сборочный.pdf

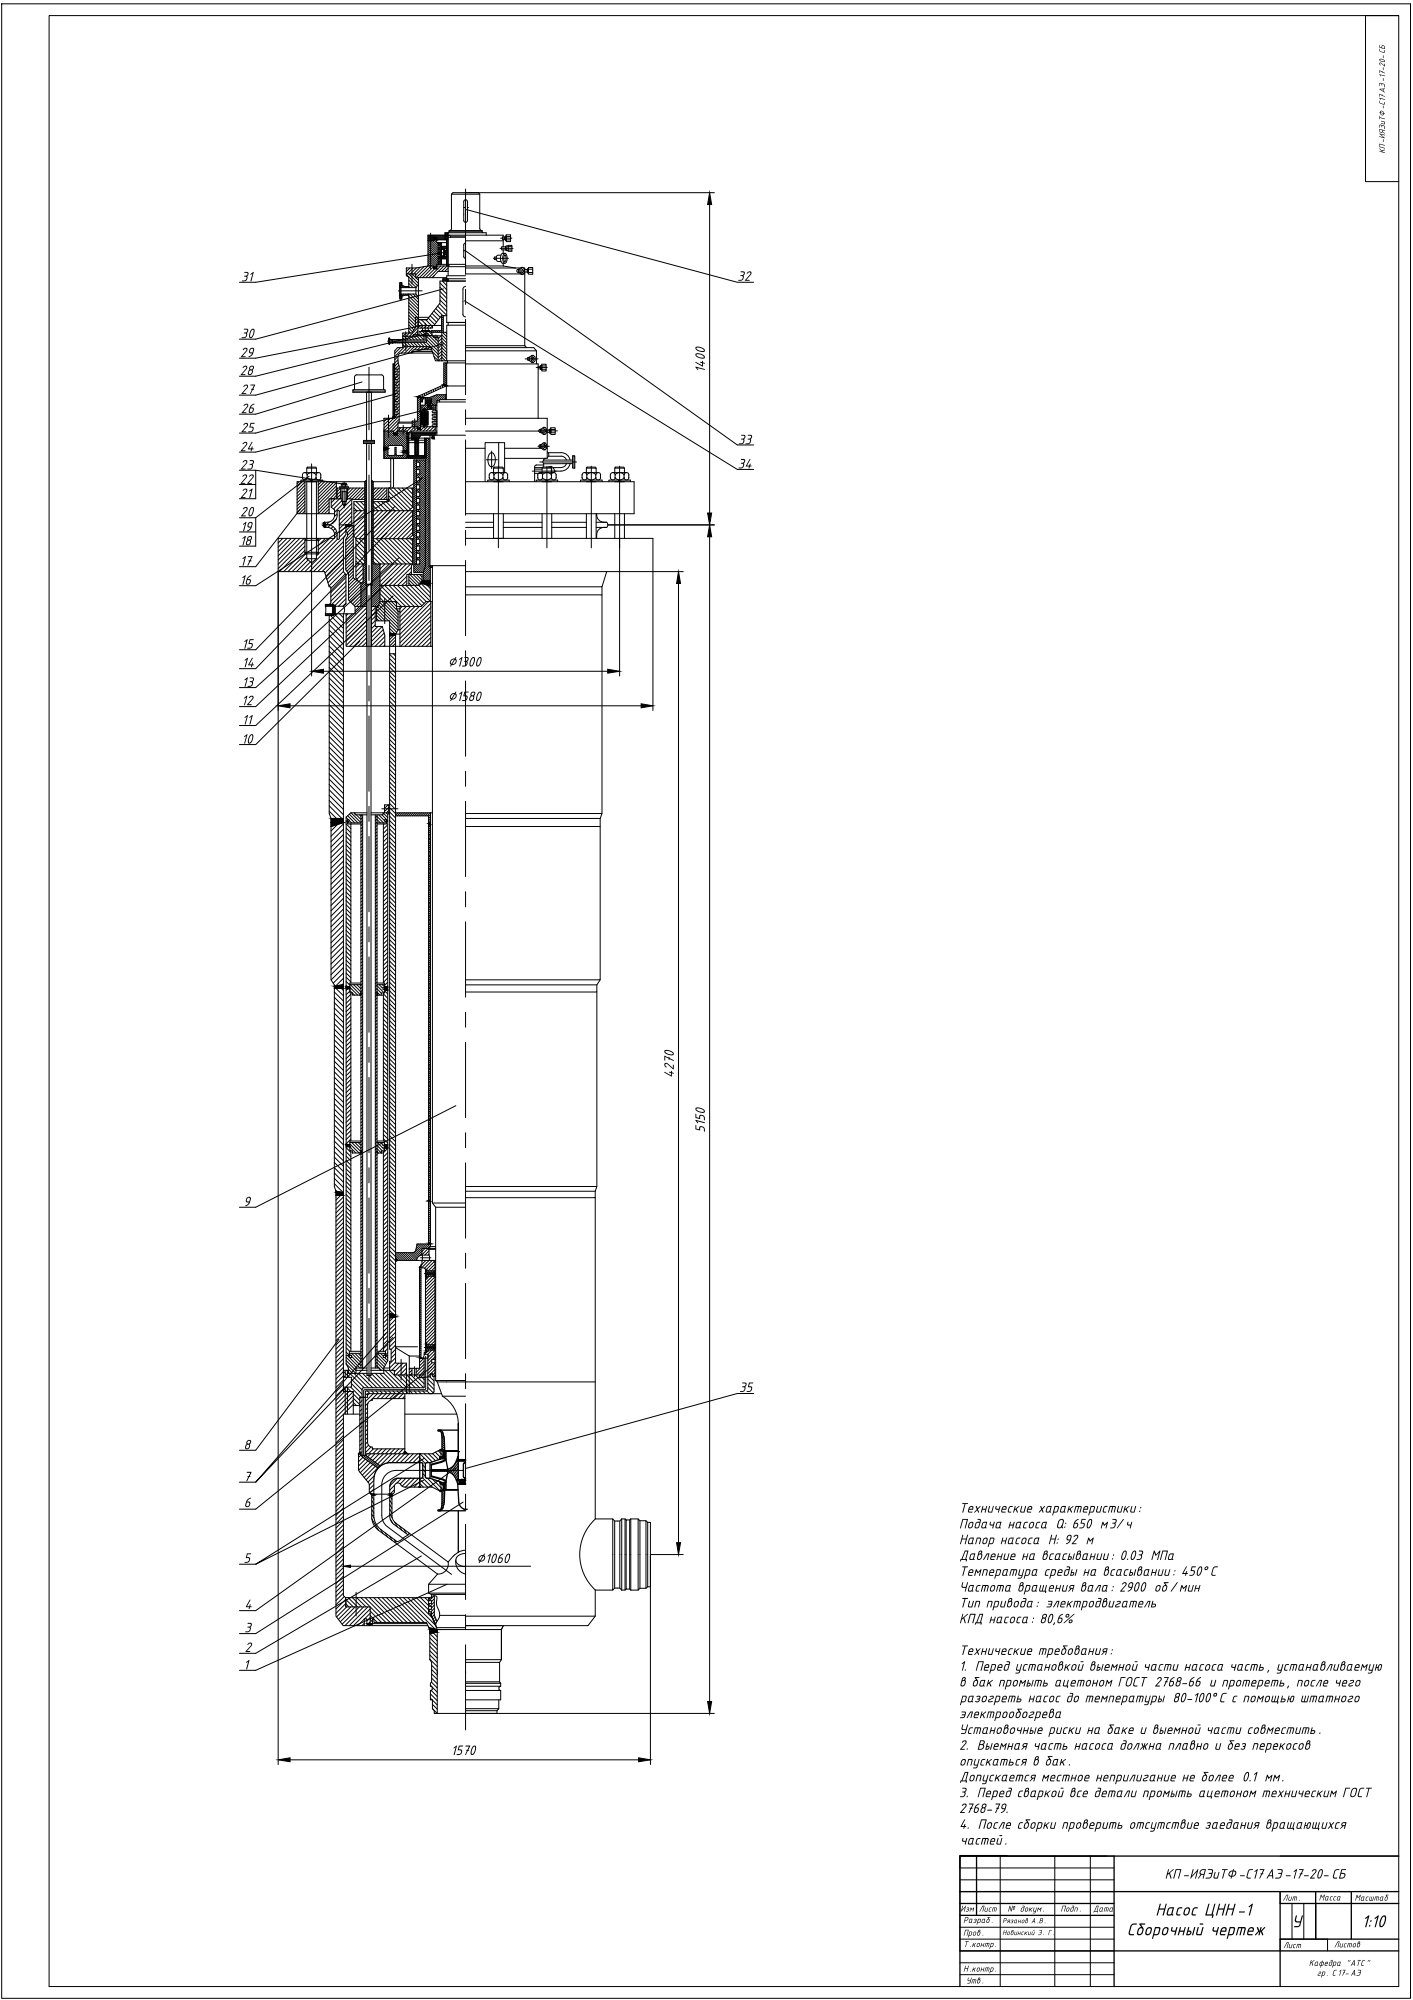
[picture p131: page 1]
