itstajiri/main/3kurs/Nasosi/Доки/Спецификация.pdf

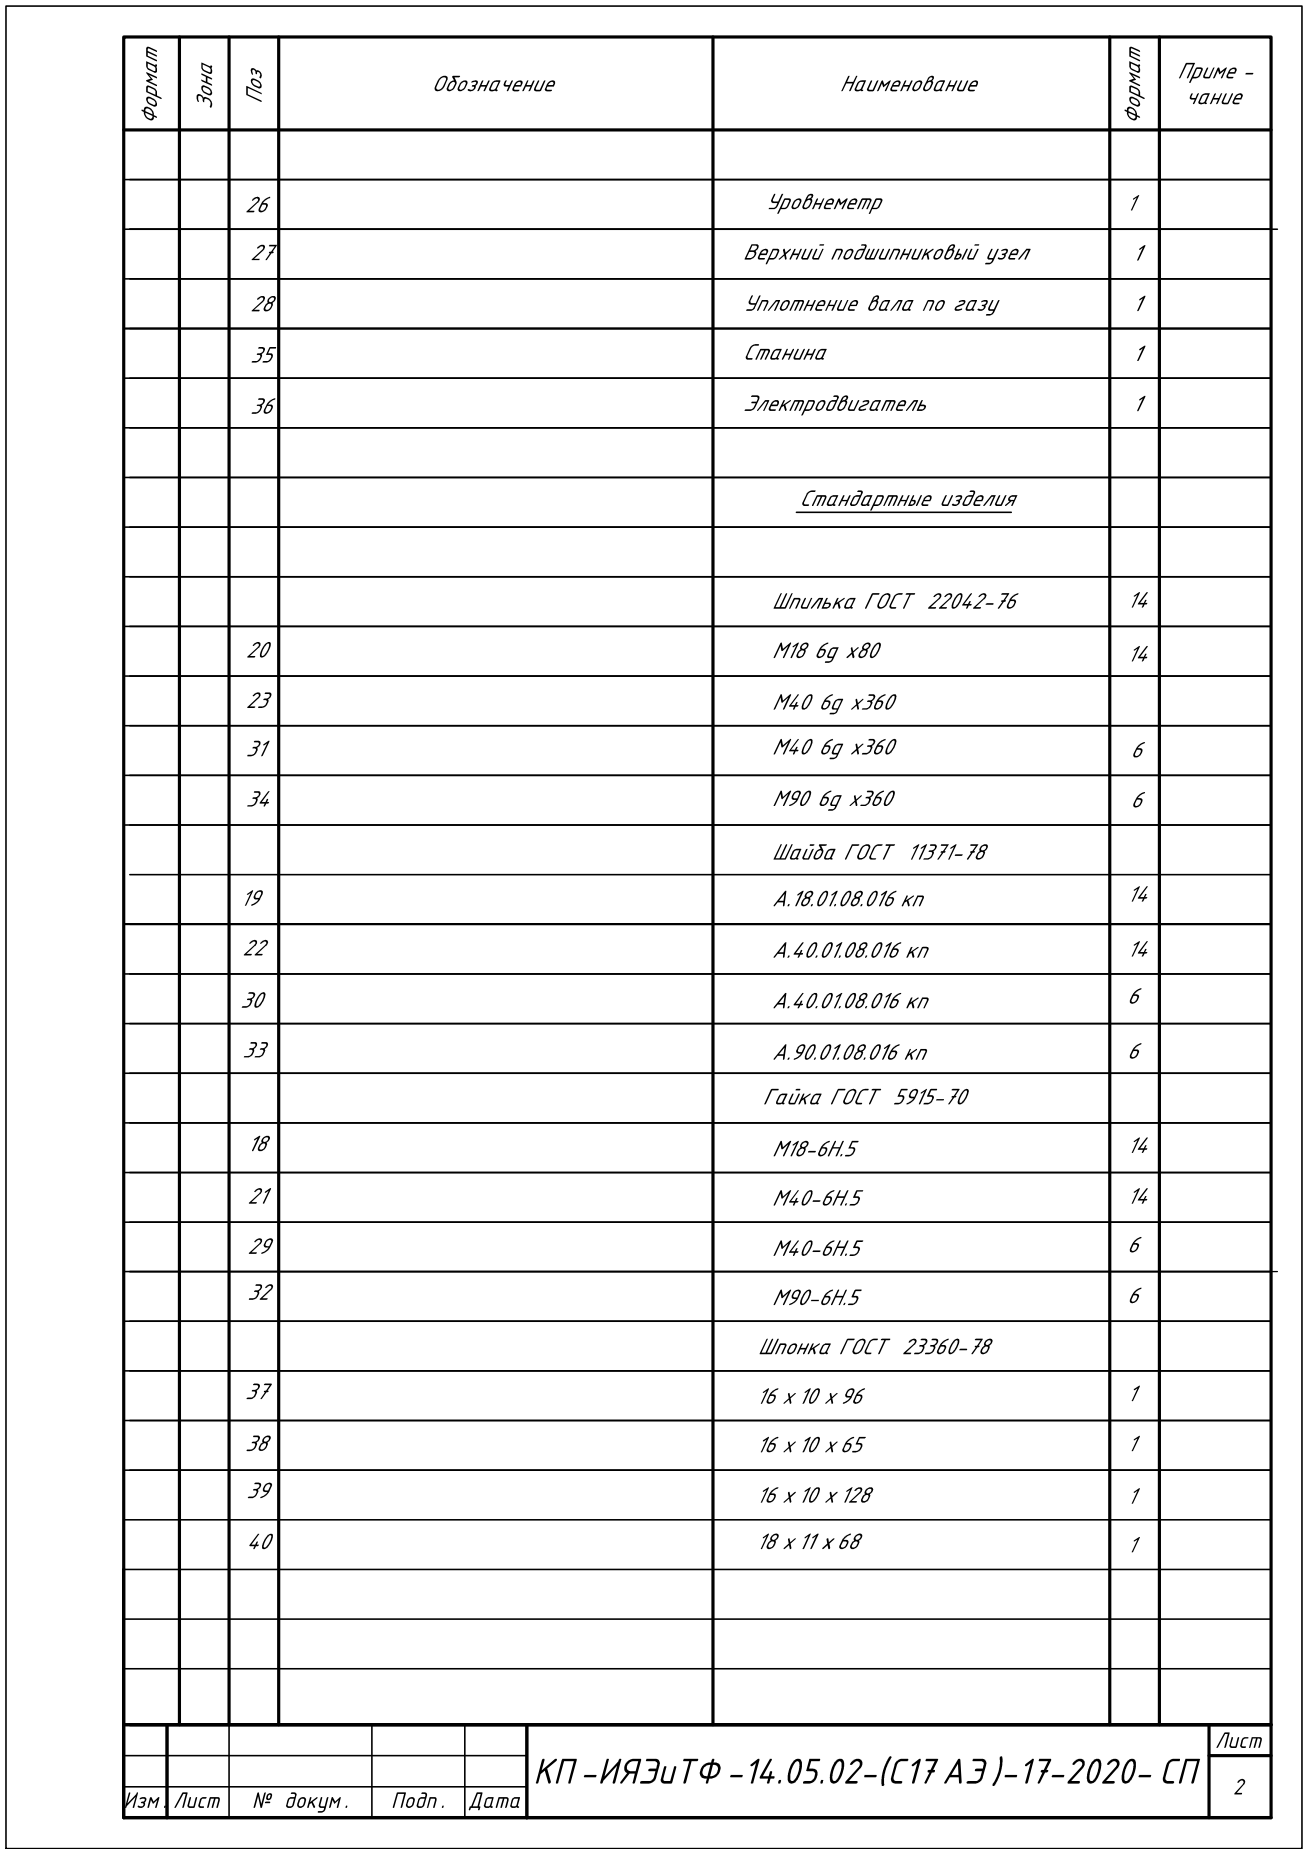
[picture p132: page 2]
