itstajiri/main/3kurs/Nasosi/Доки/тр1.pdf

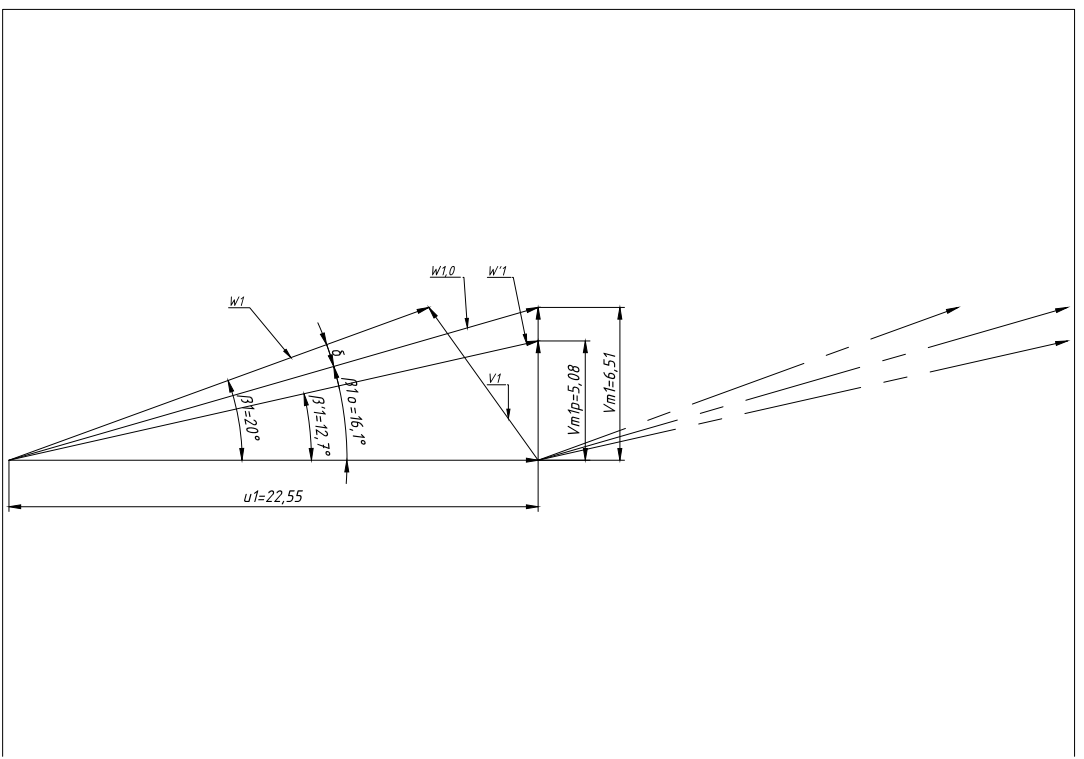
[picture p133: page 1]
