itstajiri/main/3kurs/Nasosi/Доки/тр2.pdf

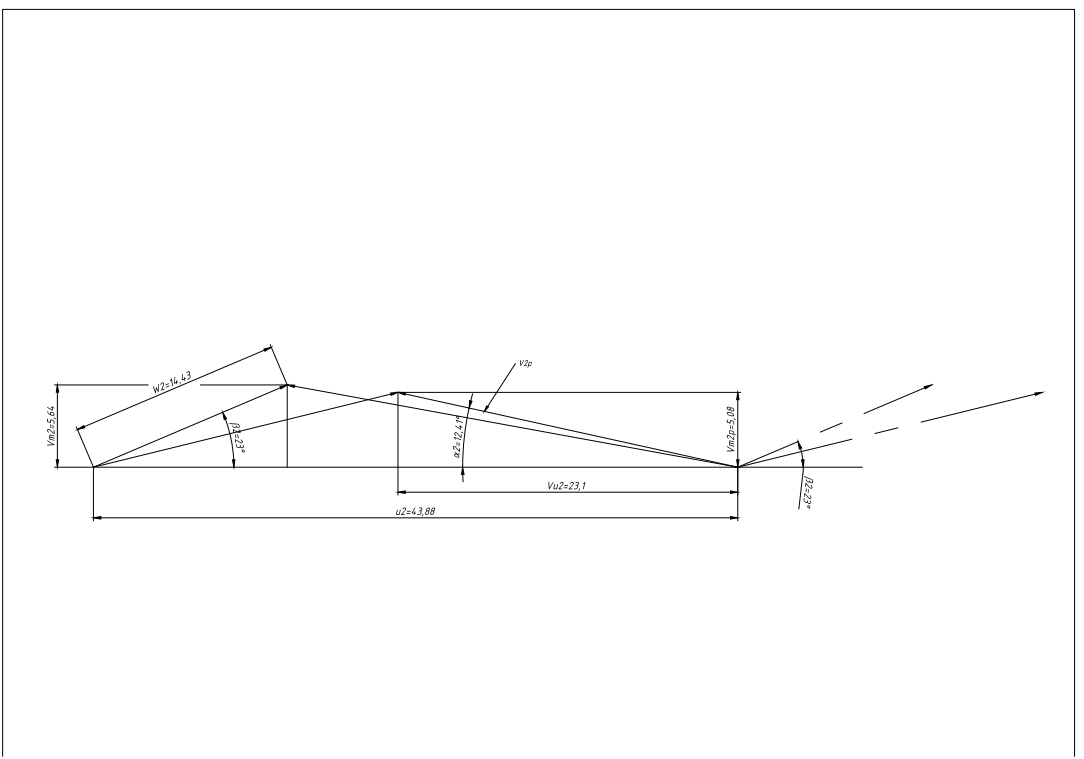
[picture p134: page 1]
