itstajiri/main/3kurs/Nasosi/Одобрено/MERID_F1.pdf

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

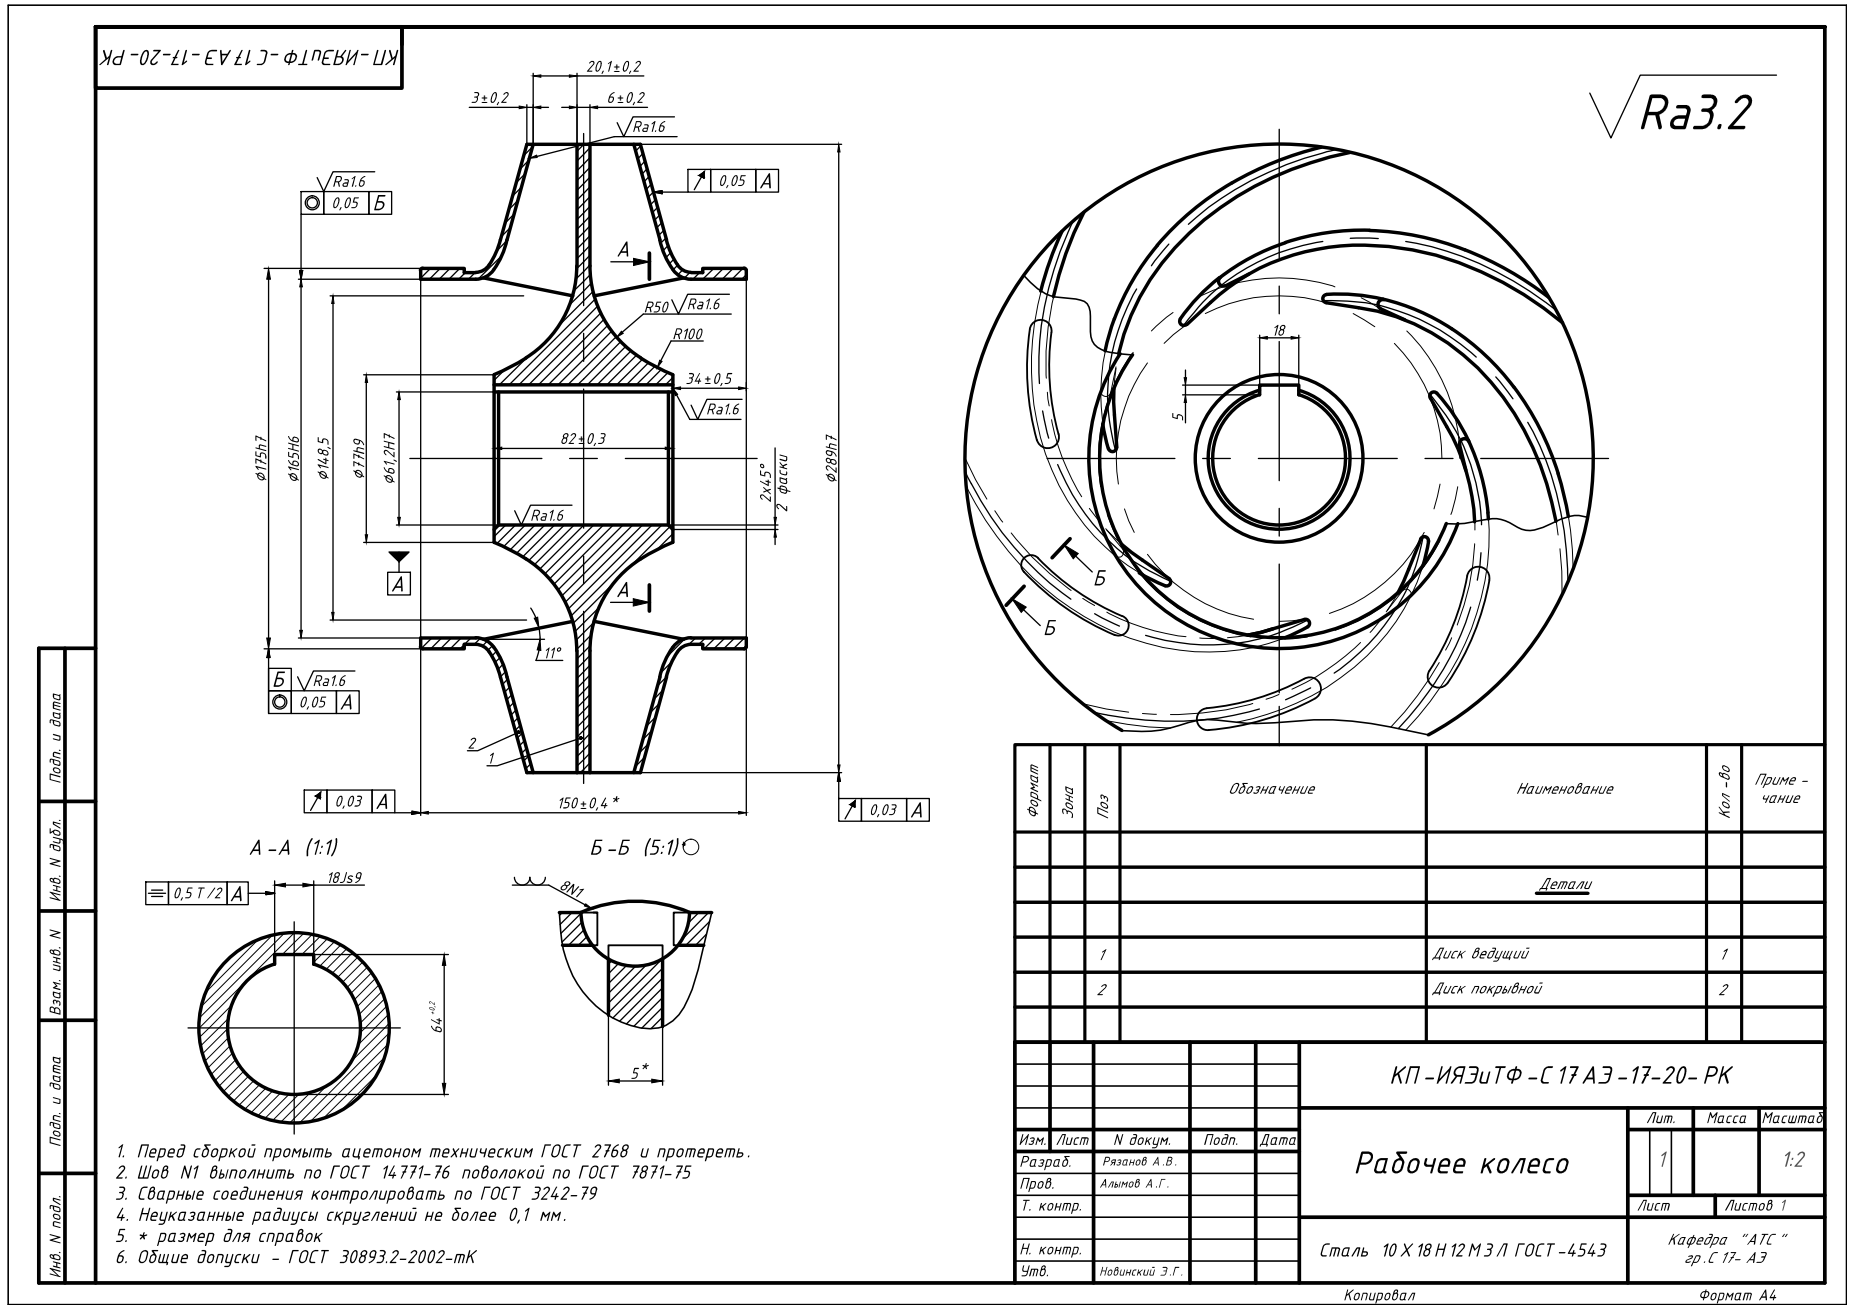
[picture p135: page 1]
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
